2AMLogic/gf180-pll/sim/README.md

# sim/ — evidence record format

**Looking for a headline number rather than the format spec?** See
[`CHARACTERIZATION.md`](CHARACTERIZATION.md) — one aggregated table pulling
each campaign's current result, record citation, and pass/fail-vs-spec
status into a single document (#147).

This directory holds simulation testbenches and their results. Results are
**append-only evidence**: once a record is written, it is never edited or
deleted. A re-run — even one that corrects a mistake — mints a new record
with a new ID; a correction references the record it supersedes rather than
overwriting it in place.

This convention exists because CLAUDE.md commits this repo to two rules that
need a concrete schema to be enforceable:

- **Verification is the product.** No claim without a testbench. Every
  recorded result carries the full PVT corner matrix (−40/27/125 °C, 3.3 V
  ±10 %, process corners) unless the record explicitly states why a subset
  was used.
- **`sim/` is append-only evidence.** Re-runs get new records; records are
  never edited or deleted.

## Provenance of this convention

This format is **copied and adapted** from the sister repo
`2AMLogic/gf180-bandgap`, per CLAUDE.md's harness-bootstrap rule (copy the
sister-repo pattern rather than reinventing). Source:

- **Source file**: `sim/README.md` on `2AMLogic/gf180-bandgap` `main`
- **Source commit**: `67525f67d8152fff7575c7d13ea185db869e2870`
  ("docs: define sim/ evidence record format and append-only convention",
  bandgap #22) — the last commit to touch that file, and the convention
  ratified on bandgap `main` as of 2026-07-30 (bandgap `main` at
  `8fb0ea627569079147c91bff8e3aee658c976e54`).

**Reconciliation note.** Bandgap's harness PR (bandgap #23, branch
`feature/issue-2`) proposes a *machine-readable* evidence scheme —
`sim/results/<tb>/<UTC>-<sha>[-dirty].{json,csv}` — which does not match the
Markdown-record convention ratified in bandgap #22. That PR was **still open
and unmerged** when this file was written, so the ratified Markdown
convention above is what is copied here. If bandgap later supersedes its
convention, this repo follows **via its own `spec/` decision record** — #6 has
since landed `spec/decision-records/TEMPLATE.md`, so the mechanism now exists:
copy it to `spec/decision-records/DR-NNN-<slug>.md`. Never a silent fork. The
two schemes are not actually in conflict for us: a harness (issue #2) may emit
machine-readable `corners/<record-id>/` artifacts *in addition to* the Markdown
summary record, but the Markdown record under `records/` is the citable
evidence object and is mandatory.

Deltas from the bandgap convention are marked **[PLL delta]** below, each
with its justification. Everything unmarked is bandgap's convention verbatim
in substance.

## Directory / naming convention

Each testbench topic gets its own experiment directory:

```
sim/
  <experiment-slug>/                 # e.g. lock-time, devchar-delay
    testbench/                       # testbench netlist(s) / xschem export used
    netlist-snapshots/
      <record-id>.spice              # frozen DUT netlist used for this record
    corners/
      <record-id>/
        <corner-id>.log              # raw ngspice output per PVT point
                                      # e.g. ss_-40c_2.97v.log
        raw_measures.csv             # always written: one row per corner point,
                                      # every tb.measure_names value + verdict
    records/
      <record-id>.md                 # append-only summary record
```

- **`<experiment-slug>`** — short, descriptive, kebab-case name for what is
  being verified. One directory per distinct claim being tested, **not** per
  run. The campaigns already scoped for this block:

  | Slug | Claim under test | Issue |
  |---|---|---|
  | `devchar-delay` | delay-cell drive/delay vs. PVT | #4 → #8 |
  | `devchar-cp` | mirror output resistance / compliance | #4 → #9 |
  | `devchar-passives` | MIM vs. MOS cap, poly-resistor options | #4 → #10 |
  | `divider-ratio` *(pre-`sim/harness`, superseded — see below)* | ÷2/3 cell moduli and speed margin, chain ratio over the whole N = 4–64 range, retiming setup closure | #11 |
  | `divider-ratio-dff` | `dff_tg_3v3` setup/hold/clk→Q — the retiming flop's timing budget input | #11 |
  | `divider-ratio-cell` | ÷2/3 single-cell moduli, both output edges, both input duty cycles, speed margin, 10 MHz band floor | #11 |
  | `divider-ratio-chain` | full-chain ratio over N = 4–64, retiming setup closure (joins `divider-ratio-dff`) | #11 |
  | `lock-detector` | phase-error window comparator: assert/deassert and window edges | #11 |
  | `lock-window-sizing` | `delaywin_3v3` window-sizing ladder — where the comparator window `t_win` lands over the full 13-bundle PVT grid as the four MOS-cap loads are scaled, and which sizing (if any) holds it inside a two-sided band at every corner at once | #387 → DR-010 |
  | `lock-window-proxy` | whether anything the pads expose can execute the [Lock-detector window trim-code rule](../spec/pll.md#lock-detector-window-trim-code-rule) — the free-running ring period at two held (band, Vctrl) points and the `CLK`→`FB` / `CLK`→`DIVOUT` skews, each paired at every grid point with the cell's own sixteen-code window map and scored on whether the code it selects still holds the ratified band | #501 → DR-022 |
  | `vco-tuning-range` | open-loop ring VCO range, Kvco | #8 |
  | `pfd-deadzone` | PFD + charge-pump phase-to-charge transfer through zero phase error (dead-zone freedom), and the residual charge offset at zero | #9 |
  | `cp-compliance` | charge-pump output compliance range, UP/DN current and switching-time mismatch, 2-bit Icp trim range | #9 |
  | `loop-dynamics` | loop bandwidth / phase margin vs. R–C and Kvco spread | #10 |
  | `pll-top-smoke` | does the assembled `design/pll_top.sch` acquire and hold lock at all — the acceptance gate for the top-level wiring, **one nominal corner by design** (see below) | #52 |
  | `lock-time` | closed-loop lock acquisition | #12 |
  | `output-range` | closed-loop output-band coverage | #12 |
  | `period-jitter` | period jitter (deterministic + random), at 150 MHz / band 6 / N = 6 | #13 minted the six committed records (deterministic half, 45/45); the random half is **bounded, not estimated**, at all 45 points and full scope — ≤ 0.338 % RMS (DR-032, the VCO's own generators and the loop-filter resistor) plus ≤ 0.0249 % RMS (DR-033, the charge pump, PFD, divider and lock detector DR-032 does not inject), ≤ 0.3388 % RMS combined against the 0.50 % allocation; the disposition that no analysis here *estimates* it is DR-020's, narrowed by DR-023, and the ISF route's three ingredients are built and validated by DR-030 and DR-031 but not assembled. Five sub-directories here are **method directories, not campaigns**, and none has a `records/`: `noise-toolchain-probe/` (what ngspice can and cannot do, DR-023), `isf-bringup/` (the impulse-sensitivity-function extraction, DR-030), `sid-trajectory/` (the generator PSDs and the trajectory, DR-031), `random-bound/` (the 45-point VCO-side upper bound, DR-032 — committed results, several decks per point with a reduction between them, so it runs outside `sim/harness`) and `in-band-bound/` (the 45-point in-band upper bound, DR-033, the same shape) |
  | `period-jitter-band-top` | the same deterministic period jitter at the **200 MHz top of the ratified band** — N = 8, and the VCO band code per corner because `spec/pll.md`'s band-selection rule splits this grid across bands 6 and 7 | **#503** (the campaign run); declared by #13, which is closed |
  | `reference-input-contract` | the `REF` electrical contract itself — levels, 10–90 % edge rate and duty cycle driven to each boundary `spec/pll.md` states, graded as the per-corner shift of the PFD's reference-path set delay. **Declared, not measured**: manifest, deck and reduction are committed and self-checking, zero of 288 declared points have run | #499 → DR-019 |
  | `reference-phase-transfer` | the closed-loop REF-to-output **phase transfer** — a single known reference phase step, read out through the loop's own REF-vs-FB static phase error **differentially against a paired control run**, compared against `spec/pll.md`'s `20·log₁₀(N)` reference-source-quality exclusion. A different question from `reference-input-contract` above (waveform *shape* at a fixed phase, not phase *in time*), and the first deck in this tree to displace the reference edge in time at all. **Measured at N = 6**, 5/5 corners PASS: 15.529 … 16.366 dB against the stated 15.563 dB, plus the roll-off above the loop bandwidth at one frequency. The campaign holds three records and its supersession chain is the method's own history — see "Two decks per point, one record" below | #509 → DR-027 |
  | `supply-sensitivity` | supply pushing, quiescent/dynamic power | #14 |
  | `mc-cp-mismatch` | charge-pump mismatch distribution, Monte Carlo combined with a **21-point corner axis** — nominal plus all 20 vertices of the process × temperature × supply box, so every MOS bundle appears at both temperature and both supply extremes (#597 widened this from a 3-point diagonal subset; `fs`/`sf` are visited from that record on) | #15, #146, #482, #597 |
  | `reference-spur` | closed-loop reference spur measured directly, as the ±f_ref sidebands of the locked output spectrum, at 150 MHz / band 6 / N = 6 | #145 minted the one committed record (5 of the 45 PVT points); the binding-frequency grid is the row below |
  | `reference-spur-band-top` | the same sidebands at the **200 MHz binding top of the ratified band**, where `spec/pll.md`'s −55 dBc line is stated — N = 8, and the VCO band code per corner because the band-selection rule splits this grid across bands 6 and 7. **Declared, not measured**: manifest, deck, per-corner operating-point derivation and reduction are committed and self-checking, zero of 45 declared points have run | **#533** (the campaign run) → DR-024 |
  | `output-driver` | loaded buffered-output duty cycle, levels and drive-strength (edge rate) at the two extremes of the ratified band/Vctrl window | #144 |

  **`supply-sensitivity`'s HIGH-plateau `not-locked` verdict, disambiguated
  (#384).** The criterion-3 high-plateau escalation (#253) classified all 3
  sampled step/ramp corners `not-locked` at the escalated 40.08 us hold in
  `20260901-155456-46b92f8` -- `ferr_hi` (a frequency-drift proxy) converges
  but `lock_hi` does not, at every corner. `20260915-105055-2d6ab99` rules out
  a measurement-window artefact (the retained full-hold LOCK trace stays near
  zero for the entire plateau, not only the averaging window `lock_hi` uses)
  and finds the remaining mechanism differs BY CORNER: `ff`/125 C/3.63 V does
  not assert `lock` even in its own undisturbed steady state at the same
  rail (static phase 1.796 ns, already past `sim/lock-detector`'s measured
  window and `spec/pll.md`'s ratified 1 ns Lock criterion) -- a structural
  mismatch, and new evidence for `spec/pll.md`'s already-documented Lock
  detector T1/T2 gap (row 16, unratified per DR-007 Amendment A1), not a new
  question. `ss`/-40 C and `typical`/27 C DO assert `lock` fine at the same
  undisturbed rail, so their post-step failure is a phase-settling tail
  slower than `ferr_hi`'s drift-rate proxy shows -- new evidence for
  `sim/loop-dynamics` (#10), generalizing the same record's section 3c
  `under-damped` END-plateau finding (previously `ss`/-40 C only) to the HIGH
  plateau and to `typical`/27 C. Both findings are carried forward as design
  issue #387; #384 itself is disambiguation-only.

  **`vco-tuning-range`'s band-select mirror mismatch finding at band 0,
  closed (#482).** The band-select mirror Monte Carlo campaign's first
  record, `sim/vco-tuning-range/records/20260817-143524-0e9cfc9.md`, gave
  band 0 a mid-window (`typical`/27 °C/3.30 V, Vctrl = 1.8 V) dispersion of
  38.8 % of mean against band 7's 26.8 % worst-adjacent-overlap headroom — a
  different corner and a different band pair, so that comparison was an
  order-of-magnitude proxy only, not a matching-corner combined verdict, and
  the record said so itself. `sim/vco-tuning-range/records/20260923-084925-1655e11.md`
  (`cc6531ef6b75`) closes that gap: at band 0's own worst corner and Vctrl —
  `ss`/125 °C/3.63 V, Vctrl = 2.7 V, the exact point the B0→B1 overlap ratio
  (1.319, 31.88 % headroom) is taken at — band 0's random mismatch dispersion
  is 24.79 % of mean, **under** that headroom at N = 100. The earlier record
  and its 38.8 % figure are unmodified, append-only evidence at their own
  (different) point; they are not superseded, and the new record does not
  re-measure band 7.

  **…and the proxy that check rested on is now retired, by a JOINT two-band
  draw (#597).** Both records above measure ONE band per ngspice invocation,
  so both had to compare a band's `|mean|+3σ` *as a percentage of its mean*
  against a fractional overlap margin — which each record flagged in its own
  text as "an order-of-magnitude sanity flag, not a rigorous directional
  bound", because with one band drawn the inequality the coverage-hole check
  actually asks about (`f_max(band 0) ≥ f_min(band 1)` **on one die**) cannot
  be written down under mismatch at all.
  `sim/vco-tuning-range/records/20260927-081930-d004d5b.md` writes it down.
  Its new deck `testbench/tb_vco_band_pair.sp` runs both band codes as two
  `tran` analyses inside ONE `.control` block, which means one netlist parse
  and therefore — since the gf180mcu `agauss()` draws are evaluated at parse
  time — **one mismatch draw shared by both bands**. The overlap ratio is then
  a per-draw sample, and the criterion is its own one-sided 3σ tail:
  **1.28193 against the 1.0 floor at N = 200, PASS**, keeping 88.4 % of the
  1.31882 systematic margin. The same samples under the old independent-draw
  treatment (each band pushed to its own opposite tail) would read 0.79910, a
  FAIL — and the reason is measured, not argued: the two bands' frequencies
  are correlated at **ρ = 0.9958** across draws, because bands 0 and 1 differ
  by one switched leg of `design/vco_bias.sch`'s cascade and share every
  always-on leg, the V→I converter and all five ring stages. Nearly all of
  each band's 24–26 % dispersion is common mode and cancels in the ratio.
  Neither earlier record is superseded; this one is additive, and it is the
  first in this repo to draw two band codes from one draw. Still owed: the
  other six adjacent pairs (the worst-of-all-pairs ratio, 1.268, is B3→B4 and
  is unmeasured under mismatch), and this campaign's Monte Carlo corner axis
  is still one point wide by design — the binding corner is already known from
  the systematic sweep.

  New campaigns add rows here as they are created; the list is descriptive,
  not a closed set.

  **A one-directory experiment can outgrow one `sim/harness` manifest.**
  `divider-ratio` originally held three sub-testbenches (`dff_tg_3v3`
  setup/hold, the single `div23_cell`, and the assembled `divider_chain`)
  sharing one `sim/lib/simenv.sh`-based `run.sh` and one experiment directory
  — but `sim/harness` ties one `tb.json` manifest to exactly one
  `testbench/`-plus-`records/`/`corners/`/`netlist-snapshots/` experiment
  directory (`sim/harness/testbench.py`'s `experiment_dir` is
  `directory.parent`), because each sub-testbench is a genuinely different
  DUT with its own sweep needs (the chain alone sweeps N = 4–64 non
  -rectangularly; the cell sweeps only an input rate; the flop sweeps
  neither). #41 migrated the campaign onto the harness by splitting it into
  three sibling slugs — `divider-ratio-dff`, `divider-ratio-cell`,
  `divider-ratio-chain` — one per DUT, following the same one-directory-per
  -distinct-DUT precedent `devchar-delay`/`devchar-cp`/`devchar-passives`
  already set for this repo. The original `divider-ratio` directory's
  `records/`/`corners/`/`netlist-snapshots/` are untouched (append-only); its
  `testbench/` (mutable) keeps the pre-harness `run.sh` and fragments as-is,
  for provenance. `divider-ratio-chain`'s retiming-margin table is a
  `sim/harness` **derived** cross-record join (`derived.joins`) against
  `divider-ratio-dff`'s own derived `dff_setup_hold` table — the harness
  -native replacement for the two directories' shared `${EXP}/corners/` the
  pre-harness `run.sh` relied on.

  **Two manifests, one experiment directory — the other resolution.**
  Splitting into sibling slugs is right when the sub-testbenches are different
  *DUTs*. When they are the same DUT measured two ways, the campaign stays one
  directory and grows a second manifest directory beside `testbench/`:
  `sim/run_corners.py` accepts a manifest **directory path** as well as a slug,
  and `experiment_dir` is still `directory.parent`, so both write their
  records/corners/snapshots into the same experiment directory and supersede
  that campaign's chain in place. `vco-tuning-range` set the precedent with
  `testbench-stages/` (#88); `cp-compliance` follows it with
  `testbench-switching/` (#42) — one `cp`, measured once as a DC output
  characteristic over the trim codes and once as a transient over the control
  voltages. The split is forced by the harness's shape, not chosen: one
  `tb.json` names one netlist fragment and one `analyses` list, and folding
  both benches into one deck would drag the DC bench's instances through every
  transient. Each such manifest mints its own record, so a campaign split this
  way has more than one current record — each stating in its **Claim** which
  half of the claim it answers and naming its companion.

  **The same shape, forced by an OPERATING POINT rather than an analysis type
  (#394).** `pfd-deadzone` grows `testbench-operating-point/` for a third
  variant of the same reason. The DUT, the stimulus and the reduction are the
  parent manifest's exactly; what differs is where on the operating surface the
  measurement is taken — `period` = 80 ns instead of 40 ns, and `vctrl` swept
  across DR-001 Decision 2's ratified window instead of pinned at its middle.
  A `tb.json` fixes `analyses` and `params` for the whole run, so "the same
  measurement at a second operating point" is a second manifest for the same
  structural reason "the same DUT under a second analysis" is. It is worth
  naming as its own case because the *motivation* differs and generalizes: a
  number this repo's spec cites as a worst-case term is only a worst case at
  the operating point it was measured at, and when another campaign runs the
  same block somewhere else on that surface, the two numbers are not
  comparable until one of them is re-measured where the other lives. Reaching
  for a sibling slug there would split one claim across two directories; the
  second manifest keeps the comparison inside one.

- **`<record-id>`** — unique and traceable:
  `<YYYYMMDD>-<HHMMSS>-<short-git-sha>` (e.g. `20260730-142500-3f1c9ab`),
  date and time in **UTC**, sha being this repo's `HEAD` when the run
  started. Re-runs simply mint a new `<record-id>`; nothing under `records/`
  is ever edited in place. The same `<record-id>` ties together the netlist
  snapshot, the raw per-corner logs, and the summary record for one run. If
  the tree was dirty at run time, the ID is unchanged but the record's
  **Environment provenance** field must say so (see below) — a dirty-tree
  record is not reproducible from the sha alone.

- **`<corner-id>`** — `<corner-bundle>_<temp>c_<supply>v.log`, e.g.
  `ss_-40c_2.97v.log`, `tt_27c_3.30v.log`, `ff_125c_3.63v.log`. Supply is
  always written to two decimals — **[PLL delta]**, a small tightening rather
  than bandgap verbatim: bandgap's naming line shows a one-decimal
  `tt_27c_3.3v.log` while its own worked example writes `3.30v`. Fixing the
  width at two decimals removes that inconsistency and keeps corner filenames
  sorting lexically in supply order.

  **[PLL delta]** — the corner field itself: bandgap's is a bare
  MOS process corner; here it is a *bundle name*, because gf180mcu has no
  single global corner switch — each device family carries its own `.lib`
  section in `sm141064.ngspice` (MOS `tt/ff/ss/fs/sf`, plus the independent
  `res_*`, `mimcap_*`, `moscap_*`, `bjt_*`, `diode_*` axes). A bundle name
  is lowercase alphanumeric with `-` only (**never `_`**, which stays the
  unambiguous field separator): `tt`, `ss`, `ff`, `fs`, `sf`,
  `ss-resss-mimss`, `all-slow`. Every bundle name used in a run **must** be
  expanded into its exact `.lib` section list in the record's corner-matrix
  field — the filename is a handle, the record is the definition.

  **Campaigns that sweep beyond the PVT grid.** Some campaigns sweep an
  independent variable *in addition to* process/temperature/supply — a phase
  offset, a trim code, a control voltage — so one PVT point produces several
  logs and `<corner-bundle>_<temp>c_<supply>v` is no longer unique. Such a
  campaign appends the extra variable as a further `_`-separated field, and may
  prepend a measurement-kind field when it runs more than one analysis over the
  same grid:

  ```
  [<kind>_]<corner-bundle>_<temp>c_<supply>v[_<extra>][_<extra>…].log

  ss_125c_3.30v_dphi200p.log      pfd-deadzone: phase offset (dphi) swept
  dc_ff_-40c_2.97v_code00.log     cp-compliance: DC analysis, Icp trim code
  sw_tt_27c_3.30v_vctrl1.65.log   cp-compliance: switching analysis, Vctrl
  ```

  An extra field is `<name><value>` with no separator between them, so the `_`
  boundary stays unambiguous; the value is written exactly as the deck spells
  it (SPICE suffixes included, `-` for negative). Every swept variable **must**
  be named, with its points, in the record's corner-matrix field, on the same
  terms as the PVT axes — the filename is still only a handle. The three fixed
  fields keep their meaning and position, so a campaign that sweeps nothing
  extra is unaffected: this documents a convention already in use, it does not
  change the schema.

  **Campaigns minted from more than one deck.** The `[<kind>_]` prefix above is
  also what a record built from several *stimulus decks* uses. Some claims are
  a **pair**: `vco-tuning-range`'s supply campaign runs a static
  supply-pushing deck and a transient supply-jitter deck and reduces them
  together, because the jitter numbers are not interpretable without the
  pushing numbers. That is one record, not two — splitting it would land
  evidence weaker than the record it supersedes, which the append-only rule
  does not permit. Each deck's logs take its name as the prefix field:

  ```
  push_ss_125c_3.63v.log          vco-tuning-range: static supply pushing
  jit_ss_125c_3.63v.log           vco-tuning-range: supply step + ripple
  ```

  A deck name obeys the same spelling rule as a corner bundle — lowercase
  alphanumeric with `-`, **never `_`**. The record must name **every** deck it
  was minted from, with that deck's own SHA-256, in its Netlist-provenance
  field, and its netlist snapshot holds all of them composed; a reader must
  never have to guess which stimulus produced which half of a result. The
  harness expresses this as `tb.json`'s `phases` key (see
  `sim/harness/README.md`).

  **Two decks per point, one record — the CONTROL-RUN case (#509).**
  `reference-phase-transfer` uses the same key for a differently-shaped reason,
  worth naming because it generalizes to any campaign measuring a *perturbation*
  rather than a level. Its two phases are **the same netlist file** at two
  values of one parameter: `ctl` applies no reference phase step, `stp` applies
  the known one. They are paired so the quantity reported is the *difference* of
  their readings at the same instant, which cancels whatever the two share.
  Here that matters because the loop's own static phase error is still winding
  slowly at the release point, by up to 1.4 ns across the measurement window
  against a 1 ns injected step — so differencing the stepped run against *its
  own past* (which is what this campaign's first record,
  `20260925-073001-ed38ff1`, did) measures the step and the drift added
  together, with nothing to separate them. Differencing it against a control
  run that drifts identically removes the drift instead of bounding it.

  Two conventions follow for a campaign built this way, and both are in
  `reference-phase-transfer`'s manifest:

  - **Publish what the pairing cancelled.** The control run's own drift is a
    reported measurement (`drift_ctl`), not a discarded intermediate, so a
    reader can see that it was up to 15× the residual being reported.
  - **Check that the pair is a pair, at a tolerance that is not physical.**
    Read the differenced quantity at an instant *before* the perturbation,
    where the two decks are the same run, and check it against zero
    (`pair_resid`). That check is the validity of the whole measurement, and it
    doubles as the measurement's own noise floor — which is the honest thing to
    quote a residual against. It will not be exactly zero: ngspice takes a
    breakpoint at every source discontinuity, so two decks whose stimulus
    sources transition at different times do not take bit-identical internal
    timesteps even where their node voltages agree.

- **`testbench/`** is not versioned per record — it holds the current
  testbench netlist(s)/xschem export(s) used to generate records. If the
  testbench itself changes in a way that could affect comparability across
  records, note that in the new record's summary (e.g. under Claim,
  Methodology, or a free-text note).

## Default corner matrix

Unless a record states otherwise, every result is swept over the full grid:

| Axis | Points |
|---|---|
| Temperature | −40 °C, 27 °C, 125 °C |
| Supply | 2.97 V, 3.30 V, 3.63 V (3.3 V ±10 %) |
| Process | MOS bundles `tt`, `ff`, `ss`, `fs`, `sf` |

That is 45 points for a MOS-only sweep. **Passive corner axes are
independent of the MOS process corners** (`res_typical/res_ff/res_ss`,
`mimcap_typical/mimcap_ff/mimcap_ss`,
`moscap_typical/moscap_ff/moscap_ss`): a sweep over MOS corners alone
silently leaves every passive at typical. That is a legitimate choice for
some claims and a fatal omission for others — the loop filter's bandwidth
and phase margin ride on the R and C skews, not the MOS skew — so **a record
that sweeps only MOS corners must say so explicitly** in its corner-matrix
field, and a loop-dynamics or loop-filter claim that does so must justify it
in its Methodology field. **[PLL delta]** bandgap notes the same hazard for
its resistor/BJT axes; this repo names the specific passive sections the loop
filter depends on.

Any subset of the default grid — fewer temperatures, one supply, MOS-only
process, a single nominal point for a Monte Carlo distribution claim — is
allowed **only** with an in-record justification. "The sim was slow" is not a
justification; "mismatch distribution is evaluated at nominal PVT, corner
sensitivity covered separately by record X" is.

**A *superset* of the default grid must be declared just as loudly as a
subset.** `all-slow` and `all-fast` — the combined bundles that skew every
device family together, passives included — are not among the five MOS
bundles above, so a campaign that sweeps all seven runs a **63-point** grid,
not a 45-point one. Its worst case is then a worst case over a wider corner
universe, and it routinely *binds at a corner the default grid does not
contain*: `vco-tuning-range`'s output-band floor, ceiling, worst Kvco and
worst ripple-induced jitter all land on `all-fast` or `all-slow`. Reporting
such a number beside a 45-point one without saying which grid it came from
makes two different claims look like one, which is what happened in section 5
of `docs/chipalooza/challenge-5-proposal.md` until 2026-09-25.
**`sim/lib/check-pvt-coverage-claims.sh` fails CI** if a reader-facing
document quotes a corner outside the default grid without naming the grid it
was measured on, quotes a bundle `sim/harness/corners.py` does not define, or
states a PVT corner count that neither matches the default grid size nor any
count the cited record's committed per-corner evidence produces. The default
grid's size is computed from the harness, never written into the check.

**The obligation is on the row's *evidence*, not on the corner it happens to
quote.** A row that rests on an off-grid campaign has to name that campaign's
grid even when every corner it chose to quote is on the default one — which
is the ordinary case, because a campaign's worst case does not have to land
on the bundles the campaign added. `sim/lock-detector` runs 13 bundles
(117 PVT points) and both of its window edges bind at `fs` and `ss`; the
proposal's Lock detector row therefore quoted nothing off-grid and disclosed
nothing, for five days. `sim/CHARACTERIZATION.md`'s `harness-selftest` row
went further and called its record's grid "45-point" when that record's own
corner field reads "63 point full-factorial grid". Naming the grid is cheap
and it is also where the useful sentence lives: for `vco-tuning-range` the
superset changes the answer (four worst cases move off the default grid),
while for `sim/lock-detector` it demonstrably does not (the eight added
bundles re-skew only the passive sections, and every one of their points
reproduces its MOS twin to the digit). Both facts are worth a reader's time;
neither is visible from a number alone.

**A worked example of an acceptable one-point justification** — `pll-top-smoke`
(#52), the only single-corner campaign in the table above. The question it
answers is a *connectivity and closed-loop-existence* question about a newly
assembled top level ("is the loop wired such that it acquires and holds
lock?"), not a performance question. A performance number needs the grid;
"does the assembly close the loop" is answered, or not answered, at any single
corner, and answering it at 45 costs 45× the wall clock for no additional
information about the wiring. Every *performance* claim over the same DUT is
explicitly deferred to `lock-time` / `output-range` (#12), `period-jitter`
(#13) and `supply-sensitivity` (#14), each of which carries the full grid.
The record says all of that in its own Corner-matrix field, and says in as many
words that it must not be cited for a PVT claim — which is what makes it a
justification rather than an excuse.

## Closed-loop campaigns: one assembly path

A campaign that simulates the whole PLL does **not** hand-transcribe a loop
into its testbench: it calls a shared helper in `sim/lib/`. There is now
**exactly one such helper**, used by every closed-loop campaign:

| Helper | What it builds | Used by |
|---|---|---|
| `sim/lib/pll_top_dut.sh` (#52) | prepends `design/netlist/pll_top.spice` — the committed export of `design/pll_top.sch` — to the campaign's stimulus fragment, and owns the encoding of the block's static configuration inputs, so a campaign asks for `N = 8` rather than setting twelve bits by hand (a mis-encoded one-hot `SEL` code still locks, just at the wrong N). | `pll-top-smoke` (#52), `supply-sensitivity` (#14), `lock-time`, `output-range` (#12, since #159) |

Because the loop is wired exactly once, in `design/pll_top.sch`, every
campaign simulates the same connectivity and a change to the loop shows up as
a schematic diff — every campaign has to reckon with it, none can silently
diverge from the others.

**There used to be a second helper**, `sim/lib/assemble_closed_loop.sh` (#12):
it concatenated the committed block exports (`vco`, `divider_chain`,
`lock_detector`, `loop_filter`) with a fresh `pfd_cp` export, de-duplicating
the leaf cells two of them inline, rather than reading
`design/netlist/pll_top.spice` — each testbench on that path wired the loop's
top-level connectivity itself, so two campaigns could disagree about the loop
without anything reporting the divergence. `lock-time` and `output-range`
built their DUT this way until #159, which re-took both campaigns' full PVT
grids against `pll_top_dut.sh`'s DUT
(`sim/lock-time/records/20260831-052456-effc505.md`,
`sim/output-range/records/20260819-160843-4e32f91.md`) and then deleted
`assemble_closed_loop.sh` — it produced no evidence any current record needs
in order to be read.

**`sim/` records are append-only**, so every `lock-time` / `output-range`
record committed before #159's migration still names
`assemble_closed_loop.sh` in its own **Netlist provenance** field as what
produced its frozen snapshot, and those records are neither edited nor
reinterpreted by the helper's removal — they simply describe a DUT assembly
that is no longer live. Read a record's own **Netlist provenance** field to
know which DUT its numbers came from; do not assume the tree's current helper
produced an older record.

*Naming note.* #52 originally called its helper `assemble_closed_loop.sh` as
well; it was renamed to `pll_top_dut.sh` when both landed in the same tree, to
avoid colliding with the differently-shaped #12 helper described above. Frozen
netlist snapshots and testbench comments minted before that rename still name
the pre-rename path; the records that carry them disclose it.

## Closed-loop internal-timestep bound

**Every campaign whose DUT contains the PFD inherits a ceiling of 100 ps on the
ngspice *internal* transient timestep.** This is a property of the PFD, not of
any one testbench, and it is not a convergence-tuning preference — violating it
produces a *false negative* (a confident, plausible-looking "the loop does not
lock") rather than visible noise.

`design/edgedet.sch` fires each of the PFD's two SR latches from
`AND(X, NOT(X delayed by 5 inverters))`. That set pulse measures **0.33-0.39 ns**.
The UP/DN pulse it eventually produces is 1.1-1.9 ns wide (the 24-inverter reset
chain), and sizing the ceiling from *that* number — the obvious reading, since
UP/DN carry the loop gain — is the trap. When the integrator's mean internal
step approaches the set-pulse width, ngspice steps clean over the set pulse on a
large fraction of feedback edges; each miss is a feedback edge the PFD never
sees, so the loop reads as **jammed with UP asserted, ramping Vctrl to the rail
while the feedback is ALREADY faster than the reference**. 100 ps puts 3-4
internal steps inside the set pulse.

First measured and documented by `sim/pll-top-smoke` (#52) — see
`sim/pll-top-smoke/records/20260801-085349-0e5c22d.md`, which also shows a
500 ps ceiling missing 9 of 16 feedback edges.

### How to comply

Pass the ceiling as **`.tran`'s 4th argument**, from the single shared constant:

```
.tran {tstep} {tstop} 0 {tmax}      # tmax <- SIMENV_CLOSED_LOOP_TMAX
```

`sim/lib/simenv.sh`'s own bash regression tests (`sim/lib/test_simenv_*.sh`) are run by the CI `checks` job.

`sim/lib/simenv.sh` defines `SIMENV_CLOSED_LOOP_TMAX`; campaign runners pass it
through as a `.param`. **Omitting the 4th argument is the violation.** A deck
with no `Tmax` does not run unbounded — it runs at a ceiling ngspice picks for
it, `min(Tstep, (Tstop − Tstart)/50)`, which in practice is the *print* step,
and campaigns routinely size the print step from an output-waveform quantity
such as `1/(50*f_out)`. That ties integration accuracy to a number with nothing
to do with the PFD.

Verified against ngspice-46 on this host: an RC deck with `.tran 1n 1u`
integrates in ~1 ns steps (`Tstep` binds), while the same deck with
`.tran 100n 1u` integrates in ~14.5 ns steps — `(Tstop − Tstart)/50 = 20 ns`
binds, not the 100 ns `Tstep`. So **check the derived ceiling, not the presence
of a `Tmax` keyword**: "there is no `Tmax` in this deck" is not the same
statement as "there is no bound to check", and the second is what matters.

Because the ceiling changes the answer and not merely its precision, it is part
of a run's identity: `lock-time` and `output-range` both carry it in their work
directory tag so a pre-bound log is never silently reused for a post-bound
record.

### The standing guard: does the DN branch assert at all?

The bound is a rule, and a rule that is only written down gets violated again.
What makes a violation *self-detecting* is that the closed-loop campaigns
measure `dn_lvl` — the mean PFD DN level over the late window — and score it
against a floor of `3e-4` of the rail. In a loop that is tracking, both PFD
branches pulse once per reference cycle for the reset-delay overlap, so a DN
branch that never asserts **at all** is proof the integration failed, not the
design. It is deliberately far below the overlap's own expected duty: it is not
a measurement of the overlap, it is a liveness check on the detector.

`sim/pll-top-smoke` (#52) carries it as its check 7, scored PASS/FAIL, which is
sufficient there because that campaign expects lock on every row. `lock-time`
and `output-range` (#12) have rows that can legitimately end the window still
converging, so they score the same quantity **three-valued**:

| `dn_lvl` vs floor | Row's own lock status | Verdict | Reading |
|---|---|---|---|
| above | any | `PASS` | detector resolved — the row's status means what it says |
| below | PASS | `FAIL` | an apparent lock with an unresolved detector |
| below | not PASS | `SUSPECT` | the FAIL cannot be attributed to the design *or* the window, because the detector was not resolved either — the attribution is **withheld** |
| did not measure | any | `ERROR` | no verdict; never coerced to zero |

`SUSPECT` is the load-bearing value. Suppressing the guard on non-PASS rows
(reporting `N/A`) is the obvious-looking alternative and it is wrong: it
discards the discriminating measurement on exactly the rows where "is this FAIL
real?" is the open question.

Measured against a real violation, before #75 brought `output-range` onto the
bound: at that campaign's `lo` edge — 10 MHz output, so a `1/(50*f_out)` =
2.0 ns implicit ceiling, ~6x the set pulse — `dn_lvl` read **6.6e-7 V against a
9.9e-4 V floor** at typical/27 C/3.30 V. Three orders of magnitude under: the
DN branch was not asserting at all, while nothing in that campaign's verdict
table looked unusual. For contrast, `pll-top-smoke`'s committed locked run
reads 5.25e-2 V on the same measurement. Now that both campaigns take the
ceiling from `SIMENV_CLOSED_LOOP_TMAX`, every row is expected to read `PASS`
and any other verdict means the bound has been violated again.

### Records taken before this bound was applied

`sim/lock-time` and `sim/output-range` (#12) both omitted the 4th argument until
#65. Their pre-#65 records remain committed and unedited, per the append-only
rule, but their lock/no-lock verdicts and any `vctrl_final` rail excursion
should be read as **not yet reconciled against this bound** — see
`sim/lock-time/records/20260801-101734-5eb00db.md` for the measured internal-step
distributions and which specific claims are affected. A record that predates the
bound is not retracted by this section; it is qualified by it.

`sim/supply-sensitivity`'s 9-corner record `20260801-024935-c4fe724` (#62) was
taken at `KTMAX=400p` — above the bound — until #69. Unlike the pair above,
that record's re-examination (`20260801-114140-f87afc5`, #69) reached a
per-row verdict rather than a blanket "not yet reconciled": 5 of its 9 rows
carry the artefact's signature and must not be cited as design results, and 4
do not and stand. See that record for which rows are which and why the
asymmetry (false negatives only, never false positives) lets four rows survive
without a re-run.

## Summary record format

Each run produces one `records/<record-id>.md` file with the following
fields. Fields are mandatory unless marked optional; a field that does not
apply is written as `N/A` **with a reason**, not omitted.

- **Record ID** — the `<record-id>` for this run (matches the filename and
  the corresponding `netlist-snapshots/` / `corners/` subdirectory).

- **Claim** — what this record substantiates. Two accepted forms
  (**[PLL delta]** — bandgap admits only the first):
  1. a **spec claim** — the ratified spec parameter/line, referenced as
     `spec/<file>.md#<anchor>` (placeholder anchors until #1 ratifies a
     spec, as bandgap prescribes); or
  2. a **design-input claim** — a design question this record answers rather
     than a spec line it passes/fails, referenced by issue number and stated
     as a question (e.g. "#4 → #10: which loop-filter cap type meets the
     area budget with acceptable C–V linearity?"). Device-characterization
     records (#4) substantiate *sizing decisions* for #8/#9/#10; forcing
     them to name a spec line would either misattribute them or block them
     on #1.

  A claim of either form is still a claim: it needs the testbench, the
  corners, and the provenance.

- **Netlist provenance** — `schematic` (`design/...`) or `extracted`
  (post-layout, `layout/...`), with the path, plus the SHA-256 of the frozen
  `netlist-snapshots/<record-id>.spice`. Required so post-layout re-runs are
  distinguishable from the original schematic-level record (#18). A record
  minted from **more than one stimulus deck** (see "Campaigns minted from more
  than one deck" above) names every deck, each with its own SHA-256, plus the
  composed SHA-256 the snapshot holds.

- **Environment provenance** — **[PLL delta]**, absorbed from #4: the
  environment must be reconstructable from the record alone.
  - PDK variant + pinned hash (e.g. `gf180mcuD`, open_pdks
    `f6eeac7dad085ffcc829ccfd721f7b4ce39edcf7`). The pin lives once, in `sim/pdk.json`;
    the harness and `sim/lib/simenv.sh` refuse a PDK tree whose `SOURCES`
    revision differs from it, so a record's hash is the pin, not whatever
    happened to be installed.
  - model library file used (e.g. `sm141064.ngspice`)
  - simulator version (e.g. `ngspice 46`), and schematic-capture version if
    the netlist came from a schematic export (e.g. `xschem 3.4.7`)
  - this repo's git commit, **and whether the tree was dirty**
  - host OS/arch, if the result is at all sensitive to it (long transients
    and RNG-seeded analyses are — see "Statistical convention" above for the
    host-scoped seed-reproducibility claim this field documents)
  - **where the points actually ran**, when that is not the host that minted
    the record. The `host:` line (klt's env-provenance block) names the *recording* host, which is the
    executing host only while every point runs locally. A campaign dispatched
    off-host (`sim/run_corners.py --backend batch`, see
    `sim/harness/README.md`) must additionally name the execution backend and
    the set of hosts that ran the points, with the per-host point counts —
    and must disclose any point the backend could not attribute rather than
    crediting it to the recording host. A record that claims one host for a
    run that used forty-five is not reconstructable, which is the whole
    purpose of this field. It must also name the **executing simulator
    version** whenever that differs from the `Simulator:` bullet's, which
    under an off-host backend reports the version resolved on the
    *submitting* host — a host that ran no deck at all. The batch job image's
    version is **not** this repository's pin; see "ngspice binary pin (#259)"
    below and DR-028.

  A record naming corner sections without naming the model library and PDK
  hash that define them is not traceable — model sections are only
  meaningful against a pinned PDK.

  Provenance is **not** a place for operator infrastructure identifiers. An
  object-store bucket, an account id, a credential profile, or an absolute
  path on the submitting host are all configuration on the operator's side,
  not facts about the measurement, and `sim/` records are committed in a
  repository prepared to be public. Name the region and the executing hosts;
  withhold the rest.

- **Corner matrix run** — explicit list of (corner bundle, temperature,
  supply) points actually executed, **with each bundle name expanded into
  its exact `.lib` sections**, and an explicit statement of which axes were
  *not* swept (see "Default corner matrix"). Must be the full default grid
  unless the record states why a subset was used.

  **Non-MOS corner axis and non-rectangular sample.** Two shapes of this
  field are common enough, and load-bearing enough for a reader-facing
  document quoting one, that `sim/lib/check-pvt-coverage-claims.sh` grades a
  document's restatement of them against the record itself (issue #516)
  rather than trusting the document's own arithmetic:

  - **A record whose corner axis is not the MOS grid at all** — its DUT has
    no MOS device (`sim/loop-dynamics`' passive loop filter is the case on
    this tree today). Pair the `**Axes not swept**: MOS ... N/A` statement
    this field already requires with a leading declaration sentence in the
    same shape the mandated grid uses: `` `<N>` `<label>` points (`<M>`
    `<label>` bundles x `<T>` temperatures) ``, e.g. "81 filter-impedance
    points (27 passive-corner bundles x 3 temperatures)". A document citing
    this record may restate that sentence in full, or echo a bare
    `` `<N>`-point `` / `` `<M>` bundle `` token from it — both are checked
    against these numbers, not asserted independently.
  - **A deliberately non-rectangular sample of a larger cross-product** —
    the record runs some points of a full-factorial product of its own axes
    and not others, on purpose (`sim/divider-ratio-chain` runs 235 of a
    61-N x 45-corner-equivalent 2835-cell product; `sim/harness/README.md`'s
    "Sweeping beyond the PVT grid" `grid` key is what produces this shape).
    State it as `` **Deliberately non-rectangular**: `<N>` points run of the
    `<M>` `` a full cross-product of the axes above would be, followed by the
    slices actually covered and why. A document citing this record may
    restate `` `<N>` of `<M>` cells `` or `` `<N>` of its `<M>` `` — checked
    against this sentence's own numbers — and any `` `<K>` distinct `<axis>`
    `` claim about the sampled axis is checked against the distinct values
    the record's own committed `corners/<record-id>/` file names carry for
    it (e.g. the divide ratio N encoded in each file's
    `..._f<rate>n<N>.log` suffix), not against the record's prose.

  Neither shape is a new record field: both are the "Corner matrix run" field
  this bullet already requires, stated in a form specific enough for a check
  to read back. A record that predates this note and lacks the leading
  declaration sentence is not retroactively wrong — `sim/` is append-only —
  but a document that then cites it for one of these two claims has nothing
  to be checked against and should say so rather than assert a number the
  record's own text does not carry.

- **Methodology / criteria / limitations** — **[PLL delta]**, absorbed from
  #12 and #13. The measurement criterion stated alongside the number, and
  the honest limits of the method:
  - the **measurement criterion** that turns a waveform into the reported
    scalar — e.g. the lock criterion for #12 (frequency and phase settling
    bands, the window they must hold for, cold-start vs. re-lock, the
    frequency step applied), or the measurement topology for #4 (N-stage
    test ring vs. single-stage step response)
  - simulator settings that materially affect the number (timestep/`reltol`,
    transient length, seeds, `.measure` expressions)
  - **known methodology gaps, recorded instead of papered over.** If the
    flow cannot credibly produce a number, the record says so and reports no
    number — e.g. ngspice transient-noise limits for closed-loop random
    jitter (#13). An honest gap here is a valid record; an unsupported
    number is not, and "no claim without a testbench" includes "no number
    without a method that supports it."

- **Statistical convention** (when applicable, e.g. Monte Carlo mismatch
  analysis) — N samples and sigma level reported, plus which mismatch/
  process variation model was enabled. Used for distribution claims that are
  not a per-corner pass/fail (#15).

  **The recorded-seed reproducibility claim is host-scoped (issue #611).**
  Every Monte Carlo record in this repository sets `.option rndseed=N` (never
  `set rndseed=N` inside `.control` — the per-instance `agauss()` mismatch
  draws inside `nfet_03v3_dss`/`pfet_03v3_dss` are evaluated once at netlist
  *parse* time, before any `.control` block runs) and states that this makes
  the draws reproducible. That is true, but narrower than it reads: the same
  seed reproduces the same draw only **within one build on one host** — a
  different host with the same seed, deck, and pinned `ngspice` version draws
  a **different sample** from the same distribution, not a different
  numerical answer to the same one. This was found comparing two committed
  `sim/mc-cp-mismatch` records covering the same corner and seed on different
  hosts, whose per-seed values differed by ~2.7 percentage points against a
  ~4 % per-corner σ (`sim/mc-cp-mismatch/testbench/run.sh`'s record template
  carries the full worked comparison). Read the reproducibility claim as:
  same host + same build + same seed → same draw; a different host is an
  **independent replicate** of the same campaign, not a reproduction of the
  same sample. Consequently, a **per-seed** comparison across hosts is
  meaningless — only a **distribution-level** comparison (N, mean, σ) is. This
  does not affect `--restat`-style reduction: that re-reduces already-committed
  samples from their CSVs and is exactly reproducible on any host, because
  nothing re-draws.

  This is a different case from **[DR-028](../spec/decision-records/DR-028-batch-executed-records-run-a-second-ngspice-version.md)**'s
  cross-host finding, not a restatement of it: DR-028 measured this repo's
  same-version cross-host floor on a **deterministic** quantity
  (`sim/period-jitter`), where a cross-host re-run is a reproducibility
  **check** read against that floor. Here the quantity being re-run is itself
  a Monte Carlo sample, so a cross-host re-run has no floor to check against —
  it is a replicate, not a check. The two findings are both about cross-host
  behaviour but do not generalize to each other.

  **Documentation of the comparison host is the Environment provenance
  field's job, not a separate mandatory field.** A reader comparing two
  records' seeds already has to read each record's Environment provenance
  "where the points actually ran" host disclosure before assuming they share
  one; no campaign runner is required to additionally assert *which* host a
  new record should be compared against.

  **A Monte Carlo campaign's negative control is an artifact, not a sentence
  (#602).** A campaign whose samples are drawn from a seeded RNG must commit
  the evidence that the draws are what it says they are, in the same run that
  produces the samples — not describe a manual check in this field. The
  distinction is not stylistic: it is the difference between a claim that can
  be re-checked and regressed and one that can only be re-read, and it is
  `CLAUDE.md`'s "no claim without a testbench" applied to the campaign's own
  validity leg. `sim/period-jitter/random-bound` set the shape first (a
  committed noiseless `floor` leg in every one of its per-point results);
  `sim/mc-cp-mismatch` and `sim/vco-tuning-range` follow it.

  The committed form is `corners/<record-id>/negative_control.csv`, schema and
  helpers in `sim/lib/simenv.sh` (`simenv_control_verdicts` /
  `simenv_control_report` / `simenv_control_md_rows`), with the raw log of
  every control run archived beside it. Three legs per sampled point, five
  runs:

  | Leg | Runs compared | Must be |
  |---|---|---|
  | `repeat` | mismatch ON, same seed, twice | identical |
  | `vary` | mismatch ON, two different seeds | **different** |
  | `gate` | mismatch OFF, two different seeds | identical |

  `vary` is not optional padding. Without it, `repeat` and `gate` are both
  equally satisfied by a measurement that is insensitive to everything —
  including to the mismatch the campaign exists to sample — so the pair alone
  cannot distinguish "the seed is honoured" from "nothing here moves". Values
  are compared as **text**, not within a tolerance: a tolerance lets a draw
  that has begun to drift keep passing, which is the failure the leg exists to
  catch.

  The **verdict is derived from the committed CSV**, by the record generator
  and by `run.sh --recheck-control <record-id>` alike, so a record's control
  table cannot drift from its own bytes and a reader can re-check it with no
  simulator and no PDK. `sim/tests/test_negative_control.py` re-derives both
  campaigns' artifacts independently, cross-checks the shell helper against
  that second implementation, and asserts the checker still reports a failure
  when each leg is broken in turn.

- **Result** — per-corner pass/fail or measured value, plus an overall
  pass/fail against the ratified spec value (for a spec claim) or the
  conclusion drawn (for a design-input claim). Free-form tables are fine and
  expected here — e.g. a per-block power breakdown (#14) or a cap-type
  comparison table (#4) lives in this field.

- **Links** — paths to the testbench file(s), the frozen netlist snapshot,
  and the raw per-corner logs used to produce this record.

- **Timestamp / author** — when the record was created (UTC) and who (human
  or agent) created it.

- **Supersedes** (optional) — the prior `<record-id>` this record supersedes,
  for corrections or for a post-layout extracted re-run that reports a
  schematic-vs-extracted delta against the schematic-level record. May carry
  an optional free-text qualifier after the record-id, separated by ` -- `,
  stating which part of the predecessor is superseded (e.g. `<record-id> --
  switching-timing half only`) — see "Status / supersession language" below
  for when this is needed, and
  `sim/cp-compliance/records/20260731-122451-63e4b47.md`'s **Supersedes**
  line for precedent.

### Status / supersession language

Records use the same status *vocabulary* as `spec/` decision records
(`spec/decision-records/TEMPLATE.md`, landed in this repo via #6; that template
is in turn adapted from bandgap's), so the two conventions read as one:

- A record's standing is one of **`current`** or **`superseded by
  <record-id>`**. There is no `draft` or `retracted` state: a record is
  evidence of what a run produced, and a run that happened cannot become
  un-happened. Decision records add a third, **`proposed`**, which has no
  analogue here: a record is minted by a run that already completed, so it is
  never "not yet binding".
- **`Status` is not a record field — do not emit one.** The schema above is the
  complete field set, and it has no `Status`. Standing is *derived*, not
  stored: a record is `current` until some later record names it in a
  **Supersedes** field, at which point it is `superseded by` that record. The
  vocabulary exists so humans and tools can *talk* about standing
  consistently; nothing writes it into a file.
- The superseding record carries **Supersedes: `<record-id>`**; the superseded
  record is **not edited** to add a back-reference — that would be a rewrite.
  Standing is therefore found by reading *forward* from the superseded record:
  scan for the record that names it. **`sim/lib/check-record-supersession.sh`
  runs that scan in CI** for the three reader-facing status documents
  (`README.md`, `sim/CHARACTERIZATION.md`,
  `docs/chipalooza/challenge-5-proposal.md`): none of them may cite a record
  that has been superseded without naming a successor, and none may cite a
  record id that is not on the tree. It grades the citation graph, not the
  prose around a citation — see that script's header for what it deliberately
  does not do, and for why `spec/pll.md` is not in the list.
- **[PLL delta] — one deliberate divergence from the decision-record
  convention.** `spec/decision-records/TEMPLATE.md` supersedes a decision
  record by editing the **old** record's `Status` to `superseded by DR-NNN`, a
  forward pointer written in place. Evidence records do **not** do this: the
  pointer lives only in the *new* record's **Supersedes** field, and the
  superseded record's bytes never change after creation. The reason is that the
  two artifacts have different jobs — a decision record is a governance
  document whose current standing must be legible at a glance to anyone who
  opens it, so a controlled in-place status edit earns its keep; an evidence
  record is a frozen observation of what a simulator actually emitted, and
  editing it at all (even to add a true, helpful pointer) forfeits the
  guarantee that makes `sim/` citable. When the two rules seem to conflict,
  immutability wins here and legibility wins in `spec/`.
- Same rule as `spec/`, and the one both conventions share without
  qualification: *do not delete or rewrite a record — supersede it.*
- **Supersession is scoped per-bench, not per-experiment-directory.** An
  experiment directory (e.g. `sim/cp-compliance/`) may host more than one
  bench (e.g. a DC bench and a switching-timing bench) — that is explicitly
  allowed. A record supersedes the *latest prior record that carries the
  same bench's measurements*, not necessarily the latest record in the
  directory by timestamp, and one predecessor record may legitimately have
  **more than one** successor if it held evidence for more than one bench
  and later runs replace those halves separately. When that happens, each
  successor's **Supersedes** field should carry the free-text qualifier
  described above naming which part of the predecessor it replaces, so a
  reader landing on the superseded record can tell which successor to read
  for which measurement without having to fall back on comparing `Claim`
  fields. Worked example: `sim/cp-compliance/records/20260731-194124-afa338c.md`
  held both the DC and switching-timing halves of the `cp-compliance` bench;
  `sim/cp-compliance/records/20260801-190821-734f483.md` (DC half) and
  `sim/cp-compliance/records/20260802-061841-c24ee3a.md` (switching-timing
  half) both supersede it, each replacing a disjoint half.

## Append-only rule

`records/*.md` files are never edited or deleted after creation. A re-run or
a correction always creates a new record with a new `<record-id>`. If it
corrects or replaces a prior result, it references that prior record via
**Supersedes** rather than overwriting it. This applies even to typo fixes —
the append-only guarantee is what makes `sim/` usable as an evidence trail;
"fixing" an existing record in place would defeat that.

The same rule binds the raw artifacts: `corners/<record-id>/` logs and
`netlist-snapshots/<record-id>.spice` are written once and never touched
again. A tool that would rewrite them is wrong, not convenient.

Only `testbench/` and this README are mutable — and a testbench change that
affects comparability must be called out in the next record.

**So a text defect already committed into evidence is corrected _forward_, in
the live `testbench/` artifact — never by editing the bytes that carry it.**
The correction names the exact files it applies to, says which artifact is
authoritative for them, and exists so no later run repeats the defect; the
committed record, log or CSV keeps its bytes and its standing. Two worked
examples on this tree, both marked "Erratum" so the family is greppable:
`sim/lock-window-trim/testbench/tb.json` corrects a stale device width that
one record's prose states, and the header comments of
`sim/mc-cp-mismatch/testbench/run.sh`,
`sim/vco-tuning-range/testbench/run_mismatch.sh` and
`.../run_band0_worst_corner.sh` correct the `# switches:` line of fourteen
CSVs minted before `simenv_provenance` could be told that the run had Monte
Carlo mismatch turned on (#601). Note what the disposition does *not* buy:
nothing a reader holding only the defective file can see. That is the price of
immutability, and it is why the correction belongs in the artifact that mints
the next one.

## Retention policy — what is kept

| Artifact | Retained? | Why |
|---|---|---|
| Summary record (`records/<id>.md`) | **Always, committed** | the citable evidence object |
| Frozen netlist snapshot (`netlist-snapshots/<id>.spice`) | **Always, committed** | the record's claim is meaningless without the exact DUT |
| Raw per-corner ngspice logs (`corners/<id>/*.log`) | **Always, committed** | the primary evidence the extracted metrics were read from; includes the warnings a summary hides |
| Per-point raw measurements (`corners/<id>/raw_measures.csv`) | **Always, committed** | `sim/harness` writes this unconditionally on every run, independent of whether the manifest declares any `derived.tables` — it is the machine-readable form of the record's own Markdown corner table (same per-point rows, same measurement values, verdicts from the record's own check pipeline), so a per-point comparison across records never requires parsing Markdown. Its single `verdict` cell covers **every** check in the manifest; a multi-topology record scopes each sub-table's pass/fail column to that topology's own checks, so the two can differ for a grouped bench — see `sim/harness/README.md` |
| Extracted metrics / derived measurement tables | **Always** — inside the record, or as a small CSV beside the logs | machine-readable comparison across records for a campaign's own reduction over the raw table above |
| Full waveform rawfiles (`.raw`) | **No, not committed** | hundreds of MB per transient; regenerable from the frozen netlist + logged environment |
| Plots | Only when the plot *is* the argument | a plot is a rendering, not evidence; commit it with the script that generated it |

**How the tooling enforces this.** Root `.gitignore` ignores `*.raw` and `*.log`
tree-wide, which would otherwise silently swallow the corner logs this table
mandates committing — `git add sim/<slug>/corners/<id>/` would add nothing for
them and the record's **Links → Raw logs** path would point at untracked files.
A scoped negation un-ignores exactly the evidence path and nothing else:

```gitignore
*.raw
*.log
!sim/*/corners/**/*.log
```

So per-corner logs under `corners/<record-id>/` are trackable, while `.raw`
files there and stray `.log` files anywhere else (e.g. `testbench/scratch.log`)
stay ignored. Anyone adding a new committed-evidence artifact type that collides
with an ignore rule must extend that negation in the same narrow way — never by
`git add -f`, which leaves the next run's logs silently untracked again.

**Waveform rule.** When a waveform is itself the evidence — a lock
transient, a control-line ripple trace, a startup sequence — do **not**
commit the rawfile. Commit a **downsampled CSV of the specific signal(s)**
under `corners/<record-id>/` (e.g. `lock_transient_ss_-40c_2.97v.csv`),
state the decimation in the Methodology field, and keep the deck able to
regenerate the full rawfile. Anything above a few MB per record wants
justification in the record.

**Manifest-forward rule for new runs (issue #830).** New campaigns do not
commit raw run output (per-corner logs, `raw_measures.csv`, rawfiles). They
stage it in the git-ignored `sim/.artifact-stage/`, store it with
`sim/lib/artifact-put.sh <bench> <run-id> <file>...`, and commit only the
resulting `manifests/artifacts/<bench>-<run-id>.manifest.json` (every object
named by size and sha256, every `uri` an `artifact:` key) alongside the usual
summary record. The writer fails closed: with no broker, no `klt artifact put`
or an unreachable broker it exits nonzero, writes no manifest, and there is no
fallback to committing bytes. `sim/lib/check-artifact-manifests.sh` (CI)
rejects malformed manifests, non-`artifact:` URIs, and committed bytes that
equal a stored object. The "Always, committed" rows above describe evidence
that already exists and still apply to it; this rule only changes where *new*
raw bytes go. **No existing file is removed or rewritten.** See
`manifests/artifacts/README.md`.

**Nothing is pruned.** Old records stay after they are superseded; that is
the point. If `sim/` ever becomes genuinely too large, the answer is a
decision record under `spec/` proposing an archival scheme, not a `git rm`.

## No fabricated evidence

Files under `sim/<experiment-slug>/` may only be created by an actual run of
an actual testbench. Do not commit an example, a template, or a
plausible-looking record into evidence position — a made-up record in
`records/` would violate "no claim without a testbench" more severely than
having no record at all, and the append-only rule means it could never be
cleanly removed. The worked example below lives **in this README on
purpose**, and must stay here.

The first real testbenches landed via #4 (`devchar-delay`, `devchar-cp`,
`devchar-passives` — see each experiment's `records/` for the current
evidence). Every campaign added after them follows this same convention;
`sim/` never gains a fabricated or example record outside this file.

## Worked example (ILLUSTRATIVE — not evidence)

> **Every value below is invented for illustration.** No such record, log,
> or netlist exists in this repo; the numbers are placeholders and the spec
> anchor is a placeholder pending ratification (#1). Do **not** copy this
> block into `sim/lock-time/records/` — see "No fabricated evidence" above.

Directory layout for a closed-loop lock-time campaign (#12), showing a first
record and a later correcting re-run:

```
sim/
  lock-time/
    testbench/
      tb_lock_time.spice
      tb_lock_time.sch            # xschem source, if schematic-captured
    netlist-snapshots/
      20260730-142500-3f1c9ab.spice
      20260812-090330-b47e021.spice
    corners/
      20260730-142500-3f1c9ab/
        tt_27c_3.30v.log
        ss_-40c_2.97v.log
        ss_125c_2.97v.log
        ff_-40c_3.63v.log
        ...
        lock_transient_ss_-40c_2.97v.csv
      20260812-090330-b47e021/
        tt_27c_3.30v.log
        ss_-40c_2.97v.log
        ...
    records/
      20260730-142500-3f1c9ab.md
      20260812-090330-b47e021.md
```

`records/20260730-142500-3f1c9ab.md`:

```markdown
# Record 20260730-142500-3f1c9ab

- **Record ID**: 20260730-142500-3f1c9ab
- **Claim**: `spec/pll.md#lock-time` — worst-case cold-start lock time,
  draft target < 100 µs (placeholder value; ratified spec pending #1)
- **Netlist provenance**: schematic (`design/pll_top.sch` →
  `sim/lock-time/netlist-snapshots/20260730-142500-3f1c9ab.spice`),
  netlist SHA-256 `9f1c…a20e`
- **Environment provenance**:
  - PDK: `gf180mcuD`, open_pdks
    `f6eeac7dad085ffcc829ccfd721f7b4ce39edcf7`
  - Models: `sm141064.ngspice`
  - Simulator: ngspice 46; schematic capture: xschem 3.4.7
  - Repo commit: `3f1c9ab` (clean tree)
  - Host: macOS 15 / arm64
- **Corner matrix run**: 45 PVT points (5 MOS bundles × 3 temperatures × 3
  supplies), each run at 3 divider settings → 135 runs
  - Bundles (→ `.lib` sections): `tt` → typical; `ff` → ff; `ss` → ss;
    `fs` → fs; `sf` → sf
  - Temperature: −40 °C, 27 °C, 125 °C
  - Supply: 2.97 V, 3.30 V, 3.63 V (3.3 V ±10 %)
  - **Axes not swept**: passive sections held at `res_typical`,
    `mimcap_typical`, `moscap_typical` — MOS-only sweep. Justified in
    Methodology.
  - Divider settings: N = ×4, ×16, ×64, each exercised at every one of the 45
    PVT points (worst-case step per setting)
- **Methodology / criteria / limitations**:
  - Lock criterion: cold start from `vctrl = 0`; locked when |Δf/f_target|
    ≤ 0.1 % **and** static phase error ≤ 2 % of a reference period,
    continuously for ≥ 20 reference cycles. Lock time = time from
    enable-release to the start of that window.
  - Frequency step: worst case per N — full-scale step to the band edge.
  - Transient: 400 µs, `reltol 1e-4`, max timestep 20 ps.
  - **Limitation**: passives at typical, so this record bounds lock time
    against MOS skew only; R/C skew moves loop bandwidth directly and is
    covered by the loop-dynamics campaign (#10) rather than re-swept here.
    A ratified lock-time claim must cite both.
  - Waveform retained: `lock_transient_ss_-40c_2.97v.csv`, decimated to
    2 ns/sample (worst corner only).
- **Statistical convention**: N/A — corner-matrix claim, not a distribution
  claim. Mismatch contribution to static phase error is #15
  (`mc-cp-mismatch`).
- **Result** (placeholder values):

  | Bundle | Temp | Supply | N=4 | N=16 | N=64 |
  |---|---|---|---|---|---|
  | tt | 27 °C | 3.30 V | 41 µs | 48 µs | 62 µs |
  | ss | −40 °C | 2.97 V | 63 µs | 74 µs | 91 µs |
  | ss | 125 °C | 2.97 V | 58 µs | 69 µs | 88 µs |
  | ff | −40 °C | 3.63 V | 29 µs | 34 µs | 44 µs |
  | … | … | … | … | … | … |

  - Worst point: `ss/−40c/2.97v`, N=64 → 91 µs
  - **Overall: PASS** against the draft < 100 µs target (placeholder —
    pending ratified spec, #1; margin is thin, see Methodology limitation)
- **Links**:
  - Testbench: `sim/lock-time/testbench/tb_lock_time.spice`
  - Netlist snapshot:
    `sim/lock-time/netlist-snapshots/20260730-142500-3f1c9ab.spice`
  - Raw logs: `sim/lock-time/corners/20260730-142500-3f1c9ab/`
- **Timestamp / author**: 2026-07-30T14:25:00Z, agent-builder
- **Supersedes**: (none — first record for this claim)
```

The later record `20260812-090330-b47e021.md` would be a correcting re-run —
same structure, with **Supersedes: 20260730-142500-3f1c9ab** and the reason
for the correction stated in its Methodology field (e.g. the lock criterion's
hold window was too short to exclude a late re-acquisition). The original
record stays exactly as written.

### Field variants (also illustrative)

The same schema covers the other campaign shapes. Excerpts only:

A **design-input claim** with no spec line (#4 → #10):

```markdown
- **Claim**: #4 → #10 (design input, not a spec line) — which loop-filter
  capacitor type meets the area budget with acceptable C–V linearity:
  `cap_mim_2f0fF` vs. `cap_nmos_03v3`?
- **Corner matrix run**: passive axes swept explicitly —
  `mimcap_typical/ff/ss` and `moscap_typical/ff/ss` × −40/27/125 °C;
  supply axis N/A (two-terminal C–V sweep over 0…3.63 V control range);
  MOS process bundles N/A (no active devices in the DUT).
- **Result**: comparison table (density fF/µm², ΔC/C over control range,
  leakage @ 125 °C) → conclusion: MIM at 2.0 fF/µm² fits the area budget
  with < 1 % ΔC/C; MOS cap is denser but non-linear over the control range.
```

A **recorded methodology gap** instead of a number (#13):

```markdown
- **Claim**: `spec/pll.md#period-jitter` — random (noise-driven) period
  jitter, draft target < 1 % RMS (placeholder; pending #1)
- **Methodology / criteria / limitations**: ngspice transient-noise analysis
  on a full closed-loop PLL at these transient lengths does **not** produce
  a convergent RMS estimate on this flow — [specific evidence and settings
  tried]. **No random-jitter number is reported by this record.**
  Deterministic jitter (control ripple, divider pattern) is reported below
  and is credible. Feeding back to #1/#7: the ratified jitter claim must be
  stated as deterministic-only in simulation, with random jitter deferred to
  silicon measurement (`measurements/`).
- **Result**: deterministic period jitter per corner (table); random jitter:
  **not substantiated — see Methodology**. Overall: **spec claim not
  verifiable by this method**, not "PASS".
```

> This example stopped being hypothetical. The six committed `period-jitter`
> records each carry exactly this shape, and **DR-020** adopts the last
> sentence of its Methodology field — the jitter claim *is* stated as
> deterministic-only in simulation, with the ≤ 1.0 % RMS target unchanged.
> DR-023 re-pointed the gap to #520; DR-020 had named #505, which closed
> the day DR-020 landed. The finding is stronger than the wording above: it is
> not that the transient-noise estimate fails to converge, it is that
> `.option TRANNOISE=1` injects no device noise into a transient on this
> build at all. **DR-023** then narrowed DR-020's reason, on committed,
> re-runnable probes (`sim/period-jitter/noise-toolchain-probe/`): `.noise`
> *does* report per-device thermal and flicker PSDs at a bias point, and what
> is missing is a periodic-steady-state / `pnoise` path to weight them over
> the oscillation cycle — so the routes #520 lists are a noise-referral
> pipeline, a toolchain that has that analysis, or a recorded negative
> result, rather than silicon.
>
> **DR-030** is what that worked example looks like one increment in, and it is
> worth reading as the other half of the pattern: `sim/period-jitter/isf-bringup/`
> builds the first of the noise-referral pipeline's three ingredients, shows it
> **converged** against the one risk #520 named as load-bearing, and still
> reports **no number** — so it mints no record, appears in no coverage table,
> and moves nothing in `spec/pll.md` except the description of what is left. The
> convention that makes that possible is the same one above: a directory under
> `sim/<slug>/` with no `records/` is a method directory, and the append-only
> evidence rule binds records, not methods.
>
> **DR-031** is the increment after that, and it is worth reading for the shape of
> the refusal rather than for the result. `sim/period-jitter/sid-trajectory/`
> builds the pipeline's remaining two ingredients, which leaves the jitter sum
> arithmetically *evaluable* for two of the four ring device classes — so the
> record has to say, explicitly, why it does not evaluate it: two of four classes,
> none of the bias generator's, an ISF weight that rests on an effective 2.4 of 12
> sampled phases, a pilot injection charge its own linearity sweep places 10 % from
> the limit, and one corner of 45. Four unquantified deficits do not become a
> result by being labelled a lower bound. What it reports instead is a **ratio** —
> what a single-bias noise density costs against the correctly-weighted one —
> because the deficits common to numerator and denominator divide out of a ratio
> and do not divide out of an absolute.
>
> **DR-032** is where the example ends, and the ending is not the one the
> pipeline was building towards: the row gets a pass/fail from an **upper bound**
> rather than from an estimate. `sim/period-jitter/random-bound/` sizes each
> injected noise source at the maximum of that device's own density over its
> trajectory, so the stationary approximation can only over-state the jitter —
> an error whose sign is known needs no ISF to bound it. Its README's "What this
> does NOT establish" section is the same discipline as the refusals above,
> pointed the other way: it says what the number is *not* (an estimate; a bound
> on the in-band generators, which `sim/period-jitter/in-band-bound/` and
> DR-033 add separately) as carefully as what it is.

A **distribution claim** with the statistical convention (#15):

```markdown
- **Corner matrix run**: nominal corner (`tt/27c/3.30v`) only — mismatch
  distribution evaluated at nominal PVT; corner sensitivity of the mean is
  covered by the corner-matrix record for the same block.
- **Statistical convention**: N = 500 Monte Carlo samples, mismatch-only
  (device mismatch model enabled, process variation disabled), distribution
  reported at ±3σ; seed recorded in the log header.
- **Result**: ±3σ static phase error and worst-case reference spur level
  (placeholder values) — **Overall: PASS** (placeholder, pending #1)
```

## For the harness (#2)

The harness bootstrapped in #2 is the intended producer of these records: it
owns the environment (`.lib` sections, `.temp`, supply) and must emit, per
run, the frozen netlist snapshot, the per-corner logs, and the Markdown
summary record with every mandatory field populated. Machine-readable
side-artifacts (JSON/CSV) are welcome **in addition**; they do not replace
the Markdown record. Conformance is verified when #2 lands, not here.

**#2 has landed** as `sim/harness/` (`pdk.py` / `corners.py` / `testbench.py`
/ `runner.py` / `report.py` / `cli.py`), `sim/run_corners.py`, `sim/env.sh`
and `sim/selftest.sh` — see `sim/harness/README.md` for how to run it and how
to write a testbench manifest. `sim/harness-selftest/` is the harness's own
acceptance testbench (real devices, real corners, no design claim); it is not
one of the block campaigns in the table above.

### ngspice binary pin (#259)

Every `sim/lib/simenv.sh`-based campaign's `simenv_require_tools` now insists
on a **pinned** `ngspice` binary — `$HOME/.local/bin/ngspice` by default,
overridable with `SIM_NGSPICE_BIN` — rather than silently accepting whatever
`ngspice` resolves to on `PATH`. This is not merely version pedantry: issue
#259 found a host where that pinned `ngspice-46` was absent, PATH fell
through to Homebrew's `ngspice-47`, and that build then hit a reproducible
parse failure on this PDK's nested nonlinear loop-filter/VCO moscaps
(`sm141064.ngspice`'s `cap_*mos_03v3`/`06v0` family — see
`sim/harness/README.md`'s "ngspice-46 required for nested nonlinear moscap
decks", #153) — and, worse, **hung instead of exiting** on that error,
stalling an `xargs`-driven `run.sh` job pool indefinitely since the affected
corner's slot never freed. A host missing the pin now gets a loud, actionable
error up front (naming the fix, the `SIM_NGSPICE_BIN` relocation override,
and the `SIM_ALLOW_UNPINNED_NGSPICE=1` opt-out) instead of quietly burning
hours against a defective, uncited simulator build. `sim/harness`'s own
`run_corners.py --check-env` / `runner.py` codepath is unaffected — it
already carries its own PATH-resolved-version warning
(`nonlinear_moscap_ngspice47_warning`) for the same underlying #153 defect,
scoped to the DUTs that actually nest the moscap family.

**The batch backend's job image now signs off the pin's version, and the
remaining divergence is bounded rather than aligned
([DR-039](../spec/decision-records/DR-039-batch-job-image-signs-off-ngspice-46-and-the-wedge-probe-converges-on-it.md),
#680; it partly supersedes
[DR-028](../spec/decision-records/DR-028-batch-executed-records-run-a-second-ngspice-version.md)).**
The pin above binds what runs *here*; a campaign dispatched off-host
(`sim/run_corners.py --backend batch`) runs on an image built by operator-owned
provisioning outside this repository. That image ran **ngspice-42** when DR-028
and DR-035 were written; as re-verified on 2026-10-08 its corner logs sign off
`ngspice-46 done` (image manifest `tools.ngspice` `ngspice-46`, PDK stamp
`open_pdks c6d73a35…`, the revision pinned at that date), and the six `wedge` −40 °C points of
`sim/reference-input-contract` that the ngspice-42 image failed 0 of 6
converge 6 of 6 with `d_ref` equal to the pin's to seven digits. A matching
version string is **not** a blanket equivalence: the 2026-10-08 diagnostic
(`BATCH-IMAGE-DIAGNOSIS-2026-10-08.md`, #533/#503) found other decks reaching a
different DC state on the image than on the pinned local binary, cause
unresolved. What DR-039 leaves in force for a reader of a batch-executed record:

- **It is a comparability limit, not an impeachment.** Those grids converge and
  pass their own guards, and the pin's known defect (#153) is an ngspice-**47**
  parse failure that ngspice-42 did not show. A batch-executed record is
  evidence on its own terms and may be cited as such.
- **It may not be merged into pinned-local evidence, except as DR-039 allows.**
  Until a campaign has its own overlap points against the pin, a batch-executed number may not supersede an ngspice-46 record, be
  composed point-for-point with ngspice-46 numbers into one corner-consistent
  total, or be quoted as completing a grid whose other points were taken on the
  pin. A mixed-origin grid must state the split. The one relaxation (DR-039):
  `sim/reference-input-contract`'s `d_ref`, whose six overlap points above agree
  with the pin; its charge quantities are not covered.
- **The size of the ngspice-42-era divergence was measured at one point, and it
  is not one number** ([DR-035](../spec/decision-records/DR-035-reference-input-contract-blocked-by-the-job-image-not-by-compute.md),
  #499). DR-028 left this unquoted with the bound owed at **#549**, in the
  shape of `sim/period-jitter`'s cross-*host* overlap (records
  `20260906-015602-f9bef9d` / `20260906-063728-f3c9c23`, which re-run two
  27 °C/3.30 V points on a second host at the *same* version and differ by
  3.7 % and 9.3 % — the floor any cross-version result has to be read against).
  `sim/reference-input-contract`'s anchor point
  `typical_-40c_3.30v_wideal_p0` has since been run on both, same deck: the
  **delay** quantities agree to better than 0.1 % (`d_ref` −0.044 %, `d_fb`
  −0.061 %, `width_up`/`width_dn` +0.03 %), i.e. well *inside* that cross-host
  floor, while the **charge** integral `qnet`/`qnet2` differs by **17 %**, well
  *outside* it. So the quarantine above is not relaxed by this: it is one point
  on one deck, it bounds that campaign's quantities and nothing else, and it
  shows the divergence is quantity-dependent — small on timing, large on
  integrated current — which is why a per-quantity relaxation needs overlap
  points on the decks that need it rather than a single global factor.
- **On one deck the old image did not run; the current one does.** The
  `wedge` variant of `sim/reference-input-contract` — the full-rail 6.25 ns
  ramp placing the 10–90 % edge rate at the spec's binding 5 ns — aborted on
  ngspice-42 with `Timestep too small … trouble with node "vctrl#branch"` at 12
  of the 20 corners reached, every −40 °C point among them (DR-035). On the
  ngspice-46 image all six −40 °C points converge (DR-039, #680). The full
  288-point grid is #499's, not yet run.

**`sim/harness` is the convention for every new campaign — `sim/lib/simenv.sh`
is legacy.** The interim shim and the campaigns still built on it remain the
real, already-recorded evidence for their claims, but no new campaign should
be written against it. Migrating existing shim campaigns onto `sim/harness`
was tracked by #36 (decomposed into #40–#44): #40–#43 each migrated a named
set of campaigns and are closed. #44 — the issue that would delete
`sim/lib/simenv.sh`/`sim/run-all.sh` once nothing depended on them — closed
by *documenting* the remaining dependents as a formal exception list (below)
rather than by migrating them, because several were never in #40–#43's scope
and one is a deliberate, harness-capability-limited design choice. The shim
files stay in the tree until every row in the table below reads
`sim/harness`.

**Migration state** — which campaigns run on which runner today:

| Campaign | Runner | Migration |
|---|---|---|
| `devchar-delay`, `devchar-cp`, `devchar-passives` | `sim/harness` | migrated (#40); each new record **Supersedes** the pre-migration one |
| `divider-ratio` → `divider-ratio-dff` / `-cell` / `-chain` | `sim/harness` | migrated (#41), by splitting the campaign into three sibling slugs — see "A one-directory experiment can outgrow one `sim/harness` manifest" above. The original `divider-ratio/` records stay untouched as append-only evidence |
| `lock-detector` | `sim/harness` | migrated (#41); its new record **Supersedes** the pre-migration one |
| `cp-compliance`, `pfd-deadzone` | `sim/harness` | migrated (#42, landed by #99); each new record **Supersedes** the pre-migration one |
| `vco-tuning-range` (stage-count comparison) | `sim/harness` | migrated (#43); its new record **Supersedes** the pre-migration one |
| `vco-tuning-range` (tuning sweep) | `sim/harness` | manifest migrated (#43); the 504-point evidence re-run landed under #84, so the citable record is a migrated one |
| `vco-tuning-range` (supply pushing / jitter) | `sim/harness` | migrated (#43, landed by #124); its new record **Supersedes** the pre-migration one — see below |
| `vco-tuning-range` (band-select mirror Monte Carlo mismatch, #146) | `sim/lib/simenv.sh` | **deliberate exception, not scheduled to migrate** — see below |
| `lock-time`, `output-range` | `sim/lib/simenv.sh` | **#44 exception** — the manifest gap that blocked them is closed (`sweeps`/`grid`); migrating the campaigns themselves is not yet scoped by any issue — see below |
| `loop-dynamics`, `pll-top-smoke`, `supply-sensitivity` | `sim/lib/simenv.sh` | **#44 exception** — not yet scoped; these campaigns landed after #36 was written, so they were never in #40–#43's scope and #44 does not migrate them either |
| `mc-cp-mismatch` | `sim/lib/simenv.sh` | **#44 exception** — not yet scoped, and additionally the campaign that established the raw-`simenv.sh`-deck Monte Carlo pattern the mismatch exception above reuses (no per-run seed axis in `sim/harness`; see `sim/vco-tuning-range/testbench/run_mismatch.sh`'s header) |
| `harness-selftest` | `sim/harness` | n/a — it *is* the harness's acceptance testbench |

A migrated campaign keeps its pre-migration `run.sh` in place, marked
superseded for new runs: the records that runner already minted are
append-only evidence, and it is the only thing that can regenerate the extra
CSV artifacts those records cite.

### `sim/lib/simenv.sh` / `sim/run-all.sh` retention — the #44 exception list

`sim/lib/simenv.sh` and `sim/run-all.sh` are **not deleted**. #44 audited
every `sim/**/*.sh` that still sources the shim
(`grep -rl 'simenv\.sh\|run-all\.sh' sim/ --include='*.sh'`, excluding the
shim files themselves and comment-only references) and sorted the result into
three categories, none of which #44 migrates itself:

1. **Pre-migration `run.sh` retained for provenance only** — every campaign
   the "Migration state" table above marks `sim/harness`: `devchar-delay`,
   `devchar-cp`, `devchar-passives`, `divider-ratio`, `lock-detector`,
   `cp-compliance`, `pfd-deadzone`, and all three `vco-tuning-range` decks
   (main tuning sweep, stage-count comparison, supply pushing/jitter). Each
   file carries a `SUPERSEDED FOR NEW RUNS` banner pointing at its
   replacement manifest; none is a live consumer of the shim going forward,
   they only regenerate the CSV artifacts their own already-committed
   records cite.
2. **Live campaigns with no `sim/harness` manifest and no migration issue
   filed** — `lock-time`, `output-range`, `loop-dynamics`, `pll-top-smoke`,
   `supply-sensitivity`, `mc-cp-mismatch`. These are the shim's real,
   ongoing consumers. `lock-time`/`output-range` cleared their manifest gap
   (`sweeps`/`grid`, see below) but nobody has scoped migrating the
   campaigns themselves; `loop-dynamics`/`pll-top-smoke`/`supply-sensitivity`/
   `mc-cp-mismatch` landed after #36 was written and were never in #40–#43's
   scope either. Each ancillary script under these same campaign directories
   that also sources the shim — `output-range/testbench/stall_trace.sh`
   (a diagnostic helper) and `supply-sensitivity/testbench/reexamine.sh` /
   `report.sh` (re-examination and reporting helpers) — is covered by its
   parent campaign's exception, not a separate one. Migrating any of these
   campaigns is legitimate future work — each should get its own issue, sized
   the way #40–#43 were — but it is not this issue: #44's Acceptance Criteria
   are explicit that "no `sim/` evidence record is re-run or re-recorded by
   this issue," and running six already-substantial closed-loop/Monte-Carlo
   campaigns through a harness migration is well beyond "routine."
3. **One deliberate, harness-capability-limited exception** —
   `sim/vco-tuning-range/testbench/run_mismatch.sh` (the band-select mirror
   Monte Carlo campaign, #146) reuses `mc-cp-mismatch`'s raw-`simenv.sh`-deck
   pattern on purpose, not provisionally. Its own header documents two
   `sim/harness` gaps that block a manifest-based version today: a
   `tb.json` `params` override of a `design.ngspice`-defaulted global is
   silently nullified by deck ordering (`compose_deck()` emits `.include` for
   the design *after* the manifest's own `.param` lines), and the harness's
   PVT-grid runner has no per-run Monte Carlo seed axis (`.option
   rndseed=N` must be read at netlist parse time). `mc-cp-mismatch` — item 2
   above — carries the same seed-axis gap; `run_mismatch.sh` names it as the
   established precedent it is following. Fixing either gap generally is
   its own harness change, not a side effect of documenting an exception
   list.

So `sim/lib/simenv.sh` stays until every row in the "Migration state" table
reads `sim/harness`, which requires new, separately-scoped migration work for
category 2 and a `sim/harness` capability change for category 3 — neither of
which #44 does. This satisfies #44's Acceptance Criteria via the "keep the
shim, document the exception" branch rather than the "delete it" branch.

`sim/vco-tuning-range`'s supply pushing/jitter campaign (#43) **has migrated**
(PR #124): it minted **one** record from **two** decks (`tb_vco_pushing.sp`
and `tb_vco_supply_jitter.sp`) once `tb.json`'s `phases` key (#92) let one
manifest declare more than one `netlist`/`params`/`measure` block sharing one
PVT grid, one DUT, one `checks` list, one `derived` reduction and one record
— see `sim/harness/README.md` for `phases`. The migrated manifest lives at
`sim/vco-tuning-range/testbench-supply/tb.json`; its record
(`20260804-211600-f599a65`) **Supersedes** the pre-migration
`run_supply.sh` record and includes a `migration_delta` table joining the two
runs' shared measurements to show the migration reproduced the same
experiment (frequency-domain quantities to 0.04% median / 0.76% worst; two
explained deviations documented in the record itself). `run_supply.sh` now
carries the `SUPERSEDED FOR NEW RUNS` banner alongside its migrated siblings.
Splitting that record in two to fit a one-deck manifest would have landed a
migrated record *weaker* than the one it supersedes (a DC pushing number with
the transient jitter dropped), which the append-only rule does not permit —
which is why `phases` was the right shape for the fix and a split was not.

`sim/lock-time` and `sim/output-range` (#12) still build on
`sim/lib/simenv.sh` rather than `sim/harness`, even though both landed after
#2. The reason was a real capability gap, not a preference: `tb.json`
(`sim/harness/testbench.py`) carried exactly one fixed `.param` set per
experiment, with no per-run override, so a manifest could not express the N x
cold-start/re-lock axis these two closed-loop campaigns sweep *in addition
to* the PVT grid within one evidence record — see either campaign's
`testbench/run.sh` header for the citation.

**That gap is now closed.** `tb.json`'s `sweeps` key declares extra
independent axes beyond the PVT grid, each point carrying its own derived
deck parameters, and `grid` states the union of blocks a run covers when the
cross-product is deliberately not run in full (`sim/harness/testbench.py`;
see `sim/harness/README.md` → "Sweeping beyond the PVT grid"). Manifests
across the tree already use it, and more will as campaigns migrate —
`grep -rl '"sweeps"' sim/*/testbench*/tb.json` lists the current set at any
commit, rather than a count here that goes stale. The proof case is
`sim/divider-ratio-chain/testbench/tb.json`: 63 points sweeping N = 4-64 as an
axis carried *alongside* the PVT grid within one evidence record, declared
non-rectangularly as a `grid` of seven blocks (61/61/2/1/1/2/2 points). That is
exactly the shape described above as inexpressible. What remains is migrating
`lock-time`/`output-range` themselves, which — per the exception list above —
is separate work and not yet scoped by any issue; until it lands, their
`run.sh` records remain that claim's evidence.

`sim/vco-tuning-range` carries **more than one** `sim/harness` manifest,
because it is one experiment directory answering one claim (#8) through three
separate decks. The main tuning sweep keeps the conventional
`testbench/tb.json`, so `python3 sim/run_corners.py vco-tuning-range` runs
it; the stage-count comparison lives beside it in `testbench-stages/tb.json`
(`python3 sim/run_corners.py sim/vco-tuning-range/testbench-stages`), and the
supply pushing/jitter campaign lives in `testbench-supply/tb.json` (`python3
sim/run_corners.py sim/vco-tuning-range/testbench-supply`). All three resolve
to the same `sim/vco-tuning-range/` experiment directory, so their records,
snapshots and corner logs land in the same append-only tree and can supersede
each other's predecessors — which is the point: splitting them into sibling
experiment slugs would have broken the supersession chains of the records
they replace. The fourth deck under the same directory,
`testbench/run_mismatch.sh` (the Monte Carlo mismatch campaign, category 3
above), has no manifest and is not expected to gain one until the two harness
gaps it documents are fixed.
