2AMLogic/gf180-pll/layout/README.md

# layout/ — DRC/LVS flow (gf180mcu)

This directory brings up a repeatable, `klt`-aware DRC/LVS flow against the
gf180mcu open-PDK decks (issue #16) — the entry gate to the layout phase on
this project's maturity ladder (simulation-complete -> layout DRC/LVS-clean
-> shuttle seat). It is **tool/flow bring-up**, proven on a trivial cell (a
tapped standard-cell inverter), not any PLL-block layout — see
`layout/evidence/inv-tb-proof/` for the recorded proof and "Scope" below.
`layout/floorplan/` (issue #17) is the first consumer of that flow beyond the
bring-up proof: a block-placement floorplan record and GDS skeleton, not yet
any block's real transistor-level layout — see
`layout/floorplan/PLL-FLOORPLAN.md`. `layout/pll_top/` (issue #292/#293) is
the first block with **real** transistor-level layout, and the VCO is now
assembled end to end: `layout/pll_top/vco/block.py` wires all five VCO
sub-blocks — the 5-stage ring (`ring.py`), the common-centroid 3-cascade
band-select mirror (`mirror.py`), the 3-stage tapered output buffer
(`buffer.py`), the `RCG`/`ROFF`/`RDEG` poly resistors (`bias_resistors.py`)
and the 13-transistor V-to-I core (`vtoi_core.py`) — into one DRC-clean
layout under a two-sided block-level guard ring (`GND_VCO` substrate ring,
`VDD_VCO` n-well tap ring concentric outside it), with the routed nets
proved electrically connected as well as rule-clean (see
`layout/evidence/vco-layout/PROOF-block.md` for the assembly and
`PROOF-fold.md` for the band mirror's two-bank row fold and that second ring
band); the 22 pF supply decap is two real `cap_nmos_03v3` devices, drawn at
issue #759 — see `layout/evidence/vco-layout/decap-20261009/PROOF.md`.
`layout/pll_top/pfd_cp/` (issue #294/#299/#300) is
a second, independent full-custom leaf-cell family: a reusable
device-list-driven generator (`devgen.py`) proved out on one representative
PFD/CP leaf cell (`pfdcp_inv_3v3`) — see `layout/evidence/pfdcp-inv-proof/PROOF.md`
for the DRC/LVS-clean proof and why it draws geometry directly against
`klayout.db` rather than through `klt gen`/`klt gen-compose` (a genuine,
filed capability gap, not a preference). Built on that methodology,
`rowgen.py`/`pfd_cells.py`/`pfd.py` (issue #300) assemble the full
tri-state PFD block — 47 leaf instances, 108 transistors, its two UP/DN
chains laid out as literal mirror images about a shared axis per
`PLL-FLOORPLAN.md` section 4 — see `layout/evidence/pfd-layout/PROOF.md`.
`layout/pll_top/divider_chain/` (issue #295/#306) is a third, independent
full-custom leaf-cell family: a sibling `devgen.py`, reused/generalized from
`pfd_cp/devgen.py`, proved out on two representative leaf cells —
`inv_3v3` (a static CMOS inverter) and `tgate_3v3` (a complementary
transmission gate, the pass-device topology neither sibling family covers)
— see `layout/evidence/divider-inv-proof/PROOF.md` and
`layout/evidence/divider-tgate-proof/PROOF.md`. The transmission gate
needed two real generalizations beyond `pfd_cp/devgen.py`'s original API
(`Device.body_net`, `build_stack_cell()`'s `bypass_nets`) — both docstrings
document the concrete DRC/LVS failures that motivated each one. Issue #307
adds that family's four remaining combinational leaf cells —
`nand2_3v3`, `nand3_3v3`, `nor2_3v3`, `inv2x_3v3` — via a second leaf-cell
generator in the same module, `build_row_cell()`: a column/row placement
model plus Metal1-strap/Metal2-track routing, because a static gate with
real fan-in puts 3+ terminals on one net, which `build_stack_cell()` refuses
by design. All four share one fixed row-cell frame (identical height and
rail y-bands, so they abut) — see
`layout/evidence/divider-rowcells-proof/PROOF.md`, including why
single-layer routing provably cannot draw a NAND2 here. Built on the same
methodology, `dff_tg_3v3.py` (issue #308) assembles the first
`divider_chain` **composite**: a 20-transistor transmission-gate
master-slave flop, 6x `inv_3v3` + 4x `tgate_3v3` placed side by side in one
flat macro (not GDS-level `CellInstArray`, the same style
`layout/pll_top/lock_detector/build.py` established) and wired with a new
Metal2/3 composite-routing fabric (`devgen.py`'s `route_net()`/`NetTracks`,
generalized from `lock_detector/primitives.py`'s own) — see
`layout/evidence/divider-dff-proof/PROOF.md` for the DRC/LVS-clean proof and
two concrete same-x riser-collision bugs its own bring-up found and fixed
(`devgen.py`'s `offset_pad_x()`).

```
layout/
  README.md                 this file
  run_pv.py                 CLI entry point: check-env / build / drc / lvs / bare-cell / prove
  harness/                  the harness itself
    env.py                    tool discovery: PDK, KLayout binary, PV-capable python
    cell.py                   the trivial cell (inv_tb) + its reference netlist
    drc.py                    drives the foundry DRC deck, normalises the verdict
    lvs.py                    drives the foundry LVS deck, normalises the verdict
    faults.py                 negative-control fault injection (DRC + LVS)
    reproduce.py              does each committed block GDS still come out of its generator?
  tools/
    pmap                      macOS pmap(1) shim the foundry decks' logger needs (see below)
  floorplan/                 PLL block-placement floorplan (issue #17)
    PLL-FLOORPLAN.md           isolation, supply routing, cap placement, matching, area budget
    skeleton.py                assembles the GDS block-placement skeleton the record describes
  pll_top/                  real per-block transistor-level layout (issue #292)
    vco/                      the VCO block (issue #293)
      devices.py                schematic-sourced device table (W/L/nodes), no KLayout needed
      primitives.py              full-custom nfet_03v3/pfet_03v3, poly-resistor and cap_nmos_03v3 geometry generators
      stage.py                   one vco_stage.sch instance (MPH-MP-MN-MNT)
      ring.py                    assembles the 5-stage ring + guard ring (+ standalone decap markers); CLI entry point
      buffer.py                  the 3-stage tapered output buffer; CLI entry point
      mirror.py                  the common-centroid 3-cascade band-select mirror; CLI entry point
      bias_resistors.py          the bias generator's RCG/ROFF/RDEG ppolyf_u_3k poly resistors
      vtoi_core.py               the bias generator's 13-transistor V-to-I core; CLI entry point
      block.py                   assembles all five sub-blocks into one wired, guard-ringed,
                                 DRC-clean VCO block; CLI entry point (--check-connectivity)
    lock_detector/            real transistor-level lock_detector block layout (issue #296)
      devices.py                 Fet parameter tables, transcribed from design/netlist/lock_detector.spice
      primitives.py               hand-drawn nfet_03v3/pfet_03v3 geometry primitives + net routing
      cells.py                    gate-level macros (inv/nand2/schmitt/xor2/delaywin) built from primitives.py
      build.py                    assembles the full block (or any leaf macro standalone) into a GDS
    pfd_cp/                   the PFD/CP block family (issue #294/#299/#300)
      devgen.py                  reusable device-list -> DRC-clean leaf-cell generator
      pfdcp_inv.py                pfdcp_inv_3v3.sch's device table + CLI entry point
      rowgen.py                   row-style geometry/routing primitives for multi-gate blocks (issue #300)
      pfd_cells.py                 pfdcp_inv_3v3/pfdcp_nand2_3v3 as row-style cells (issue #300)
      pfd.py                       assembles the full mirror-symmetric PFD block; CLI entry point (issue #300)
    divider_chain/            the divider_chain block family (issue #295/#306/#307/#308)
      devgen.py                  reusable device-list -> DRC-clean leaf-cell generator +
                                  composite Metal2/3 routing fabric (issue #308's
                                  draw_column()/route_net()/NetTracks/offset_pad_x())
                                  (reused/generalized from pfd_cp/devgen.py);
                                  build_stack_cell() = single column (#306),
                                  build_row_cell() = fixed-frame row cell with fan-in (#307)
      inv_3v3.py                  inv_3v3.sch's device table + CLI entry point
      tgate_3v3.py                tgate_3v3.sch's device table + CLI entry point
      nand2_3v3.py                nand2_3v3.sch's device table + CLI entry point (issue #307)
      nand3_3v3.py                nand3_3v3.sch's device table + CLI entry point (issue #307)
      nor2_3v3.py                 nor2_3v3.sch's device table + CLI entry point (issue #307)
      inv2x_3v3.py                inv2x_3v3.sch's device table + CLI entry point (issue #307)
      dff_tg_3v3.py                dff_tg_3v3.sch's composite (6x inv_3v3 + 4x tgate_3v3,
                                    20 transistors) + CLI entry point (issue #308)
    loop_filter/              the passive loop filter, standalone (issue #748)
      devices.py                 device table, pinned by the tests to design/netlist/loop_filter.spice
      primitives.py              cap_nmos_03v3_b / MIM-A cap_mim_2f0_m2m3_noshield / plain ppolyf_u generators
      block.py                   2x2 C1 array + R chain + C2, wired; CLI entry point (--check-connectivity)
      netcheck.py                device census + plate-aware connectivity read back from the exported GDS
  evidence/
    inv-tb-proof/            committed proof artifacts (gds, netlist, logs, reports)
    floorplan-skeleton/      block-placement skeleton GDS + DRC report (issue #17)
    vco-layout/              VCO real GDS + DRC reports (issue #293)
                             PROOF.md = ring; PROOF-mirror-buffer.md = mirror + buffer;
                             PROOF-bias-resistors.md = RCG/ROFF/RDEG; PROOF-vtoi-core.md = V-to-I core;
                             PROOF-block.md = the assembled block (all five, wired, one guard ring);
                             PROOF-fold.md = band-mirror row fold + block-level n-well guard ring (issue #324);
                             PROOF-lvs.md = first block-level LVS attempt: reference netlist +
                             net-labelling fix landed, a real pre-existing connectivity defect found
                             and not yet fixed (issue #367);
                             PROOF-368-rootcause.md = that defect root-caused to two per-generator
                             Metal1 design gaps (issue #368);
                             PROOF-372-buffer-fix.md = buffer.py's half of that fix, with the
                             block's first LVS-matching sub-block (lvs-buffer/, issue #372);
                             PROOF-371-ring-fix.md = ring.py's own half (lvs-ring/, issue #371) --
                             both sub-blocks now match their own standalone LVS; the assembled
                             vco_block still mismatches on a separate, pre-existing short
                             (VBP0/VDD_VCO) this record found and scoped out to issue #376
    lock-detector-layout/    lock_detector block GDS + DRC-clean report (issue #296)
    pfdcp-inv-proof/         PFD/CP devgen methodology proof: GDS + DRC/LVS reports (issue #299)
    pfd-layout/              PFD block GDS + DRC-clean report, mirror-symmetric UP/DN chains (issue #300)
    divider-inv-proof/       divider_chain inv_3v3 devgen proof: GDS + DRC/LVS reports (issue #306)
    divider-tgate-proof/     divider_chain tgate_3v3 devgen proof: GDS + DRC/LVS reports (issue #306)
    divider-rowcells-proof/  divider_chain nand2/nand3/nor2/inv2x row cells: per-cell GDS +
                             DRC/LVS reports, one shared PROOF.md (issue #307)
    divider-dff-proof/       divider_chain dff_tg_3v3 composite proof: GDS + DRC/LVS reports (issue #308)
    loop-filter-layout/      loop_filter GDS, DRC (variants D and A) + LVS attempts, connectivity (issue #748);
                             NOT DRC-clean on variant D (1 x MIMTM.3) and not LVS-matched -- see PROOF.md
    work/                    scratch re-run tree (git-ignored)
```

## Why this isn't `klt drc` / a `klt lvs`

CLAUDE.md's PDK line names `klt` (2AMLogic/klayout-tools) as this project's
layout tool. This flow *does* use `klt` — `klt pdk find --pdk gf180mcuD` is
the quickest way to confirm which gf180mcu install and asset paths a
machine will resolve, and it is exactly what `layout/harness/env.py`
delegates to (via `sim/harness/pdk.py`'s single-sourced resolver, so the sim
and layout harnesses can never disagree about which PDK install is in use).

It does **not** use `klt drc` (and there is no `klt lvs`) for the actual
sign-off-grade checks in this flow, for two documented reasons, not an
oversight:

1. **No LVS verb exists in `klt` yet.** Filed and tracked publicly at
   [2AMLogic/klayout-tools#54](https://github.com/2AMLogic/klayout-tools/issues/54)
   ("no netlist/parasitic extraction or LVS capability yet"), which this
   bring-up independently reconfirms (see "Friction log" below).
2. **`klt drc`'s gf180mcu deck is a curated ~10-rule subset** (poly2/comp/
   contact/metal1 width-space-enclosure checks), by design documented in
   `klayout_tools/decks/gf180mcu.py`'s own module docstring as "not a full
   transcription of the official rule manual". `klayout-tools`' own
   ROADMAP.md states competing with signoff tools is a non-goal ("the point
   is the agent-native surface, not competing with signoff tools") — so this
   is not a gap to file, just a scope this flow cannot rely on for a
   DRC/LVS-clean gate.

So the checks that gate this project's layout phase run the PDK's own
official decks (`libs.tech/klayout/{drc,lvs}/run_{drc,lvs}.py`) through the
standalone KLayout application binary — the foundry-authored, full-coverage
DRC/LVS-DSL scripts, not a re-implementation. `klt drc --deck gf180mcu`
remains useful as a fast, dependency-light **pre-check** during layout
iteration (seconds, not minutes) before a full deck run; it is not the gate.

## Prerequisites

| Tool | Why | Notes |
|---|---|---|
| gf180mcu PDK | DRC/LVS decks + standard-cell GDS/CDL | `pip install volare && volare enable --pdk gf180mcu <hash>` — same install `sim/` uses |
| KLayout **application** binary | runs the foundry Ruby DRC/LVS-DSL decks (`klayout -b -r deck.drc`) | **not** the `klayout` pip wheel, which has no DSL runner — see "The two KLayouts" below |
| A Python environment with `klayout` (pip) + `docopt` importable | the PDK's own `run_drc.py`/`run_lvs.py` need them | `python3 -m venv ~/opt/gf180pv-venv && ~/opt/gf180pv-venv/bin/pip install klayout docopt` |
| `klt` (optional but recommended) | fast PDK/asset discovery, and a quick pre-check DRC pass | `pip install klayout-tools` |

The harness never hardcodes any of these three paths. `layout/harness/env.py`
resolves them, in order, with an environment-variable override for each so a
CI runner or a differently-provisioned box never needs a code change:

- **PDK** — delegates entirely to `sim/harness/pdk.py` (`GF180_PDK_PATH` /
  `PDK_ROOT`+`PDK` / `sim/pdk.local.json` / `sim/pdk.json` / built-in search
  roots), so the sim and layout harnesses always agree on which gf180mcu
  install is in use.
- **KLayout binary** — `$KLAYOUT_BIN`, then `PATH`, then common per-platform
  install locations (`~/opt/klayout/...`, `/Applications/KLayout/...`, ...).
- **PV python** — `$LAYOUT_PV_PYTHON`, then the running interpreter, then
  `python3`/`python` on `PATH`, then `~/opt/gf180pv-venv/bin/python` --
  whichever first imports both `klayout` and `docopt` successfully.

```bash
python3 layout/run_pv.py check-env
```

reports all three, or an actionable install hint for whichever is missing.

### macOS: quarantine

A Homebrew-cask KLayout install (`/Applications/KLayout/klayout.app`) carries
a `com.apple.quarantine` extended attribute and is ad-hoc signed. Gatekeeper
does not just refuse it — it makes a headless `klayout -b ...` invocation
**hang** with no error, which looks like a stuck DRC run rather than a
permission problem (observed directly during bring-up: `klayout -v` under
`timeout 30` returned exit 137, i.e. killed by the timeout, only from the
quarantined app; a non-quarantined build of the same binary returns
immediately). Fix: use a KLayout build with no quarantine attribute (built
from source, or `xattr -dr com.apple.quarantine /Applications/KLayout/klayout.app`
once, interactively, after verifying the download), and point
`$KLAYOUT_BIN` at it if it isn't already the first candidate `env.py` tries.

### The two KLayouts

This flow genuinely needs **both** KLayout distributions, for different
jobs, and conflating them is the single easiest way to get stuck:

- The **pip wheel** (`pip install klayout`, imported as `klayout.db`) is a
  headless Python API with no DSL runner. `layout/harness/cell.py` uses it
  to assemble `inv_tb.gds`; `layout/harness/faults.py` uses it to inject
  faults; the PDK's own `run_drc.py`/`run_lvs.py` (the "PV python" above)
  import it too.
- The **standalone application binary** (`klayout -b -r <deck>`) is the only
  thing that can execute the foundry's Ruby DRC/LVS-DSL rule decks. There is
  no way to run a `.drc`/`.lvs` script through the pip wheel.

### KLayout version pin — a newer install can produce a false LVS mismatch

This repository pins `KLayout 0.28.16` — recorded as
`KNOWN_GOOD_KLAYOUT_VERSION` in `layout/harness/env.py`. A **newer** KLayout
application binary resolved off
`PATH` (0.30.9 has been reproduced directly) has been observed to report a
false `LVS mismatch` on a `divider_chain` layout that is otherwise LVS-clean
and unchanged from a previously LVS-clean, evidenced state — while running
DRC on the *same* binary against the *same* GDS came back clean, 0
violations. Whatever changed between these point releases appears specific
to the LVS deck's net extraction/comparison, not general geometry handling
(unverified hypothesis — bisecting the exact point release is out of scope
of this note; see issue #360).

`env.py`'s `find_klayout()` resolves the application binary with no version
pin or check, so this drift is silent by default. `check-env`, `drc`, and
`lvs` all call `PvTools.klayout_version_warning()` and print a `WARNING`
line when the resolved KLayout differs from the pin — non-fatal, and only
printed inline by `drc`/`lvs` when the result itself came back
violations/mismatch (a clean/matching run stays silent). **If you see an
unexpected `LVS mismatch` locally**, run `python3 layout/run_pv.py
check-env` first and check whether the reported KLayout version matches the
pin before concluding the layout itself regressed.

**That warning grades the binary you are about to use — it says nothing
about the logs already committed**, and until 2026-09-28 nothing did. An
earlier revision of this section asserted that *"the committed DRC/LVS
evidence under `layout/evidence/*/` was captured against KLayout 0.28.16"*;
a census run for issue `#127` found **16 of the 51** committed deck logs
were captured on 0.30.9 or 0.30.10, including `vco_block`'s own block-level
DRC-clean and LVS-match logs — the two artifacts T1 items 3 and 4 score the
VCO on. All four blocks' verdicts have since been re-derived on the pin from
the committed GDS and the committed reference netlists, and the surviving
off-pin logs are now enumerated by `layout/lib/check-layout-status-claims.sh`
on every run rather than described in prose. See
[`layout/evidence/vco-layout/PROOF-klayout-pin.md`](evidence/vco-layout/PROOF-klayout-pin.md).

That first pass graded the **four block top cells** and left the VCO's own
sub-cell logs (`vco_ring`, `vco_vtoi_core`, `vco_out_buffer`) off the pin as
a disclosed residual — a disclosure says a gap exists and then grades nothing
about whether it closes. Those five runs were re-derived on the pin (and, for
the two LVS runs, at the ratified `POLY_RES 3k` rather than the PDK runner's
own `1k`) on 2026-09-30, and the check is now **per top cell**: any cell whose
verdicts exist only on some other engine fails the build unless it is named,
with a reason, in the script's `OFF_PIN_TOPCELL_DISCLOSED`. Three cells are
(`cp_leg_n`, `cp_leg_p`, `inv_tb`), none of them a PLL block or the warrant
under one. See that same `PROOF-klayout-pin.md`, Addendum 1.

The same check also grades the sentence above. Every version this file, the
repository README, or `docs/chipalooza/challenge-5-proposal.md` states **as
the pin** must equal `KNOWN_GOOD_KLAYOUT_VERSION`, so bumping the constant in
`env.py` fails the build until the prose follows it — the drift that produced
the retired claim in the first place. Quoting a superseded pin claim, as the
paragraph above does, is deliberately left ungraded: a check cannot tell
asserting a claim from narrating one that was wrong.

### The `pmap` shim (macOS/BSD)

The foundry DRC/LVS decks configure a Ruby logger whose message formatter
unconditionally shells out to `` `pmap #{Process.pid} | tail -1`[10, 40] ``
to prefix every log line with memory usage. macOS/BSD have no `pmap(1)`; the
backtick expansion returns an empty string, `""[10, 40]` is `nil`, and the
deck dies on its very first log line with
`undefined method 'strip' for nil:NilClass` — before evaluating a single
rule, for a reason that has nothing to do with the layout under test. This
was hit verbatim during bring-up. `layout/tools/pmap` is a ~20-line shim
that prints a `ps`-derived RSS in the one format `| tail -1` looks at;
`layout/harness/env.py` puts `layout/tools/` at the front of `PATH` for the
duration of a deck subprocess only. **It must keep its executable bit** —
`git update-index --chmod=+x` if a checkout ever loses it (observed once
during bring-up: an untracked copy landed `-rw-r--r--` and every deck run
failed with `Permission denied` until `chmod +x` was applied).

## The flow

```bash
python3 layout/run_pv.py check-env                     # PDK / KLayout / PV-python present?
python3 layout/run_pv.py build --outdir /tmp/pv         # assemble inv_tb.gds + inv_tb.spice
python3 layout/run_pv.py drc /tmp/pv/inv_tb.gds --top inv_tb --run-dir /tmp/pv/drc
python3 layout/run_pv.py lvs /tmp/pv/inv_tb.gds /tmp/pv/inv_tb.spice --top inv_tb --run-dir /tmp/pv/lvs
python3 layout/run_pv.py prove                          # the full proof, see below
python3 layout/run_pv.py area                           # area audit, see below (no PDK needed)
```

Each of `drc` / `lvs` runs the foundry deck exactly once and prints a
one-line verdict plus an exit code:

| Command | Exit 0 | Exit 1 | Exit 2 |
|---|---|---|---|
| `drc` | clean, 0 violations | violations found | PDK/KLayout/PV-python not found, or the deck itself failed to run |
| `lvs` | netlists match | netlists mismatch | environment problem, or neither verdict marker appeared |

**Reading a result**: `drc` reports a `status` (`clean`/`violations`/`error`),
a `violation_count`, and per-rule counts pulled out of the KLayout report
database (`*.lyrdb`) — not grepped from prose. `lvs` reports `match` /
`mismatch` / `error`. **Neither runner's own exit code is meaningful** — see
"Two exit-code traps" below; the harness always decides the verdict from the
deck's own log marker (`"Klayout DRC run is clean"` / `"...is not clean"`;
`"Congratulations! Netlists match"` / `"Netlists don't match"`).

### Two exit-code traps

Both foundry runners' process exit status is unreliable as a pass/fail
signal, for different (and non-obvious) reasons — discovered directly during
bring-up, which is why `layout/harness/drc.py` and `layout/harness/lvs.py`
never trust it:

- **`run_drc.py`** exits non-zero both when the deck fails to run *and* (in
  this PDK snapshot) on a dirty result — so its exit code alone cannot
  distinguish "ran, found violations" from "crashed before running". The
  harness decides from the log's clean/dirty marker first, falling back to
  the exit code only to catch a run that produced neither marker.
- **`run_lvs.py`** exits **0 on a mismatch**. A naive
  `run_lvs.py ... && echo ok` reports success on a failing LVS. This is the
  more dangerous of the two, because it fails silently in the direction that
  looks like success.

### The substrate-net gotcha (LVS)

Run LVS with `--lvs_sub=VSS` (the harness's default). Without it, the
extractor names the global p-substrate net `gf180mcu_gnd` and exposes it as
an extra top-level pin — so a schematic that (correctly) ties the n-channel
bulk to `VSS` will not match, for a substrate-naming reason that has nothing
to do with whether the circuit is actually correct. `layout/harness/lvs.py`
bakes this default in; override with `--lvs-sub` if a different reference
netlist's convention needs it.

**And the merge is by *exact* name (issue #440).** Passing `--lvs_sub=VSS`
does not wire the substrate to anything; it names the deck's synthesized
global net. That global net then merges into the drawn net whose name
matches it — **exactly**. A drawn ground rail that has somehow collected a
*second* label extracts under the merged name `ENB,VSS`, which is not
`VSS`, so the merge silently does not happen: every n-channel bulk terminal
lands on a net of its own and the block mismatches wholesale, with no error
message anywhere that says "you have a stray label." `pfd_cp`'s first
block-level LVS run failed exactly this way and no other — 84 of 93 nets,
69 of 168 devices, all from eight inherited `ENB` texts sitting on the
ground rail (`layout/evidence/pfd-cp-layout/PROOF.md`, "Addendum 2").

Two rules follow, and both are cheap to hold:

- **The level doing the assembling owns the net names.** A sub-block
  written for its own standalone LVS claim labels its own boundary nets
  with its own *local* port names; `read()` + `top.flatten(-1, True)`
  carries those label shapes into the parent, where the parent may well
  have re-tied that net to something else. Call
  `_canvas.Canvas.clear_inherited_labels()` immediately after the composing
  `flatten()`, before promoting the parent's own pins.
- **Label on the purpose layer that matches the geometry.** 34/10 for a
  Metal1 pad, 36/10 for a Metal2 bus (`connect(metal1_con, metal1_label)` /
  `connect(metal2_con, metal2_label)`). A 34/10 text dropped over Metal2
  attaches to whatever unrelated Metal1 lies under it and names *that* net
  instead — and a text on the drawing datatype (34/0, 36/0) is read by
  nothing at all, so every net so "labelled" extracts anonymous.

## `prove`: the full proof

```bash
python3 layout/run_pv.py prove
```

Builds `inv_tb` fresh, then runs four checks, each against an *expected*
verdict — the last two are the negative controls the issue's test plan
calls for (intentionally introduce one DRC violation and one LVS mismatch,
confirm the flow reports them):

1. `inv_tb` DRC — expected **clean**
2. `inv_tb` LVS (vs. its hand-written reference netlist) — expected **match**
3. `inv_tb` + one undersized Metal1 shape, DRC — expected **violations**
   (`Mn.1`-class width rule)
4. `inv_tb` + its output-net Metal1 island deleted, LVS — expected
   **mismatch** (open output node)

Exit codes: `0` every expectation held; `1` at least one did not (but no
negative control came back clean); `3` a negative control came back
**clean** — treated as a harness fault, not a pass, because a flow that has
only ever been shown reporting *clean* results is not evidence it can catch
a dirty one (see `layout/harness/faults.py`'s module docstring). Unless
`--evidence-dir ''` is passed, `prove` copies the GDS/netlist/report/log
artifacts from all four checks into `layout/evidence/inv-tb-proof/` (see
below); pass a `--work-dir` to control where the scratch run trees
(`main.drc` templates, per-run logs) land — default `layout/evidence/work/`,
git-ignored.

Wall time: dominated by the two full-deck DRC runs, each several minutes
against the ~50-table `main` rule deck (`--no_offgrid` by default — the
off-grid check class is skipped as a separate, slower class of rule this
flow-bring-up proof does not need; pass `--offgrid` to `drc`/`prove` for a
signoff-grade run). LVS is fast (a few seconds) by comparison.

## `area`: where a drawn block's bounding box actually goes

```bash
python3 layout/run_pv.py area                            # print the audit
python3 layout/run_pv.py area --out layout/evidence/area-audit/area-audit.md
```

`layout/harness/area.py` measures every committed block GDS directly: merged
per-layer area, the fill fraction (and therefore the whitespace), which
y-bands contain diffusion and which contain none, the Metal2 horizontal-track
census with the height those tracks would occupy packed solid, and how much
Metal2 is already in use *over* the device rows. It also counts
shared-diffusion candidates in a block's own reference netlist. It needs
**no PDK, no KLayout application binary and no deck** — only the `klayout`
pip wheel — so it runs in CI's headless `checks` job alongside
`layout/tests/`.

Why it exists (issue #442): `layout/floorplan/PLL-FLOORPLAN.md` §5 tracks a
real area overrun, and through §5.4 each revision named the next lever from a
derived ratio (µm²/transistor) rather than a measurement. That ratio cannot
tell "the diffusion islands are too big" from "the diffusion islands are 1 %
of the block and the rest is empty" — and the measurement says the latter.
See `layout/evidence/area-audit/PROOF.md` for every lever's arithmetic and
§5.5 of the floorplan for the re-derived budget. This command measures drawn
geometry; it makes no claim that a transformation it sizes is DRC-legal, which
is what `drc`/`lvs` above are for.

## Does the committed GDS still come out of the generator?

```bash
python3 -m harness.reproduce          # from layout/ -- prints one line per block
python3 -m unittest discover -s layout/tests -t layout/tests -k Reproduc
```

Every DRC/LVS claim in `layout/evidence/` is a claim about a **committed
file**, and nothing in this flow re-derives that file: `run_pv.py` runs a deck
against whatever GDS it is handed, and `layout/lib/check-layout-status-claims.sh`
grades README/proposal prose against the *recorded* verdict. So a generator
could drift arbitrarily far from the artifact carrying its evidence with every
check here still green.

That is not hypothetical (issue #451).
`layout/evidence/lock-detector-layout/lock_detector.gds` was committed once at
#311 and its generator changed seven times over the next fortnight; when it
was finally re-derived, the committed file and the generator's output differed
on **9 of 11 drawing layers**, and the generator's own output failed the
foundry DRC deck with **141 violations** where the committed file was clean.
The block's "DRC-clean" claim was true of the committed file and of nothing
else that existed.

`layout/harness/reproduce.py` closes that: it rebuilds every registered block
by running its own documented regeneration command
(`python3 -m <generator> --outdir <tmp>`) and compares the result against the
committed artifact **layer by layer as merged geometry** (`klayout.db.Region`
XOR, drawing datatypes only). Not byte by byte — a GDS carries a write
timestamp in its own header, so two runs of one unchanged generator are never
byte-identical and a checksum would be a permanently red light.

`layout/tests/test_gds_reproducibility.py` runs it on every test run, and
asserts two things beyond the comparison itself:

- a **negative control** — a deliberately stale artifact (one real GDS plus a
  single 0.1 µm box) must be reported as drift, because a check only ever
  shown reporting clean is not evidence it can report dirty (the same
  discipline `harness/faults.py` applies to the DRC/LVS decks);
- **registry coverage** — every `*.gds` under `layout/evidence/` is either
  registered with a generator or listed in `EXCLUDED` with a stated reason, so
  an unchecked artifact cannot appear by omission.

No PDK, no KLayout application binary, no deck — only the `klayout` pip wheel,
so it runs in CI's headless `checks` job. It says nothing about whether a
block is DRC-clean; it says the file you ran the deck against is the file the
generator produces today.

## The trivial cell (`inv_tb`)

`layout/harness/cell.py` assembles one gf180mcu 9-track standard-cell
inverter (`gf180mcu_fd_sc_mcu9t5v0__clkinv_1`) abutted with the well/tap
cells it needs to stand alone (`endcap | filltie | clkinv_1 | filltie |
endcap`, 5.04 um row), built directly from the installed PDK's own
`libs.ref` GDS (no foundry geometry vendored into this repo). The taps are
not optional set-dressing: `layout/run_pv.py bare-cell` streams the bare
`clkinv_1` cell out on its own and DRCs it, reproducibly reproducing
`DF.13_MV` / `DF.14_MV` violations (NCOMP-in-nwell / PCOMP-outside-nwell too
far from a well/substrate tap) — a bare standard cell is not, and is not
expected to be, DRC clean by itself. The matching LVS reference netlist
(`inv_tb.spice`) is hand-written, deliberately, rather than lifted from the
PDK's CDL: the point of an LVS proof is that an *independently stated*
schematic matches the layout, using the device sizes the cell's own `.cdl`
documents (`nfet_05v0` W=0.73/L=0.6, `pfet_05v0` W=1.83/L=0.5).

## `layout/evidence/inv-tb-proof/`

Committed proof artifacts from the most recent `prove` run — the "flow
proven clean on a trivial cell" acceptance criterion, with a citable trail
rather than only a comment thread:

```
evidence/inv-tb-proof/
  PROOF.md            what was run, tool/PDK provenance, the four checks + verdicts
  inv_tb.gds / .spice           the trivial cell + its reference netlist
  drc-clean/                    clean-run DRC report db + captured deck log
  lvs-clean/                    match-run extracted netlist + LVS db + captured deck log
  drc_fault.gds  drc-fault/     the DRC negative control + its report db + log
  lvs_fault.gds  lvs-fault/     the LVS negative control + its extracted netlist/db + log
```

Re-running `prove` overwrites this directory (it is a proof-of-flow
snapshot, not per-run append-only evidence like `sim/`'s records — there is
one flow to prove, not a family of PVT campaigns) — but do not hand-edit any
file under it; regenerate via `run_pv.py prove` instead so the artifacts and
`PROOF.md` never drift apart.

## Friction log (CLAUDE.md's friction protocol)

Per CLAUDE.md, every `klayout-tools` awkwardness/gap/wrong-behavior
encountered during this bring-up gets filed generically on the public
`2AMLogic/klayout-tools` tracker — tool-gap description only, never design
details, spec values, or this repo's content.

- **No `klt lvs`.** Already tracked publicly:
  [2AMLogic/klayout-tools#54](https://github.com/2AMLogic/klayout-tools/issues/54).
  This bring-up independently reconfirms the gap (an LVS-gating flow has
  nothing to reach for in `klt` today); a confirming comment was added to
  that issue rather than filing a duplicate.
- **`klt drc`'s gf180mcu deck is a curated subset, not a signoff deck.**
  Self-documented already in that deck's own module docstring, and matches
  `klayout-tools`' stated non-goal of competing with signoff tools — not
  filed as a gap, since the project has already scoped this deliberately.
- Everything else chafed against during bring-up (the quarantine hang, the
  `pmap` crash, the two exit-code traps, the substrate-net LVS gotcha) is
  **PDK-native tooling friction** (the gf180mcu open-PDK's own
  `run_drc.py`/`run_lvs.py` and the standalone KLayout application), not a
  `klayout-tools` capability gap — out of scope for that tracker, documented
  here instead.
- **`mos_array`/`diff_pair` have no dog-bone-terminal option for a unit
  device narrower than `UNIT_MIN_W_UM`'s contact-fit floor.** Hit while
  drawing `lock_detector`'s real transistor-level layout (issue #296): one
  schematic device is narrower than that floor by design (a high-resistance
  bias element, not a matched-array unit). `klayout-tools`#322 already
  documented the floor's rationale but scoped a fix to the error message
  only, explicitly deferring "a real use case for narrower-than-contact-fit
  unit devices" as a follow-up trigger — this is that follow-up. Filed as
  [2AMLogic/klayout-tools#1574](https://github.com/2AMLogic/klayout-tools/issues/1574).
  Worked around with a hand-drawn dog-bone S/D terminal (widened contact
  pad, unwidened shoulder against the gate edge, true schematic width under
  the gate) in `layout/pll_top/lock_detector/primitives.py`'s `mosfet()`.
