2AMLogic/gf180-pll/docs/chipalooza/challenge-5-proposal.md

# Chipalooza Challenge #5 (GF180MCU / Wafer.Space) — integer-N PLL proposal

Submission target: Open Circuit Design's Chipalooza Challenge #5 (GF180MCU
test chip fabricated through Wafer.Space), 3.3 V digital / 5.0 V analog rail
structure, same as Challenge #3 unless that challenge's own rules page states
otherwise. This repository has not observed a published, dated submission
deadline for Challenge #5 as of this document's writing — none is asserted
here; the operator submitting this proposal should confirm the current
deadline directly against the challenge's own rules page before emailing it.

**Source repository**: `2AMLogic/gf180-pll` (public, Apache-2.0 — see §8).
Every number in §5 is transcribed from this repository's own append-only
`sim/` evidence, with a dated citation to the record it came from — nothing
here is asserted without a re-runnable testbench, per `CLAUDE.md`'s "no claim
without a testbench."

This document is written to be emailed verbatim as the block's public
proposal. It contains no personal or institutional identifiers; a designer
CV and a test-equipment list, if needed, are separate attachments the
submitting operator supplies outside this repository.

**Maturity note, stated up front rather than left for a reader to discover.**
This repository is, at the time of writing, **schematic-complete and at a
first assembled top level**: each PLL sub-block's drawn, DRC-clean and
LVS-matched state is the generated table in `layout/STATUS.md`,
and the assembled `pll_top` GDS is committed but is not signoff — one
inherited DRC violation, top-level LVS still to run, area over the ratified
row (§6). Every §5 number is therefore a *schematic-level* simulation result:
extracted-netlist re-verification of that top level is still to be run.
This proposal documents the block honestly at that maturity: §5's
target-specification table reports what the schematic-level `sim/` evidence
shows, marks every row met or unmet against `spec/pll.md` (**ratified with
amendments** on 2026-09-08 via #1, with two rows explicitly carved out and
still unratified — see §5.0), and does not assume or forward-cite work that
has not happened. Top-level DRC/LVS closure and post-layout
re-verification are open items (§7), each tracked by its own
issue in this repository, not silently implied by this document's existence.

---

## 1. Type of IP block

An integer-N, ring-oscillator, Type-II charge-pump phase-locked loop:
current-starved 5-stage ring VCO (8 overlapping geometric bands), a
phase-frequency detector and charge pump, a fixed passive R–C loop filter
with a 2-bit charge-pump current trim, a cascaded ÷2/3 feedback divider
(integer N = 4–64), and a digital phase-window lock detector. Architecture is
captured in
[`spec/decision-records/DR-001-pll-architecture.md`](../../spec/decision-records/DR-001-pll-architecture.md).
That record is **ratified** (2026-09-08, #1), as are DR-002, DR-003, DR-005,
DR-006 and DR-007. The other records stay `proposed` until they pass their
own ratification: DR-004/008/009/012 because they are not on
`spec/pll.md`'s `Consumes:` line (DR-004 and DR-008 predate the
ratification; DR-009 and DR-012 were created after it), and DR-010 onward
because they were created after that date — see
[`spec/README.md`](../../spec/README.md) for the convention. The target
specification those records feed, [`spec/pll.md`](../../spec/pll.md), is
itself **ratified, with amendments** (#1, closed 2026-09-08), and §5's
verdicts are stated against that ratified table. See §5.0 for the two rows the
ratification explicitly carved out.

---

## 2. I/O list, including test ports

### 2.1 Rails: this design is 3.3 V-only and does not yet exercise the Challenge's 5.0 V rail

Per [`spec/pll.md`](../../spec/pll.md)'s "Supply range" row (target #18), this
block is built **exclusively** on gf180mcu's 3.3 V thick-oxide devices
(`nfet_03v3`/`pfet_03v3`) — DR-002 Decision 3 explicitly rejects a dual-flavor
design, and the 1.8 V core variant is deferred past v1. **No 5.0 V-class
device (`nfet_06v0`/`pfet_06v0`) appears anywhere in `design/`.** This is the
single most load-bearing disclosure in this proposal: the Challenge #5 brief
asks that "analog blocks should operate across 3.3–5.0 V," and this design,
as it exists today, does not — it would need a design extension (most
plausibly, an on-die 5.0 V→3.3 V regulation stage, or simply leaving the
analog 5.0 V rail unconnected and drawing every domain from the digital
3.3 V rail with the harness's approval) before it exercises that rail at all.
Nothing in §5 reports a measurement above 3.63 V, and no row in §5 is stated
as "met" against a 5.0 V condition it was never run at.

### 2.2 Pad table, mapped to the Challenge #5 slot budget

`design/pll_top.sch`'s exported port list
(`design/netlist/pll_top.spice`, `.subckt pll_top REF B0 B1 B2 CPB0 CPB1 LDT0
LDT1 LDT2 LDT3 P0 P1 P2 P3 P4 P5 SEL0 SEL1 SEL2 SEL3 SEL4 SEL5 IBN ICN IBP
ICP CLK DIVOUT FB LOCK VCTRL + VDD VDD_VCO GND_VCO VDD_DIV VSS`) is the port
list this table maps, unedited, onto the Challenge #5 budget as this
repository understands it: one bandgap-referenced bias voltage, up to 2
bandgap-referenced current sources, up to 24 digital control inputs, up to 12
digital test outputs, up to 4 shared analog lines, up to 4 dedicated pads, SPI
control documented in the harness, and no transcribed line at all for
supply/ground pads. **That budget is transcribed here, not authored here** —
the challenge's own rules page is the authority, and the submitting operator
should confirm these slot counts against it in the same pass that confirms the
deadline (see this document's opening note). The rail line is written as an
*absence* rather than left out, because it is load-bearing: this block asks for
**five** supply/ground pads, and the table's own rail rows are what forbid
sharing them down — `VDD_VCO`/`GND_VCO` "must not be tied to the same physical
rail node as `VDD`", and `VDD_DIV` is "kept separate from the other two for the
same reason". A harness that budgets rails per block therefore has to be told
that number, and until this revision the totals paragraph below did not state
it at all.

| Signal(s) | Dir | Challenge slot | Count used | Notes |
|---|---|---|---|---|
| `VDD`, `VSS` | supply | supply/ground pad — 3.3 V digital rail | — (rail) | PFD, charge pump, `cp_dumpbuf`, lock detector domain (`vdd_ref` in `spec/pll.md`'s naming) |
| `VDD_VCO`, `GND_VCO` | supply | supply/ground pad — 3.3 V digital rail (proposed, see §2.1) | — (rail) | VCO bias/ring/output-buffer domain, kept electrically separate from `VDD`/`VSS` by design (DR-001 Decisions 2–3) specifically so ring switching noise does not couple into the reference domain; **must not be tied to the same physical rail node as `VDD` on the harness board**, even though both are proposed at 3.3 V |
| `VDD_DIV` | supply | supply/ground pad — 3.3 V digital rail (proposed, see §2.1) | — (rail) | ÷2/3 chain, output mux, retiming flop domain — kept separate from the other two for the same reason |
| `REF` | in | digital control input (budget ≤ 24) | 1 of 24 | Reference clock, CMOS square wave, rising-edge triggered, 1–25 MHz (`spec/pll.md#reference-input`); duty cycle 30–70 % (only pulse-width margin, not sampled phase, is duty-sensitive — the PFD's edge detectors fire on the rising edge only) |
| `B0`, `B1`, `B2` | in | digital control input | 3 of 24 | VCO band select (3-bit, 8 bands). **Static configuration only** — no on-chip auto-calibration FSM exists (DR-001 Decision 2); a system must apply the [band-selection rule](../../spec/pll.md#band-selection-rule) itself |
| `CPB0`, `CPB1` | in | digital control input | 2 of 24 | Charge-pump current trim (2-bit, 4 codes). **Not discretionary** — required to be set from `f_ref` per the [Icp trim-code rule](../../spec/pll.md#icp-trim-code-rule) |
| `LDT0`…`LDT3` | in | digital control input | 4 of 24 | Lock-detector window trim (4-bit, 16 codes). **Not discretionary** — required to be set once per part at test, from that part's own measured comparator-window delay, per the normative [Lock-detector window trim-code rule](../../spec/pll.md#lock-detector-window-trim-code-rule) (DR-014, DR-015). Same static-configuration idiom as `CPB0`/`CPB1`; nominal/unprogrammed code is 1000 (8) |
| `P0`…`P5`, `SEL0`…`SEL5` | in | digital control input | 12 of 24 | Feedback-divider configuration: `P5..P0` is each ÷2/3 cell's per-cycle mode; `SEL5..SEL0` is a one-hot chain-length code. Together they set `N = 2^k + Σ P_j·2^j (j<k)` for one-hot `SEL_(k-1)=1`, covering the ratified N = 4–64 range. Static configuration; the loop re-locks after any change (no glitch-free on-the-fly modulus switching, DR-001 Decision 3) |
| `IBN`, `ICN`, `IBP`, `ICP` | in | **does not fit the ≤ 2 bandgap-referenced current-source budget — open item, see §7** | 4 requested vs. 2 offered | Charge-pump / bias-mirror reference currents. **Every closed-loop `sim/` record in this repository drives these from ideal current sources at 4× the unit-leg current** — the bias generator that would derive them from a single bandgap-referenced current is "a separate, unbuilt block" (quoted verbatim from the Limitations field of `sim/pll-top-smoke/records/20260802-160926-8456ff3.md` and of `sim/supply-sensitivity/records/20260901-155456-46b92f8.md`; the lock-time, output-range, period-jitter and reference-spur records drive the same ideal sources without restating why — an earlier revision attributed the phrase to all of them, which `sim/lib/check-bias-drive-claims.sh` now fails). This is not a Challenge-specific gap invented for this proposal; it is a standing, disclosed limitation of the design today |
| `VCTRL` | analog, iopin | shared analog line (budget ≤ 4) | 1 of 4 | Loop-filter control voltage — a slow-moving DC/low-frequency analog test point, well suited to a multiplexed line. Usable window 0.9–2.7 V (DR-003 Decision 5) |
| `CLK` | out, dedicated | dedicated pad (budget ≤ 4) | 1 of 4 | PLL output clock, 10–200 MHz across the 8 bands (per-operating-point band selection; DR-038). **Needs a low-resistance, dedicated path** — a shared-mux line's added series resistance and capacitance would degrade the measured edge rates and duty cycle (`spec/pll.md#output-duty-cycle`, `#output-levels-and-drive`) directly |
| `LOCK` | out | digital test output (budget ≤ 12) | 1 of 12 | Digital lock-status flag from the phase-window comparator (DR-002 Decision 4). See §5's Lock detector row for the two disclosed gaps in this signal's own assert/deassert behavior — it is a real, measured signal, not an idealized one |
| `DIVOUT`, `FB` | out | digital test output (budget ≤ 12) | 2 of 12 (proposed) | Divider-chain diagnostic taps: `DIVOUT` is the one-hot-muxed chain output before retiming, `FB` is the retimed signal actually fed back to the PFD. Exposing both as test outputs (rather than only `FB`) lets a bench test independently check the divider's raw ratio against the retiming flop's contribution — proposed, not load-bearing; a minimal test plan could omit `DIVOUT` |

**Totals against the Challenge #5 budget**: 0 of 1 bandgap-referenced bias
voltage (this block draws no bandgap reference of its own — see the `IBN`/
`ICN`/`IBP`/`ICP` row), **4 requested vs. 2 offered** bandgap-referenced
current sources (open item, §7), 22 of ≤ 24 digital control inputs (18 without
the lock-detector trim; `LDT0`–`LDT3` add 4, leaving 2 slots of headroom — see
DR-015), 1–3 of ≤ 12 digital test outputs (`LOCK` alone, or `LOCK`+`DIVOUT`+`FB`),
1 of ≤ 4 dedicated pads, 1 of ≤ 4 shared analog lines, 5 supply/ground pads
(`VDD`, `VDD_VCO`, `VDD_DIV`, `VSS`, `GND_VCO` — three supplies the rail rows
above require be *distinct nodes* rather than one rail fanned out on the board,
plus two grounds, which §4's step 1 ties at a single low-impedance reference
off-die). Every *budgeted* category **except the
current-source count** fits inside budget with real headroom; the
current-source mismatch is the one place this design does not fit the
harness as specified, and it is stated as such rather than glossed over.

**The rails are the one line with no budget to fit inside**: the transcribed
budget above has no slot count for them, so five is a *request* — and until
this revision it was not even that, because the totals paragraph claimed to
cover every category while silently omitting the five pads without which
nothing on this die powers up. The submitting operator should confirm what the
harness offers for rails in the same pass that confirms the slot counts and the
deadline.

**Every number in that paragraph is the sum of the rows above it**,
machine-checked rather than maintained by hand:
`design/lib/check-io-list-coverage.sh` fails this repository's CI if a
category's total stops matching the pad rows carrying that slot, if a pad row's
slot is one the transcribed budget does not name, if a category the budget
names has no total, or if a "K of M" count quotes a budget M the transcription
does not have. That last class of drift is not hypothetical — this paragraph
read 18 of 24 digital control inputs against a real 22 for three days (issue
#441, DR-015), because a total is the cheapest thing in a document to leave
behind when the rows above it change.

### 2.3 What's dropped, multiplexed, substituted, or new relative to this repo's own port list

- **Nothing in `design/pll_top.sch`'s port list is dropped.** Every pin the
  schematic exposes is mapped to a slot above.
- **No pin is proposed as new** relative to the schematic — `DIVOUT` and `FB`
  are both already top-level pins of the committed design, simply optional
  as *test* outputs versus load-bearing feedback. **`LDT0`–`LDT3` are the
  same case, not a third one**: they are neither dropped nor newly added
  relative to this repo's own port list — they already exist as top-level
  `pll_top` ports (PR #418, commit `bfde9893`), mapped above in the exact
  same static-configuration-input idiom `CPB0`/`CPB1` already use (see
  DR-015).
- **`SPI control` does not apply.** This block has no addressable
  configuration register — its 21 configuration bits (`B0..B2`, `CPB0..1`,
  `LDT0..3`, `P0..5`, `SEL0..5`) are static levels, not an SPI-programmed
  state, and nothing in `design/` implies an SPI interface. A harness wrapper
  that drives these 21 lines from its own SPI-to-parallel shift register
  (rather than 21 dedicated harness pins) is a harness-side integration
  detail, not a change to this proposal's I/O list. (`REF`, the reference
  clock, is deliberately excluded from this count — it is a continuously
  toggling signal, not a static configuration level — which is why this
  count is one less than §2.2's "22 of ≤ 24 digital control inputs" total.
  The prior revision of this sentence read "18 configuration bits" for the
  17-bit set that existed before `LDT0`–`LDT3` were pins at all — an
  off-by-one that predates this change and is corrected here alongside the
  `LDT0`–`LDT3` addition.) That arithmetic is now machine-checked too:
  `design/lib/check-io-list-coverage.sh` expands the bus list in this
  sentence and fails if the stated count disagrees with what it expands to, if
  a bit named here has no pad row in §2.2, if those rows span more than one
  Challenge slot, or if a pin sharing their slot is dropped from this count
  without being named in this bullet as excluded — which is the only reason
  `REF` may be missing from it.
- **The 4-vs-2 current-source shortfall (§2.2) is the one real gap.** Closing
  it needs a bias-generator sub-block this repository has never designed —
  either a real bandgap-referenced current mirror producing all four
  polarities/magnitudes on-die from the harness's ≤ 2 supplied currents, or
  a negotiated harness accommodation. Neither exists today; see §7.

---

## 3. Functional description

`REF` (1–25 MHz CMOS) and the divider's feedback edge (`FB`) drive a
phase-frequency detector (`design/pfd.sch`) whose UP/DN outputs steer a
charge pump (`design/cp.sch`) into a fixed passive R–C loop filter
(`design/loop_filter.sch`, R ≈ 77 kΩ / C1 ≈ 121 pF / C2 ≈ 2.0 pF at typical
27 °C), producing the control voltage `VCTRL` that sets the frequency of a
5-stage current-starved ring VCO (`design/vco.sch`) across 8 overlapping
geometric bands (`B0`–`B2`) spanning 10–200 MHz at v1. The VCO's output
(`CLK`, buffered through a tapered three-stage inverter chain) also drives a
cascaded ÷2/3 feedback-divider chain (`design/divider_chain.sch`, six
identical ÷2/3 cells plus a one-hot output mux and a VCO-clocked retiming
flop) that divides the output down to `FB`, closing the loop at the
configured integer ratio N = 4–64. A digital lock detector
(`design/lock_detector.sch`) monitors the PFD's UP/DN outputs through a
phase-error window comparator and asserts `LOCK` once the error has stayed
inside a fixed window continuously long enough to charge a Schmitt-triggered
integrating node — a passive monitor, not a self-calibration mechanism. The
charge-pump current trim (`CPB0`/`CPB1`) is a required, not discretionary,
configuration input: because the loop filter is a single fixed passive
network, the trim is what lets one filter cover the full 25:1 reference-
frequency range while holding ≥ 45° phase margin (the [Icp trim-code
rule](../../spec/pll.md#icp-trim-code-rule)).

The complete top-level assembly (`design/pll_top.sch`) is verified, at one
nominal corner, to acquire and hold lock from a real frequency error
(`sim/pll-top-smoke/records/20260802-160926-8456ff3.md`, all 7 checks PASS).
Most of the circuitry described above also exists as drawn geometry: **the four
PLL sub-blocks** the layout effort partitions this design into — VCO,
PFD + charge pump, divider chain, lock detector — each have a block GDS whose
drawn, DRC-clean and LVS-matched state is the generated table in `layout/STATUS.md`. The passive loop filter is drawn as well (issue #748), and
all five are assembled into one `pll_top` GDS (issue #297) that is not yet
signoff-clean; §5's area row still quotes the loop filter as computed from
its sized devices. §6 gives the per-block table, the evidence paths, and
what is still open.

---

## 4. Bench test plan

All measurements below use only the pads in §2.2 — `REF`, `B0..B2`,
`CPB0..1`, `LDT0..3`, `P0..5`/`SEL0..5`, the four bias-reference currents
`IBN`/`ICN`/`IBP`/`ICP`, `CLK`, `LOCK`, and (optionally) `DIVOUT`/`FB`; none
require the Challenge's shared analog mux beyond `VCTRL`. **Every pin §2.2
maps is named by some step below**, which is a CI-enforced property of this
document rather than a claim (`design/lib/check-io-list-coverage.sh`) — an
earlier revision of this plan silently omitted both the bias references and
the lock-detector trim, and neither omission is one a bench operator could
work around from the rest of the text.

1. **Bring-up / DC sanity.** Power `VDD`, `VDD_VCO`, `VDD_DIV` (all proposed
   at the Challenge's 3.3 V digital rail, §2.1) with `VSS`/`GND_VCO` tied at
   a single low-impedance ground reference. **Supply the four charge-pump /
   bias-mirror reference currents from external sources before anything else
   is expected to work**: `IBN` and `ICN` are sourced *into* the die from the
   supply side, `IBP` and `ICP` are sunk *out of* the die to `VSS`, each at
   the 8 µA every closed-loop record in this repository drives them with
   (`.param iunit=8u` in the decks of `sim/period-jitter`,
   `sim/reference-spur`, `sim/supply-sensitivity`, `sim/pll-top-smoke` and
   `sim/output-range`; `IUNIT=8u` in `sim/lock-time/testbench/run.sh`, which
   passes it to a deck that sets no value of its own; the polarity is those
   decks' own `iibn vdd ibn` / `iibp ibp 0`). Current, setting sites and polarity are all
   machine-checked against the committed decks
   (`sim/lib/check-bias-drive-claims.sh`) — an earlier revision of this step
   sent the reader to a `.param` line `tb_lock_time.sp` does not contain.
   There is no bias generator on
   this die — §2.2's 4-requested-vs-2-offered row and §7 item 6 are that
   same fact stated against the Challenge's budget — so with these four pins
   unconnected the charge pump passes no current and **no step below
   functions at all**. Confirm `VCTRL` sits inside its 0.9–2.7 V usable
   window at a chosen static `B0..B2` code with no `REF` applied.
2. **Open-loop VCO characterization.** With the loop broken (or `REF` held
   static so the PFD does not drive the charge pump), sweep `VCTRL` from an
   external source across each of the 8 band codes and measure `CLK`'s
   frequency, confirming each band's range and Kvco against
   `spec/pll.md#kvco`'s per-band table.
3. **Divider ratio check.** Drive `FB`/`DIVOUT` from a known `CLK`-rate input
   (or observe them directly with the loop closed) and confirm the measured
   ratio matches the programmed `P0..5`/`SEL0..5` code, across the N = 4–64
   range.
4. **Program the lock-detector window trim — before any step that reads
   `LOCK`.** `LDT3:LDT0` is not a margin knob: `spec/pll.md`'s normative
   [Lock-detector window trim-code rule](../../spec/pll.md#lock-detector-window-trim-code-rule)
   (DR-014, sized by #411) requires the 4-bit code to be set **once per part
   at test** from that part's own measured comparator-window delay, and
   states in terms that **a part left untrimmed is outside this
   specification** — measured over all sixteen codes, the window's PVT spread
   at any one fixed code is 1.977…1.988× against a band only 2× wide, and
   neither of the two codes that come closest holds it (code 6 falls to
   0.9746 ns, code 7 reaches 2.0029 ns). A part powered up at the
   unprogrammed nominal code 1000 (8) and measured against §5's Lock detector
   row would therefore read as a failure it is not.

   The rule's own measurand is `t_win`, the `ERR → ERRD` propagation delay of
   the `delaywin_3v3` cell at 27 °C and 3.30 V, programmed to the code whose
   `t_win` is nearest 1.343 ns in the logarithmic sense. **`ERR` and `ERRD`
   are internal nodes with no pad in §2.2's list, and this proposal states no
   pad-referred procedure for selecting the code because there is not one** —
   which is now a measured finding rather than an unexamined gap. **DR-022**
   (#501) derives how accurate a substitute would have to be and then measures
   every candidate the pad list offers against the cell's own sixteen-code
   window map over the full 13-bundle, 117-point PVT grid
   (`sim/lock-window-proxy/records/20260925-050022-6d57802.md`):

   - **Reading `CLK`'s free-running frequency is worse than not trimming at
     all** — 2.434× window spread against 1.984× for an untrimmed part, out of
     the ratified band at both edges. The starved ring is biased through poly
     resistors, so a resistor-only process skew moves its period ∓27 % while
     the all-MOS delay chain does not move at all; and across the MOS axis the
     ring's sign is inverted, running *faster* at the corner where the window
     is *slower*.
   - **The best candidate is the `CLK`→`DIVOUT` pad-to-pad skew**, and it is
     still not sufficient: it holds the ratified [1, 2] ns band at all 117
     points, but at a 1.697× spread against DR-013 Decision 4's ≤ 1.65 ×, with
     a worst code error of +4 — so its band-holding is a property of which
     thirteen bundles the grid contains, not a bound. It is recorded as a
     **characterization aid, not a trim procedure**.

   **What a bench operator should therefore do**, stated as the posture rather
   than as a procedure this proposal cannot substantiate: set `LDT3:LDT0` to a
   deliberate, recorded value; treat that code as a property of every `LOCK`
   measurement taken from the part and report it alongside the result; and do
   not read §5's Lock detector row as met by a part whose code was chosen by
   any means other than the ratified rule. **Two things a reader must not
   miss.** The code space is complete but the *selection* is not: `pll_top`
   used to leave `LDT3` unconnected (**#515**), so only 8 of the 16 codes
   were reachable on the assembled part and the rule's own code 11 was not
   among them — **DR-026** has since connected it, and all 16 codes are
   reachable. And the one route that could have closed the selection gap
   without a design change — a symmetric `REF` phase-step bisection read at
   `LOCK` — has now been measured and **does not work**: **DR-029** (#527,
   closed) finds that the threshold in Δ is not the flag window but the
   window plus an additive time set by the detector's integrator and the
   loop's own bandwidth, **+55.5 %** at the rule's own reference condition,
   worth **−12.6 codes** of selection error on a 16-code trim. **Steps 5 and
   8 below are not valid on an untrimmed part, and no step below discharges
   the trim rule.**
5. **Closed-loop lock acquisition and lock time.** Apply `REF` at a chosen
   frequency with the matching `B0..B2` (band-selection rule) and `CPB0..1`
   (Icp trim-code rule) codes, release the loop from a cold start, and
   measure the time to `LOCK` assertion and to the output frequency settling
   to within the target tolerance. Compare against
   `spec/pll.md#lock-time`'s small-signal 71 µs / 43 µs-floor figures and
   against this proposal's own §5 disclosure that the closed-loop cold-start
   PVT grid has not yet demonstrated a sustained in-window PASS at most
   simulated corners.
6. **Output band, duty cycle, and levels.** Sweep every band code across the
   available supply/temperature range on the daughterboard (environmental
   chamber or temperature-controlled socket) and compare `CLK`'s frequency
   range, duty cycle, and levels against `spec/pll.md`'s Output band,
   Output duty cycle, and Output levels and drive rows.
7. **Reference spur and jitter.** With the loop locked, capture `CLK`'s
   spectrum and measure the ±`f_ref` sideband level against the −55 dBc
   target (`spec/pll.md#reference-spur`); measure period jitter directly on
   a scope/TIA against the 1.0 % RMS draft target
   (`spec/pll.md#period-jitter`) — this bench measurement would be the first
   *closed-loop, full-PVT* period-jitter data point this design has, since
   `sim/period-jitter`'s own evidence today covers the full mandated 45-point
   PVT matrix but its deterministic component only, all at band 6 / 150 MHz
   (§5, §7). Measuring at the 200 MHz top of the band is therefore of
   particular interest on silicon: no simulation in this repository bounds
   closed-loop jitter there.
8. **Lock detector window and chatter — at a recorded trim code, which is not
   the same as a trimmed part.** With `LDT3:LDT0` set to the deliberate value
   step 4 requires, perturb the loop (a small `REF` frequency step) and
   observe `LOCK`'s deassert/reassert behavior against
   `spec/pll.md#lock-detector`'s targets, particularly near the bottom of
   the 1–25 MHz reference range where the design's own evidence flags T4/T5
   as unverified. Record the part's trim code with the result: §5's T1′/T2′
   verdict is conditional on the trim rule, so a window measured at some
   other code is not a measurement against that row — and per DR-022 no
   procedure available at these pads selects the rule's code, so **this step
   produces a characterization of the part at a known code, not a T1′/T2′
   verdict.** A related observation is worth taking while the board is set
   up, provided it is read for what it is: step `REF`'s phase by a known ±Δ
   and bisect the Δ at which `LOCK` drops, in both directions. **That
   bisection does not measure the window.** DR-029 (#527, closed)
   characterized exactly this procedure in simulation and returned a negative
   result: the threshold in Δ is the window plus an additive time set by the
   detector's integrator, its trigger threshold, the discharge device and the
   loop's bandwidth — none of them the delay chain the trim moves — so no
   fixed factor removes it. What the bench can usefully confirm is the half
   that came back clean: the deassert is observable at the `LOCK` pad
   promptly and unambiguously, one to two reference periods after the step
   rather than at the nanosecond scale `spec/pll.md`'s large-signal 5.63 ns
   figure would suggest.
9. **Repeat across the daughterboard's available supply/temperature range**
   and record any deviation from §5's simulated PVT grid as a genuine
   silicon finding requiring a new, dated `sim/` record — not folded
   silently into this document, per this repository's evidence-trail
   convention.

---

## 5. Target specification at the Challenge #5 rails (3.3 V; the 5.0 V rail is unexplored)

### 5.0 Citation convention and ratification status

Every row below cites a specific, dated `sim/` record from this repository.
**`spec/pll.md` is status "ratified, with amendments" (issue #1, closed
2026-09-08)** — ratified through this repository's ratification-via-PR
policy, with **two rows explicitly carved out and still unratified** per
DR-007 Amendment A1: [Lock time](../../spec/pll.md#lock-time) (row 9) and
[Lock detector](../../spec/pll.md#lock-detector) (row 16). Row 16's original
T1′/T2′ contradiction has since been resolved (#411 trims the comparator
window; see that row below), but the carve-out stands because T4/T5 remain
uncharacterized below 25 MHz and the row now also rests on a normative trim
rule. Rows marked MET/UNMET below are stated against the ratified targets
except those two, which are stated against the draft and say so. This table
re-derives
min/typ/max directly from the underlying `sim/` evidence rather than treating
`spec/pll.md`'s own summary table as settled, and flags, row by row, where
newer full-PVT-grid closed-loop evidence postdates and updates what
`spec/pll.md`'s own table cites. All evidence is **schematic-level**:
extraction of the assembled top level's parasitics is still ahead (§6, §7);
everything is at the 3.3 V digital rail only,
since no 5.0 V device exists in this design (§2.1).

**This table is complete against `spec/pll.md`, and that completeness is
machine-checked rather than asserted.** Every row of that specification's
summary table appears below with an explicit verdict —
`spec/lib/check-spec-row-coverage.sh` fails this repository's CI if one does
not, and if a row is reported here under a parameter name the specification
does not have. The check was written because one row was missing: **Reference
input** had no row here at all until 2026-09-24, so its unmeasured `budget`
limits and the ideal-reference exclusion every jitter and spur number below
rests on reached no reader of this document. A row this table cannot
substantiate is reported UNMET; it is not left out.

The same check also requires that **every decision record a specification row
rests on is named by the row reporting it here**, because a row can be
present and still report a reading the specification has moved past. Three
were: until 2026-09-25 the Lock time row read a bare MET without DR-012 (the
Lock criterion it is timed to is not reached at 1 of the 45 mandated corners
at a rule-compliant configuration, with a second owed — DR-012 as since
narrowed by DR-025), the Area
row still described the re-amendment trigger DR-017 replaced, and the
Reference spur row carried neither DR-018's re-priced margin nor any owner
for its unmeasured points.

**Which PVT grid a row was measured on is stated, not assumed.** Most rows
below are stated against this repository's **45-point mandated grid** — the
five MOS bundles (`typical`/`ff`/`ss`/`fs`/`sf`) × three temperatures
(−40/27/125 °C) × three supplies (2.97/3.30/3.63 V), as
`sim/harness/corners.py` defines it. **Eleven rows are not**, and each of them
now says so in its own cell. Nine are measured on a different corner universe:

- **Output band**, **Period jitter (open-loop sensitivity)**, **Power**,
  **Kvco**, and the **Supply sensitivity — AC (ripple) budget** row derived
  from the second of those, all come from the `vco-tuning-range` campaign,
  which runs a **63-point PVT grid** — seven bundles, adding `all-slow` and
  `all-fast`, the two combined bundles that skew every device family together
  (passives included) rather than MOS alone. That is a *superset* of the
  mandated grid, so those worst cases are taken over a wider corner universe,
  and the first four each bind at an `all-slow`/`all-fast` corner the mandated
  grid does not contain.
- **Lock detector** rests on a **13-bundle, 117-point** grid — those seven
  bundles plus the six passive-only ones (`res_ff`/`res_ss`,
  `moscap_ff`/`moscap_ss`, `mimcap_ff`/`mimcap_ss`) — shared by all three
  campaigns that row cites. Unlike `vco-tuning-range`'s, this superset moves
  no number it reports, and the row states why rather than leaving the reader
  to assume it either way.
- **Loop bandwidth**, **Phase margin** and **Lock time (small-signal
  settling)** are measured on **no MOS grid at all**, because their DUT has no
  MOS device in it. `loop-dynamics` sweeps the passive loop filter over **81
  filter-impedance points** — 27 passive-corner bundles (`res` × `moscap` ×
  `mimcap`, each `typical`/`ff`/`ss`) × three temperatures — and declares the
  MOS and supply axes N/A, folding the active devices' spread in as *measured
  extremes* rather than re-simulating them: Icp from `cp-compliance`'s own 45
  PVT corners, Kvco from `vco-tuning-range`'s 63. That is a wider envelope
  than the mandated grid on the axis that sets loop stability, not a narrower
  one, but it is not the mandated grid and this table should not have implied
  it was.

The other two are sampled rather than gridded: **Multiplication ratio**'s 235
points are a deliberately non-rectangular sample of a 61 × 45 cross-product
(see that row), and **Reference spur**'s 5 points are a declared subset of the
45, which that row already said.

Until 2026-09-25 this table said almost none of that. Four rows quoted a
corner a reader could not place, in a column whose every other row meant "of
45"; that was fixed the same day, and fixing it left behind every case a
quoted corner does not reveal. A row can rest entirely on a 13-bundle
campaign and still look clean by quoting two of that campaign's MOS corners,
which is exactly what the Lock detector row did.
`sim/lib/check-pvt-coverage-claims.sh` now fails this
repository's CI if a row quotes a corner outside the mandated grid **or rests
on a record measured outside it** without naming the grid it came from, if a
row names a process bundle `sim/harness/corners.py` does not define, or if a
PVT corner count in a row is neither the mandated grid size nor a count the
cited record's committed per-corner evidence produces.

Since 2026-09-25 it also grades the **converse** claim — a row asserting it
covers the *whole* mandated grid ("Full 45-point PVT grid", "All 45 of the
mandated PVT points", "45/45") must cite records whose committed per-corner
evidence, taken in **union**, contains every one of those 45 points. That is a
point-by-point test rather than a count: 45 measured points that are not *the*
45 fail it, while a grid completed across several partial records passes — the
closed-loop period-jitter row below reached the mandated 45 across five
records covering 1, 4, 8, 18 and 16 points, none of them the grid on its own.
The rule was needed because "of 45" is a legitimate thing for a partly-measured
row to say (**Reference spur**'s "5 of 45 PVT points measured, not the full
grid" is honest and stays legal), so the count rule has to allow 45
unconditionally — leaving the strongest claim a row can make, *I measured all
of it*, as the one claim nothing verified. Thirteen rows across this document
and `sim/CHARACTERIZATION.md` make a full-coverage claim; twelve were already
backed point for point, and the thirteenth — `sim/CHARACTERIZATION.md`'s
Verification-owed cross-reference for period jitter — cited campaign
directories instead of records and now names the five its 45 points come from.

The mandated grid is
computed from the harness, not written into the check, so widening the
temperature or supply axis moves what CI enforces in the same commit. Two
more bullets above were, until **#516**, stated here on a hand check rather
than a machine one — `loop-dynamics`' non-MOS corner axis and
`divider-ratio-chain`'s non-rectangular sample. Both are now read from the
committed record rather than trusted: `sim/lib/check-pvt-coverage-claims.sh`
fails if a row restating `loop-dynamics`' "81 filter-impedance points (27
passive-corner bundles x 3 temperatures)" declaration — in full or as a bare
"81-point" echo — disagrees with the record's own sentence, and fails if a
row's restatement of `divider-ratio-chain`'s "235 points run of the 2835"
declaration, or its "61 distinct N" claim, disagrees with the record's own
declared total or the distinct divide-ratio values its committed
`corners/<record-id>/` file names actually carry. `sim/README.md`'s Summary
record format section ratifies the two sentence shapes this reads.

| Parameter | v1 draft target | Measured / derived (3.3 V) | Verdict | Source (dated) |
|---|---|---|---|---|
| Output band | static-code ceiling 166 MHz — one static band code held across the PVT box reaches up to 166 MHz, with gaps below it where the code must be re-selected (12.5–14.5, 21.0–24.4, 34.0–43.7, 57.2–75.7, 94.4–133.4 MHz); 10–200 MHz only as a per-operating-point envelope (DR-038, **proposed** — pending two-key ratification; the ratified wording is 10–200 MHz continuous) | Floor 6.449 MHz (`all-fast`/125 °C/2.97 V); ceiling 247.8 MHz (`all-slow`/−40 °C/3.63 V); 0 non-monotonic curves of 504; worst adjacent-band overlap 27 %. **Measured over this campaign's 63-point PVT grid, a superset of the 45-point mandated grid** (§5.0) — both binding corners are `all-fast`/`all-slow` bundles the mandated grid does not contain. **That overlap figure is mismatch-off**, and per-instance mismatch is now measured against the same inequality rather than argued about: `sim/vco-tuning-range`'s joint two-band draw takes both bands of an adjacent pair from **one** mismatch draw, each at its own end of the 0.9–2.7 V control window, so `f_max(band b) ≥ f_min(band b+1)` is answered **on one die** and the overlap ratio is itself a per-sample quantity. Its one-sided 3σ low tail clears the 1.0 coverage-hole floor at every sampled point — 11/11 PASS over 2200 joint draws, 200 per point — and its worst value is 1.13935, at `ss`/125 °C/3.63 V on the B3→B4 pair, which is the very point the systematic 27 % above is the worst of (systematic ratio 1.26784 there). So roughly half the deterministic overlap margin is spent on mismatch, and at the thinnest of the 11 sampled points only 42.8 % of it survives. Two limits travel with that. The sample is a justified subset — **8 of the 45 mandated PVT points** (all five mandated MOS bundles at the deterministically thinnest pair, the remaining three vertices of the temperature × supply box at `ss`, and three further band pairs at one corner) and four of the seven adjacent pairs. And the margin survives because the dispersion is largely **common-mode**: the measured per-draw correlation between a pair's two frequencies runs from 0.8874 to 0.9958, and the independent-draw reading — pushing each band to its own opposite tail, which double-counts that common mode — would have failed 10 of the 11 points | **MET as a per-operating-point envelope** (open-loop characterization); static-code ceiling 166 MHz with gaps below it (DR-038, proposed); **no coverage hole under per-instance mismatch at any sampled point**, but that sample is 8 of the 45 mandated PVT points and four of the seven adjacent pairs, so the statistical half of this row is bounded **where it was sampled, not over the grid** | `sim/vco-tuning-range/records/20260731-175947-0a12e6c.md`; `sim/vco-tuning-range/records/20260927-220631-546a397.md` (the joint two-band mismatch draw, whose per-point reduction is committed at `corners/20260927-220631-546a397/per_point.csv` and whose 2200 per-draw ratios are in `corners/20260927-220631-546a397/mismatch.csv`); `sim/vco-tuning-range/records/20260927-214737-546a397.md` (that campaign's committed negative control — `repeat`/`vary`/`gate` at the same points, re-checkable from its own bytes with no simulator) |
| Output band, **closed-loop** | Same, at any legal (N, band, `f_ref`) | Full 45-point PVT grid at both drawn-band edges (90 runs, `pll_top` DUT): **0 of 45 corners reach a sustained in-window PASS at either edge**. **That baseline was re-run on the batch backend on 2026-11-11 and did not reproduce.** `20261111-184929-73837b9` supersedes it in full — the same deck re-expressed as a `sim/harness` manifest, the same `90 rows`, of which **7 are unmeasured** (transient convergence aborts, per-job budget timeouts and spot reclamations, each recorded as no-measurement and never as a simulator verdict) — and its row-by-row comparison against the August union is a **recorded NO-GO**: **28 of 90 rows** fall outside the per-row tolerances that re-run proposed before it ran, which were not widened afterwards, and the cause of the divergence is not established (the Darwin arm64 → Linux x86_64 and PDK-pin deltas sit in that record's own provenance, read with DR-028 and DR-039). The divergence reaches this row's own headline rather than stopping at its margins: **2 rows** come back PASS where the August grid had none, both at the `hi` edge (`fs`/−40 °C/3.30 V and `ss`/−40 °C/3.63 V). So the zero above is the August baseline's figure and is **not** confirmed by a second run; what both records agree on is the weaker claim the verdict actually rests on — no corner reaches a sustained in-window PASS at **both** edges, and the `lo` edge PASSes nowhere in either | **UNMET / open finding** — closed-loop band-edge settling has not yet been demonstrated within the campaign's own measurement window at any corner, in either record. The re-run **strengthens** this verdict rather than softening it: the campaign's own reproduction gate is NO-GO, so the per-row figures above are the August baseline's and stand unreplicated — which is a weaker evidentiary position than the row held before 2026-11-11, not a stronger one | `sim/output-range/records/20261111-184929-73837b9.md` (the current record — the harness-form re-run of the full grid on the batch backend, superseding the August full-grid baseline outright, reproduction gate NO-GO); `sim/output-range/records/20260819-160843-4e32f91.md` (the August full grid this row's headline figures are taken from); `sim/output-range/records/20260819-190341-70a4128.md` (supersedes that record's single `ff`/27 °C/3.30 V `hi` row only, replacing a hand-killed ERROR with a reproducible CAPPED/stall characterization — still not a PASS) |
| Reference input | 1–25 MHz CMOS square wave into `REF`, rising-edge triggered; duty 30–70 %; V_IL ≤ 0.2·VDD, V_IH ≥ 0.8·VDD; edge rate ≤ 5 ns (10–90 %); **reference-source quality explicitly excluded from the jitter and spur budgets** | **The frequency axis is exercised; the electrical contract is not.** `f_ref` spans the whole ratified range: the small-signal `loop-dynamics` cross-product is evaluated at 1/2/4/8/16/25 MHz (the six reference frequencies the [Icp trim-code rule](../../spec/pll.md#icp-trim-code-rule) is stated at), and closed-loop transients run at 1.25/5/20 MHz (`lock-time`, N = 4/16/64 at f_out = 80 MHz), 6.25/12.5 MHz (`supply-sensitivity`) and 25 MHz (`period-jitter`, `reference-spur`). **No record exercises the input contract itself**: every testbench in this repository that has produced a record reporting a jitter, spur or phase-noise number drives `REF` the same way — an ideal full-rail 0 → VDD pulse, 200 ps edges, nominal 50 % duty. `grep -nE '^[vb][a-z0-9_]*\s+ref\s+0' sim/*/testbench*/*.sp sim/*/testbench*/*.spice` returns **16 decks, 13 of them that one shape** (two of the thirteen trim the width by a single edge time). The three exceptions are named, and two of them have records. `sim/reference-input-contract`'s deck, below, varies the reference *waveform* deliberately and **carries no record at all**. `sim/reference-phase-transfer`'s deck (#509, DR-027) and `sim/lock-window-bisection`'s deck (#527, DR-029) do have records, and both drive `ref` from a behavioural source rather than a `pulse()` — the former to displace the reference edge **in time** so it can move mid-run, the latter to switch between two pre-step/post-step `pulse()` trains for its own phase-step bisection — but neither reports a jitter or spur number: `reference-phase-transfer` reports the 20·log₁₀(N) transfer this row's own exclusion asserts, and `lock-window-bisection` reports the `LOCK`-pad deassert latency and trim-code viability DR-029 characterizes (a negative result for that route), which is why the scoped claim above survives both their existence. (That scoping is not a form of words: `sim/lib/check-ref-drive-claims.sh` refuses to let a deviating deck carry a record at all unless a named decision record re-argues the premise for it, and DR-027/DR-029 are those records.) So the levels, the ≤ 5 ns edge-rate budget and the 30–70 % duty range are conditions no simulation *result* has ever varied. Until 2026-09-25 this row stated that uniformity over *decks* rather than over *records*, and offered a `sim/*/testbench/*.sp` glob as the proof — a glob that could not return the one deck which contradicts it, because that deck is `.spice` and landed in the very change (#518) that wrote the sentence. `sim/lib/check-ref-drive-claims.sh` now fails this repository's CI if a command quoted as evidence has a file glob its own pattern can outreach, if an unscoped uniformity claim is false over the decks that command reaches, or if a deck that varies the reference waveform ever produces a record — the last being the one that matters, since every jitter, spur and phase number in this section is stated against an ideal reference *by construction*. `spec/pll.md` states levels and edge rate as **budget**, and duty as an argument from `design/pfd.sch` rather than a result. **A campaign for it now exists and has measured nothing**: `sim/reference-input-contract` holds the DUT at `sim/pfd-deadzone`'s operating point (`pfd_cp`, 25 MHz, Vctrl = 1.65 V, Icp code b1 b0 = 10) and sweeps the `REF` *waveform* instead — the ideal pulse above, plus 0.2·VDD – 0.8·VDD levels, 5.00 ns 10–90 % edges, 30 % and 70 % duty, and one variant at all three limits at once. Its graded quantity is the per-corner shift of the reference-path set delay `d_ref` (reference mid-rail crossing → the instant the PFD acts on it, i.e. the phase the detector sampled), against the 1 ns static-phase bound of the [Lock criterion](../../spec/pll.md#lock-time); the duty row's rising-edge-only argument is stated falsifiably as ≤ 1 % of `d_ref` between 30/50/70 % duty. Manifest, deck and reduction are committed and self-checking; **zero of the 288 declared points are measured** (45 mandated PVT corners × 6 waveform variants, plus an 18-point detector-gain slice at three corners). A campaign directory is not evidence, and no number from it appears anywhere in this document. **And what it is waiting on is now known, which is worth more than the verdict: an aligned simulator, not a compute budget (DR-035).** The grid was submitted to the batch execution backend this repository's operating rules require for a multi-corner run; 118 of the 288 declared points executed, and **all 12 convergence failures among them were the same waveform variant** — `wedge`, the full-rail 6.25 ns ramp that places the 10–90 % edge rate at exactly the 5 ns budget, i.e. the binding point of the line it exists to test. 8 of 20 `wedge` points converged on the job image's **ngspice-42**, and every one of the −40 °C points failed; the same six −40 °C points converge **6 of 6** on the **ngspice-46** this repository pins (#259, DR-028). So the campaign has no route to a complete grid on the current image at any spend, and the missing points are not a random thinning but precisely the ones that test the edge-rate budget, at precisely the cold corners where a slow edge is hardest. That partial run is not committed — a grid that lost the binding point of its own budget is evidence about the simulator, not about the contract. DR-035 also declines to retune the deck's solver options until ngspice-42 converges, because that would move the numbers and forfeit the stated comparability with `pfd-deadzone`, to suit a simulator this repository does not pin | **Range MET as a swept operating condition; levels, edge rate and duty range UNMET — budget, never measured.** The half of this row a reader must not skip is the exclusion: **every jitter and spur number in this section is the block's own contribution, measured or derived against an ideal reference.** Reference phase noise inside the loop bandwidth reaches the output multiplied by 20·log₁₀(N) — 12 dB at N = 4, 36 dB at N = 64 — so a system integrating this block must budget its own reference against that multiplication; this proposal does not do it for them. **That multiplication is now measured on this design rather than quoted from theory (DR-027, #509)** — `sim/reference-phase-transfer` applies a single known 1 ns reference phase step inside the closed loop and reads the consequence differentially against a paired control run, measuring the in-band transfer at **15.529 … 16.366 dB against the 20·log₁₀(6) = 15.563 dB the formula gives** (error −0.035 … +0.803 dB, 5/5 corners PASS at N = 6), and measuring the roll-off above the loop bandwidth at one frequency as **21.6 … 32.7 dB below** that in-band figure. So an integrator budgeting against the multiplication is budgeting against something this design has been shown to do, to about 1 dB, at one N. **Two distinct benches, and only one of them now exists.** A reference-*perturbation* bench exists and has produced that measurement; the reference-*noise* bench a numeric reference-jitter limit additionally needs — a statistical phase-noise spectrum pushed through that gain against an output jitter allocation — still does not, and is DR-020's recorded methodology gap for a *reference* spectrum — the random-jitter work that #520 (the successor to #505, itself closed) carried ended in DR-032's bound of the block's **own** generators, which pushes no reference spectrum through the loop. Until 2026-09-25 this row said only "converting the exclusion into a numeric reference-jitter limit needs a reference-perturbation bench that does not exist", which conflated the two. `spec/pll.md`'s own Verification-owed line for this row used to name issue #12, which is **closed** and whose subject is closed-loop lock acquisition — so the work was, until recently, unowned. **DR-019** fixes that attribution in the ratified table: the levels/edge-rate/duty sweep is owed from **#499** (the campaign above), and the reference-jitter limit is recorded as **unowned**, sequenced behind a closed-loop reference-noise methodology that still does not exist (DR-032 bounds the block's own generators, not a reference spectrum) — deliberately not re-pointed at #13, which is itself closed, because naming a plausible-looking owner is what hid this obligation in the first place. DR-019 also restates the source-quality exclusion with a boundary — it excludes the *reference source's* phase noise, and does **not** license this block's own reference-input path to contribute; and it names the input-side coefficient an integrator is owed, `dtdv_worst`, the sampling-instant displacement per volt of reference amplitude noise at the worst legal reference slope, which is a deliverable of that campaign and is not covered by the 20·log₁₀(N) line. **None of the electrical-contract lines is a measurement**, and the verdict above is unchanged by any of this: the transfer measurement exercises the *exclusion*, not the levels, the edge rate or the duty range, and **DR-027 Decision 5 says so explicitly rather than letting a measurement in the neighbourhood soften a verdict.** DR-027 also re-argues, rather than re-asserts, the ideal-reference premise this whole section rests on — `sim/reference-phase-transfer` is a deck that varies the reference and *does* have records, so the surviving claim is narrower than it was: **no record that reports a jitter or spur number was measured against a varied reference** (that campaign reports a transfer, in dB, and no jitter or spur number). DR-019 Amendment A2 carries the same narrowing, and `sim/lib/check-ref-drive-claims.sh` enforces it | `spec/pll.md#reference-input` (the contract and the exclusion); DR-019 + its Amendment A2 (the owner, the exclusion's boundary, and the narrowed ideal-reference premise); **DR-027** (the measured transfer, its four named limits, and why it does not move this verdict); `sim/reference-input-contract/testbench/` (manifest, deck and reduction — declared, unmeasured); `sim/reference-phase-transfer/records/20260925-080736-b722f33.md` (the measured 20·log₁₀(N) transfer, 5/5 PASS at N = 6); `sim/loop-dynamics/records/20260731-202550-82af5a9.md` (the 1–25 MHz small-signal axis); `sim/lock-time/records/20260831-052456-effc505.md` (closed-loop `f_ref` = 1.25/5/20 MHz); issue #499 (open) |
| Multiplication ratio | N = 4–64, every integer | 61 distinct N exercised at 200 MHz, 0 ratio errors of 235 chain points; worst retiming setup margin 6.1 % of a VCO period (302.83 ps of a 5 ns period, `ss`/125 °C/2.97 V). **Those 235 points are a deliberately non-rectangular sample of the 61-N × 45-corner cross-product — 235 of its 2835 cells, not a grid** (§5.0): all 61 N run at two stress corners only — `ss`/125 °C/2.97 V and `ff`/−40 °C/3.63 V, 61 points each — while the full 45-point mandated grid runs at N ∈ {4, 33} (86 points) and, at N = 64, thinned to the 2.97 V supply that is the retiming worst case (14 points, plus 1 nominal); a 10 MHz input-rate check at N ∈ {4, 64} adds the last 12. So "every integer" is verified at the two corners where retiming is hardest, and the mandated grid is verified at three values of N — which is what the full cross-product was traded for | **MET** | `sim/divider-ratio-chain/records/20260802-100727-082c879.md` (chain — the `sim/harness`-migrated successor to `sim/divider-ratio/records/20260731-171817-0a12e6c.md`, which is where the chain bench also moved into its own campaign directory; a tooling migration, not a value correction — the superseded record's 235 points, its 61 distinct N and its 3.0283e-10 s worst setup margin at `ss`/125 °C/2.97 V are all reproduced, per that record's own numeric-agreement check), sibling flop/cell records same date |
| Integrated RMS jitter | not spec'd (DR-002 Decision 5) | n/a by design — never presented as a spec'd figure | **N/A, by design** | `spec/pll.md#integrated-rms-jitter` |
| Period jitter (open-loop sensitivity) | ≤ 1.0 % RMS, conditional on ≤ 20 mV pp `vdd_vco` ripple | Worst 2.51 % RMS at 100 mV pp ripple (`all-slow`/−40 °C/2.97 V, band 5); implies 0.50 % RMS at the 20 mV pp budget, leaving headroom for an unmeasured random component. **Measured over this campaign's 63-point PVT grid, a superset of the 45-point mandated grid** (§5.0) — the binding corner is an `all-slow` bundle the mandated grid does not contain. **That grid sweeps one ripple frequency, f_osc/16**; the same record's separate 6-point ripple-frequency sub-sweep, at 27 °C / 3.30 V / band 5 only, reaches 3.24 % RMS at f_osc/4, and the record withholds extrapolation because its quasi-static model under-predicts by 1.2–2.3× — so the binding ripple frequency is unmeasured at the binding PVT corner (§5.1) | **derived, conditional PASS** at the stated ripple budget | `sim/vco-tuning-range/records/20260804-211600-f599a65.md` — the `sim/harness`-migrated successor to `20260731-184845-0a12e6c`, which reports the same 2.51 % RMS worst case at the same corner and carries its own `migration_delta` table over the 1872 measurements the two runs share |
| Period jitter, **closed-loop, deterministic (control-ripple)** | Same 1.0 % RMS line | **All 45 of the mandated PVT points now measured**, at one operating point throughout (f_ref = 25 MHz, N = 6, f_out = 150 MHz, band 6, Icp code 0 — the same as `reference-spur`): the complete temperature × supply plane (−40/27/125 °C × 2.97/3.30/3.63 V) at every one of the five MOS bundles (`typical`, `ff`, `ss`, `fs`, `sf`). Range **0.0508–0.2691 % RMS** across all 45 — worst `typical`/−40 °C/3.63 V, best `ss`/125 °C/3.30 V, a 5.3× span, unchanged by the last 16 points (`fs`/`sf` span 0.0903–0.2472 % RMS, inside those bounds). Temperature is monotone at every bundle (hotter is better) — the finding from `typical`/`ff`/`ss` extends cleanly to `fs`/`sf`. The supply trend does not resolve into a clean two-valued-by-process-sign picture, though: `ff` falls and `ss` rises with supply, `fs` mostly rises (dipping slightly at −40 °C: 0.1903 → 0.1876 → 0.2097 %), and `sf` falls gently at −40 °C like `ff` (0.2472 → 0.2463 → 0.2454 %) but rises at 27 °C and dips at 125 °C — the "sign flips cleanly by process" reading from `ff`/`ss` alone does not fully generalize. One caveat is reported rather than smoothed over, and it has since been **closed**: one of the first five records' **overall status is FAIL**, because 2 of its 18 points fail a lock gate that is not wrap-safe — both loops are demonstrably locked (`fout` within 160 ppm of target, measured N = 6.000, jitter in family with their neighbours) and the gate's phase samples wrapped by exactly one reference period. That was a measurement defect, not a jitter result, and it was filed as issue #273 — **now fixed and closed**. The gate unwraps the phase difference into ±T_ref/2 before differentiating it and gains a wrap-free `ferr_fb` = `ffb`/`f_ref` − 1 corroboration check at ±2e-3 (the `ferr` gate itself is unchanged at ±1e-3), and a sixth record re-measures exactly those two points against it: same simulation, corrected gate — `phi_a`/`phi_b` and `tj_rms` come back identical to the digit and `ferr` reads −1.47e-06 / −1.19e-05 instead of 4.00e-2, both **PASS**. No record of this campaign now carries an unresolved FAIL | **MET at every measured corner (45/45), with a 3.7× margin at the worst of them** — but **no record of this campaign varies the output band**: every point is at band 6 / 150 MHz, so nothing here yet bounds jitter at the 200 MHz top of the ratified band — see the row immediately below | `sim/period-jitter/records/20260905-192724-a2ba48f.md` (first, `typical` only); `sim/period-jitter/records/20260906-015602-f9bef9d.md` (adds `ff`/`ss`/`fs`/`sf`); `sim/period-jitter/records/20260906-024225-12bccda.md` (adds the `typical` temperature × supply plane); `sim/period-jitter/records/20260906-063728-f3c9c23.md` (adds the `ff` and `ss` planes; overall FAIL, see #273); `sim/period-jitter/records/20260906-080511-69b36ef.md` (adds the `fs` and `sf` planes' remaining 16 points, completing the matrix; overall PASS); `sim/period-jitter/records/20260906-095050-3a8a6ef.md` (supersedes `20260906-063728-f3c9c23`'s `ferr` lock-gate verdict at its two failing points **only**, re-measured against the wrap-safe gate of #273 — 2/2 PASS; that predecessor's jitter numbers and its other 16 points stand as recorded) |
| Period jitter, **closed-loop, deterministic, at the 200 MHz band top** | Same 1.0 % RMS line | **No measured record yet — declared, not measured.** `sim/period-jitter-band-top` is the row above's measurement moved to the binding end of the ratified band: same deck structure, same solver tolerances, same reduction module (loaded, not copied), f_ref and the Icp trim code held, N 6 → 8, f_out 150 → 200 MHz. Its full 45-point grid is declared and every point's operating point is derived from the committed VCO record `20260804-162735-72883fb` under [the band-selection rule](../../spec/pll.md#band-selection-rule), re-checkable without a simulator. That VCO record itself runs the **63-point** superset grid, but the derivation reads only its five mandated MOS bundles (`MOS_BUNDLES` in `band_and_vstart_from_vco_record.py`), so what this campaign declares is the mandated grid and not the wider one it is derived from (§5.0). One result did come out of that derivation and needs no simulator: **at 200 MHz the rule does not select a single band code across the PVT grid** — band 6 at 34 of the 45 points, band 7 at the other 11 (the cold and/or high-supply points where band 6's own curve tops out below 200 MHz) — where at 150 MHz one static code covers all 45. Local Kvco at the selected points spans 74.7–117.0 MHz/V, all inside the Kvco row's 150 MHz/V bound, but the loop gain the one fixed filter sees varies 1.6× across this grid against 1.05× across the 150 MHz one | **UNMET — explicitly.** No jitter number at 200 MHz is claimed anywhere in this document. The band split above is a derivation from committed open-loop evidence, reported as such, and is not a substitute for the measurement | `sim/period-jitter-band-top/testbench/` (manifest, deck and derivation; `band_and_vstart_from_vco_record.py --check`); `sim/vco-tuning-range/records/20260804-162735-72883fb` (the f(Vctrl) table it reads); issue #503 (open) — the campaign's unrun measurement, now that #496 (closed 2026-09-25) has landed the batch backend it was waiting on |
| Period jitter, **closed-loop, random/noise-driven** | Same 1.0 % RMS line | **Bounded, not estimated — ≤ 0.338 % RMS at all 45 of the mandated PVT points** (worst `sf`/−40 °C/2.97 V, one-sided 95 % confidence), from `sim/period-jitter/random-bound/` (DR-032). No analysis this toolchain offers *estimates* the random component: ngspice `TRANNOISE` injects nothing on the pinned build, and there is no periodic-steady-state/`pnoise` path to weight the per-device noise PSDs `.noise` does report over the ring's switching trajectory (DR-020, narrowed by DR-023; probes re-runnable at `sim/period-jitter/noise-toolchain-probe/`). DR-032 bounds it instead, in three independent terms. **The ring and output buffer**: a `trnoise()` current source across every channel, each sized at the **maximum** of that device's own `.noise` density over its own trajectory (sampled to the trajectory's 2 ps resolution around each switching device's peaks), so the stationary approximation can only over-state the jitter — with the ring's true impulse sensitivity, which the transient integrates itself; flicker folded into that injection through the closed loop's error transfer over every loop the as-built filter admits at the 45° floor, which is also why the bound needs no observation interval. **The bias generator**, whose noise moves the frequency for many periods and so cannot be held in a one-period window: `.noise` about its DC operating point, referred to the ring's frequency through measured sensitivities to its two outputs, integrated through the same loop envelope, and checked against the transient at the reference point, where the transient's σ̂ is 0.910 of the model's open-loop prediction with a standard error of 0.042 (written as two figures rather than as one `±` string because a `±` is two numbers, and grading only the front of it would state the estimate and never look at the error bar). It is the largest term. **The loop-filter resistor**: equipartition through the control node. Validated at the reference point for timestep, `trnoise` sample interval, 3× linearity and block decomposition. The impulse-sensitivity-function route to an *estimate* has its ingredients built and validated (DR-030: Γ converges at ≤ 0.02 % over the last halving of the timestep ceiling; DR-031: the per-device PSDs along the trajectory) but is not assembled, and the bound does not need it. **Scope**: this term covers every generator in `vco` and the loop-filter resistor. The charge pump, PFD, divider and lock detector are in-band sources DR-032 argued small (through the loop's ≤ 1.4 MHz low-pass, then the period difference's `(2πfT)²`) rather than bounding; **DR-033 (`sim/period-jitter/in-band-bound/`) now bounds them too** — ≤ 0.0249 % RMS at the worst of the same 45 points, a headroom of 15.8× against the margin DR-032's own bound leaves, with the charge pump's own pulsed-duty-cycle output current setting essentially all of it. Combined with DR-032's bound in quadrature (independent sources), the whole random half is **0.2559 … 0.3388 % RMS at all 45 points** | **MET — as an upper bound, at 45/45 corners, with a 1.48× margin** on the 0.50 % RMS `spec/pll.md`'s supply-ripple derivation allocates to this component, which is therefore a verified allocation rather than the unverified budget DR-023 Decision 3 recorded (DR-032 supersedes that status). One limit travels with the combined bound: it is **not an estimate** of the part's random jitter, only its ceiling — but it now **covers every generator this design's schematic level admits**, other than the reference source (excluded by DR-019) and the not-yet-designed current-reference block | `spec/decision-records/DR-032-random-period-jitter-bounded-over-the-grid.md` (the VCO-side bound, its inequalities, its scope); `spec/decision-records/DR-033-in-band-random-period-jitter-bounded-over-the-grid.md` (the in-band bound closing DR-032's scope, its seven inequalities, the charge pump's duty-cycle adaptation); `sim/period-jitter/random-bound/results/transient_*.json` and `sim/period-jitter/in-band-bound/results/bound_*.json` (the 45 per-point bounds, each with its own committed `SUMMARY.md`); `sim/period-jitter/random-bound/results/validate_typical_27c_3.30v.json` (the one-point `validate` stage, whose transient-over-model ratio and standard error are quoted above); `spec/decision-records/DR-023-random-period-jitter-owner-and-cyclostationary-gap.md` (why no estimate exists, and the budget split); `sim/period-jitter/noise-toolchain-probe/`; issue #580 (closed 2026-09-27) — the in-band generators' bound, which DR-033 delivered |
| Phase noise | not spec'd (DR-002 Decision 5) | n/a by design | **N/A, by design** | `spec/pll.md#phase-noise` |
| Reference spur | ≤ −55 dBc | −57.0…−72.7 dBc measured at 150 MHz (5 spanning corners); scaled to the binding 200 MHz, the two coldest corners land at −54.5/−54.9 dBc — **0.5 dB** and **0.1 dB** over the line respectively. **That measurement runs with charge-pump mismatch off.** The derivation it cross-checks has since been re-priced twice: by DR-018 (#483), which counted the UP/DN current mismatch ("term 1") at its statistical 3σ instead of its systematic value and refreshed the statistical residual to the corner-combined Monte Carlo campaign, and by **DR-034 (#610)**, which re-priced that residual again at the campaign's full 21-point corner axis (#597), where its worst corner rose from 4.25 fC to 5.57 fC. The deliberately conservative 200 MHz stack now lands at −56.0 dBc with term 1 at its measured `17.09 %` and **−55.7 dBc** at its ±20 % budget — **0.67 dB inside the line**, where DR-018's own pricing left 1.6 dB and the older −61 dBc derivation, which left term 1 out, implied a ~6 dB reserve. Read corner-consistently instead of stacked — each measured corner with its own five ingredients — the worst of the 21 corners is −56.79 dBc at the same budget, 1.79 dB inside | **PASS at 150 MHz (5/5 corners); UNMET at the scaled 200 MHz binding point for 2/5 corners** — 5 of 45 PVT points measured, not the full grid. The derived stack including mismatch clears the line, but by 0.67 dB rather than ~6 dB (DR-018, re-priced by DR-034), so the reserve this row was once argued on is now almost entirely spoken for — and DR-034 states that the stack's five-fold conservatism is therefore load-bearing rather than decorative, which is why it grades the corner-consistent reading beside it. The owed work was handed by `spec/pll.md` to #145, which is closed. **DR-024 (#510) re-points it and restates it**: what is owed is the mandated 45 points *at the binding 200 MHz* — not 40 more at 150 MHz that would still have to be scaled by +2.50 dB. **#510 is closed** (superseded by #533, per the Curator's 2026-09-25 disposition on the Judge's review of #537 — #510's own remaining acceptance criteria, the 45-point 200 MHz grid, are exactly #533's scope, so the obligation moved rather than closing unmet) — and it is owed at **#533**, against a campaign that now exists and is declared-and-unmeasured (`sim/reference-spur-band-top`, 0 of 45 points). DR-024 also states which derived row a *mismatch-off* measurement may be read against: the systematic-only **−66.6 dBc**, not the −55.7 dBc stack above, which adds two statistical terms at their own worst corners. Read that way, the committed 150 MHz measurement already exceeds the systematic derivation by ~12 dB at the two cold corners while sitting 3.6 dB below it at the derivation's own worst corner — so the derivation does not predict the measurement's corner ordering, and the closed-loop **statistical** spur is unowned | `sim/reference-spur/records/20260816-132150-5f405e7.md`; `spec/pll.md#reference-spur` (the re-priced derivation table); `spec/decision-records/DR-018-cp-term1-mismatch-budget-derived-from-the-spur-line.md`; `sim/mc-cp-mismatch/records/20260923-095854-1655e11.md` (the superseded **3-corner subset** of the mandated 45 — `ff`/−40 °C/3.63 V, `typical`/27 °C/3.30 V and `ss`/125 °C/2.97 V, at n = 100 mismatch samples each — which DR-018's own pricing rests on); `sim/mc-cp-mismatch/records/20260927-102154-d004d5b.md` (#597 — the successor record, which **supersedes** that one for the campaign's own claim by widening the corner axis to every vertex of the process × temperature × supply box, and which adds the `fs` and `sf` bundles the subset never visited. This is the record the `17.09 %` above and the whole re-priced stack now come from, because `spec/pll.md`'s derivation cites it by record id and term 1 and term 3 have to be read off the same run or the column mixes two corner axes. Term 1 *fell* between the two records (17.48 % → 17.09 %), and most of the fall is the execution host rather than the axis: the same seed on a different host is an independent Monte Carlo replicate, not a reproduction — see that record's cross-host bullet and its own host/axis separation table. **What the successor moved, and what was owed elsewhere**: the statistical residual net charge the stack took 4.25 fC for reads 5.57 fC at the widened axis' own worst corner, and re-pricing this derivation belonged in a decision record rather than in a campaign record or in this table — **DR-034** is that record); `spec/decision-records/DR-034-reference-spur-charge-stack-repriced-at-the-widened-corner-axis.md` (the re-pricing at the widened axis, `proposed`); `spec/decision-records/DR-024-reference-spur-binding-point-owner-and-mismatch-relation.md`; `sim/reference-spur-band-top/testbench/tb.json` (declared, no record); issue #510 (closed); issue #533 (open) |
| Loop bandwidth | 26–430 kHz over the ratified space, `f_c < f_ref/10` | 25.96–429.5 kHz measured; worst realized `f_c/f_ref` = `f_ref/13`, inside the ceiling at every point of the cross-product. **Not measured on the MOS grid, because the DUT has no MOS device in it**: `loop-dynamics` sweeps the passive loop filter over 81 filter-impedance points (27 passive-corner bundles × 3 temperatures) and declares the MOS and supply axes N/A, folding the active devices' spread in as measured extremes — Icp from `cp-compliance`'s own 45 PVT corners, Kvco from `vco-tuning-range`'s 63 — rather than re-simulating them. That is a wider envelope than the mandated grid on the axis that sets stability, not a narrower one (§5.0) | **MET** | `sim/loop-dynamics/records/20260731-202550-82af5a9.md` |
| Phase margin | ≥ 45° in the contracted (trim-rule) space | Worst 47.4° at `f_ref` = 1 MHz, 4 legs; 105/140 cells pass unconditionally, all 35 failures are off-rule trim codes. Same 81-point filter-impedance basis as the row above (§5.0) | **MET** (in the contracted space) | Same record |
| Lock time (small-signal settling) | < 100 µs to the ratified Lock criterion (output frequency within ±0.1 % **and** static phase error at the PFD inputs ≤ 1 ns) | Worst 71 µs (`f_ref` = 1 MHz, 4 legs); structural floor ≈ 43 µs (set by `1/(2πRC1)`, a derivation rather than a grid minimum); 120/140 cells meet the line, 0/140 meet the dropped < 20 µs stretch. The settling half of this row shares the Loop bandwidth row's 81-point filter-impedance basis, not the MOS grid (§5.0); the static-phase half below is measured on the mandated 45. **But the criterion this time is measured *to* is not reached at 1 of the 45 mandated corners at the configuration the normative band-selection rule selects, with a second corner owed** (DR-012, narrowed by **DR-025**): closed-loop, the loop settles at 1.049 ns of static phase at `typical`/−40 °C/3.63 V against the ratified ≤ 1 ns — nominal skew, systematic only, before the 0.576 ns statistical mismatch term — so at that corner there is no instant for a lock time to be measured to. The **1.227 ns** at `ff`/27 °C/3.63 V is a correct measurement of **band 6**, which is not the band the rule selects there over DR-003 Decision 5's measured 0.9–2.7 V control window (it selects band 5, `VCTRL` 1.967–2.595 V); that cell has never been run closed-loop, so the corner is neither cleared nor confirmed and the count returns to 2 of 45 if it misses. The axis it is lost on is the control voltage, not the corner: at `VCTRL` = 0.90 V the charge pump's residual charge alone exceeds the whole criterion at 36 of 45 corners, open-loop — and **DR-025 measures that the band-selection rule cannot fix that**: applied across the ratified 10–200 MHz output band it still parks some corner at `VCTRL` ≤ 1.05 V at 23 of 39 output frequencies (floor 0.919 V) and still misses the criterion on DR-012 Decision 4a's summed budget at 1397 of 1628 rule-selected points, so the resolution must reduce the pump's residual charge at low `VCTRL` | **MET as a settling estimate (not cold-start) — and NOT MET at 1 of 45 corners at a rule-compliant configuration, with a 2nd corner's rule-selected configuration owed**, where the Lock criterion itself is never reached, exactly as `spec/pll.md`'s own row states it. DR-012 Decision 1 keeps the criterion unrelaxed and DR-025 Decision 1 restates it unchanged, so this is a design gap, not a spec one — and DR-025 narrows DR-012 Decision 7's four candidate loci to one (the pump's residual charge at low `VCTRL`) by eliminating the band-selection axis on measurement. Its settled value at 15 further over-bound corners is **not currently owned**: #399 (closed as not planned) was the issue for it, and the measurement is to be refiled with batch-adapter scope. **#511 is closed** (COMPLETED) — it is the issue DR-025 was filed against, and DR-025 discharges it by narrowing the four candidate loci to one; it did not run either closed-loop cell it named, and does not claim to. Those two runs (the rule-selected `ff`/27 °C band-5 cell, and the lowest rule-compliant parking anywhere in the output band — f_out = 135 MHz at `ss`/125 °C, `VCTRL` 0.919 V) are **not currently owned**: #540 (closed as not planned) was filed because both are multi-hour ngspice campaigns outside a Builder session's scope, and they are to be refiled with batch-adapter and remote-pilot scope | `sim/loop-dynamics/records/20260731-202550-82af5a9.md` (settling; superseded by the batch-backend re-run `sim/loop-dynamics/records/20261111-092132-343bafa.md`, whose `baseline_comparison` reproduces it, pilot gate GO); `sim/supply-sensitivity/records/20260916-051708-8cedbba.md` (the 1.227 / 1.049 ns settled static phase); `sim/supply-sensitivity/records/20260925-090649-4422f1d.md` (the band-selection re-derivation, arithmetic only, no new simulation); `spec/decision-records/DR-012-static-phase-offset-evidence.md`; `spec/decision-records/DR-025-band-selection-is-not-the-lock-criterion-resolution.md`; issue #399 (closed); issue #511 (closed); issue #540 (closed) |
| Lock time, **closed-loop cold-start / worst-case re-lock** | Same < 100 µs line, cold-start basis | Full 270-run grid (45 corners × N ∈ {4,16,64} × {cold, relock}): sustained in-window `LOCK` PASS on **21/135** cold rows and **1/135** relock rows within the tested window; the remainder read as window-too-short (not necessarily non-convergent) per the record's own DN-branch integration guard (255/270 PASS, confirming the transient itself resolved correctly on those rows) | **UNMET as a closed PASS bound** — real evidence now exists where `spec/pll.md` still lists this as "budget," but it does not establish that most corners lock inside any stated time | `sim/lock-time/records/20260831-052456-effc505.md` |
| Power | < 5 mW at 100 MHz, locked | Derived total ≈ 1.98 mW at the binding corner (`all-fast`/125 °C/3.63 V) from the open-loop/interpolated basis `spec/pll.md#power` uses. Its one measured term (`vdd_vco`, 318 µA) is the worst of the 159 grid points with 90 ≤ f_osc ≤ 110 MHz in that record's `vco_tuning.csv`, taken over the campaign's **63-point PVT grid, a superset of the 45-point mandated grid** (§5.0) — the binding corner is an `all-fast` bundle the mandated grid does not contain. The `vdd_div` term is an interpolation and the `vdd_ref` term is a budget, so this row is not a measurement at any grid | **MET** (derived) | `spec/pll.md#power`, whose `vdd_vco` line reads `vco_tuning.csv` from `sim/vco-tuning-range/records/20260731-175947-0a12e6c.md` |
| Power, **closed-loop measured** | Same line | Full 45-point grid + all 3 step/ramp corners: **0.9863–1.98 mW measured directly** (not derived), all points under the 5 mW target; quiescent/dynamic split reported per corner | **MET, measured** — supersedes the derived figure above with a direct closed-loop measurement | `sim/supply-sensitivity/records/20260901-155456-46b92f8.md` |
| Standby current | waived — no power-down mode in v1 | n/a — no standby state exists | **N/A, by design** | `spec/pll.md#standby-current` |
| Supply sensitivity — AC (ripple) budget | `vdd_vco` ripple ≤ 20 mV pp | Derived from the 2.51 %/100 mV pp measured sensitivity above, so it inherits that row's corner universe: this campaign's **63-point PVT grid**, a superset of the 45-point mandated one (§5.0), whose measured sensitivity binds at an `all-slow` bundle the mandated grid does not contain. The budget is therefore stated against the stricter of the two grids, not the mandated one. It also inherits that row's *ripple-frequency* limit: scaling the f_osc/4 sub-sweep's 3.24 % instead gives 0.65 % RMS at this budget rather than 0.50 %, still inside the 1.0 % line but at 1.5× margin instead of 2× (§5.1) | **derived, conditional** | Same record — `sim/vco-tuning-range/records/20260804-211600-f599a65.md` |
| Supply sensitivity — DC / closed-loop, full grid | ≤ 1.2 V of the `VCTRL` window consumed by a full-range (2.97–3.63 V) rail excursion (`spec/pll.md` Budget 2, re-derived by DR-037 from 0.6 V, which priced half that excursion); stays locked through a supply step + ramp | Full 45-point grid, with each of the record's three FAILs read against the **ratified** line rather than the deck's proxy for it (**DR-021**). **(1) The frequency-vs-supply FAIL has no frequency content**: 0 of 45 corners missed either frequency check — worst deviation −294 ppm against a 1000 ppm criterion (3.4× headroom), worst residual frequency error 2.255e-4 against 1e-3 (4.4×). Its 10 failing corners are the composite lock criterion's *other* checks, 2 static-phase and 8 lock-flag, and DR-012 measured both classes against the ratified ≤ 1 ns static-phase bound: the 2 were sampled while still decaying (0.60–0.72 ns of movement across the run's own window), and the 2 settled violations — the corners that **are** over the bound once settled — are inside the 8. It is the same static-phase finding as the Lock time row above. **(2) Budget 2 is measured for the first time**: the closed loop consumes 0.385 … 0.846 V of the `VCTRL` window over the ratified 2.97–3.63 V rail, worst `ss`/−40 °C at **0.846 V** (47 % of the 1.8 V window). That met the re-derived 1.2 V budget at **15 of 15 (bundle, temperature) cells** (0.71× at the worst) and exceeded the superseded 0.6 V figure at **9 of 15** (1.41 times; over the ±0.33 V half-excursion that figure priced, **0 of 15 cells exceed it**); the miss against the old figure stays recorded, and the **53 mV** window margin below is what must not erode. It is not an anomaly: it matches what each cell's selected band requires, from the open-loop `f(VCTRL, vdd)` table, to within 5.7 mV at every cell. The record's own "4 of 45 outside the window" FAIL is graded against DR-001's *predicted* 0.9–2.4 V window, which DR-003 Decision 5 superseded with a measured 0.9–2.7 V; against that window **0 of 45 points leave it**, by 53 mV at the tightest. **(3) The step+ramp FAIL is a hold ≈8 µs short of a slew-limited recovery, not an under-damped loop**: the retained waveform shows the control node slewing at a near-constant −20.3 mV/µs for 18.75 µs after the ramp at `ss`/−40 °C (a straight line fits it with 33 % less residual than a single exponential — **20.54 mV** rms against **30.75 mV**, in volts, on the same samples), and the model-free damping test — overshoot past the final value — does not separate that corner from the two the record calls `settles` (17.2 mV on 20.0 mV of its own ripple, against 19.5 and 22.5 mV). What separates it is that it is criterion 2's worst cell: the corner that consumes the most `VCTRL` window for a rail excursion takes longest to recover from one | **Budget 2 MET at 15 of 15 cells at the re-derived 1.2 V** (it was unmet at 9 of 15 against the superseded 0.6 V, which priced a ±0.33 V excursion while the row specifies the 0.66 V full range). The operator ruled that the full range governs; DR-037 re-derives the figure by arithmetic and is `proposed` pending two-key ratification, so this verdict is conditional on it. The consequence the budget guards against — re-cutting the band plan — is **not** observed, and is 53 mV away: that margin is the quantity that must not erode. **Not every finding has a named open owner** (what #506 was filed for): three are currently unowned, as listed below: the excursion question is decided by DR-037 (#525), whose revised criterion 1b has not yet been exercised by a run; the static-phase finding is DR-012's, narrowed by DR-025 — **#511 is closed** (DR-025 discharged it without running either cell it named), and the two runs that would settle it were filed as **#540 (closed as not planned)** — plus **#399 (closed)** (the 15 corners sampled on a tail) and **#437 (closed)** (the full-grid re-take at the trimmed detector window); none of the three has an open owner now, and each measurement is to be refiled with batch-adapter and remote-pilot scope; the post-ramp settling measurement is **#405 (open)**. No recorded verdict or value changes — `sim/` is append-only | `sim/supply-sensitivity/records/20260925-044237-4ff4f65.md` (the re-reading, arithmetic only, no new simulation) over `sim/supply-sensitivity/records/20260901-155456-46b92f8.md` (the grid); `spec/decision-records/DR-021-supply-sensitivity-fail-criteria-ownership.md`; `spec/decision-records/DR-003-vco-band-map-and-kvco-contract.md` Decision 5 (the measured control window); issue #525 (closed; DR-037 proposed, pending two-key ratification); issue #511 (closed); issue #540 (closed); issue #399 (closed); issue #437 (closed); issue #405 (open) |
| Output duty cycle | 45–55 % at `CLK`, full band, all corners | 44.375–50.696 % measured (90 points, loaded); 7/90 points below the 45 % floor, all at the low-frequency band edge, concentrated in the `fs` process bundle | **UNMET at 7/90 points** (small excursion, 0.625 pp worst-case) | `sim/output-driver/records/20260817-100354-0e9cfc9.md` |
| Output levels and drive | V_OH ≥ 0.9·VDD_VCO, V_OL ≤ 0.1·VDD_VCO into ≤ 50 fF | V_OH 1.006–1.044·VDD_VCO, V_OL −0.040…−0.006·VDD_VCO, 90/90 points | **MET**, full 90-point grid | Same record |
| Area | ≤ **0.30 mm²** total — **amended by DR-016** (issue #456) from the draft ≤ 0.15 mm², on the measurement in the next column, and **held** there by **DR-017** (issue #476) on a floor re-measured 17.5 % lower | **Measured at the block level, and the spec row is now amended to it.** Every sub-block's as-drawn footprint, taken from the committed GDS bounding box rather than a hand-recorded figure: loop filter 0.0369 mm² (DR-006's device sum ×1.15, the figure this row was amended on; the loop filter has since been drawn, issue #748, and measures 40,593.5 µm² as drawn), VCO 0.0418 mm² (226.69 × 184.48 µm; it was 0.0318 mm² before issue #759 drew the decap pair as real devices), PFD + charge pump 0.0256 mm² (344.98 × 74.30 µm — it was 0.0353 mm² before the #455 fold, 0.0267 mm² before the #469 glue-bus packing and 0.0264 mm² before the #473 glue-inverter interleave), divider chain 0.0553 mm² (1317.66 × 41.99 µm — it was 0.2471 mm² as first drawn and came down 78 % through the #341 routing-track-packing, #344 row-fold, #454 macro-track-packing and #458 route-over-the-device-rows passes), lock detector 0.0306 mm² (294.80 × 103.75 µm — grown ~4.1× from 0.0075 mm² by issue #449, which drew DR-014's 4-bit trim network into `delaywin_3v3` and, with it, the block's first LVS match against its own ratified schematic). Sum **0.1803 mm²**, or **0.2254 mm²** after the floorplan's own ×1.25 top-level-overhead factor (it was 0.2186 / 0.2733 mm² when DR-016 was written; #469's glue-bus packing, #458's route-over-the-device-rows pass and #473's glue-inverter interleave have taken 38,324 µm² off since, without moving the row) | **UNMET as assembled: the first `pll_top` GDS (issue #297) measures 0.4078 mm², 135.9 % of ≤ 0.30 mm², a measured top-level overhead of ×2.217 against the ×1.664 the row holds to** — **DR-041 (issue #758) holds the row at ≤ 0.30 mm², records this miss as unmet, and authorizes a bounded compaction feasibility study (#792); an upward amendment needs a separate decision record** (`layout/evidence/pll-top-layout/PROOF.md`; `PLL-FLOORPLAN.md` §5.16). On the block sum alone the row was **MET — 0.2254 mm², 75.1 % of ≤ 0.30 mm² — and 1.50× over the draft 0.15 mm² target, which is now *measured* to be unreachable rather than merely unmet.** DR-016 is the amendment and the honest reading of it is this: the draft number was never derived from anything (DR-007 Amendment A3 called it "the one `budget` row in the table with no rationale behind the number at all"), and the 78.6 % of it that had no estimate of any kind is now four committed, DRC/LVS-clean block layouts. Three measured bounds, each tighter than the last, and none reaching 0.15 mm²: as drawn **1.50×** (1.82× when DR-016 was written; #469, #458 and #473 have since landed, below); every remaining named layout lever at its geometric ceiling **1.20×**; and — the one that settles it — **every Metal2 track routed at zero area cost, 1.13×**, a bound that survives any row fold and covers every lever this design has. 57.2 % of what a 0.15 mm² row allowed is consumed by two terms that every post-layout lever leaves untouched: the loop filter (set by DR-006's C1/C2 *capacitance*, so reducing it is a loop-dynamics change) and `vco_block`, whose height *is* its device band and whose 60.8 % whitespace is the guard-ring and 15 µm tap-pitch spacing the foundry deck requires. The amended row is the measured total plus margin sized to the single unmeasured factor in it (it holds for a top-level overhead up to ×1.664 on the sum as drawn today), **not** an allowance for block growth. Three levers have landed since DR-016 and none has moved the row — **by decision, not by lag**: DR-017 re-measured the floor after all three and **held** the row, because a margin sized to an uncertainty does not shrink when the measurement beneath it does, and the ×1.25 top-level overhead it covers has not moved. DR-017 Decision 3 also **replaced** DR-016's original trigger (any material lever landing is grounds for a downward successor record), which fired three times in two days: the row is now re-amended *down* when the uncertainty itself shrinks — an assembled `pll_top` GDS measures the top-level overhead, or the loop filter is drawn — and a further block-level lever (an unnamed `lock_detector` one remains open) earns a measured-table refresh, not a new row. Of the three: #469's glue-bus packing, at 259 µm², and #473's glue-inverter interleave, at 776 µm², are small; **#458** is not — it routed the divider chain's Metal2 tracks into the plane over its own device rows, 0.0926 → 0.0553 mm² (74.4 % of its sized ceiling), DRC-clean on both decks and still LVS-matched, moving the total 1.82× → 1.51× under an unchanged row. The divider-chain packing lever (#454) is already spent: packing the `div23_cell` macro's own Metal2 track band (31 nets onto 11 tracks, the provable minimum) took that block from 0.1321 to 0.0926 mm², moving the total from 2.03× to 1.70× on its own. Shared-diffusion device stacking — which this proposal previously named as *the* cause — remains worth only **0.10 %** of the (now larger) gap, falsified rather than deferred, because the divider chain's drawn diffusion is ~1 % of its own bounding box. The `pfd_cp` fold (#455) is spent as well, taking that block 0.0353 → 0.0265 mm² and the total from 1.89× to 1.82× (and #469's glue-bus packing plus #473's glue-inverter interleave have since taken it to 0.0256 mm², a further 0.5 % of the total — "Known gaps" item 8) — but it landed at **42 % of its sized ceiling**, and the shortfall was measured to be in the ceiling (a flat 57-track census over five levels of composition, of which `pfd_cp` owns 4) rather than in the execution. `lock_detector`'s own new footprint is not yet levered against at all. Earlier revisions of this row projected a post-lever floor of 1.64×, then 1.54×; both carried `divider_chain`'s pre-#454 ceiling, and re-derived from the current audit the figure is the 1.20× above — *better* than the record had been carrying, and still over (PLL-FLOORPLAN.md §5.11). §5.13 adds one caveat to that ceiling: `max(packed-track floor, device band) × width` assumes a block's tracks occupy an exclusive band, which is exactly what #458 stopped being true for `divider_chain`, so that block's term in any future ceiling sum has to come from its device band (0.0347 mm²) instead. A fourth lever, sized against `lock_detector`'s own newly-measured 65.5 % whitespace, is still not named. Note the 0.2254 mm² is a **sum of block extents**, which leaves out top-level routing and inter-block spacing — exactly the uncertainty the amended row's margin was sized to. The assembled top level has now measured it, and the margin does not cover it: the 1317.66 µm divider chain over the 184.6 µm block row alone bounds any rectangular top level at 0.2986 mm² before spacing or routing, so the row needs a decision record, not a further lever (`PLL-FLOORPLAN.md` §5.16) | `spec/decision-records/DR-016-area-budget-amended-on-measured-floor.md` (the amendment); `layout/evidence/area-audit/PROOF.md` (every lever's arithmetic; reproduce with `python3 layout/run_pv.py area`); `spec/decision-records/DR-017-area-row-held-at-0.30-on-the-refreshed-measured-floor.md` (the hold, and the replaced trigger); `layout/floorplan/PLL-FLOORPLAN.md` §5.1–§5.15 (the re-derived budget; §5.15 is DR-017's); `layout/evidence/vco-layout/PROOF-381-high-rs-resistor.md`; `layout/evidence/pfd-cp-layout/PROOF.md` + `PROOF-455-fold.md` + `PROOF-469-glue-bus-packing.md` + `PROOF-473-glue-inverter-interleave.md`; `layout/evidence/divider-chain-layout/PROOF-macro-track-packing.md` + `PROOF-over-device-rows.md`; `layout/evidence/lock-detector-layout/PROOF.md` "Addendum 4"; `spec/pll.md#area`; `spec/decision-records/DR-041-area-row-held-at-0.30-assembled-pll-top-recorded-unmet.md` (the hold and the unmet record) |
| Lock detector | assert window within **1 … 2 ns** of phase error at every PVT point (T1′/T2′, DR-010/DR-013), measured at the `lock` flag rather than at the bare delay chain; hysteresis ≥ 25 % of window (T3); deassert ≤ 1 `f_ref` period (T4); no chatter 1–25 MHz (T5). **Conditioned on the [lock-detector window trim-code rule](../../spec/pll.md#lock-detector-window-trim-code-rule)** | Re-characterized in situ on the trimmed `delaywin_3v3` cell (DR-014, #411): window edge **[1.14, 1.16) ns** at `fs`/−40 °C/3.63 V and **[1.78, 1.80) ns** at `ss`/125 °C/2.97 V, each at the code the trim rule selects, PVT spread **1.53–1.58×** against DR-013 Decision 4's ≤ 1.65×. 0 of 205 points fail the four-check acceptance; worst deassert latency 5.63 ns. The **untrimmed** cell sat at [2.02, 2.04) ns with a 1.91–1.96× spread — outside the band at every fixed code. **Measured over a 13-bundle, 117-point PVT grid** — the mandated five MOS bundles plus `all-slow`/`all-fast` and the six passive-only ones — which all three cited campaigns share, including the 1872-point trim code map (§5.0). **Unlike `vco-tuning-range`'s superset, this one moves nothing**, and that is checkable rather than asserted: the eight added bundles re-skew only the passive `.lib` sections, this DUT is an inverter-chain delay with no passive device in the measured path, and all 72 of their points reproduce their MOS twin's `twin_r`, `twin_f` and verdict to the digit in the record's own `raw_measures.csv`. Every quantity quoted here binds at a mandated-grid bundle: both window edges; the 1.1084 ns minimum bare-chain `t_win` over all 205 points, at `fs`/−40 °C/3.63 V, which the ≤ 1.62× resolution-independent bound rests on; and the 5.63 ns worst deassert at `sf`/125 °C/2.97 V | **T1′/T2′ MET, conditional on the trim rule** — this row supersedes this proposal's earlier "T1/T2 UNMET" reading, which predated #411. **T4/T5 still UNMET/uncharacterized below 25 MHz.** Three things a reader must not miss: an **untrimmed part is outside this specification**; the trim code table is schematic-level and mismatch-free, so the rule is not yet proven against a real trimmed part; and **the rule has no executable route on silicon — now measured, not merely unexamined**: its measurand is `t_win`, the `ERR → ERRD` delay of an internal cell, and neither node is a pad; **DR-022** (#501) measured all four candidates §2.2's pad list offers against the cell's own sixteen-code map over the full 13-bundle grid, and none selects the code to the accuracy this row's 1.53–1.58 × spread figure assumes — reading `CLK`'s frequency is *worse than not trimming* (2.434 × against 1.984 × untrimmed), and the best candidate, the `CLK`→`DIVOUT` skew, holds the band but lands at 1.697 × with a worst code error of +4 (§4 step 4, §7 item 11). `spec/pll.md` keeps this row inside DR-007 Amendment A1's ratification carve-out for exactly those reasons | `sim/lock-detector/records/20260919-002812-1b12179.md` (the 205-point in-situ verdict); `sim/lock-window-trim/records/20260917-185928-8adff3d.md` (the 1872-point code map the trim rule's table comes from); `sim/lock-window-proxy/records/20260925-050022-6d57802.md` (DR-022's 117-point pad-referred-candidate verdict); `sim/lock-window-sizing/records/20260915-202802-79c0cee.md`; superseded predecessors `sim/lock-detector/records/20260731-162119-0a12e6c.md` and its immediate `sim/harness`-migrated successor `sim/lock-detector/records/20260802-050119-c24ee3a.md` (a tooling migration over the same 95-point matrix, not a value correction), which the DR-010 re-characterization `sim/lock-detector/records/20260916-052313-b1633b5.md` (#393) supersedes in turn — the untrimmed `20260916-122705-98c935b` and then the DR-014-trimmed re-run cited first above carry the claim from there |
| Kvco | ≤ 150 MHz/V under the band-selection rule | Worst 115.8 MHz/V (`all-fast`/27 °C/2.97 V, B6); an adversarial band choice reaches 154.3 MHz/V, over the line, which is why the rule is normative. **Measured over this campaign's 63-point PVT grid, a superset of the 45-point mandated grid** (§5.0) — the binding corner is an `all-fast` bundle the mandated grid does not contain | **MET**, conditional on the band-selection rule being followed | `sim/vco-tuning-range/records/20260731-175947-0a12e6c.md` |
| Supply range | 3.3 V ± 10 %, 3.3 V devices exclusively | Every campaign above sweeps 2.97/3.30/3.63 V | **MET, as the swept independent axis of every other row** | `spec/pll.md#supply-range` |
| Supply range, **5.0 V analog rail** | Challenge #5 asks analog blocks to operate across 3.3–5.0 V | **No 5.0 V-class device exists in this design; never simulated above 3.63 V** | **UNMET / not attempted** — the single most load-bearing gap in this proposal, stated plainly per §2.1 | This proposal, §2.1 |

No row above is relaxed, narrowed, or omitted to make it pass. Every row the
table reports as wholly or partly not met is listed here, by its own parameter
name, with the part that is not met — exactly as the underlying evidence
states, per `CLAUDE.md`'s "agents do not relax the ratified spec to make
results pass":

- **Output band, closed-loop** — no sustained in-window PASS at either
  drawn-band edge at any of the 45 mandated corners.
- **Reference input** — the levels, edge-rate and duty-range lines are budget,
  never measured; every jitter and spur number here assumes an ideal reference.
  The campaign that would measure them is declared and blocked on an aligned
  simulator rather than on compute: the batch job image's ngspice-42 does not
  converge on the variant carrying the binding 5.00 ns edge, where the pinned
  ngspice-46 does (DR-035). The image has since been realigned to ngspice-46 and the probe converges 6 of 6 (DR-039, #680); the grid itself is still unrun.
- **Period jitter, closed-loop, deterministic, at the 200 MHz band top** —
  declared, not measured; no jitter number at 200 MHz exists.
- **Reference spur** — over the line at the scaled 200 MHz binding point at 2
  of the 5 measured corners; the other 40 mandated points are unmeasured.
- **Lock time (small-signal settling)** — the Lock criterion it is timed to is
  not reached at 1 of the 45 mandated corners at a rule-compliant
  configuration, with a second corner's rule-selected run owed (DR-012,
  narrowed by DR-025).
- **Lock time, closed-loop cold-start / worst-case re-lock** — no closed PASS
  bound; most rows do not reach a sustained `LOCK` within the tested window.
- **Output duty cycle** — below the 45 % floor at the low-frequency band edge.
- **Lock detector** — T4/T5 uncharacterized below 25 MHz. T1′/T2′ are met only
  on a part trimmed to the rule, which no procedure available at this die's
  pads can perform (DR-022, DR-029).
- **Supply range, 5.0 V analog rail** — no 5.0 V-class device; never simulated
  above 3.63 V.
- **Area** — the first assembled `pll_top` measures 0.4078 mm², over the
  ≤ 0.30 mm² row (×2.217 top-level overhead against the ×1.664 the row holds
  to); the block sum alone still meets it. DR-041 holds the row and records
  it unmet; it is not re-derived to fit.

This list is machine-checked against the table rather than kept by hand:
`spec/lib/check-spec-row-coverage.sh` fails if a row whose Verdict says UNMET
or NOT MET has no bullet here, or if a bullet names a row that no longer says
so. Until 2026-09-26 it was a single hand-kept sentence, and it had drifted
three ways: it omitted four of the rows above outright (the 200 MHz band-top
jitter, the reference spur, the closed-loop cold-start lock time and the output
duty cycle), it still listed the lock detector's T1/T2 window as unmet after
#411's trim met it on a trimmed part, and it counted the Lock-criterion miss at
2 of 45 corners after DR-025 narrowed it to 1.
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
