2AMLogic/gf180-pll/spec/decision-records/DR-001-pll-architecture.md

# DR-001: PLL architecture selection — loop type, VCO delay cell, feedback divider

- **Status**: ratified (2026-09-08, #1; survey + recommendation, ratified with the
  target spec it feeds). Grandfathered by the operator ruling of 2026-10-02
  on #446 — see `spec/README.md`
- **Date**: 2026-07-30
- **Decided by**: Builder agent, issue #3
- **Related**: #1 (spec ratification — consumes this record), #6
  (decision-record template — had not merged when this record was written;
  format follows the convention that template states, see *Format note*
  below), #7 (open draft-spec ambiguities — sensitivities flagged in
  §"Sensitivity to the open spec questions in #7"), #8 (ring VCO / Kvco
  extraction — consumes Decision 2), #9 (PFD + charge pump + loop filter —
  consumes Decision 1), #11 (feedback divider — consumes Decision 3)

**Format note.** #6 will land a decision-record template adapted from the
sister repo `2AMLogic/gf180-bandgap`, whose `spec/decision-records/TEMPLATE.md`
prescribes `spec/decision-records/DR-NNN-<slug>.md` with sections Status /
Date / Decided by / Context / Decision / Alternatives considered /
Consequences. This record follows that convention ahead of #6 rather than
inventing a second one; if #6 ratifies a different shape, reformat in place
(this record is *proposed*, not ratified, so reformatting is not a rewrite of
ratified history). That template also says "one decision per record" — this
record deliberately carries three, because the three choices are mutually
constraining (§"Why these three are one decision"). If #6's one-per-record
rule is enforced strictly, split this into DR-001/002/003 preserving the text.

---

## Decision summary

| # | Question | Decision | Consumed by |
|---|---|---|---|
| 1 | Loop type | Type-II charge-pump PLL: tri-state PFD + charge pump + **passive** 2nd-order (R + C1, C2) filter. Fixed R/C, coarse (2-bit) Icp trim only. | #9 |
| 2 | VCO delay cell | **Single-ended CMOS inverter ring, current-starved** (matched PMOS head + NMOS tail devices), odd stage count (5 nominal), 3-bit **coarse band select** + fine analog Vctrl through a source-degenerated V→I converter. Dedicated `vdd_vco` domain. | #8 |
| 3 | Feedback divider | **Cascaded ÷2/3 (Vaucher) cells**, 6 cells with programmable chain length for continuous N = 4–64, static CMOS logic throughout, **final retiming DFF clocked by the VCO** before the PFD. | #11 |

Everything below is the rationale. Numbers marked *sanity check* are
first-order hand calculations used to disposition options, not design values —
#8/#9/#11 own the real sizing, and every number here must be re-derived from
extracted devices before it enters the spec.

---

## Context

The README target table is DRAFT (ratification is #1) and already fixes the
outer architecture: integer-N, ring-oscillator VCO. What it does not fix is
the loop type, the delay-cell style, or the divider architecture — and #8, #9
and #11 each declare themselves blocked on exactly one of those. This record
surveys the options and picks, so schematic work starts from a fixed
architecture instead of re-litigating it per block.

The draft targets that actually do work in this record:

- **Output 10–200 MHz** (stretch 10–400 MHz) — a **20:1** continuous tuning
  range (40:1 with the stretch). This is the single most architecture-defining
  line in the table.
- **N = ×4–×64 integer** — a 16:1 span that must be *continuous* over the
  integers, including small N.
- **Ref 1–25 MHz** (stretch 32 kHz) — a 25:1 span in the sampling rate of the
  discrete-time part of the loop.
- **Lock < 100 µs** (stretch < 20 µs).
- **Period jitter < 1% RMS** (stretch < 0.5%) — 10 ps RMS at 100 MHz.
- **Power < 5 mW @ 100 MHz** (stretch < 2 mW).
- **Area < 0.15 mm²** — the binding constraint on the loop filter.
- **Supply 3.3 V ±10%** (2.97–3.63 V), stretch 1.8 V core variant.

Two node facts shape the survey as much as the targets do:

- gf180mcu's open primitive set (`gf180mcu_fd_pr`) gives us `nfet_03v3` /
  `pfet_03v3`, MOS caps (`cap_nmos_03v3`, `cap_pmos_03v3`), MIM caps
  (`cap_mim_1f0fF` / `1f5fF` / `2f0fF`) and poly resistors (`ppolyf_u_1k` /
  `2k` / `3k`). Loop-filter capacitance is therefore cheap in *density* terms
  (MOS cap ≈ 4–5 fF/µm², to be confirmed against the PDK) but still the
  largest single area item in the block.
- The two open standard-cell libraries for this node (`gf180mcu_fd_sc_mcu7t5v0`,
  `gf180mcu_fd_sc_mcu9t5v0`) are **5 V-flavor** libraries. A 3.3 V-domain
  divider cannot simply instantiate them, so every divider flop is a
  custom-drawn 3.3 V CMOS cell in xschem. **Architectures are therefore scored
  partly on how few *distinct* custom cells they need** — this is a real cost
  here in a way it would not be in a node with a matching digital library.

Finally, the evidence rule from CLAUDE.md ("no claim without a testbench")
makes *verifiability in ngspice* a first-class selection criterion, not an
afterthought. An architecture whose headline advantage cannot be demonstrated
in this flow buys us nothing on the canary.

## Why these three are one decision

The three questions are not independent, and the coupling is the reason for
the specific combination chosen:

1. A **current-starved** ring has `f_osc ∝ I_ctrl`, so `Kvco = ∂f/∂V ∝ f_osc`.
2. The loop's unity-gain frequency for a type-II CP-PLL is
   `ω_c ≈ Icp·Kvco·R / (2π·N)`. With `N = f_out/f_ref` and `Kvco ∝ f_out`, the
   `f_out` terms cancel: **`ω_c ∝ Icp·R·f_ref`**.
3. So `ω_c/ω_ref` — the ratio that sets stability margin in a sampled loop —
   is approximately **invariant across the entire 10–200 MHz output band and
   the entire N = 4–64 range**, with a *fixed* passive filter.

That is what makes a fixed passive filter viable here (Decision 1) and it is
a property of the current-starved cell specifically (Decision 2); a
supply-regulated ring does not deliver it as cleanly. And the divider choice
(Decision 3) is constrained by the same 20:1 band: the divider must work at
10 MHz *and* 200 MHz, which rules out dynamic logic families. Recording the
three separately would hide the coupling.

---

# Decision 1 — Loop type

## Decision

**Classic type-II charge-pump PLL**: tri-state phase-frequency detector →
charge pump → **passive** second-order loop filter (series R + C1, shunt C2)
→ ring VCO → feedback divider. No active filter, no opamp in the loop path.
Filter R and C are **fixed**; the only programmability is a coarse (2-bit)
charge-pump current trim as a margin knob.
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
