2AMLogic/gf180-pll/sim/pfd-deadzone/corners/20260916-051356-8cedbba/pfd_operating_point.csv

# net charge per reference cycle and UP/DN pulse width at every (PVT corner | control voltage | phase offset) point -- the raw evidence the static-offset table reduces
# ref period 80 ns (12.5 MHz) -- sim/supply-sensitivity's own reference (100 MHz / N=8) | NOT the parent manifest's 25 MHz
# Icp trim code b1b0=10 (3 unit legs) | the nominal setting and the one sim/supply-sensitivity runs its closed loop at
# vctrl_v: control-node voltage | held by an ideal source (open loop)
# dphi_s: FB-relative-to-REF phase offset (s)
# qnet_c: net charge delivered to the control node per reference cycle (C) | positive = pump sourcing
# width_up_s/width_dn_s: UP/DN pulse width (s) at the per-corner mid-supply crossing | third reference cycle. An empty cell is an `optional` measurement that did not fire -- that polarity never crossed mid-supply.
process | temp_c | vdd_v | vctrl_v | dphi_s | qnet_c | width_up_s | width_dn_s
ff | -40 | 2.97 | 0.90 | -1n | -1.02617e-14 | 1.26315e-09 | 2.28389e-09
ff | -40 | 2.97 | 0.90 | 0 | -4.50028e-15 | 1.27894e-09 | 1.29919e-09
ff | -40 | 2.97 | 0.90 | 1n | -1.38667e-15 | 2.25507e-09 | 1.27391e-09
ff | -40 | 2.97 | 1.65 | -1n | -5.57285e-15 | 1.26356e-09 | 2.28797e-09
ff | -40 | 2.97 | 1.65 | 0 | -6.45508e-16 | 1.27256e-09 | 1.29623e-09
ff | -40 | 2.97 | 1.65 | 1n | 4.21574e-15 | 2.23432e-09 | 1.25678e-09
ff | -40 | 2.97 | 2.40 | -1n | -6.41289e-15 | 1.27174e-09 | 2.29863e-09
ff | -40 | 2.97 | 2.40 | 0 | -2.4669e-15 | 1.27756e-09 | 1.30434e-09
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
typical | 27 | 3.63 | 0.90 | 1n | -5.20634e-15 | 2.49261e-09 | 1.51285e-09
typical | 27 | 3.63 | 1.65 | -1n | -9.11174e-15 | 1.49643e-09 | 2.52338e-09
typical | 27 | 3.63 | 1.65 | 0 | -2.94092e-15 | 1.51158e-09 | 1.53809e-09
typical | 27 | 3.63 | 1.65 | 1n | 1.3039e-15 | 2.47443e-09 | 1.49905e-09
typical | 27 | 3.63 | 2.40 | -1n | -6.69233e-15 | 1.49718e-09 | 2.52965e-09
typical | 27 | 3.63 | 2.40 | 0 | -1.08781e-15 | 1.50672e-09 | 1.53877e-09
typical | 27 | 3.63 | 2.40 | 1n | 3.68227e-15 | 2.45399e-09 | 1.48401e-09
