2AMLogic/gf180-pll/sim/divider-ratio-dff/corners/20260801-125114-3f883e3/dff_setup_hold.csv

# tsetup_s/thold_s per PVT point | from the setup/hold ladder scan above -- the join input sim/divider-ratio-chain's retiming_margin.csv needs to close the retiming flop's setup budget
process | temp_c | vdd_v | tsetup_s | thold_s | tcq_r_s | tcq_f_s
typical | -40 | 2.97 | 5e-11 | 1e-10 | 2.26286e-10 | 1.95658e-10
typical | -40 | 3.30 | 2e-11 | 1e-10 | 2.07622e-10 | 1.80471e-10
typical | -40 | 3.63 | 2e-11 | 1e-10 | 1.93993e-10 | 1.69345e-10
typical | 27 | 2.97 | 5e-11 | 1e-10 | 2.57569e-10 | 2.21871e-10
typical | 27 | 3.30 | 5e-11 | 1e-10 | 2.36142e-10 | 2.04563e-10
typical | 27 | 3.63 | 2e-11 | 1e-10 | 2.20049e-10 | 1.91778e-10
typical | 125 | 2.97 | 5e-11 | 1e-10 | 3.012e-10 | 2.5954e-10
typical | 125 | 3.30 | 5e-11 | 1e-10 | 2.76065e-10 | 2.39474e-10
typical | 125 | 3.63 | 5e-11 | 1e-10 | 2.56789e-10 | 2.24213e-10
ff | -40 | 2.97 | 2e-11 | 1e-10 | 1.88351e-10 | 1.62779e-10
ff | -40 | 3.30 | 2e-11 | 1e-10 | 1.7512e-10 | 1.52276e-10
ff | -40 | 3.63 | 2e-11 | 1e-10 | 1.65172e-10 | 1.44468e-10
ff | 27 | 2.97 | 5e-11 | 1e-10 | 2.13445e-10 | 1.84241e-10
ff | 27 | 3.30 | 2e-11 | 1e-10 | 1.98236e-10 | 1.71953e-10
ff | 27 | 3.63 | 2e-11 | 1e-10 | 1.86672e-10 | 1.62765e-10
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
