2AMLogic/gf180-pll/sim/divider-ratio/corners/20260731-171815-0a12e6c/dff_setup_hold.csv

# campaign: divider-ratio/dff
# record_id: 20260731-171815-0a12e6c
# generated_utc: 2026-07-31T17:19:03Z
# pdk_variant: gf180mcuD
# pdk_open_pdks_hash: c6d73a35f524070e85faff4a6a9eef49553ebc2b
# pdk_root: /Users/rwalters/.volare/gf180mcuD
# model_file: libs.tech/ngspice/sm141064.ngspice (+ sm141064_mim.ngspice via mimcap_* sections)
# switches: design.ngspice defaults (sw_stat_global=0 | sw_stat_mismatch=0 -> nominal skew | no Monte Carlo)
# simulator: ngspice-46
# netlist: design/dff_tg_3v3.sch -> design/netlist/dff_tg_3v3.spice + sim/divider-ratio/testbench/tb_dff_setup.sp
# corners: process{typical | ff | ss | fs | sf} x temp{-40 | 27 | 125}C x vdd{2.97 | 3.30 | 3.63}V = 45 points
# tsetup_s: worst of the 0->1 and 1->0 banks | 10%-clk->Q-degradation criterion
# over the ladder ti = 1.00/0.20/0.10/0.05/0.02/0.00/-0.02/-0.05/-0.10/-0.15 ns.
# A value equal to the last ladder step means setup was never violated down
# to that step | i.e. the true setup time is at or below it.
# thold_s: most negative ladder step of th = 0.50/0.20/0.10/0.00/-0.10/-0.20/
# -0.30/-0.40/-0.50/-0.70 ns at which data arriving AFTER the clock edge was
# still not captured. Negative = data may move before the edge and still be
# safely excluded.
# tcq_r_s / tcq_f_s: relaxed-input clk->Q for the rising and falling output.
process | temp_c | vdd_v | tsetup_s | thold_s | tcq_r_s | tcq_f_s
ff | -40 | 2.97 | 2e-11 | 1e-10 | 1.88351e-10 | 1.62779e-10
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
typical | 27 | 3.63 | 2e-11 | 1e-10 | 2.20049e-10 | 1.91778e-10
typical | 125 | 2.97 | 5e-11 | 1e-10 | 3.012e-10 | 2.5954e-10
typical | 125 | 3.30 | 5e-11 | 1e-10 | 2.76065e-10 | 2.39474e-10
typical | 125 | 3.63 | 5e-11 | 1e-10 | 2.56789e-10 | 2.24213e-10
