2AMLogic/gf180-pll/sim/CHARACTERIZATION.md

# sim/ — aggregated characterization report

**Purpose.** `sim/README.md` documents each campaign's *methodology* and
migration status; `spec/pll.md`'s summary table states each parameter's
*target* and its overall status (measured / derived / budget / waived). Until
now, nothing pulled every campaign's *headline result* into one place with a
citation a reader can check without opening every campaign directory in turn.
This report is that aggregation: one row per `sim/*/records/` campaign
directory, each citing its own current evidence record(s) by path and content
hash.

This report does not create new evidence, re-derive any number, or relax
`spec/pll.md`. It transcribes what is already committed under `sim/` and
cross-references it against `spec/pll.md`'s own "Summary table" (line 66) and
"Verification owed" table (line 879) so the two documents cannot silently
disagree about what is and is not substantiated. Where they might read as
disagreeing, that is called out explicitly below rather than resolved in
either direction.

Filed against #147 (part of #127, the T1/bronze gap tracker), per #142/#143's
finding that no such aggregated artifact existed as of this repository's
2026-08-16 T1 re-read.

## How to read this report

- **Coverage.** One entry below for every directory under `sim/` that
  contains a `records/` subdirectory. At this report's original writing that
  was **20 campaign directories, 61 evidence records**; the tree has grown
  since, and the current count is **27 campaign directories, 112 evidence
  records**. Both figures are derived, not remembered: the records are
  `find sim -path '*/records/*.md' -type f | wc -l`, and the campaigns are the
  distinct `sim/<name>/` prefixes of those same paths — the enumeration
  `sim/lib/record-campaigns.sh` exports and both sim-side CI checks share.
  (An earlier revision of this bullet offered `find sim -maxdepth 1 -type d`
  for the campaign count; that counts every directory under `sim/`, including
  `harness/`, `lib/`, `tests/` and any campaign whose `records/` is still
  empty, so it never produced the number stated next to it.) `README.md`'s
  status section states the same pair as **112 evidence records across 27
  verification campaigns**; `sim/lib/check-readme-status.sh` grades that line
  against the tree on every CI run, and since #237's aggregate-count rule
  `sim/lib/check-characterization-coverage.sh` grades *this* bullet the same
  way. It needed to: for six weeks this bullet carried the counts of a much
  smaller tree — 19 records and 3 campaigns behind — *and* asserted that the
  graded README line agreed with those figures, which it had not for as long.
  Quoting a checked document is not the same as being checked, so a count
  stated here is now a build failure when it drifts rather than a sentence
  someone is expected to re-read.
- **"Latest record."** Record IDs are `<YYYYMMDD>-<HHMMSS>-<sha>`
  (`sim/README.md`'s naming convention), so a lexicographic sort of
  `records/*.md` gives chronological order for free. Unless noted otherwise
  under a campaign's own entry, "latest" below means the chronologically
  last record in that directory. **This is not always the same as "the
  current, citable record for a given claim"** — several campaigns mint more
  than one live record per directory (a DC bench and a switching bench, a
  raw measurement and a later re-classification, a full-grid record and a
  narrow single-corner diagnostic). Where that applies, the entry cites
  every record actually needed to state the headline result honestly and
  says so.
- **Content hash.** `sha256sum` of the record file itself (first 12 hex
  characters shown; recompute the full digest with
  `shasum -a 256 <path>` or `sha256sum <path>`). This is **not** the
  record's own `<record-id>` git-sha suffix (that names the repo commit the
  run was taken against) — it is a hash of the Markdown file's bytes,
  included so drift or tampering in a nominally append-only file is
  mechanically detectable. Records under `sim/` are never edited after
  creation (`sim/README.md`'s append-only rule), so a hash mismatch against
  this report at any later date means either this report has gone stale
  (the likely case — see "Maintenance" below) or the record's append-only
  guarantee was violated (worth investigating).
- **Status column.** Uses `spec/pll.md`'s own vocabulary where a campaign
  substantiates a numbered spec row (**measured** / **derived** / **budget**
  / **waived**), and a plain description for campaigns whose claim is a
  design-input decision rather than a spec line (`spec/pll.md`'s own
  "design-input claim" form — no ratified spec anchor, referenced by issue
  number instead).
- **What this report is not.** It does not restate every measured number —
  each campaign's record holds the full per-corner tables, raw logs, and
  methodology; this report exists to point at them, not duplicate them. Read
  the cited record for anything beyond the headline.

## Summary table

| Campaign | Latest record (path, sha256 prefix) | Headline result | Spec / issue reference | Status |
|---|---|---|---|---|
| `devchar-delay` | `sim/devchar-delay/records/20260801-084448-01b0db8.md` (`987bc2e2a231`) | Per-PVT-corner current-starved delay-cell drive/delay and ring frequency vs. starving current, 45-point grid. Overall PASS. **Re-qualified under open_pdks `f6eeac7` (#825, child of #790).** `sim/devchar-delay/records/20261114-010350-72be45d.md` (`a5697845ee8e`) re-runs the same 45-point grid through the same manifest on the batch fleet and supersedes the record cited above; all 315 graded per-corner verdicts are unchanged, stated limits are identical, and the worst relative movement anywhere in the grid is 0.030 % (`ch_tr` at `sf`/−40 °C/3.63 V). Deltas, and the single-corner ngspice-42 control run that attributes them to the simulator rather than to the PDK, are in `sim/REPIN-DELTAS-f6eeac7-devchar.md`. | #4 → #8 (design-input; feeds VCO stage sizing, no spec anchor of its own) | design-input, measured |
| `devchar-cp` | `sim/devchar-cp/records/20260801-102353-79f398e.md` (`ab2c61a7368c`) | Output resistance and compliance-knee ladder for 6 candidate charge-pump mirror stacks, 45-point grid. Overall PASS. Superseded predecessor `20260731-041340-833292f` still carries one column family (`vcomp_ro50`) and a decimated-curve artifact this migrated record does not reproduce — and, being superseded by a cited successor, it is deliberately **not** re-qualified by #825; those two columns still rest on `c6d73a3`, because the legacy `xargs -P` runner that minted them has no batch backend and a harness manifest cannot express a threshold crossing of a derived quantity. **Re-qualified under open_pdks `f6eeac7` (#825, child of #790).** `sim/devchar-cp/records/20261114-012159-cd5e8ce.md` (`4f7bb99bc33d`) re-runs the same 45-point grid through the same manifest on the batch fleet and supersedes the record cited above; all 315 graded per-corner verdicts are unchanged, stated limits are identical, the worst relative movement anywhere in the 45-corner × 6-stack grid is 3.3 ppm, and every `ro30`/`ro50`/`ro70` column — the family the superseded record warned was numerically delicate — is identical to the last printed digit at every corner. Deltas, and the single-corner ngspice-42 control run that attributes them to the simulator rather than to the PDK, are in `sim/REPIN-DELTAS-f6eeac7-devchar.md`. | #4 → #9 (design-input; feeds CP mirror-stack choice, no spec anchor of its own) | design-input, measured |
| `devchar-passives` | `sim/devchar-passives/records/20260801-102454-79f398e.md` (`a3334ef1c371`) | MIM-vs-MOS-cap C–V linearity, density, and leakage comparison, full passive-corner grid. Overall PASS — feeds the loop-filter cap-type decision (`spec/pll.md#area`). **Off the mandated grid in both directions at once**, as the record's own corner field declares: 9 points across 3 bundles (`typical`/`all-fast`/`all-slow` × 3 temperatures) at 3.30 V only — the passive axes are swept to their `ff`/`ss` extremes, which the mandated grid never reaches, while the five MOS bundles and the ±10 % supply axis are not swept at all, because the DUT is ten capacitors with no active device and its own 0 → 3.63 V C–V ramp already spans the supply range. **Re-qualified under open_pdks `f6eeac7` (#825, child of #790).** `sim/devchar-passives/records/20261114-005851-658a7fd.md` (`416692e6e73c`) re-runs the same 9-point grid through the same manifest on the batch fleet and supersedes the record cited above; all 99 graded per-corner verdicts are unchanged and stated limits are identical, but this is the one bench in the group whose numbers moved: the four **MOS**-cap topologies' `leak_*` goes from identically zero to about −0.9 nA at every corner, which propagates arithmetically into `imin_*`, `dmin_*` and `cvr_*` (worst 0.35 %). The ngspice-42 control run returns zero leakage under `f6eeac7`, so this is ngspice-47 and not the models, and every **MIM** row — the family this campaign's conclusion rests on — is unchanged to within attoamp solver noise. Deltas, and the single-corner ngspice-42 control run that attributes them to the simulator rather than to the PDK, are in `sim/REPIN-DELTAS-f6eeac7-devchar.md`. | #4 → #10 (design-input; feeds loop-filter cap choice) | design-input, measured |
| `divider-ratio` *(pre-harness, superseded runner — see caveat below)* | `sim/divider-ratio/records/20260731-171817-0a12e6c.md` (`1de4c63bc587`) | 235-point chain-ratio sweep: 0 of 235 points measured a ratio other than N; 61 distinct N values exercised at 200 MHz. Retiming setup closure at N=64/200 MHz: worst margin **3.03e-10 s (6.1 % of a VCO period)** at `ss`/125 °C/2.97 V — **this is the number `spec/pll.md`'s summary table row 3 cites.** | `spec/pll.md#multiplication-ratio` (row 3); #11 → DR-001 Decision 3 | **measured** |
| `divider-ratio-dff` | `sim/divider-ratio-dff/records/20260801-125114-3f883e3.md` (`135fe22b5a86`) | `dff_tg_3v3` setup/hold/clk→Q across the full PVT grid — the retiming flop's timing-budget input joined into `divider-ratio-chain`'s margin table. Overall PASS. | #11 (design-input; migrated sibling of `divider-ratio`) | design-input, measured |
| `divider-ratio-cell` | `sim/divider-ratio-cell/records/20260801-140529-3f883e3.md` (`0e821b673dc6`) | Single `div23_cell` moduli (÷2/÷3) on both output edges and both input duty cycles, top/bottom of the band, full PVT grid. Overall PASS at every point. | #11 (design-input; migrated sibling of `divider-ratio`) | design-input, measured |
| `divider-ratio-chain` | `sim/divider-ratio-chain/records/20260802-100727-082c879.md` (`2c7911871d5f`) | Full 6-cell chain ratio + retiming setup closure, migrated onto `sim/harness`. Worst setup margin **3.0283e-10 s (6.1 %)** at `ss`/125 °C/2.97 V — reproduces the pre-migration `divider-ratio` number above; worst hold margin 2.00e-09 s. 0 of 17 evaluated points closed with negative margin. | `spec/pll.md#multiplication-ratio` (row 3, reproduces it); #11 → DR-001 Decision 3 | **measured** (migrated) |
| `lock-detector` | `sim/lock-detector/records/20260919-002812-1b12179.md` (`247ecf875bc8`) | Window-comparator assert/deassert behavior at every PVT corner, **205 points, clean tree** — the **trimmed** `delaywin_3v3` (DR-014, #411) with each corner bundle at the code the [Lock-detector window trim-code rule](../spec/pll.md#lock-detector-window-trim-code-rule) selects for it (c3 `ss`/`all-slow`, c6 `fs`, c7 `typical`/`sf` + the six passive-only bundles, c11 `ff`/`all-fast`). Those thirteen bundles are a **13-bundle, 117-point PVT grid**, a superset of the mandated 45 — and one that moves nothing here: the eight added bundles re-skew only the passive `.lib` sections, and all 72 of their points reproduce their MOS twin's `twin_r`, `twin_f` and verdict to the digit in `raw_measures.csv`, so every number below binds at a mandated-grid bundle. Supersedes `20260916-122705-98c935b.md`, which measured the untrimmed W = 9.5 µm cell over the same claim. **T1′ and T2′ are both met, the first time T2′ has been**: window edges **1.14 / 1.16 ns** at `fs`/−40 °C/3.63 V (T1′, **+14 … +16 %** above the 1 ns lower edge) and **1.78 / 1.80 ns** at `ss`/125 °C/2.97 V (T2′, **10.0 … 11.0 % below** the 2 ns upper edge), each resolved to 0.02 ns at the corner it binds at — against the untrimmed cell's [2.02, 2.04) ns, 1.0–2.0 % past budget. **Observable PVT spread 1.53 … 1.58×** against DR-013 Decision 4's ≤ 1.65× and 1.91–1.96× untrimmed; ≤ **1.62×** as a bound that does not depend on the ladder's resolution anywhere but those two corners (`WIDE = ERR · ERRD` is empty below `t_win`, so the observable is never smaller than `t_win`, whose minimum over all 205 points is 1.1084 ns). **This is the number `spec/pll.md`'s summary table row 16 cites.** Behaviour is unchanged by the trim: 0 of 205 points fail the four-check acceptance, 0 false asserts on a large static phase error or a frequency error, worst deassert latency 5.63 ns (`sf`/125 °C/2.97 V), assert-from-cold 0.680 … 1.913 µs, `t_win` 1.108 … 1.740 ns. **T1′ binds at a different bundle than it did untrimmed** — `fs`, not `ff` — because the rule pulls every bundle toward the same reference-condition target, so which one is narrowest at its own PVT extreme becomes a measured question. **Still owed**: a 0.02 ns refinement at `ff`/−40 °C/3.63 V and `ss`/−40 °C/3.63 V (coarse ladder only there, edges bounded to [1.0, 1.2) ns), T4/T5 below 25 MHz, and extraction + mismatch (#18). **`sim/supply-sensitivity` at the new window is now partly discharged** (#417, `20260920-180604-0f91a9b`): DR-013's window-vs-offset crossing is measured in one closed loop and **confirmed** at both cells DR-013 names — `typical`/−40 °C/3.63 V asserts against a settled 0.8135 ns offset, `ff`/27 °C/3.63 V does not against 1.233 ns — but that is a declared 2-cell subset, so a trimmed-window **full-grid** run of that campaign is **#437**. | `spec/pll.md#lock-detector` (row 16), `spec/pll.md#lock-detector-window-trim-code-rule`; #11 → DR-002 Decision 4; #393 → #401 → DR-013 → #407 → DR-014 → **#411** | **measured** (205 points); targets **met** (T1′/T2′), conditional on the trim rule; T4/T5 still uncharacterized |
| `lock-window-sizing` | `sim/lock-window-sizing/records/20260915-202802-79c0cee.md` (`c0e40498bac3`) | 10 `delaywin_3v3` MOS-cap sizings × the full 13-bundle, 117-point PVT grid — 1170 points, all measured. The campaign's control (the committed cell as drawn) reproduces `lock-detector`'s own window at both binding corners to within 0.3 % / 0.9 %, tying the ladder's baseline to committed evidence. **W = 9.5 µm is the only sizing holding the window inside DR-010's `1 … 2 ns` band at every corner simultaneously** (1.017 … 1.956 ns, +1.7 % / +2.2 % of margin), bracketed on both sides by W = 9 µm (below) and W = 10 µm (above) — but see `lock-detector`'s row above: this idealized-stimulus margin did not survive the full-loop, realistic-edge-rate re-characterization at the same T2′-binding corner (#401). **DR-013 Decision 1 makes that structural**: this campaign measures `t_win`, T1′/T2′ bound the flag's observable, and the two differ by δ — so the ladder remains the sizing coordinate but is no longer sufficient evidence for a T1′/T2′ verdict on its own. The retired T1 (≥ 2.5 ns everywhere) is first met at **W = 26 µm**, where the window reaches **4.924 ns** — the flag would assert on a part 4.9× outside the 1 ns criterion it observes. The window's PVT spread falls only 1.928× → 1.906× across that 3.25× sizing range, and does not move at all when the eight passive bundles are added: geometry re-centres the window, it does not narrow it. Its own 0.5 µm ladder step (4.6–4.8 % of window) is the trim-step granularity DR-014 sized its quantization margin against — and the trimmed cell #411 built lands a **2.7–4.7 %** step instead, so this ladder is the coordinate the trim's own step was chosen relative to rather than the trim's own evidence (that is `lock-window-trim`). **This campaign is now historical for the T1′/T2′ verdict**: the DUT it characterises — a single fixed MOS-cap sizing — no longer exists in the design, which carries the trimmed cell. It is kept as the measurement that established the spread-is-a-property-of-the-topology finding DR-013 Decision 4 rests on. **Schematic-level, no mismatch** — see the record's own limitations. | `spec/pll.md#lock-detector` (row 16); #387 → DR-010; implemented by #393, T2′ margin question decided by DR-013 (#401), sized by #407, mechanism picked by DR-014, implemented and re-characterized by #411 | **measured** (1170 points); **superseded as the design's sizing basis** by the trim (#411), and retained as the evidence that no sizing of that topology could meet DR-013 Decision 4 |
| `lock-window-trim` | `sim/lock-window-trim/records/20260917-185928-8adff3d.md` (`5284862db783`) | The **trimmed** `delaywin_3v3`'s code-to-window map and the code table the [Lock-detector window trim-code rule](../spec/pll.md#lock-detector-window-trim-code-rule) is built from — 16 trim codes × the full 13-bundle, 117-point PVT grid, **1872 points, all measured, clean tree**. The successor axis to `lock-window-sizing`'s geometry ladder, and deliberately a separate campaign rather than a second axis on it: the DUT is a different circuit (DR-014's trimmed cell, #411), and the swept quantity is a **real pin on the committed cell** rather than a parameterised replica's parameter — so there is no replica-vs-control agreement column to prove, and what is swept here is exactly what `lock-detector` instantiates. **The code-to-window map is monotonic at every corner** (0 of 195 adjacent steps non-monotonic) — the property the cell's weight-scaled pass gates buy and an unweighted switch would break, checked per corner rather than asserted. Step **2.7–4.7 %** of window, full range **1.69×** against a **1.30×** fastest-to-slowest reference-condition spread, so the range is centred with headroom at both ends (3/12 codes spare at `ss`, 11/4 at `ff`). **With the rule applied every bundle is in band at every one of its own PVT points**: **1.106 … 1.726 ns** against the ratified [1, 2] ns band (+10.6 % / +13.7 % at the binding edges), grid spread **1.561×**, and **1.610×** for a continuous process population — the pessimistic reading that adds one whole trim step of un-applied correction on top of the worst within-bundle spread, and the number to compare against DR-013 Decision 4's **≤ 1.65×**. **No single fixed code substitutes for the rule**: the one-code spread is 1.977–1.988× at *every* one of the 16 codes, and the two closest both miss the band (code 6 falls to 0.9746 ns at `all-fast`/−40 °C/3.63 V, code 7 reaches 2.0029 ns at `ss`/125 °C/2.97 V). This measures the **bare chain** — the quantity the code moves and a tester can measure; the **observable** window DR-013 Decision 4's target is stated against is measured through the assembled loop in the `lock-detector` row above, at the codes this record selects. **Schematic-level, no mismatch** — a segment-to-segment mismatch inside one stage's binary array would appear as trim DNL and is not characterised here; #18 must re-take this before the code table is final. | `spec/pll.md#lock-detector-window-trim-code-rule`; `spec/pll.md#lock-detector` (row 16); DR-013 Decision 4/6 → DR-014 → **#411** | **measured** (1872 points); spread target **met** (1.610× continuous against ≤ 1.65×) |
| `lock-window-proxy` | `sim/lock-window-proxy/records/20260925-050022-6d57802.md` (`bdb84dc32ec8`) | **Can a tester execute the trim rule from the pads? No — measured, not assumed.** The four candidates `pll_top`'s pad list offers, each paired at every one of the full 13-bundle, 117-point PVT grid's points with the committed `delaywin_3v3`'s own **sixteen-code** window map measured in the same run, each calibrated at **one** bundle (`typical`) and scored at the other twelve, against a **no-measurement control** (every part left at the power-up code 8). The window half of the pairing is validated rather than assumed: 1872 shared points against `lock-window-trim`'s single-copy campaign agree to **0.999988 … 1.00001**, geometric mean 0.999999. **The free-running ring period read at `CLK` is worse than not trimming at all** — 2.434× window spread against the untrimmed control's 1.984×, out of the ratified band at both edges, worst code error 8 of 16 — and the campaign measures *why*, in two independent mechanisms a MOS-only sweep could not have shown: `t_win` is invariant to all six passive-only bundles to four significant figures (every device in `delaywin_3v3` is an `nfet_03v3`/`pfet_03v3`) while the ring is starved through three `ppolyf_u_3k` bias resistors (DR-009), so `res_ff`/`res_ss` move its period **∓27 %** against a window that does not move at all; and across the MOS axis its sign is **inverted**, the ring running 6 % faster at `ss` where the window is 16 % slower. Both ring operating points (band 4 / 1.80 V and band 7 / 2.70 V) behave identically, so this is the topology, not the read point. **The two pad-to-pad digital skews are far better and still insufficient**: `CLK`→`DIVOUT` leaves a **1.132×** residual on the window's 1.316× process spread and holds the ratified [1, 2] ns band at all 117 points, but lands at **1.697×** grid spread (1.74–1.78× once one trim step of rounding is added for a continuous population) against DR-013 Decision 4's **≤ 1.65×**, and its worst code error of **+4** is one code outside the +3 bound DR-022 Tier A derives — every error it makes is positive and the +3/+4 bundles are the fast ones with the most upward headroom, so the band survives on where this grid's thirteen bundles sit rather than on a property of the selector. `CLK`→`FB` is worse (1.735×), sunk by a single outlier: the transmission-gate flop's clock-to-Q at `ff` is 0.557× typical against a window at 0.882×. **Limitations** — schematic-level on both sides of every mapping, no mismatch, thirteen bundles are not a process distribution, and the skews are measured between **on-die** nodes while a tester measures pad to pad (`design/` carries no output pad driver for `FB`, `DIVOUT` or `LOCK` at all). Unaffected by **#515**: the window phase instantiates `delaywin_3v3` directly and drives all four trim pins itself. | `spec/pll.md#lock-detector-window-trim-code-rule` (the Executing-the-rule-at-test subsection); `spec/pll.md#lock-detector` (row 16); **DR-022** ← **#501** | **measured** (117 points, 234 decks, clean tree); the question is **answered in the negative** — no present pad-referred quantity may be written into `spec/` as the rule's execution route |
| `lock-window-bisection` | `sim/lock-window-bisection/records/20260925-162032-e341b58.md` (`80b9071f4477`) | **Can a `REF` phase step read at `LOCK` execute the trim rule? No — and not for want of resolution.** DR-022 Decision 5 named two routes to executing the normative [trim-code rule](../spec/pll.md#lock-detector-window-trim-code-rule) on silicon and authorized neither; this campaign measures the first, the one needing no design change and no new pad. Closed-loop `pll_top` phase-step ladder at the rule's own reference condition — **13 points, a declared 3-bundle subset at 27 °C / 3.30 V**, each bundle at the code the rule selects (typical 7, `ff` 11, `ss` 3), both step directions, f_out = 100 MHz / f_ref = 12.5 MHz / N = 8 / band 5 (`sim/supply-sensitivity`'s operating point, chosen because it is the only committed closed-loop cell where the flag is known to assert). **Checkbox 1 — the deassert IS observable at the pad**: `VWIN` at 3.2865 V of a 3.30 V rail before the step, `LOCK` to ground **80.3–163.1 ns** after it (one to two reference periods, *not* the 5.63 ns `spec/pll.md` records for a large perturbation) and low for **1.04–1.37 µs**; no chatter, no intermediate state. **Checkbox 2 — the threshold is not `t_flag`**: at `typical`/code 7 both directions bracket at **2.200 ± 0.200 ns** against the **1.3769–1.4529 ns** the committed 16-code map and the measured flag-to-chain excess support — **+55.5 %**, i.e. **−12.6 codes** at the measured 50.4 ps per code. **DR-022 Decision 2 Tier A FAIL and Tier B FAIL**, by 3.7× the measurement's own bracket and 19× the reference interval's width, so no finer ladder reaches it. Cause, measured not inferred: `t_flag` is a per-cycle *charge balance* in the `VWIN` integrator while a step threshold is a *stored-charge* question — the excess is an additive time set by `C_VWIN`, the Schmitt's falling threshold, the discharge device and the loop bandwidth, four quantities that are not the delay chain and move independently of it. **Checkbox 3 — untestable here and moot**: the symmetric pair returns φ_ss = 0.000 ± 0.200 ns against a directly-measured 0.1327 ns (UP/DN pulse-width cross-check 0.110 ns), consistent but unresolved — and a perfect cancellation still returns the wrong quantity. **`ff` and `ss` returned no threshold**: their flag was never asserted (static offset −1.760 / +1.604 ns at the step instant against 1.363 / 1.356 ns windows), so all six points carry `FAIL — lock_pre`; the pre-step window reaches the integrator's rail but not the loop's slowest pole, so that is a property of this run, not of those bundles. **Still owed**: nothing on this route — DR-029 closes it and names DR-022's output-side `ERR`/`ERRD` observation tap as the successor, which needs its own decision record. Two reduction defects the run exposed are fixed in `derive.py` *after* it (wrapped edge-pair phase — the #273 hazard — and a bundle with no asserted baseline labelled `upper_bound` instead of `no_baseline_assert`); the record is append-only and carries the pre-fix labels, and its own per-point `FAIL — lock_pre` verdicts are what make them readable. The 45-rung ladder was shaped for and submitted to the off-host batch backend first; the execution layer refused every job (`only 0 subnet/AZ(s) resolved, floor is 3`), which is why 13 rungs ran locally at `-j 2`. | `spec/pll.md#executing-the-rule-at-test--the-rule-is-normative-and-on-this-die-it-is-executable-only-in-simulation`; #527 → **DR-029**; DR-022 Decision 5 route 1 (closed), route 2 (successor); DR-026 (#515, the `LDT3` precondition, met) | **measured** (13 points, declared 3-bundle reference-condition subset); route **not viable** — Tier A and Tier B both **FAIL** at the one bundle whose flag was asserted |
| `loop-dynamics` | `sim/loop-dynamics/records/20260731-202550-82af5a9.md` (`004d3ad7c9ad`); superseded by `sim/loop-dynamics/records/20261111-092132-343bafa.md`, the full batch-backend re-run (an 81-point, 27-bundle passive-box grid, not the mandated 45-point one) whose `baseline_comparison` reproduces this baseline (pilot gate GO) | Loop-filter component extraction, area (C1 = 0.0303 mm², 20.2 % of the 0.15 mm² budget), the Icp trim-code rule (`spec/pll.md`'s normative "Icp trim-code rule"), and small-signal lock-time estimates (71 µs at f_ref = 1 MHz, structural floor 43 µs — **the number `spec/pll.md`'s summary table row 9 cites**). **Overall: PASS on the contracted operating space, FAIL off it** (i.e. only when the Icp trim-code rule is followed). | `spec/pll.md#loop-bandwidth`, `#phase-margin`, `#lock-time` (rows 8/8a/9), `#area`; #4/#8/#9 → #10 | **measured**, conditional PASS |
| `mc-cp-mismatch` | `sim/mc-cp-mismatch/records/20260927-102154-d004d5b.md` (`816adc05c656`, #597) — **supersedes** `20260923-095854-1655e11.md` (`bcb946f651e9`) for this claim at a widened corner axis (3 → 21 points), which itself **supersedes** `20260817-135712-0e9cfc9.md` (`873f8454df68`) at raised sample counts; the nominal-only `sim/mc-cp-mismatch/records/20260731-212614-640560e.md` (`b4a7026934b3`) stands as historical evidence, not superseded. **Negative control, committed rather than described (#602)**: this campaign's control used to live only in a record's Methodology field, as a manual re-check at one corner and one sub-campaign that produced no artifact. `sim/mc-cp-mismatch/records/20260927-093235-b994116.md` replaces it with a committed one covering all 4 sub-campaigns at all 3 sampled corners: same seed reproduces, a different seed moves the result, and `sw_stat_mismatch = 0` is seed-independent -- 36 of 36 legs PASS, re-derivable from committed bytes with `run.sh --recheck-control 20260927-093235-b994116` and with no simulator. It re-measures no mismatch statistic and supersedes nothing above. | **The corner axis is now 21 of the 45 mandated points, and that closes T1/bronze item 6's corner-combination sub-criterion (#127, #597).** The grid is `typical/27C/3.30V` plus **all 20 vertices** of the process × temperature × supply box — every one of the five MOS bundles crossed with both temperature extremes and both supply extremes — so the 24 unvisited points are exactly those interior on temperature and/or supply at a bundle whose ends are both measured. `fs` and `sf` are measured here for the first time in this campaign. **Three of the four terms' binding corner moved to a point the old 3-point diagonal subset did not contain, two of them to a newly added mixed bundle**: term 1 binds at `sf/−40 °C/3.63 V` at **17.0863 %** (85.4 % of the ±20 % budget, 7.6 standard errors inside it), terms 3 and 4 at `sf/125 °C/3.63 V` (**5.56626 fC** and **1.02467 ns**), term 2/2a at `ss/125 °C/3.63 V` (**552.6 ps**, roughly double the superseded record's 275.4 ps). **All four terms still PASS.** The record separates the two things that changed — the axis, and the execution host — by re-reading the shared corner `ff/−40 °C/3.63 V` that both grids contain, and finds the host effect on term 1 is −0.55 pt while the axis effect is +0.16 pt. **It also documents, for the first time here, that `.option rndseed=N` reproduces a Monte Carlo draw only within one build on one machine**: the same corner and the same seed 1 read +6.4859 % on the superseded record's Linux/x86-64 host and +3.7754 % here, a different sample rather than solver noise, so a cross-host Monte Carlo re-run is an independent replicate and not a reproduction (contrast DR-028, which measured this repo's cross-host floor on a *deterministic* quantity). **One figure this moves was owed elsewhere, and is now priced**: term 3's statistical residual is an input to `spec/pll.md`'s reference-spur derivation, which DR-018 priced at 4.25246 fC, and the widened grid's worst corner reads 5.56626 fC. The record flags that and deliberately does not re-derive the ratified stack — per CLAUDE.md that is a decision record's job, not a campaign runner's, and **DR-034** (#610) is that record: the charge stack's three derived rows move to 9.24 / 12.43 / 12.97 fC (−58.6 / −56.0 / −55.7 dBc), term 1 keeps its ±20 % budget, and the ratified ≤ −55 dBc line is still cleared — by 0.67 dB stacked, 1.79 dB read corner-consistently. History of the same claim at the older 3-point axis follows. Monte Carlo mismatch-only dispersion COMBINED with a 3-point PVT corner subset (`typical/27C/3.30V`, `ss/125C/2.97V`, `ff/-40C/3.63V` — see that record's Corner-matrix field for the reduced-grid justification), closing the T1/bronze checklist gap (#127 item 6) the nominal-only record left open. At n = 100/corner (`N_DC`, raised by #482) **term 1 measures 13.2172 % at `ff/-40C/3.63V`** — 4.4 standard errors past the ±12 % budget in force when the record was minted, where the superseded n = 20/corner record read 11.72 % and passed on a margin smaller than its own sampling noise. **That exceedance is resolved by DR-018 (#483), not by the measurement**: the budget was re-derived from the ratified ≤ −55 dBc reference-spur line and widened to **±20 %**, which the same 13.2172 % fits at 66 % utilisation. The record keeps its FAIL verdict and its bytes (append-only); the campaign runner now checks against ±20 %. **#487 then corrected the statistic that 13.2172 % is**: it is `mean(\|x\|) + 3·sd(\|x\|)` on samples folded to their absolute value, which the record and the budget table both labelled `\|mean\| + 3σ` / "3σ". On the same committed 300 samples the signed `\|mean\| + 3σ` — the statistic the budget column actually describes, and the one the runner now reports and takes the verdict on — is **17.4798 %** (87.4 % of ±20 %, still a PASS; DR-018 priced both readings). Re-derive either from the committed CSVs with `sim/mc-cp-mismatch/testbench/run.sh --restat 20260923-095854-1655e11`. Terms 2/2a, 3 and 4 were re-checked for the same folding defect, never had it, and pass as measured: 275.4 ps against ±3 ns, 4.25 fC against ±20 fC, 864.4 ps against ±3 ns (0.871 ns including the divider-retiming flop's clk→Q mismatch 3σ). Feeds the reference-spur derivation (`spec/pll.md#reference-spur`, "Statistical residual net charge" step — DR-018 refreshed that derivation to −56.6 dBc with the 3-point axis' corner-combined terms folded in, and **DR-034** re-prices it to **−55.7 dBc** with this record's 21-point ones). | #15, #146, #482, **#597** → **#483 → DR-018**, **#610 → DR-034**; feeds `spec/pll.md#reference-spur` (row 7, derived) | design-input / distribution claim, **measured at 21 of the 45 mandated PVT points — every vertex of the process × temperature × supply box, plus nominal (#597)**, which is what makes T1/bronze item 6's corner-combination sub-criterion scoreable rather than recurring; all four terms PASS, with three of the four binding at corners the prior 3-point axis did not contain. Term 1's budget was **amended** by DR-018 rather than met as originally stated. **Owed when this record landed, closed by DR-034 (#610)**: term 3's worst-corner statistical residual is 5.56626 fC where DR-018's reference-spur stack priced 4.25246 fC, and that re-pricing belonged in a decision record rather than in this campaign — DR-034 re-derives the stack from this record's own committed CSVs, leaving the ratified spur line cleared by 0.67 dB stacked (1.79 dB corner-consistent) and every budget in `design/README.md`'s mismatch table unchanged |
| `reference-spur` | `sim/reference-spur/records/20260816-132150-5f405e7.md` (`f99061a2855f`) | First **direct** closed-loop spur measurement in this repository: the ±f_ref sidebands read out of the locked `pll_top` output spectrum at 5 spanning PVT corners (all five MOS bundles, all three temperatures, all three supplies), f_ref = 25 MHz / N = 6 / f_out = 150 MHz / band 6 / Icp code 0. Measured **−57.0 dBc worst** (`sf`/−40 °C/2.97 V) to −72.7 dBc best (`fs`/125 °C/3.63 V) — **PASS against the −55 dBc target at the measured 150 MHz at every corner**; scaled by +2.50 dB to the ratified band's binding 200 MHz the two cold corners read −54.5 and −54.9 dBc and **do not clear the target**, so the overall record verdict is FAIL on that scaled check. Residual settling drift (`drift_q_fc`, −1.60…+2.78 fC against the 2.16–3.68 fC charge-pump asymmetry) is of either sign and is the dominant per-corner uncertainty; the first-to-last-window spread reaches 11 dB. **Taken against a dirty working tree** — see its Netlist provenance field. The direct measurement at the binding 200 MHz is a separate, declared-and-unmeasured campaign, `sim/reference-spur-band-top` (**#533**, DR-024); this record is not superseded by it and remains the evidence for its own 150 MHz operating point. Device mismatch is **off** here, so this number is comparable with the derivation's systematic-only −66.6 dBc row rather than with DR-018's −56.6 dBc systematic + statistical stack (DR-024 Decision 4). | `spec/pll.md#reference-spur` (row 7); #145 (part of #127), closed — re-pointed to **#533** by DR-024 | **measured** (5 of 45 corners, at 150 MHz); target **not met** once scaled to the 200 MHz binding point |
| `reference-phase-transfer` | `sim/reference-phase-transfer/records/20260925-080736-b722f33.md` (`69d7780069b2`) — **supersedes** `20260925-074549-1f4b734.md` (`cb2a3b717935`, same method and grid, 2 of its 5 points lost to the batch-backend output collision described below), which supersedes `20260925-073001-ed38ff1.md` (`deb998a68c36`, the single-run differencing this campaign started with and its own guards rejected). All three stay committed; the chain IS the method's history. | **The first measurement in this repository of the `20·log₁₀(N)` reference-to-output phase transfer `spec/pll.md`'s reference-source-quality exclusion states**, and the first testbench here to displace the `REF` edge **in time** at all (every other REF-driving deck varies its waveform shape, or nothing). A single known 1 ns reference phase step is applied inside the closed loop and read out through the loop's own REF-vs-FB static phase error — **differentially against a paired control run**, the same deck with the step switched off (`tb.json`'s `phases`), because the loop's static phase error is still winding by up to 1.4 ns across the measurement window at this release point and a single-run difference measures the step and that drift added together. Operating point and PVT subset are `reference-spur`'s exactly (N = 6, band 6, Icp code 0, f_ref = 25 MHz, f_out = 150 MHz; 5 spanning corners — all five MOS bundles, all three temperatures, all three supplies), reusing that campaign's own `vco-tuning-range`-derived `vstart` table verbatim. **Measured in-band transfer 15.529 … 16.366 dB against the `20·log₁₀(6)` = 15.563 dB the spec states — error −0.035 … +0.803 dB, 5/5 PASS.** The loop tracks 903 … 1004 ps of the 1 ns step; the untracked residual is −4 … +97 ps, against a differencing noise floor the record measures rather than assumes (`pair_resid`, the paired decks' disagreement *before* the step where they are still the same run: −10 … +26 ps, an ngspice source-breakpoint effect, not a divergence). So the multiplication holds to about **1 dB**, not to three digits, and the record says which. `drift_ctl` — the baseline the pairing removed — is −1.410 … +0.085 ns, up to **15×** the residual reported. **The roll-off comes out of the same pair**: read 120 ns after the step (0.3–1.2 of the 100–400 ns loop time constant `loop-dynamics` measured here) the transfer is −16.77 … −5.99 dB, i.e. **21.6 … 32.7 dB below** the in-band figure — a reference perturbation faster than the loop can follow does not reach the output multiplied by N. That is one frequency point, not a swept curve. Guards: `nmeas` 5.99984–6.00012, `fout` 150.007–150.032 MHz, `dn_lvl` 0.109–0.209 against the 8.9e-4 integration floor, `settle_resid` −52 … +73 ps inside its ±100 ps band at every corner. **Still owed** (DR-027 Decision 4): other N (this is N = 6 only), a swept transfer function rather than two frequency points, the remaining 40 PVT points, the passive process axes, and extraction (#18). **Not evidence about lock** — the design's own detector does not assert at four of these five corners at this release point, which the differential does not depend on; that is row 16's and #437's question. **And that non-assert is at the window trim's effective code 0, not the programmed code 8**: all three records were taken on the pre-DR-026 `pll_top` export that leaves `LDT3` unconnected (#515), so the detector saw `code & 0b0111` = 0 — the narrowest window the trim offers, and not a code the trim-code rule selects for any bundle. The measured transfer above is unaffected (the trim pins reach only `delaywin_3v3`, and the detector's outputs drive nothing inside `pll_top`); DR-027 Amendment A1 records it, and `sim/lib/check-record-trim-connectivity.sh` now grades this class in CI. **Taken against a dirty working tree, and on the execution layer's pinned ngspice-42 rather than the ngspice-46 the rest of `sim/` was measured on** — both on the record's own face. | `spec/pll.md#reference-input` (row 2's source-quality exclusion); #509 → **DR-027**; DR-019 Amendment A3 (the ideal-reference premise, re-argued rather than re-asserted) | **measured** (5 of 45 corners, at N = 6); the stated `20·log₁₀(N)` figure **confirmed to about 1 dB**, and the exclusion it supports is now backed by a measurement rather than by theory |
| `pfd-deadzone` | `sim/pfd-deadzone/records/20260801-234626-5b333d0.md` (`b5372a13006f`) | Dead-zone-freedom criterion (ratio > 0.5 AND both UP/DN pulse at Δφ=0) — PASS at every evaluated corner. Residual net charge at zero phase error reported per corner (feeds reference-spur derivation). | #9; feeds `spec/pll.md#reference-spur` (row 7, derived) | design-input, measured |
| `pfd-deadzone` (operating-point manifest) | `sim/pfd-deadzone/records/20260916-051356-8cedbba.md` — a **second manifest in the same experiment directory** (`testbench-operating-point/`), not a supersession: same DUT, same `t_offset` reduction, second operating point, and it deliberately does **not** sweep the near ±200 ps pair the parent's dead-zone verdict rests on, so it computes and claims no dead-zone verdict. | 405 points (45 PVT corners × 3 control voltages × 3 phase offsets), all measured, at the closed loop's own f_ref = 12.5 MHz instead of the parent's 25 MHz. **The systematic static phase offset is a strong function of control voltage, an axis `spec/pll.md`'s budget never named**: across DR-001 Decision 2's ratified 0.9–2.4 V window `t_offset` spans 0.0089 … **1.873 ns**, varying by at least 4× at every corner and up to 87× at one (`ff`/27 °C/3.63 V, 10.4×: 0.175 ns at 2.40 V, 0.657 at 1.65, 1.823 at 0.90; `ss`/−40 °C/2.97 V, 87×). At **Vctrl = 0.90 V it exceeds the ratified 1 ns Lock criterion by itself at 36 of 45 corners** (worst 1.873 ns, `ff`/125 °C/3.63 V); at 1.65 V and 2.40 V, at **none**. The reference frequency is nearly irrelevant by comparison — at the cited corner and 1.65 V, halving f_ref moves the term only 0.671 → 0.628 ns (−6.4 %). Cross-validates `supply-sensitivity`: at the two corners where the closed loop settles near 0.98 V, open-loop-at-0.90 V and closed-loop settled phase agree to within 0.09 ns. | #394; DR-012 Decisions 4/4a/4b; corrects the operating-point-free citation of 0.671 ns in `spec/pll.md`'s static-phase-offset budget | **measured** (full 45-corner grid × the whole ratified control window); no verdict claimed (reports a budget term) |
| `output-driver` | `sim/output-driver/records/20260817-100354-0e9cfc9.md` (`5c0a60662ab2`) | First loaded (50 fF `CLK` load) duty-cycle and output-levels/edge-rate measurement in this repository, 90 points (all five MOS bundles × 3 temperatures × 3 supplies × the two band/Vctrl edge extremes). Duty cycle **44.375–50.696 %**, target not met at 7/90 points (6 `fs`-bundle, 1 `ff`-bundle, all at the `lo` edge / nominal-or-above supply) — worst 44.375 % at `fs`/27 °C/3.63 V, 0.625 pp below the 45 % floor. V_OH/V_OL **1.006–1.044·VDD_VCO / −0.040…−0.006·VDD_VCO**, PASS at all 90 points. Overall record verdict FAIL (on the duty-cycle checks only). | `spec/pll.md#output-duty-cycle`, `#output-levels-and-drive` (rows 13/14); #144 (part of #127) | **measured** (90 points); duty-cycle target **not met** at 7/90 points, levels/drive target **met** at every point |
| `pll-top-smoke` | `sim/pll-top-smoke/records/20260802-160926-8456ff3.md` (`7dec4f0210c1`) | Assembled-top-level acceptance gate: **7 of 7 checks PASS** (residual frequency error, static phase error, divide ratio, output frequency vs. N·f_ref, LOCK level, Vctrl window, PFD DN-branch integration guard) at a **single nominal corner** (`typical`/27 °C/3.30 V) by design — this is a connectivity/closed-loop-existence check, not a PVT performance claim; see the record's own justification and `sim/README.md`'s "worked example of an acceptable one-point justification." | #52 (design-input; assembly acceptance gate, not a spec row) | design-input, measured (single corner, by design) |
| `output-range` | `sim/output-range/records/20261111-184929-73837b9.md` (`d297a14370b4`) — the latest record: the harness-form re-run of the full 90-row grid on the batch backend, compared row-by-row against the two baselines below (**83 of 90 rows measured, 28 rows outside the proposed per-row tolerances, recorded gate for the dependent mc-cp-mismatch work NO-GO**; the 7 unmeasured rows are 3 transient "timestep too small" aborts, 2 per-job-budget timeouts and 2 spot reclaims; tolerances were not widened and the cause of the measured divergence is not established — the Darwin arm64 vs Linux x86_64 and PDK-pin deltas are in the record's provenance); the earlier baseline `sim/output-range/records/20260819-160843-4e32f91.md` (`9beb97b3cc01`) — the full-grid record, **superseding** the single-corner pilot `20260731-223426-640560e`, and itself superseded **in one row only** by `sim/output-range/records/20260819-190341-70a4128.md` (the `ff`/27 °C/3.30 V `hi` row, where a hand-killed ERROR is replaced by a reproducible CAPPED/stall characterization — still not a PASS; the other 89 rows are untouched and stand as recorded); the `lo`-edge waveform diagnostic `sim/output-range/records/20260801-061907-67d7127.md` (`380369d949c9`) is cited, not superseded (its claim is the waveform diagnosis, not a corner measurement). | Full 45-point PVT grid at both draft band edges, 90 runs, against the `pll_top` DUT (**DUT changed at #159** — not netlist-for-netlist comparable with the two predecessors): **0 of 45 corners reached a sustained in-window PASS at either edge** (83 FAIL, 4 `OUT-OF-WINDOW` where band 7/N=32 cannot reach 200 MHz anywhere inside 0.9–2.7 V Vctrl at 125 °C/2.97 V, 3 ERROR). The 2 µs window is only ~2.5 reference cycles at the `lo` edge, so a `lo` FAIL bounds nothing about eventual lock; PFD DN-branch guard 49 PASS / 0 FAIL / 38 SUSPECT / 3 ERROR. Two ERROR rows are simulator convergence aborts (`sf`/27 °C, `lo`); the third (`ff`/27 °C/3.30 V, `hi`) did not complete in 151 CPU-minutes — #168. | #12; feeds closed-loop output-band coverage (design input, no independent spec row — `spec/pll.md`'s [Output band](#output-band) row 1 is substantiated by `vco-tuning-range`'s open-loop measurement, not by this campaign) | design-input, **measured** (full grid); no lock PASS at either band edge |
| `period-jitter` | `sim/period-jitter/records/20260905-192724-a2ba48f.md` (`c51227a4fd78`) — first record, `typical`/27 °C/3.30 V only; `sim/period-jitter/records/20260906-015602-f9bef9d.md` (`184d49af1f7d`) — adds the four process-corner extremes at the same temperature/supply; `sim/period-jitter/records/20260906-024225-12bccda.md` (`0a177fb30317`) — adds the remaining eight `typical` points, completing the full 3 × 3 temperature × supply plane at nominal process (the first data this campaign has on either of those two axes); `sim/period-jitter/records/20260906-063728-f3c9c23.md` (`ea55286e1112`) — adds the `ff` and `ss` bundles' complete temperature × supply planes (18 points), the first record of this campaign taken against a **clean tree**, and the first with an overall status of **FAIL**; `sim/period-jitter/records/20260906-080511-69b36ef.md` (`6fa41e96fc59`) — closes the `fs` and `sf` bundles' remaining 16 points (every temperature/supply combination not already covered by the process-corner-extremes record), completing the full mandated 45-point matrix; overall **PASS**; `sim/period-jitter/records/20260906-095050-3a8a6ef.md` — supersedes the `ferr` lock-gate verdict of `20260906-063728-f3c9c23` at its two failing points only, re-measured against the wrap-safe gate of #273; 2/2 **PASS** | Deterministic (control-ripple-driven) period/TIE jitter of the locked output, now measured at **all 45 of the mandated PVT corners** — the complete temperature × supply plane (−40/27/125 °C × 2.97/3.30/3.63 V) at every one of the five MOS bundles (`typical`, `ff`, `ss`, `fs`, `sf`). Same operating point throughout as `reference-spur` (f_ref = 25 MHz, N = 6, f_out = 150 MHz, band 6, Icp code 0). **tj_rms 0.0508–0.2691 % of period across all 45** — worst `typical`/−40 °C/3.63 V, best `ss`/125 °C/3.30 V, unchanged by the last 16 points (their own range, 0.0903–0.2472 % RMS at `fs`/`sf`, sits inside those bounds): every one of the 45 is **inside the 1.0 % RMS draft target — PASS against the draft, unratified threshold, at all 45**, worst-case margin 3.7×. The two new bundles also correct a trend the nominal-process plane suggested: **"colder and higher-supply is worse" is not process-independent.** Temperature is monotone at every bundle (hotter is better), but the supply trend's *sign* flips with process — at `ff` jitter falls as supply rises (−40 °C: 0.2484 → 0.2477 → 0.2173 %; 27 °C: 0.2351 → 0.2149 → 0.1994 %), while at `ss` it rises (−40 °C: 0.1420 → 0.1703 → 0.2240 %; 27 °C: 0.0537 → 0.1457 → 0.1732 %). **The FAIL is a guard defect, not a design finding, and was filed as #273**: 2 of the 18 new points (`ff`/27 °C/2.97 V and `ff`/27 °C/3.63 V) fail the manifest's own `ferr` lock gate at 4.00e-2 against a ±1e-3 ceiling, but both loops are locked — `fout` 150.006/149.976 MHz (40/160 ppm of target), `ffb` within 110 ppm of 25 MHz, measured N = 6.000, and jitter inside the range their seven `ff` neighbours produce. The gate's `phi_a`/`phi_b` samples are `trig`/`targ` edge-pair delays, so each is wrapped into one reference period; at those two points `phi_a` ≈ 39.81/39.86 ns (one 25 MHz period minus a sub-200 ps phase error) against `phi_b` ≈ −0.19/−0.13 ns, making the apparent drift exactly one reference period per microsecond — i.e. 0.04. The value reproduced to seven digits in a separately-launched run of the same grid, so it is deterministic, not noise. The record is **not** edited to say otherwise. **#273 is now closed and that FAIL verdict is superseded**: `sim/period-jitter/records/20260906-095050-3a8a6ef.md` re-measures exactly those two points against a wrap-safe gate (the phase difference unwrapped into ±T_ref/2 before it is differentiated, plus a new wrap-free `ferr_fb` = `ffb`/`f_ref` − 1 corroboration check at ±2e-3; the `ferr` gate itself is unchanged at ±1e-3) and both **PASS** — `phi_a`/`phi_b` come back identical to the digit (39.8121/−0.186479 ns and 39.8571/−0.131045 ns), `tj_rms` identical at 0.2351 %/0.1994 %, and `ferr` reads −1.47e-06/−1.19e-05 instead of 4.00e-2. Same simulation, corrected gate: the FAIL was the guard, exactly as diagnosed. Read that record for those two points' lock verdict and this one for everything else it holds. Cross-host reproducibility, which this record was deliberately overlapped to test: `ff` and `ss` at 27 °C/3.30 V were previously measured with ngspice-46 on Linux/x86-64 and re-measured here with ngspice-46 on macOS/arm64 — 0.2072 → 0.2149 % (+3.7 % relative) and 0.1333 → 0.1457 % (+9.3 %), same order and same verdict, not bit-identical. Other guards PASS at every one of the 18 (worst passing |`ferr`| 30.8 ppm, `dn_lvl` ≥ 0.124 against a 0.00089 floor, `dt_int_mean` ≤ 85.3 ps under the 100 ps ceiling). Random/noise-driven jitter is explicitly **not measured** by any of the five records (methodology gap stated per DR-002 Decision 5 — TRANNOISE unsupported on this ngspice build for a free-running oscillator). **DR-020 dispositions that gap** and sharpens it: no ngspice build has a transient device-noise analysis at all, the `.noise` analysis that *does* evaluate the gf180mcu noise PSDs correctly needs a DC operating point an oscillator does not have, and `trnoise()` injects an amplitude the deck author chooses — so the owed item is a validated noise-referral methodology, a simulator that has the analysis natively, or a silicon measurement. **DR-023** locates the missing piece on committed probes (`sim/period-jitter/noise-toolchain-probe/`): the per-device PSDs are available, and what this build lacks is a periodic-steady-state / `pnoise` path to weight them over the oscillation cycle. The item was owed at **#520**, which closed on DR-032's bound (stated in the Verification-owed cross-check section's "Period jitter — closed-loop / random (noise-driven) jitter" row, not this one) rather than on this route; DR-020 had named #505, which closed the day DR-020 landed. No *estimate* of the random half is owed now — DR-032's bound answers this row's pass/fail without one — so the `pnoise`-path route is unowned rather than re-pointed. **DR-030 adds the first ingredient of the pipeline that would replace the missing `pnoise` path, and it converges** — `sim/period-jitter/isf-bringup/` measures the ring's impulse sensitivity function `h(x) = Γ(x)/q_max` from charge-injection transients and retires the risk #520 named as load-bearing (halving the internal-timestep ceiling from 2 ps to 1 ps — the last step of the sweep and the setting the bring-up runs at — moves `h` by ≤ 0.02 % at every sampled phase, switching edges included; *not* every halving, since 8 ps → 4 ps still moves it by up to 2.32 %). It produces **no jitter number at any corner** and mints no record. **DR-031 adds the other two ingredients, and the bound #520's option (B) was refused for want of** — `sim/period-jitter/sid-trajectory/` tabulates each ring device's channel-thermal and flicker generator at the bias it actually occupies at 24 phases of the oscillation, plus the trajectory it is evaluated along, at three PVT points, sampled out of the ISF bring-up's *own* reference deck so the two ingredients share one phase axis (periods agree to −3.7 × 10⁻⁶). The bound is measured in the form the integral needs rather than the form that is easy to quote: against the `h²`-weighted average `S_eff = Σh²S/Σh²`, biasing each device at its own peak-\|I_d\| phase reproduces the channel-thermal generator to **−1.15 … +1.06 dB** (0.88–1.13× in jitter RMS) for all four device classes, while the raw cyclostationary span is 67–115 dB and bounds nothing. **Still no jitter number**: the assembly is not built, the bound exists at 1 of 45 corners while the unweighted spans move 40 dB across three, the weighted average rests on an effective 2.4 of 12 sampled phases for the two device classes whose ISF weight is exact, and the flicker half needs an observation interval `spec/pll.md`'s Period jitter row does not state (now listed in its Verification-owed table, DR-031 Decision 5). Like `noise-toolchain-probe/` and `isf-bringup/`, `sid-trajectory/` is a method directory, not a campaign: no record, no coverage row, no design number. The fifth record (`20260906-080511-69b36ef`) closes the remaining 16 points — the `fs` and `sf` bundles' off-nominal temperature/supply combinations — 16/16, overall **PASS** (no repeat of the #273 lock-gate defect here: worst |`ferr`| 3.65e-05 against the ±1e-3 gate). Temperature stays monotone (hotter is better) at both new bundles too, extending that reading to all five; the supply trend does not resolve into the clean two-valued-by-process-sign picture `ff`/`ss` alone suggested, though — `fs` rises with supply at 27 °C and 125 °C but dips slightly at −40 °C (0.1903 → 0.1876 → 0.2097 %), and `sf` falls gently with supply at −40 °C like `ff` did (0.2472 → 0.2463 → 0.2454 %) but rises at 27 °C and dips at 125 °C. The mandated 45-point PVT matrix for this claim's deterministic half is therefore complete. Compute-cost note, corrected: the earlier records' "a `-j8` full-grid attempt timed out all 45 points" finding was **self-oversubscription, not an inherent per-point cost** — `sim/run_corners.py`'s `-j` is process-level fan-out while this host's ngspice spawns 8 OpenMP threads per process, so `-j8` demanded 64 threads of 8 cores. `sim/harness/omp.py` now budgets those threads; this record's own eight points completed 8/8 in 4015 s wall (`-j4`, 2 threads per worker) against ~200 competing ngspice threads from unrelated concurrent tenants on the same host. | `spec/pll.md#period-jitter` (row 5, deterministic closed-loop half); #13 (part of #127); #273 (the `ferr` gate defect, fixed — the two affected points re-measured and superseded) | **measured** (45 of 45 corners — the full mandated PVT matrix, deterministic component only), PASS against the draft target at all 45; the one record whose overall status is **FAIL** failed on a non-wrap-safe lock gate at 2 locked corners, never on the jitter claim — that gate is now wrap-safe and those two points re-measured **PASS** in the superseding record `20260906-095050-3a8a6ef` (#273); random component **not measured** — methodology gap disclosed |
| `lock-time` | `sim/lock-time/records/20260831-052456-effc505.md` (`bdc1fb3a37d1`) — the full 270-run PVT × N grid, **superseding** the incomplete 7/90-row subset `20260821-081735-96fa64a.md` (per that record's own Supersedes field); `sim/lock-time/records/20260801-162534-2a81927.md` (`334ebbb27d75`) is cited, not superseded (a process/root-cause diagnostic that fixed a timestep-ceiling bug, not a corner measurement); `sim/lock-time/records/20260908-222537-9b7ca4e.md` (`18e05b6f612e`) — #284's single-corner extended-window/waveform investigation of the 131 non-rail-excursion `relock` FAILs, cited not superseded (a waveform diagnostic at one corner, not a corner-count measurement). | Full 45-point PVT grid at N ∈ {4, 16, 64}, both cold-start (0.9 V clamp) and worst-case re-lock (2.7 V clamp) — 270 runs total, against the `pll_top` DUT, using the design's own real `lock_detector` criterion (not an externally-imposed threshold). **22 PASS / 233 FAIL / 15 ERROR of 270** — `cold` reached a sustained in-window PASS on 21/135 rows (15 ERROR); `relock` reached PASS on 1/135 rows (0 ERROR). 135 is rows, not corners: it is the 45-point mandated PVT grid × N ∈ {4,16,64}, the same way the proposal's section-5 row states it. PFD DN-branch integration guard **255 PASS / 0 FAIL / 0 SUSPECT / 15 ERROR** across all rows — wherever the guard resolved, it read PASS, so the FAIL rows are not simulator-timestep artifacts. **Root-cause reading of the 233 FAILs (this report's own breakdown, not restated from the record's own text):** all 21 `cold` PASSes are at N = 64 (0 at N = 4, 0 at N = 16) — `cold`'s PASS rate is 0 % at the two shorter windows and 47 % (21/45) at N = 64's proportionally longest window, consistent with the record's own reading that a `cold` FAIL usually means the transient window ended before `lock_detector` could assert, not a broken loop. `relock` does not show the same recovery: even at N = 64 (the same proportional window length relative to its own condition as `cold` gets relative to its), only 1/45 corners PASS versus `cold`'s 21/45 — a far larger gap than the 2× absolute window-length difference between the two conditions would predict by itself. Of `relock`'s 134 FAILs, 3 (all at the `ff`/−40 °C/3.63 V corner, N = 4/16/64) show `vctrl_final` > 2.7 V, the rail-excursion signature `sim/lock-time/records/20260801-073931-eec269e.md` root-caused as a large-frequency-error PFD/CP acquisition-dynamics anomaly, not a per-corner bug. **The remaining 131 non-rail-excursion `relock` FAILs**: #284's follow-up record (`20260908-222537-9b7ca4e.md`) examined one representative corner (`typical`/−40 °C/2.97 V, N=4) in depth — extending its window the full 2× the harness's own `SIM_WINCAP` mechanism can deliver (40→80 reference periods; `SIM_WINCAP` cannot lengthen a `relock` row past the same 80-reference-period ceiling `cold` already uses, a real constraint that record documents) and reading the waveform: `vctrl` falls fast for ~20–30 reference periods then **plateaus** (a 7 mV band held for 44 reference periods, slope ~170× smaller than the initial acquisition slope and reversed in sign), well short of this same corner's own measured lock point (`cold`/N=64 PASS at `vctrl_final` = 1.561 V in the source record above). An uncommitted supplementary probe found `fb` running ~1.49–1.50× `ref`'s rate, flat to within 0.3 % from partway through the window to its end — the frequency error is not shrinking either. **Reads as option (b): a genuine loop-convergence stall at this corner, not a window-too-short artifact** — flagged to `loop-dynamics` (#10), consistent with (though a corner-dependent, dn-dominant rather than up-dominant, variant of) the mechanism `20260801-073931-eec269e.md` root-caused at its own pilot corner. **This is one corner of the 131, examined deeply and explicitly not generalized to the other 130** (see that record's own Limitations) — the aggregate 131-row question is therefore **still open**, now with one representative, evidenced answer rather than none. **The re-take of this grid is no longer held.** DR-013 Decision 7 held it behind #411's window change, since every verdict here is taken against the design's own `lock_detector`; #411 has landed that window, so the hold is released. A re-take must configure the detector per `spec/pll.md`'s [Lock-detector window trim-code rule](../spec/pll.md#lock-detector-window-trim-code-rule) — the 233 FAILs above were taken against the untrimmed cell and are not comparable point-for-point to a re-take at the rule's codes. | #163; #284; #411 (hold released); `spec/pll.md#lock-time` (row 9) — cold-start acquisition, now measured (not to a clean PASS); `spec/pll.md#lock-detector` — the T1/T2 gap is a *candidate*, not confirmed, explanation for some `cold` FAILs | **measured** (full 270-run grid); 22/270 PASS, 233/270 FAIL (`cold` FAILs read as window-limited, not loop-broken, on DN-guard-PASS rows; of the 131 non-rail-excursion `relock` FAILs, 1 corner is now evidenced as a genuine convergence stall — flagged to #10 — the other 130 remain unattributed by extension, not by re-measurement, see #284), 15/270 ERROR |
| `supply-sensitivity` | `sim/supply-sensitivity/records/20260901-155456-46b92f8.md` (`024486df28d6`) — supersedes `sim/supply-sensitivity/records/20260831-220545-c19e066.md` (`473dcb373ea0`, PR #256/PR #258's 3-corner step/ramp-only check), which itself superseded the full-grid baseline `20260831-133708-35c5a33.md` (`92c02f50a4a2`, #58) and, further back, the original 9-corner `20260801-024935-c4fe724.md` (`f72872845501`, #62) and its re-classification `20260801-114140-f87afc5.md` (`f257dbf0bddc`, #69). **Plus, alongside it and superseding nothing, `sim/supply-sensitivity/records/20260920-180604-0f91a9b.md` (#417)** — a deliberate 2-cell / 6-point subset at the **trimmed** `delaywin_3v3` (DR-014, #411), run to answer DR-013's window-vs-offset crossing question and nothing else. It is **not** this campaign's PVT statement and must not be read as one; `20260901-155456-46b92f8` still is. **Plus, alongside it and superseding nothing, `sim/supply-sensitivity/records/20260925-044237-4ff4f65.md` (#506, behind DR-021)** — a re-examination record in the same form as `20260801-114140-f87afc5` (#69), `20260915-105055-2d6ab99`/`20260915-124108-49f539f` (#384/#389), `20260915-202323-62391c6` (#387, behind DR-011) and `20260916-051708-8cedbba` (#394, behind DR-012): **0 new simulations**, every number arithmetic on `20260901-155456-46b92f8`'s own committed artefacts, reproducible from `sim/supply-sensitivity/testbench/fail_criteria_reexamination.py` and unit-tested in `sim/tests/test_supply_sensitivity_fail_reexamination.py`. It re-reads the three FAILing criteria against the **ratified** spec lines and supersedes nothing. **Plus, alongside it and superseding nothing, `sim/supply-sensitivity/records/20260925-090649-4422f1d.md` (#511, behind DR-025)** — the same re-examination form, **0 new simulations**, reproducible from `sim/supply-sensitivity/testbench/band_rule_audit.py` and unit-tested in `sim/tests/test_supply_sensitivity_band_rule_audit.py`. It re-derives `spec/pll.md`'s normative band-selection rule against #8's band map — the arithmetic DR-012 Decision 4b named and deliberately did not do — and finds that this campaign's own `derive_op_points` used a mid-window heuristic rather than the rule, disagreeing at exactly one of the 15 cells: `ff`/27 °C, the cell carrying the grid's largest settled Lock-criterion violation. `run.sh` now applies the rule, which changes **future** runs at that one cell and re-judges nothing here. | Full 45-point grid (5 MOS bundles × 3 temperatures × 3 supplies) plus all 3 step/ramp corners, run at the PFD's 100 ps closed-loop timestep bound throughout — this issue's own real, unshortened live run (#257), superseding the mechanism-verification-only #256/#258 record above. **Criterion 1 (frequency vs. supply) FAIL**: 35/45 corners meet the full lock criterion; worst frequency deviation −294 ppm (`typical`/27 °C/3.63 V). 0 corners needed the automatic 36.8 µs settling escalation. The 10 failures split as 2 static-phase-error (routes to the post-#24 charge pump, #9) and 8 `lock_detector` window misses (routes to #11, not a loop failure) — nothing routes to `loop-dynamics` (#10) or `vco-tuning-range` (#8) on criterion 1's account. **Criterion 1b (Vctrl inside DR-001's 0.9–2.4 V window) FAIL**: 4 of 45 corners' ripple peak leaves the window (worst 2.642 V at `ss`/−40 °C/3.63 V). **Criterion 2 (static phase offset, post-#24 CP)**: reported; worst 2.136 ns at `sf`/−40 °C/3.63 V, **2** of 45 corners over the deck's 0.02-of-a-period (1.6 ns) threshold. (This cell previously read "10 of 45 corners over it"; the record's own breakdown attributes 2 to the phase check and the other 8 to the `lock_detector` flag — 10 is the total failure count across all five checks, not the phase count.) **Re-read against the ratified ≤1 ns criterion by `records/20260916-051708-8cedbba.md` (#394, DR-012)**, which supplies the ratified spec line this cell says is missing and changes what the numbers mean: **17** of 45 rows exceed the ratified bound, but 15 of those were sampled with the phase still decaying (the grid's late window sits at 0.69–1.03 τ), so only **2** are settled violations — 1.227 ns at `ff`/27 °C/3.63 V and 1.049 ns at `typical`/−40 °C/3.63 V. Seven rows carry an overall `PASS` while over the ratified bound, because the deck's threshold was 1.6× looser than the spec's; that is fixed for future runs (`ACC_PHI_S`) and the committed verdicts are **not** re-judged. **Criterion 3 (stays locked through a supply step + ramp) FAIL, now with both settling escalations backed by real, full-length transients** (the prior record above verified only the escalation *mechanism* on a truncated deck): the **HIGH-plateau escalation (#253, PR #256)** re-runs all 3 sampled corners (`ff`/125 °C, `ss`/−40 °C, `typical`/27 °C) — every one missed `ferr_hi` at the default 14.4 µs hold (worst 0.04514 at `ss`/−40 °C) and **all 3 resolve to inside the 1e-3 criterion at the escalated 40.1 µs hold** (worst 0.0002851) — **0 of 3 genuine design-margin corners**; all 3 classify `not-locked` (the digital `lock_detector` flag itself does not assert at the escalated hold even though frequency has converged — a lock-range/`#11` finding, not a damping one, the same class as criterion 1's own 8 `lock_detector` misses above). The **END-plateau escalation (#255, PR #258)** then re-runs the same 3 corners' post-ramp hold from `t_rend` + 31.2/34.4/36.8 µs on the HIGH-plateau-escalated profile: `ff`/125 °C and `typical`/27 °C settle inside 1e-3 (settling-budget artifacts), but `ss`/−40 °C does **not** (`ferr_end` 0.001705 at the extended hold, decay ratio 0.809 vs. a 0.0493 single-pole expectation) — **1 genuine design-margin corner, flagged to `loop-dynamics` (#10)** rather than absorbed as a settling artifact. **Criterion 4 (power vs. the draft <5 mW target) PASS**: 0.9863–1.98 mW across the grid (worst `ff`/125 °C/3.63 V); quiescent/dynamic power split (3 corners), e.g. nominal corner 0.4244 mW quiescent / 1.045 mW dynamic. Open-loop VCO supply pushing (cited from `vco-tuning-range`) is *not* re-derived here — this campaign measures the *closed-loop* consequence, a different quantity. **At the trimmed window (#417, `20260920-180604-0f91a9b`, `SIM_PICKS='typical -40 ff 27'` at `KWINTRIM=rule`)**: DR-013 §Consequences' window-vs-offset crossing is now read out of **one** closed-loop transient per cell rather than across two campaigns at two reference frequencies — at `typical`/−40 °C/3.63 V (code 7) the loop settles at **0.8135 ns** and `lock` asserts (window **above** the offset); at `ff`/27 °C/3.63 V (code 11) it settles at **1.233 ns** and `lock` stays at 6.9 nV (window **at-or-below**). Both match what DR-013 inferred, so its Decision 4 verdict is **confirmed**, now on an in-loop measurement. Note the offset at `typical`/−40 °C/3.63 V reads 0.8135 ns here against the 1.049 ns `20260916-051708-8cedbba` settled at — a different DUT (trimmed detector) and this run's own escalated 36.8 µs transient, so the two are not the same measurement and this record does not re-judge that one. The other four of these six points are reported for context only: criterion 3 is **NOT MEASURED** in that run (its `typical`/27 °C corner is outside the picks, so it never got a calibrated warm start) and the quiescent/dynamic power split is empty. **Re-read against the ratified lines by `records/20260925-044237-4ff4f65.md` (#506, DR-021), which changes what two of the three FAILs are evidence of without changing a verdict.** (1) **Criterion 1 has no frequency content**: 0 of 45 corners missed either frequency check — worst |fdev| 294 ppm of 1000 (3.4× headroom), worst |ferr| 2.255e-4 of 1e-3 (4.4×). Joining DR-012's committed `settled` grading to the verdict column shows its two classes sit on the wrong corners: neither `FAIL:phi` corner was settled when sampled (`ff`/125 °C/3.63 V moved 0.722 ns and `sf`/−40 °C/3.63 V 0.605 ns across the run's own 3.2 µs window), while both **settled** violations of the ratified ≤ 1 ns bound — 1.227 ns at `ff`/27 °C/3.63 V and 1.049 ns at `typical`/−40 °C/3.63 V — carry `FAIL:lock`, i.e. sit inside the 8 the record routed to #11 (closed). So this cell's "routes to #9 … routes to #11" split above is the right *mechanism* attached to the wrong *rows*, and the whole class is DR-012's finding read at two nodes. (2) **Criterion 1b's window check grades a superseded figure, and the ratified budget was never graded at all**: the 4 failing points leave DR-001 Decision 2's *predicted* 0.9–2.4 V window, which **DR-003 Decision 5** superseded with a measured 0.9–2.7 V on 504 curves — against that window **0 of 45 points leave it**, tightest margin **+53 mV** at `ss`/−40 °C/3.63 V. `spec/pll.md` row 12's normative **Budget 2** (≤ 0.6 V of the window consumed by a 2.97–3.63 V excursion) is a different check and is **missed at 9 of the 15 (bundle, temperature) cells**, worst **0.846 V** at `ss`/−40 °C (1.41×, 47 % of the 1.8 V window); read over the ±0.33 V excursion the budget's own derivation prices, 0 of 15 exceed it. **Decided by DR-037 (#525; operator ruling 2026-10-02; the record is `proposed`, ratification via the two-key route): the full 2.97–3.63 V range governs, and the 0.6 V figure — which priced half that excursion — is re-derived as 1.2 V (2 × 17 % = 34 % shift; 0.34 / 0.84 = 0.40 V … 0.34 / 0.31 = 1.10 V; × the old budget's 1.095 allowance = 1.2 V).** The same measurement then meets Budget 2 at **15 of 15** cells (worst 0.846 V = 0.71× of 1.2 V); the 9-of-15 miss against 0.6 V stays recorded, and the **53 mV** ripple-peak margin at `ss`/−40 °C/3.63 V is the quantity that must not erode. `run.sh`/`report.sh` criterion 1b now grades Budget 2 at 1.2 V over the full excursion plus the measured 0.9–2.7 V window, and reports the legacy 0.6 V count ungraded; **no run has exercised the revised criterion yet** (the first is #437's re-take), and the committed 1b FAIL above is not re-judged. The consumption is not anomalous — it matches what each cell's selected band requires, from #8's committed open-loop f(Vctrl, vdd) table, to within **5.7 mV at every cell** (1.9 mV at the worst). (3) **Criterion 3's one `under-damped` corner recovers as a straight line, not an exponential**: the retained END-plateau waveform has the control node slewing at a near-constant −20.3 mV/µs for 18.75 µs after the ramp at `ss`/−40 °C, a line fitting those samples with 33 % less residual in volts than a single exponential (20.54 vs 30.75 mV rms; 21 % less at `typical`/27 °C; at `ff`/125 °C the 4-bin segment discriminates nothing). Section 3c's `decay_ratio` vs `exp(−Δt/τ)` discriminant assumes the model the waveform contradicts, and the model-free damping test does not separate that corner from the two called `settles` (17.2 mV of overshoot on its own 20.0 mV of ripple, against 19.5 and 22.5 mV). What separates it is recovery *length*, which ranks exactly as the cells' Budget-2 consumption (18.75/9.75/2.25 µs against 0.846/0.698/0.558 V); at the extended hold's end it still had 13.11 ns of phase closing at 1.705e-3, i.e. **≈7.7 µs more** — a hold ~8 µs short, the same shape and size as DR-011's independent 2.8–8.2 µs high-plateau bracket. | `spec/pll.md#supply-sensitivity` (row 12, pushing figure cited from `vco-tuning-range`, not from this campaign); `spec/pll.md#power` (`vdd_ref` domain current — this record's "core" column); `spec/pll.md#lock-detector` (row 16 item (b), via #417); DR-013 §Consequences follow-up; #58; #253; #255; #257; #417; **DR-021** (what each FAIL is evidence of, and its owner); `spec/pll.md#supply-sensitivity` Budget 2 (now measured and missed, per DR-021); DR-003 Decision 5 (the measured 0.9–2.7 V control window); #506; **DR-037**/#525 (Budget 2's excursion and re-derived 1.2 V, and the deck's criterion 1b, now corrected for future runs); **#511**/**#399** (the static-phase finding); **#405** (the post-ramp settling measurement) | **measured** (full 45-point grid + all 3 step/ramp corners, both settling escalations run to completion); criteria 1/1b/2/3 **FAIL** (the committed verdicts stand; `sim/` is append-only), criterion 4 **PASS**. **Re-classified, not re-judged, by DR-021/#506**: criterion 1 is DR-012's static-phase finding with 0 frequency content (owners **#511**, **#399**, **#437**); criterion 1b's window FAIL is against a window DR-003 superseded, while Budget 2 — re-derived at 1.2 V for the full-range excursion by DR-037 (#525) — is met at 15/15 cells and was missed at 9/15 against its superseded 0.6 V figure; criterion 3's END-plateau miss is a slew-limited recovery ~8 µs short of settled rather than the under-damped loop routed to the now-closed #10 (owner **#405**, scope item 3). Separately, **measured at the trimmed window over a declared 2-cell subset** (#417) — DR-013's crossing **confirmed** at both cells it names; a trimmed-window **full-grid** re-run is **#437** |
| `vco-bias-current` | `sim/vco-bias-current/records/20260911-172350-da0bb1e.md` (`84800baac0da`) | Constant-gm reference current of the VCO bias generator with the bias resistors as **specified** (`ppolyf_u_3k`, 3000 Ω/sq) against the same generator with them as the pre-#381 **layout drew** them (unmarked `ppolyf_u`, 350 Ω/sq), 234 points (13 corner bundles × 3 temperatures × 3 supplies × 2 band codes). Measured class ratio at the drawn RCG geometry **6.78–9.72×** (8.30× typical/27 °C — the "8.6×" figure #381 states, measured). At `spec/pll.md`'s own 100 MHz reference point (band 5, Vctrl 1.8 V) the as-specified bias generator draws **68.7–195.6 µA**; the as-drawn-350 arm draws **970–2163 µA**, i.e. **7.4–20.4×** more and above the ratified **318 µA** `vdd_vco` domain current at *every* point of the grid on its own, before the ring. Per-stage ring starving current (replica `MNT`) 19.1–48.4 µA as specified vs. 199.5–397.6 µA as drawn. Overall PASS. **The counterfactual arm is a diagnostic, never a design alternative.** | `spec/pll.md#power` (row 10, the 318 µA `vdd_vco` figure, cross-checked not re-derived); DR-009; #381 | **measured** (full 13-bundle grid); confirms the layout fix and quantifies the defect it removed |
| `vco-tuning-range` | `sim/vco-tuning-range/records/20260804-211600-f599a65.md` (`9b2ab6ddf83e`) — the **supply-pushing/jitter** sub-claim (see caveat: this directory now carries 4 live sub-claims from 4 manifests/decks). The **output-band/Kvco** sub-claim's current record is `sim/vco-tuning-range/records/20260731-175947-0a12e6c.md` (`6a0c337af4e1`). The **band-select mirror mismatch** sub-claim (new, #146) is `sim/vco-tuning-range/records/20260817-143524-0e9cfc9.md`, a raw `sim/lib/simenv.sh` deck (not a `tb.json` manifest — see that record for the harness-ordering finding making a `params` override of `sw_stat_mismatch` silently ineffective), **plus**, alongside it and superseding nothing, `sim/vco-tuning-range/records/20260923-084925-1655e11.md` (`cc6531ef6b75`, #482) — band 0's own same-corner, same-Vctrl closure of that sub-claim's band-0 leg (see the Result cell for the verdict) — **plus, alongside both and superseding neither, `sim/vco-tuning-range/records/20260927-081930-d004d5b.md` (`d823703e067a`, #597)**, the first record in this repo to draw TWO band codes from ONE mismatch draw, which retires the relative-dispersion proxy all three of the earlier mismatch figures rest on (see the Result cell). **Plus, alongside all three and superseding none of them, `sim/vco-tuning-range/records/20260927-220631-546a397.md` (`a1a11a6b561e`, #622)**, which widens that joint draw from one point to an **11-point grid** (N = 200/point, 2200 draws) spanning all five MOS bundles, all four vertices of the temperature × supply box at the thinnest bundle, and four of the seven adjacent pairs — the T1 item 6(d) residual #597 left on this campaign. All 11 points PASS; the binding point moves to **B3→B4** (see the Result cell). **Negative control, no longer delegated (#602), and widened with the grid (#622)**: all four Monte Carlo records above discharge item 6's control sub-criterion by citing `sim/mc-cp-mismatch` ("Not re-derived here"). `sim/vco-tuning-range/records/20260927-214737-546a397.md` (`337f4eecb658`) establishes one on this campaign's own DUT, deck and readout, at all 25 (corner, temperature, supply, Vctrl, band) points the four sample records draw at -- 75 of 75 legs PASS, re-derivable with `run_mismatch.sh --recheck-control 20260927-214737-546a397`. Its pre-widening predecessor `sim/vco-tuning-range/records/20260927-094524-b994116.md` covered the 3 points the two pre-#597 records sample, 9 of 9 legs PASS. Neither re-measures a dispersion figure and neither supersedes anything above. | **This campaign runs a 63-point PVT grid** — 7 bundles × 3 temperatures × 3 supplies — which is a *superset* of the 45-point mandated grid: it adds `all-slow` and `all-fast`, the two combined bundles that skew every device family together (passives included) rather than MOS alone. Every worst case below is therefore a worst case over a wider corner universe than a mandated-grid campaign's, and is binding at a corner the mandated grid does not contain. Output band: floor 6.449 MHz (`all-fast`/125 °C/2.97 V, 36 % below the 10 MHz line), ceiling 247.8 MHz (`all-slow`/−40 °C/3.63 V, 24 % above the 200 MHz line), 0 non-monotonic curves of 504, worst adjacent-band overlap 27 %. Kvco worst 115.8 MHz/V (`all-fast`/27 °C/2.97 V, band 6) under the band-selection rule. Supply pushing: worst −54.5 %/V (`ss`/−40 °C, band 5) static; ripple sensitivity worst **2.51 % RMS period jitter** at 100 mV pp `vdd_vco` ripple (`all-slow`/−40 °C/2.97 V, band 5) — **the number `spec/pll.md`'s summary table row 5 cites**, and the basis for row 5's conditional-on-ripple-budget framing. Overall PASS on all three sub-decks. **Band-select mirror mismatch** (device-level Monte Carlo, nominal PVT, N=25/band at the two cascade extremes): band 7 (full cascade, highest bias current) disperses 15.4 % of mean (\|mean\|+3σ), comfortably under the 26.8 % worst-adjacent-overlap headroom the systematic sweep measured; band 0 (always-on legs only, lowest bias current) disperses **38.8 %** of mean at its own mid-window point (`typical`/27 °C/3.30 V, Vctrl = 1.8 V) — a mid-window nominal characterization, **not itself a headroom verdict** (it borrows band 7's 26.8 % worst-adjacent-overlap headroom, measured at a different corner and a different pair, purely as an order-of-magnitude proxy). That figure stands unmodified as historical evidence; it is **not** superseded. **Band 0's own coverage-hole question is now closed** by `sim/vco-tuning-range/records/20260923-084925-1655e11.md` (`cc6531ef6b75`, #482), which combines band 0's random mismatch dispersion with band 0's **own** worst-corner headroom, at the exact (corner, Vctrl) point the B0→B1 overlap ratio was taken at: at `ss`/125 °C/3.63 V, Vctrl = 2.7 V — band 0's own f_max/overlap point — `|mean|+3σ` is **24.79 %** of mean against that pair's own **31.88 %** headroom (the B0→B1 overlap ratio 1.319): **under**, at N = 100. No numeric budget exists for this term in `design/README.md`. **All three of those percentage figures are a PROXY, and `sim/vco-tuning-range/records/20260927-081930-d004d5b.md` (`d823703e067a`, #597) replaces it with the inequality itself.** Every record above measures one band per ngspice invocation, so each had to read a band's `|mean|+3σ` *as a percentage of its own mean* against a fractional overlap margin — which each record flagged itself as "an order-of-magnitude sanity flag, not a rigorous directional bound", because with one band drawn the question the coverage-hole check asks (`f_max(band 0) ≥ f_min(band 1)` **on one die**) cannot be written down under mismatch at all. The new record's deck (`testbench/tb_vco_band_pair.sp`, new) runs both band codes as two `tran` analyses inside one `.control` block — one netlist parse, and therefore, since the gf180mcu `agauss()` draws are evaluated at parse time, **one mismatch draw shared by both bands**. The overlap ratio is then a per-draw sample and the criterion is its own one-sided 3σ tail: **1.28193 against the 1.0 floor at N = 200 — PASS**, keeping 88.4 % of the 1.31882 systematic margin and sitting 314.9 standard errors of the ratio's mean above the floor. The same 200 samples under the old independent-draw treatment (each band pushed to its own opposite tail) read **0.79910, a FAIL** — and which of the two is right is settled by a measurement, not an argument: the pair's two frequencies are correlated at **ρ = 0.9958** across draws, because bands 0 and 1 differ by one switched leg of `design/vco_bias.sch`'s cascade and share every always-on leg, the V→I converter and all five ring stages, so nearly all of each band's 24–26 % dispersion is common mode and cancels in a ratio. Still owed: the other six adjacent pairs (the worst-of-all-pairs ratio, 1.268, is B3→B4, unmeasured under mismatch), and this campaign's Monte Carlo corner axis stays one point wide by design — the binding corner is already known from the systematic sweep. | `spec/pll.md#output-band`, `#kvco` (rows 1/17); `#period-jitter` (row 5, sensitivity half); `#supply-sensitivity` (row 12, pushing figure); #8, #146, #482, **#597** | **measured**; band-select mismatch sub-claim: **measured — the B0→B1 coverage-hole question closed on a JOINT two-band draw (#597), 1.28193 against the 1.0 floor**, which also retires the relative-dispersion proxy #146/#482 had to use; band 7 comfortably under at its own point |
| `cp-compliance` | Two current sub-claims: **DC bench** — `sim/cp-compliance/records/20260801-190821-734f483.md` (`c60f07e9b9e7`); **switching-timing bench** — `sim/cp-compliance/records/20260802-061841-c24ee3a.md` (`2e973c1f6c50`). See caveat below on a third, near-duplicate switching record. | DC bench: both current sources stay in saturation across the ~0.9–2.4 V Vctrl window at every corner; UP/DN mismatch and the 2-bit Icp trim range measured (unit-leg currents 1.68–7.21 µA across codes/corners, nominal ≈5.2 µA). Switching bench: effective UP/DN pulse-width skew (`wskew`) measured per (corner, Vctrl); worst-corner asymmetry 3.68 fC (`fs`/125 °C/3.63 V, Vctrl 0.9 V) — **feeds `spec/pll.md#reference-spur`'s derivation directly.** Overall PASS on both benches. | #9; feeds `spec/pll.md#reference-spur` (row 7, derived), the Icp trim-code rule, and `mc-cp-mismatch`'s systematic baseline | design-input, measured |
| `harness-selftest` | `sim/harness-selftest/records/20260731-151931-58c52d9.md` (`b054e15b269c`) | `sim/harness`'s own acceptance testbench (real devices, no design claim) — proves the harness resolves the PDK, sweeps corners, and writes a `sim/README.md`-conformant record end to end. Overall PASS. **This row said "45-point PVT grid" until 2026-09-25; the record's own corner field reads "63 point full-factorial grid"** across 7 bundles — the five MOS ones plus `res_ff` and `res_ss`, deliberately, since exercising a passive axis is part of what the harness is being proved to do. A stated grid that the cited record contradicts is exactly the failure this table's coverage check now looks for, and it was hiding behind the check's own allowance of the mandated size. **Re-qualified under open_pdks `f6eeac7` (#825, child of #790).** `sim/harness-selftest/records/20261114-014020-a21aa0c.md` (`ae2c1422d4ca`) re-runs the same 63-point grid through the same manifest on the batch fleet and supersedes the record cited above; every value is identical to the last printed digit at all 63 corners, across a change of PDK revision, simulator (ngspice-46 → ngspice-47), host OS and execution backend at once — which is the strongest reproducibility statement this bench can make, and the claim it exists to carry. Deltas, and the single-corner ngspice-42 control run that attributes them to the simulator rather than to the PDK, are in `sim/REPIN-DELTAS-f6eeac7-devchar.md`. | n/a — harness self-verification, not a design or spec claim | n/a (tooling) |

## Verification-owed cross-check

`spec/pll.md`'s own "Verification owed" table (line 879) lists what the
specification asserts that `sim/` does not yet substantiate. Every row of
that table is disclosed above; this section restates the correspondence so a
reader auditing gap-coverage does not have to cross-reference by hand:

| `spec/pll.md`'s owed item | Disclosed above under | Still open as of this report |
|---|---|---|
| Period jitter — closed-loop / random (noise-driven) jitter | `period-jitter` (deterministic component, 45 corners — full mandated matrix); `period-jitter/random-bound` (random component, VCO-side upper bound, 45 corners — a method directory with committed per-point results, `sim/period-jitter/random-bound/results/transient_*.json`, and no `records/`); `period-jitter/in-band-bound` (random component, in-band upper bound, 45 corners — the charge pump, PFD, divider and lock detector `random-bound` does not inject, `sim/period-jitter/in-band-bound/results/bound_*.json`, also no `records/`); `vco-tuning-range` (open-loop sensitivity substitute) | **yes for the deterministic half (measured); yes, as an upper bound, for the random half, full scope** — `sim/period-jitter/` now has **six** records and the deterministic component is measured at all 45 of the mandated PVT corners (0.0508–0.2691 % RMS, PASS against the draft target at every point). Those 45 are a **union of five records, no one of which covers the grid**, which is why this row now names them instead of pointing at the directory: `sim/period-jitter/records/20260905-192724-a2ba48f.md` (1 run, `typical`/27 °C/3.30 V), `sim/period-jitter/records/20260906-015602-f9bef9d.md` (4, the other MOS bundles at that same temperature and supply), `sim/period-jitter/records/20260906-024225-12bccda.md` (8, completing the `typical` temperature × supply plane), `sim/period-jitter/records/20260906-063728-f3c9c23.md` (18, the `ff` and `ss` planes) and `sim/period-jitter/records/20260906-080511-69b36ef.md` (16, the `fs` and `sf` planes, closing the matrix) — 47 runs at 45 distinct points, the two repeats being `ff`/27 °C/3.30 V and `ss`/27 °C/3.30 V, measured once in the second record and again inside the fourth's planes. The sixth record, `sim/period-jitter/records/20260906-095050-3a8a6ef.md`, re-measures 2 points of the fourth (`ff`/27 °C at 2.97 V and at 3.63 V) against #273's wrap-safe lock gate and adds no new corner — so the record count moved and the coverage did not. Random/noise-driven jitter is explicitly **not measured** by any of them (disclosed methodology gap, DR-002 Decision 5) and remains wholly owed. **DR-020 records its disposition**: no analysis this flow offers produces it (ngspice has no transient device-noise model; `.noise` needs a DC operating point a free-running oscillator does not have; `trnoise()` injects a chosen amplitude), so what is owed is a methodology before a number. **DR-023** narrows that reason — the device noise PSDs are available; the missing piece is a periodic-steady-state / `pnoise` path to carry them over the oscillation cycle — and re-pointed the owner to #520, neither the closed #13 nor #505, which DR-020 named and which closed the day DR-020 landed. **DR-030 then builds and validates the first of the three ingredients of the hand-rolled substitute for that missing path**: `sim/period-jitter/isf-bringup/` extracts the ring's impulse sensitivity function and shows it converged against the internal-timestep ceiling (≤ 0.02 % over the last halving of the ceiling, 2 ps → 1 ps, at the switching edges as well as the flats — not per halving in general, since the 8 ps → 4 ps step still moves `h` by up to 2.32 %), which retires the risk #520 named as the route's load-bearing one — and, separately, finds that the ISF weighting a device's channel noise is a small residue of two nearly-equal single-node ISFs, so it must be injected two-terminal rather than subtracted. **DR-031 then builds the other two** — `sim/period-jitter/sid-trajectory/` measures each ring device's channel-thermal and flicker generator at the bias it occupies at 24 phases of the cycle, and the trajectory it is evaluated along, at three PVT points, on the ISF bring-up's own reference deck so both ingredients share one phase axis. It also measures the stationary-approximation bound in the weighted form the integral needs: against `S_eff = Σh²S/Σh²`, the peak-\|I_d\| bias convention reproduces the thermal generator to −1.15 … +1.06 dB for all four device classes. That route still gives no *estimate* — its assembly does not exist. **DR-032 answers the row without it, with an upper bound over the full mandated grid**: `sim/period-jitter/random-bound/` injects a `trnoise()` source across every ring and output-buffer channel, each at the maximum of that device's own `.noise` density over its own trajectory (sampled to the trajectory's 2 ps resolution around each switching device's peaks), so the stationary approximation's error is one-signed by construction, and folds flicker into that injection through the closed loop's error transfer over every admissible loop, which also makes the bound independent of the observation interval DR-031 Decision 5 asked about; it bounds the bias generator — the largest term, whose noise has a memory of many periods — by a small-signal `.noise` about its DC point, checked against the transient, and the loop-filter resistor through the control node. Result: **≤ 0.338 % RMS at all 45 points** (worst `sf_-40c_2.97v`, one-sided 95 %), a 1.48× margin on the 0.50 % allocation, which is therefore verified as a bound rather than an unverified budget. **DR-033 then bounds the charge pump, PFD, divider and lock detector** — the in-band sources DR-032 argued small through the loop's low-pass and the period difference rather than bounding: `sim/period-jitter/in-band-bound/`, ≤ 0.0249 % RMS at all 45 points (worst `sf_125c_2.97v`), a headroom of 15.8× against the margin DR-032's own bound leaves. Combined in quadrature the whole random half is **≤ 0.3388 % RMS at all 45 points** — DR-032's own figure to three decimal places. The ≤ 1.0 % RMS target is unchanged |
| Period jitter — band sweep at non-nominal temp/supply | `period-jitter`, `period-jitter-band-top`, `vco-tuning-range` | **partially** — no longer wholly owed: `sim/period-jitter/records/20260906-024225-12bccda.md` closes the complete temperature × supply plane (−40/27/125 °C × 2.97/3.30/3.63 V) at nominal process, so both axes now have real closed-loop data (0.1111–0.2691 % RMS, worst cold-and-high-supply). The **output-band** axis, which no record of `period-jitter` varies — every point of it is at band 6 / 150 MHz — is now a declared campaign of its own, `sim/period-jitter-band-top`: the same measurement, the same reduction code, at the 200 MHz top of `spec/pll.md#output-band`, with its full 45-point grid declared and every point's operating point derived from the committed VCO record `20260804-162735-72883fb` under `spec/pll.md`'s normative band-selection rule (`band_and_vstart_from_vco_record.py --check`). That VCO record runs the **63-point** superset grid (7 bundles), but the derivation reads only its five mandated MOS bundles, so what is declared here is the mandated grid, not the wider one it is derived from. Deriving it surfaced a finding the 150 MHz campaign could not have: **at 200 MHz the rule does not select one band code for the grid** — band 6 at 34 of the 45 points, band 7 at the other 11 (the cold and/or high-supply points where band 6's own curve tops out below 200 MHz) — where at 150 MHz one static code covers all 45, which is why `reference-spur` and `period-jitter` could hold theirs fixed. Local Kvco at the selected points spans 74.7–117.0 MHz/V, all inside `spec/pll.md` row 17's 150 MHz/V bound, but the loop gain the one fixed filter sees therefore varies 1.6× across that grid against 1.05× across `period-jitter`'s. **Still owed**: every measured point of `period-jitter-band-top` — the 150 MHz temperature/supply-plane grid this row used to track is now complete (`sim/period-jitter/records/20260906-080511-69b36ef.md` closes the `fs` and `sf` bundles' remaining 16 points, so all 45 of the mandated PVT corners are measured at 150 MHz); `period-jitter-band-top`'s manifest, deck and derivation are committed and self-checking, so what remains there is compute, not design — and since #496 that compute has a route: `sim/run_corners.py period-jitter-band-top --backend batch` shapes the 45 points as one off-host job each, preserving per-point isolation, timeouts and provenance (see `sim/harness/README.md` §`--backend`). What is owed is now an authorized run of that path, not a missing mechanism; zero of the 45 points are measured either way. The cited open-loop ripple-jitter number is likewise one operating point, not a full grid |
| Reference spur — the mandated 45 PVT points at the binding 200 MHz | `reference-spur` (the measurement, at 150 MHz), `reference-spur-band-top` (the binding-point campaign, declared and unmeasured); `cp-compliance`, `mc-cp-mismatch`, `pfd-deadzone` (the derivation's inputs) | **partially** — the closed-loop measurement exists at 5 spanning corners at 150 MHz (#145, closed), and its two cold corners do not clear −55 dBc once scaled to 200 MHz (−54.5 and −54.9 dBc). What is owed is **restated by DR-024 Decision 3**: the mandated 45 points at the binding 200 MHz, not 40 more points at 150 MHz that would still have to be scaled by +2.50 dB before they could be read against the line. That sweep is now a declared campaign of its own, `sim/reference-spur-band-top` — the same deck, spectral reduction, solver settings and spectral windows as `reference-spur`, at N = 8 / f_out = 200 MHz, with every point's band code and release voltage derived from the committed VCO record `20260804-162735-72883fb` under the normative band-selection rule (`band_and_vstart_from_vco_record.py --check`, the same generator `period-jitter-band-top` uses, so the two 200 MHz campaigns are configured identically point for point). That VCO record runs the **63-point** superset grid (7 bundles), but the derivation reads only its five mandated MOS bundles, so what is declared here is the mandated 45, not the wider grid it is derived from. The same 34/11 band split applies here and is why this could not be five more corners of `reference-spur`, whose band bits are static in `params`. **Still owed**: every one of the 45 points — manifest, deck and derivation are committed and self-checking, so what remains is compute, not design, and the route is `sim/run_corners.py reference-spur-band-top --backend batch`; an authorized run of it is **#533**, blocked on the same fleet-credential fault as #499/#503. **Not owed here**: the statistical half of the spur — both closed-loop campaigns run with device mismatch off, so a measurement is comparable with the derivation's systematic-only **−66.6 dBc** row, not with DR-018's −56.6 dBc stack (DR-024 Decision 4); a closed-loop Monte-Carlo spur campaign is unowned |
| Lock time — cold-start acquisition incl. cycle slipping | `lock-time` | **partially** — see the `lock-time` row above: the full 270-run closed-loop grid now exists (#163) and measures cold-start directly (22 PASS / 233 FAIL / 15 ERROR of 270), so this is no longer "only small-signal settling"; most `cold` FAILs read as window-limited rather than a broken loop. Of the 131 non-rail-excursion `relock` FAILs (excluding the 3 known rail-excursion rows), #284's follow-up investigation (`20260908-222537-9b7ca4e.md`) found one representative corner genuinely stalled — not window-limited — and flagged it to `loop-dynamics` (#10); the other 130 remain unattributed by extension of that one corner's evidence, not by independent re-measurement — still open |
| Reference input — thresholds/edge-rate sweep, numeric reference-jitter limit | `reference-input-contract` (declared, no record) | **yes — wholly owed, but no longer unowned.** A campaign directory now covers the first half: `sim/reference-input-contract` holds the DUT at `sim/pfd-deadzone`'s operating point (`pfd_cp`, 25 MHz, Vctrl = 1.65 V, Icp code b1 b0 = 10) and sweeps the `REF` **waveform** to each boundary `spec/pll.md#reference-input` states — 0.2·VDD – 0.8·VDD levels, 5.00 ns 10–90 % edges, 30 % and 70 % duty, and one variant at all three at once — against the ideal full-rail 200 ps/50 % pulse every other testbench here drives. Its graded quantity is the per-corner shift of the reference-path set delay `d_ref` (reference mid-rail crossing → the instant the PFD acts on it), held to the 1 ns static-phase bound of `spec/pll.md`'s Lock criterion, with the duty row's rising-edge-only argument stated falsifiably at ≤ 1 % of `d_ref`. The deck measures its own applied edge rate and duty and gates them, so a run proves it drove what it claims. **Every one of the 288 declared points is owed** (45 mandated PVT corners × 6 waveform variants, plus an 18-point detector-gain slice at `ss`/125 °C/2.97 V, `ff`/−40 °C/3.63 V and `typical`/27 °C/3.30 V) — the same declared-and-unmeasured state `period-jitter-band-top` is in, but **no longer for the same reason: what remains is an aligned simulator, not compute (DR-035)**. The grid was submitted to the batch backend and 118 of the 288 declared points ran; **all 12 convergence failures among them were the same variant**, `wedge` — the full-rail 6.25 ns ramp that places the 10–90 % edge rate at exactly the 5 ns budget, i.e. the binding point of the line it exists to test. 8 of 20 `wedge` points converged on the job image's **ngspice-42**, and every −40 °C point failed (`doAnalyses: TRAN: Timestep too small … trouble with node "vctrl#branch"`, at a breakpoint of the slow ramp); the same six −40 °C points converge **6 of 6** on the **ngspice-46** the repository pins (#259). So the grid is not obtainable on the current image at any budget, the prerequisite is the image realigned to the pin (**#680**; raised as option 1 on now-closed #536, required rather than preferred since DR-035), and the deck is deliberately *not* retuned to accommodate ngspice-42 — that would move the numbers and forfeit the stated comparability with `pfd-deadzone`. That partial run is not committed: a grid that lost the binding point of the budget it exists to measure is evidence about the simulator, not about the contract, and DR-035 §Context is where it is used as such. **Update (DR-039, #680, 2026-10-08):** the job image now signs off ngspice-46 and the six −40 °C `wedge` points converge 6 of 6 on the fleet; the ngspice-42 blocker described here is cleared for the probe, the full grid (#499) is still unrun, and nothing on this row is measured. The second half, a numeric reference-jitter limit, needs the closed-loop noise bench and is **unowned** — sequenced behind the noise methodology at #505, and deliberately not re-pointed at #13, which is itself closed; DR-019 re-points both halves off closed issue #12 and restates the source-quality exclusion with its boundary and its owner |
| Reference input — the `20·log₁₀(N)` in-band transfer figure itself | `reference-phase-transfer` | **no longer owed as a figure — measured at N = 6 (#509, DR-027), with four named residuals.** `sim/reference-phase-transfer/records/20260925-080736-b722f33.md` applies a single known 1 ns reference phase step inside the closed loop and reads the REF-vs-FB static phase error **differentially against a paired control run** — a different question from the row above (that campaign varies `REF`'s waveform *shape* at a fixed phase; this one perturbs its *phase in time*, which no testbench in this repository had ever done before #509). **In-band transfer 15.529 … 16.366 dB against the stated 15.563 dB (error −0.035 … +0.803 dB), 5/5 corners PASS**, plus the roll-off above the loop bandwidth at one frequency (21.6 … 32.7 dB below the in-band figure). The residual is quoted against the differential's own measured noise floor (`pair_resid` −10 … +26 ps) rather than presented as exact, so the claim is "to about 1 dB". **What remains owed is not the figure**: other N (this is N = 6 only), a swept magnitude-vs-frequency curve rather than two points, the remaining 40 PVT points, and the passive process axes — DR-027 Decision 4 states each. The separately-unowned *numeric reference-jitter limit* in the row above is unchanged: it needs a statistical noise spectrum pushed through this gain, which is #520's missing methodology, and a measured gain does not sequence it |
| Power — measured `vdd_ref` domain current, closed-loop total | `supply-sensitivity` (`vdd_ref` == its "core (PFD+CP+LD)" column, and the closed-loop total) | **no longer** — `supply-sensitivity`'s full-grid record (#58) measures both: total power 0.9865–1.98 mW (PASS against the draft <5 mW target) and the `vdd_ref`/core-domain current at every corner, plus the quiescent/dynamic split. `spec/pll.md#power` still states `vdd_ref` as budget-only and has not been updated to cite this measurement (`spec/` changes are out of scope for this report) |
| Output duty cycle — no measurement exists | `output-driver` | **partially** — the measurement now exists at 90 points (#144); the design does not meet its own 45 % floor at 7/90 points (`fs` bundle, `lo` edge, nominal-or-above supply), and post-extraction re-run / the on-die divider load are not yet added |
| Output levels and drive — loaded-output swing/edge-rate | `output-driver` | **partially** — the measurement now exists at 90 points and PASSES at every point (#144); post-extraction re-run / the on-die divider load are not yet added |
| Lock detector — T1′/T2′ window band, T4/T5 below 25 MHz | `lock-detector`, `lock-window-trim`, `lock-window-sizing` | **partially — T1′ and T2′ are now met; T4/T5 are not characterized.** The route there took three steps, each on evidence the previous one could not produce: DR-010's geometric re-size (W = 9.5 µm, #393) met T1′ but the in-situ re-characterization found **T2′ exceeded by 1.0–2.0 %** at `ss`/125 °C/2.97 V, a finding `lock-window-sizing`'s idealized delay-chain-only stimulus could not show; DR-013 (#401) established that **no** sizing of that topology could meet the band (spread 1.928× at W = 8 µm, 1.906× at W = 26 µm) and set a ≤ 1.65× spread target; DR-014 (#407) picked a fixed test-set trim code over a bias-referenced delay; and **#411** built it and re-characterized under it — `lock-window-trim` (1872 points) for the code map and code table, `lock-detector` (205 points) for the in-situ verdict: edges [1.14, 1.16) ns and [1.78, 1.80) ns, spread **1.53–1.58×**, both targets met with 10–16 % of margin. **What is not covered**: T4 (deassert latency ≤ 1 reference period) and T5 (no chatter) below 25 MHz — the detector has only ever been run at f_ref = 25 MHz and its assert hold-off is an absolute time, so at 1 MHz it is of order one reference period; a 0.02 ns edge refinement at `ff`/−40 °C/3.63 V and `ss`/−40 °C/3.63 V, where only the coarse ladder ran; `supply-sensitivity` at the new window across the **full** grid (#417 measured it at the two cells DR-013 names — crossing **confirmed** in one loop — and left the other 43 points at the untrimmed cell); and extraction plus mismatch, including trim-array DNL (#18) |
| Lock criterion — the loop's settled static phase vs. the ratified ≤1 ns | `supply-sensitivity`; `pfd-deadzone` (operating-point manifest) | **partially, and the finding moved** (#394, DR-012). `sim/supply-sensitivity/records/20260916-051708-8cedbba.md` re-reads all 45 rows of the committed steady grid: the loop misses the ratified bound in undisturbed steady state at **2** corners on settled evidence — **1.227 ns** at `ff`/27 °C/3.63 V and 1.049 ns at `typical`/−40 °C/3.63 V, each stationary to ≈11 ps across the late window and cross-checked from the PFD's UP/DN pulse-width difference to <2.3 %. All **8** corners whose own `lock_detector` refused to assert are over the bound (8 of 8), so those `FAIL:lock` rows are not purely a #11 window question. The **1.796 ns** previously entered here for `ff`/125 °C/3.63 V is withdrawn: that run stopped at ≈1.3 τ with the phase still falling (2.518 ns one window earlier), so it is an upper bound on a tail and that corner's settled value is **unmeasured**. The `pfd-deadzone` half of the reconciliation is now measured (operating-point manifest row above) and answers "is ≤1 ns reachable, and where": **not at the bottom of the ratified control window** — the systematic term alone exceeds the whole criterion at 36 of 45 corners at Vctrl = 0.90 V — **and yes over the rest of it**, none at 1.65 V or 2.40 V. The axis is the control voltage, not the PVT corner. **Narrowed by `records/20260925-090649-4422f1d.md` (#511, DR-025)**, which re-derives the normative band-selection rule against #8's band map for the first time: the **1.227 ns** at `ff`/27 °C/3.63 V was measured at **band 6**, which is not the band the rule selects there over DR-003 Decision 5's measured 0.9–2.7 V window (band 5, Vctrl 1.967–2.595 V) — that cell has never been run closed-loop, so the corner is neither cleared nor confirmed and the settled-violation count is **1 at a rule-compliant configuration (`typical`/−40 °C/3.63 V) plus 1 owed**. The same record eliminates band selection as the *resolution*: applied across the ratified 10–200 MHz output band the rule still parks some corner at Vctrl ≤ 1.05 V at 23 of 39 output frequencies (floor **0.919 V**, `ss`/125 °C/2.97 V at f_out = 135 MHz) and still misses the criterion on DR-012 Decision 4a's summed budget at 1397 of 1628 rule-selected points. Still owed: the settled phase at the **15** unsettled over-bound corners (needs the 36.8 µs escalation, ≈10 h of ngspice per corner); the rule-selected `ff`/27 °C band-5 run; and a closed-loop measurement at an (f_ref, N, trim-code) cell other than 12.5 MHz / N=8 / b1b0=10 — **now named**: f_out = 135 MHz at `ss`/125 °C, band 6, N = 8 ⇒ f_ref = 16.875 MHz ⇒ one Icp unit leg (b1b0 = 00) |
| Lock time — re-lock after a mid-operation supply excursion | `supply-sensitivity` | **no** — only a lower bound is measured: `lock` had not re-asserted 34.4 µs (3.70 τ) after a +10 % step at 2 of 3 sampled corners. `sim/supply-sensitivity/records/20260915-202323-62391c6.md` (`b2a13f8a4245`) brackets the recovery at 37.2…42.6 µs from committed data, but that is a two-sample extrapolation contradicted in sense by `46b92f8` §3c's `under-damped` result at one of the same corners. DR-011 records it as a stated limitation; #395 is the campaign that would measure it |
| Area — everything except the loop filter | `loop-dynamics` (loop filter only) | **yes** — no floorplan exists (#17), so no other block's drawn area is measured |
| Kvco / Output band — Monte Carlo band-select mismatch, post-extraction re-run | `vco-tuning-range` (schematic-level only) | **yes** — every VCO number cited above is schematic-level (`sim/README.md`'s "Netlist provenance" convention); no post-extraction re-run exists (#18) |
| Multiplication ratio — post-extraction retiming margin at N=64/200 MHz | `divider-ratio`, `divider-ratio-chain` | **yes** — the cited 6.1 % margin is schematic-level; #18 owes the post-layout re-take |

No item from `spec/pll.md`'s Verification-owed table is silently omitted
here; every row above traces to an explicit "still open" note in this
report, in the campaign table, or both.

## Caveats and notes

- **`divider-ratio`'s spec citation is stale relative to the migration, but
  the numbers agree.** `spec/pll.md#multiplication-ratio`'s own "Evidence"
  line still cites the pre-harness `sim/divider-ratio/` records (`#41`
  migrated the campaign onto `sim/harness` by splitting it into
  `divider-ratio-dff`/`-cell`/`-chain`, per `sim/README.md`'s "A one-directory
  experiment can outgrow one `sim/harness` manifest"). As of this report,
  the migrated `divider-ratio-chain` record reproduces the pre-migration
  retiming-margin number exactly (3.03e-10 s / 6.1 %, same binding corner),
  so the two do not disagree — but `spec/pll.md` has not been updated to
  cite the migrated sibling directories. Not fixed here (`spec/` changes are
  out of this issue's scope per its own Guardrails); noted so it does not
  read as an oversight of this report.
- **`cp-compliance` carries an apparent unreconciled duplicate.** Two
  records — `20260802-033728-c24ee3a` and `20260802-061841-c24ee3a` — both
  supersede the same predecessor (`20260731-194124-afa338c`) for the
  switching-timing bench, without either superseding the other. Their
  headline numbers agree closely (same measurement, same grid, run ~2.5
  hours apart). This report cites the later of the two
  (`20260802-061841-c24ee3a`) as current, consistent with the "latest by
  timestamp" rule used throughout, but the lack of an explicit
  Supersedes link between the pair is a minor bookkeeping gap in `sim/`
  itself, not something this report can fix without editing an append-only
  record.
- **Multi-record campaigns.** `cp-compliance` (DC + switching benches) and
  `vco-tuning-range` (output-band/Kvco, stage-count comparison, and
  supply-pushing/jitter, three manifests sharing one experiment directory
  per `sim/README.md`) each carry more than one simultaneously-current
  record — this report cites both (or all) in each such case, per
  `sim/README.md`'s own citation convention ("cited, not superseded").
  `output-range`, `supply-sensitivity`, and `lock-time` were once in a
  third category — a latest-by-date record that was a narrow diagnostic or
  re-classification rather than the broad measurement — until their
  full-grid records (`20260819-160843-4e32f91`, #159;
  `20260831-133708-35c5a33`, #58; `20260831-052456-effc505`, #163) landed:
  each campaign's latest record is now the broad measurement, and the
  earlier diagnostic (`output-range`'s waveform diagnostic;
  `supply-sensitivity`'s 400 ps-bound re-classification; `lock-time`'s
  timestep-ceiling-bug diagnostic `20260801-162534-2a81927`) is the one
  cited alongside it.
- **`pll-top-smoke` and `harness-selftest` are single-corner or non-design
  campaigns by design**, not incomplete PVT sweeps — see their own rows
  above and `sim/README.md`'s "worked example of an acceptable one-point
  justification" for why a single corner is a complete answer to the
  question those two campaigns ask.
- **klayout-tools #309** — the general aggregation-tool issue this repo's
  interim report does not block on (per #147's own Scope item 2) — closed
  on 2026-08-09, and the tool it asked for shipped as `klt signoff`, which
  this repository runs as `signoff/run-signoff.sh` against
  `signoff/block-manifest.json`. That grades the T1 checklist and the
  evidence hashes the manifest pins; it does not generate or grade this
  report's summary table, which is still hand-maintained. Earlier revisions
  of this bullet said #309 "remains open", which stopped being true about
  six weeks before anyone re-read it.

## Maintenance

This report is **hand-maintained**, not generated. It reflects the tree as
of the commit that introduced it; every citation above should be re-checked
against the current tree before being relied on for anything beyond a
quick orientation, and definitely before being cited outside this
repository. `sim/lib/check-characterization-coverage.sh` (added alongside
this report) fails CI if a campaign directory under `sim/*/records/` exists
on disk without a corresponding entry in this report's summary table, so
the two cannot silently drift apart in the "a whole new campaign appeared
and nobody added it here" direction. **Since #544**, the same script also
fails CI in the reverse direction inside an already-listed campaign: for
every campaign directory, the chronologically-latest record under its
`records/` must either be cited somewhere in this report or be named in the
script's own `NOT_AGGREGATED` allowlist with a one-line reason — the gap
that let `vco-tuning-range`'s `20260923-084925-1655e11` band-0 closure sit
uncited, and this row's Status column stale, for two days after it merged.
The script also runs a fourth leg, also since #544: it recomputes the
sha256 of every `` `path` (`hash`) `` citation pair this report makes and
fails CI if one no longer matches the file on disk, so the append-only
claim several of those citations state is self-enforcing rather than
self-asserted (baseline: 39/39 match at the commit that added the leg).
Neither of the two new legs detects a stale headline number *inside* a
citation that is already present and still hash-correct — only a whole
new, wholly uncited record, or a record whose committed bytes changed
underneath an existing citation. Catching a stale number under an
unchanged, still-correct citation still needs disciplined
re-review at PR time (this report's own diff should be part of any PR that
adds a `sim/*/records/*.md` file with a materially different headline) or
a generator for this report. The general aggregation tool klayout-tools
#309 asked for has landed as `klt signoff` (see "Caveats and notes" above), but it
grades `signoff/`'s manifest, not this report, so today disciplined
re-review is the only one of the two that exists for that narrower gap.
