2AMLogic/gf180-pll/sim/vco-tuning-range/records/20260927-214737-546a397.md

# Record 20260927-214737-546a397

- **Record ID**: 20260927-214737-546a397
- **Claim**: a design-input claim, and the one this campaign never made for
  itself -- are `sim/vco-tuning-range`'s band-select-mirror Monte Carlo
  draws DETERMINISTIC in `.option rndseed`, and GATED BY
  `sw_stat_mismatch` rather than by the seed, **in this campaign's own deck,
  DUT and measurement**? This is T1/bronze checklist item 6's "deterministic
  negative control" sub-criterion (#127) for this row, established here
  rather than delegated (#602). Both existing Monte Carlo records in this
  directory -- `records/20260817-143524-0e9cfc9.md` and
  `records/20260923-084925-1655e11.md` -- discharge that sub-criterion by
  CITING `sim/mc-cp-mismatch`'s model-capability finding and saying **"Not
  re-derived here"**. That citation was doubly indirect: it pointed at a
  different DUT (charge pump / PFD, not the VCO bias cascade), a different
  deck and a different measurement, and the sibling's own control was itself
  prose at the time. Those records keep their bytes and their numbers, which
  this record does not touch or re-measure; what changes is that the validity
  leg under them is now committed evidence in this directory, re-derivable by
  `./run_mismatch.sh --recheck-control 20260927-214737-546a397` without a simulator.
- **Model-capability gate**: re-derived here, not cited. `nfet_03v3`/
  `pfet_03v3` (via the `nfet_03v3_dss`/`pfet_03v3_dss` subcircuits)
  carry independent per-instance `agauss()` mismatch draws gated by
  `sw_stat_mismatch`, parsed once at netlist PARSE time and reproducible
  via `.option rndseed=N`. Every point in the Result table below
  re-establishes that on this campaign's own DUT.
- **Netlist provenance**: committed export `design/netlist/vco.spice` (the
  same DUT `tb_vco_tuning.spice` composes and both Monte Carlo records
  sample, unmodified), frozen into
  `sim/vco-tuning-range/netlist-snapshots/20260927-214737-546a397-vco-mismatch.spice`,
  SHA-256 `3d8bf1b307d7b230808c86b318262822fdf525c2503724609bdf51d1b1cc2d31`. Testbench deck: this campaign's own
  `tb_vco_mismatch.sp`, with ONE change made for this record (#602) --
  `sw_stat_mismatch` is now `'mc_mismatch'` instead of a pinned literal
  `1`, because a deck that cannot be run with the switch OFF cannot have a
  negative control. `mc_mismatch` has no default in the deck, so an
  invocation that forgets it fails at parse time instead of silently
  producing a mismatch-free "Monte Carlo" sample. Verified by direct
  experiment: `mc_mismatch=1` reproduces the pinned-literal deck's output
  exactly, so the production sample path is unchanged.
- **Environment provenance**:
  - PDK: volare `gf180mcuD`, open_pdks `c6d73a35f524070e85faff4a6a9eef49553ebc2b`
  - Models: `libs.tech/ngspice/sm141064.ngspice` (MIM devices via
    `sm141064_mim.ngspice`, pulled in by the `mimcap_*` sections);
    `design.ngspice` included first via sim/lib/simenv.sh's simenv_run_deck; this record runs each point at BOTH `sw_stat_mismatch = 1` and `sw_stat_mismatch = 0` (via the deck's `mc_mismatch` handle, see Netlist provenance) -- comparing the two IS the measurement. `sw_stat_global` stays 0 throughout, with `.option rndseed` set per run
  - Simulator: ngspice-46. Schematic capture: N/A -- design/netlist/vco.spice is a committed export, this testbench includes it directly (same convention as tb_vco_tuning.sp/.spice's pre-harness sibling)
  - Repo commit: `546a397` (DIRTY tree)
  - Host: Darwin 27.0.0 / arm64
- **Corner matrix run**: **25 (corner, temperature, supply,
  Vctrl, band) points** -- every point the Monte Carlo sample records in this
  experiment directory actually sample, and no others. The exact list, with each
  point's band-select code, nominal-frequency window sizing and transient-window
  bracket, is `CONTROL_POINTS` in `testbench/run_mismatch.sh`; the committed
  `corners/20260927-214737-546a397/negative_control.csv` names each point in its own rows. In
  groups:
  - `typical`/27C/3.30V (-> `.lib` sections `typical`, `res_typical`,
    `moscap_typical`), Vctrl = 1.8 V, bands 0 and 7
    (`records/20260817-143524-0e9cfc9.md`'s points), and `ss`/125C/3.63V
    (-> `ss`, `res_typical`, `moscap_typical`), Vctrl = 2.7 V, band 0
    (`records/20260923-084925-1655e11.md`'s point).
  - **All five MOS bundles** (`typical`, `ff`, `fs`, `sf`, `ss`) at
    125C/3.63V, bands 3 and 4 at Vctrl = 2.7 V and 0.9 V respectively -- the two
    ends of the B3 -> B4 pair, which is the deterministically thinnest adjacent
    pair at every bundle.
  - `ss` at the other three vertices of the temperature x supply box
    (-40C/2.97V, -40C/3.63V, 125C/2.97V), same two bands and Vctrl values.
  - `ss`/125C/3.63V at both ends of the B0 -> B1, B1 -> B2 and B6 -> B7 pairs
    (bands 0,1,2,6,7 across Vctrl = 2.7 V and 0.9 V as each pair requires).

  The last three groups are `run_band_pair_worst_corner.sh`'s 11-point
  joint-draw grid, decomposed into its single-band ends (#622).
  **Axes not swept**: the 27C temperature and 3.30V supply mid-points except
  where the first group already visits them; the composite `all-slow`/
  `all-fast` bundles; band 5; and the five intermediate Vctrl points.
  **Justification** (sim/README.md's "Default corner matrix" rule requires
  one for any subset): a control's grid is the grid of the samples it
  validates -- signoff/README.md's "Item 6(c)" states that reading, and it is
  the whole rule governing this field. Every point above is a point some
  committed sample record in this directory draws at, and every point those
  records draw at is above. The sample grid's own justification for being the
  subset it is belongs to the sample records, not here.
- **Methodology / criteria / limitations**:
  - **Five runs per point**, three legs derived from them -- `repeat`
    (mismatch ON, seed 1, twice) must be identical; `vary`
    (mismatch ON, seed 1 vs 97) must DIFFER;
    `gate` (mismatch OFF, seed 1 vs 97) must
    be identical. Schema and rationale: `sim/lib/simenv.sh`'s "Monte Carlo
    negative control" section.
  - **Same window sizing and same readout as the production samples** --
    `f = 4 / tp` off the buffered `CLK` output after `tsettle`, plus the
    supply current `i1`, with the transient window sized off each point's own
    systematic nominal frequency and its own sample path's bracket: +/-30% for
    the points `run_one`/`run_band0_worst_corner.sh` sample, 45%/45% for the
    points `run_band_pair_worst_corner.sh` samples (that script needs the wider
    window to hold a mismatched frequency past 3 sigma, and a control run through
    a narrower transient than its samples is not a control for them). The bracket
    travels with each `CONTROL_POINTS` row for exactly that reason.
  - **Values compared as TEXT, not within a tolerance** -- a tolerance would
    let a drifting draw keep passing.
  - **ONE DECK, deliberately: the single-band `tb_vco_mismatch.sp`, including
    for the points whose samples come from the two-band
    `tb_vco_band_pair.sp`.** What the three legs establish is a property of the
    MODEL AND THE PARSE at a given corner -- that the `agauss()` draws are
    deterministic in `.option rndseed` and gated by `sw_stat_mismatch` -- and
    that property is per (corner, temperature, supply, band, Vctrl), which is
    what this grid enumerates. It is NOT a check that the two-band deck's two
    `tran` analyses see the same draw; that is a separate claim, and it is
    established where it belongs, in `tb_vco_band_pair.sp`'s own sample
    records, whose committed per-draw logs hold both analyses under one parse for
    a reader to see. Stated here so the deck axis is read as a named residual
    rather than as coverage this record implies and does not have.
  - **What this record does NOT establish**: the adequacy of this campaign's
    sample count (item 6's sub-criterion (b) is a separate reading), the
    justification for the sample grid being the subset it is -- that belongs to
    the sample records' own "Corner matrix run" fields -- and no
    frequency-dispersion figure: it re-measures none of the sample records'
    numbers and supersedes none of them.
  - **Read the CSV's `sw_stat_mismatch` COLUMN, not its `# switches:`
    header line.** This artifact deliberately runs BOTH switch values, so no
    single header sentence can state its switches (#601's fifth
    `simenv_provenance` argument says as much, in prose, for exactly this
    reason); column 4 of each data row is authoritative. A record minted
    before this note was wired (see the erratum in this file's header
    comment) shipped the unconditional design.ngspice-default header instead.
- **Statistical convention**: N/A as a distribution claim -- no mean, sigma
  or `|mean|+3sigma` is reported and no distribution is sampled. The switch
  settings are the measurement: `sw_stat_global = 0` throughout,
  `sw_stat_mismatch` taking both 1 and 0, seeds 1 and
  97 via `.option rndseed`. Every run's raw log is committed
  under `corners/20260927-214737-546a397/`.
- **Result -- PASS**, per (band + Vctrl, corner) point, all
  25 of them:

  | Band @ Vctrl | Corner | `repeat` same seed -> identical | `vary` other seed -> differs | `gate` mismatch=0 -> seed-independent | Metrics that varied |
  |---|---|---|---|---|---|
  | band0_vc1.8 | `typical_27c_3.30v` | **PASS** | **PASS** | **PASS** | 2 of 2 |
  | band0_vc2.7 | `ss_125c_3.63v` | **PASS** | **PASS** | **PASS** | 2 of 2 |
  | band0_vc2.7_bp | `ss_125c_3.63v` | **PASS** | **PASS** | **PASS** | 2 of 2 |
  | band1_vc0.9 | `ss_125c_3.63v` | **PASS** | **PASS** | **PASS** | 2 of 2 |
  | band1_vc2.7 | `ss_125c_3.63v` | **PASS** | **PASS** | **PASS** | 2 of 2 |
  | band2_vc0.9 | `ss_125c_3.63v` | **PASS** | **PASS** | **PASS** | 2 of 2 |
  | band3_vc2.7 | `ff_125c_3.63v` | **PASS** | **PASS** | **PASS** | 2 of 2 |
  | band3_vc2.7 | `fs_125c_3.63v` | **PASS** | **PASS** | **PASS** | 2 of 2 |
  | band3_vc2.7 | `sf_125c_3.63v` | **PASS** | **PASS** | **PASS** | 2 of 2 |
  | band3_vc2.7 | `ss_-40c_2.97v` | **PASS** | **PASS** | **PASS** | 2 of 2 |
  | band3_vc2.7 | `ss_-40c_3.63v` | **PASS** | **PASS** | **PASS** | 2 of 2 |
  | band3_vc2.7 | `ss_125c_2.97v` | **PASS** | **PASS** | **PASS** | 2 of 2 |
  | band3_vc2.7 | `ss_125c_3.63v` | **PASS** | **PASS** | **PASS** | 2 of 2 |
  | band3_vc2.7 | `typical_125c_3.63v` | **PASS** | **PASS** | **PASS** | 2 of 2 |
  | band4_vc0.9 | `ff_125c_3.63v` | **PASS** | **PASS** | **PASS** | 2 of 2 |
  | band4_vc0.9 | `fs_125c_3.63v` | **PASS** | **PASS** | **PASS** | 2 of 2 |
  | band4_vc0.9 | `sf_125c_3.63v` | **PASS** | **PASS** | **PASS** | 2 of 2 |
  | band4_vc0.9 | `ss_-40c_2.97v` | **PASS** | **PASS** | **PASS** | 2 of 2 |
  | band4_vc0.9 | `ss_-40c_3.63v` | **PASS** | **PASS** | **PASS** | 2 of 2 |
  | band4_vc0.9 | `ss_125c_2.97v` | **PASS** | **PASS** | **PASS** | 2 of 2 |
  | band4_vc0.9 | `ss_125c_3.63v` | **PASS** | **PASS** | **PASS** | 2 of 2 |
  | band4_vc0.9 | `typical_125c_3.63v` | **PASS** | **PASS** | **PASS** | 2 of 2 |
  | band6_vc2.7 | `ss_125c_3.63v` | **PASS** | **PASS** | **PASS** | 2 of 2 |
  | band7_vc0.9 | `ss_125c_3.63v` | **PASS** | **PASS** | **PASS** | 2 of 2 |
  | band7_vc1.8 | `typical_27c_3.30v` | **PASS** | **PASS** | **PASS** | 2 of 2 |

  Derived from `corners/20260927-214737-546a397/negative_control.csv`, not written by hand.
  `./run_mismatch.sh --recheck-control 20260927-214737-546a397` reproduces it from the
  committed bytes with no simulator and exits non-zero if any leg fails.
- **Links**:
  - Testbench: `sim/vco-tuning-range/testbench/tb_vco_mismatch.sp`,
    `run_mismatch.sh` (`--control` / `--recheck-control`),
    `run_band0_worst_corner.sh` (the third point's sample script),
    `run_band_pair_worst_corner.sh` (the joint-draw grid whose points groups
    2-4 above cover; `--grid` prints that grid with no simulator)
  - Design: `design/vco.sch`, `design/vco_bias.sch`
  - Netlist snapshot:
    `sim/vco-tuning-range/netlist-snapshots/20260927-214737-546a397-vco-mismatch.spice`
  - Raw logs: `sim/vco-tuning-range/corners/20260927-214737-546a397/`
  - Extracted metrics:
    `sim/vco-tuning-range/corners/20260927-214737-546a397/negative_control.csv`
  - Sample records this control validates (none superseded):
    `sim/vco-tuning-range/records/20260817-143524-0e9cfc9.md`,
    `sim/vco-tuning-range/records/20260923-084925-1655e11.md`,
    `sim/vco-tuning-range/records/20260927-081930-d004d5b.md`,
    and the 25-point grid's own sample record minted by
    `run_band_pair_worst_corner.sh` (#622)
  - Sibling campaign's own control (same three legs, same schema):
    `sim/mc-cp-mismatch/records/`
- **Timestamp / author**: 2026-09-27T21:52:35Z, agent-builder (issues #602, #622)
- **Supersedes**: (none -- first record for this claim)
