2AMLogic/gf180-pll/sim/vco-tuning-range/records/20260927-220631-546a397.md

# Record 20260927-220631-546a397

- **Record ID**: 20260927-220631-546a397
- **Claim**: #8 / design/README.md's "3-bit band-select mirror" -- the
  adjacent-band coverage-hole check
  (`sim/vco-tuning-range/records/20260804-164956-72883fb.md`'s
  `band_overlap` check) with **both bands of a pair drawn from ONE
  per-instance mismatch draw**, each at its own end of the control window, over
  a **11-point PVT and band-pair grid that visits all five MOS
  bundles** -- so the inequality the check actually asks about,
  `f_max(band b) >= f_min(band b+1)` ON ONE DIE, is measured under mismatch
  as a per-draw ratio at every sampled point, with a verdict PER POINT and the
  binding point named.
  **This record's specific contribution over
  `20260927-081930-d004d5b`** (the single-point B0 -> B1 joint draw, #597) is
  the CORNER and PAIR axes, which that record left at 1 and explicitly named as
  residual gaps in its own Methodology field. Those residuals are T1/bronze
  item 6's sub-criterion (d) for this row (#127, issue #622): the campaign's
  Monte Carlo evidence sampled 2 of the 45 mandated PVT points, missing `ff`,
  `fs` and `sf` entirely. What this record settles that no prior record in
  this directory could is whether the DETERMINISTIC ordering the systematic
  sweep establishes -- which corner's overlap margin is thinnest -- is also the
  ordering of the DISPERSION that eats that margin. Those are two different
  questions, and #597's own finding on the sibling `sim/mc-cp-mismatch`
  campaign (three of four terms' binding corner moved once the grid widened) is
  the precedent that they can disagree.
  **No prior record is superseded**: `20260817-143524-0e9cfc9` (bands 0 and 7,
  mid-window, nominal corner), `20260923-084925-1655e11` (band 0 at `ss`/
  125C/3.63V against band 1's systematic floor) and
  `20260927-081930-d004d5b` (the single-point joint draw) all stand
  unmodified as historical evidence, sim/ being append-only. This record is
  additive and supersedes by CITATION only -- and one of its grid points
  (`ss_125c_3.63v_b0b1`) is deliberately the EXACT point
  `20260927-081930-d004d5b` sampled, on independent seeds, so that record's
  verdict is re-derived here rather than merely cited.
- **Model-capability gate**: this record RESTS ON the parse-time-seed finding
  rather than merely reusing it -- see
  `sim/mc-cp-mismatch/records/20260731-212614-640560e.md`'s
  "Model-capability gate" for the original evidence (`agauss()` per-instance
  draws inside `nfet_03v3_dss`/`pfet_03v3_dss`, gated by
  `sw_stat_mismatch`, evaluated ONCE at netlist PARSE time, reproducible via
  `.option rndseed=N`). That reproducibility claim is HOST-SCOPED -- same
  host, same build, same seed -> same draw; a different host is an
  independent replicate, not a reproduction of the same sample -- see
  sim/README.md's "Statistical convention" field. Parse-time evaluation is
  exactly what makes a joint
  two-band draw possible: two `tran` runs inside one `.control` block of
  `testbench/tb_vco_band_pair.sp` see the SAME offsets, because the draws
  happened before either ran. The band code is moved between the two runs with
  `alter` on three DC sources -- no device is added, removed or
  re-parameterised, so nothing the draw depends on changes. The same
  one-parse-many-analyses idiom is already in use in
  `sim/mc-cp-mismatch/testbench/tb_mc_cp_dc.sp` (three Vctrl points per
  draw); `20260927-081930-d004d5b` was the first application of it across the
  BAND axis and this record reuses it unchanged at every grid point.
  **The negative control for this record's sampled points is committed in this
  directory**: `records/20260927-214737-546a397.md`, re-checkable from its own
  committed bytes with no simulator via
  `run_mismatch.sh --recheck-control 20260927-214737-546a397`.
  `records/20260927-094524-b994116.md` established the three legs
  (`repeat`/`vary`/`gate`) on this campaign's own deck and DUT (#602) at
  the three points the campaign sampled then;
  `run_mismatch.sh`'s `CONTROL_POINTS` has since been widened alongside this
  grid -- to every point of it, decomposed into the single-band ends the control
  deck runs -- so the control's point set is the point set of the samples it
  validates, per `signoff/README.md`'s Item 6(c) rule. The control's own record
  names its coverage and its per-point verdicts; this record does not restate
  them.
- **Netlist provenance**: committed export `design/netlist/vco.spice` (the
  same DUT every prior mismatch record and the systematic `testbench/tb.json`
  sweep compose, unmodified by this record), frozen into
  `sim/vco-tuning-range/netlist-snapshots/20260927-220631-546a397-vco-band-pair-worst-corner.spice`,
  SHA-256 `3d8bf1b307d7b230808c86b318262822fdf525c2503724609bdf51d1b1cc2d31`. Testbench deck
  `sim/vco-tuning-range/testbench/tb_vco_band_pair.sp` is UNCHANGED from
  `20260927-081930-d004d5b` -- it already took both band codes, both control
  voltages and both transient windows as parameters, so widening the grid is a
  RUNNER change with no deck change, exactly as that record predicted in its own
  "What is still not measured" field. The single-band `tb_vco_mismatch.sp` the
  two earlier records and the negative control use is likewise unchanged and
  still present.
- **Environment provenance**:
  - PDK: volare `gf180mcuD`, open_pdks `c6d73a35f524070e85faff4a6a9eef49553ebc2b`
  - Models: `libs.tech/ngspice/sm141064.ngspice` (MIM devices via
    `sm141064_mim.ngspice`, pulled in by the `mimcap_*` sections);
    `design.ngspice` included first via sim/lib/simenv.sh's simenv_run_deck; this campaign's own deck (tb_vco_band_pair.sp) then declares sw_stat_global=0 / sw_stat_mismatch=1, positioned after the design.ngspice include so the later declaration wins -- same harness-ordering finding sim/vco-tuning-range/records/20260817-143524-0e9cfc9.md documents in full
  - Simulator: ngspice-46. Schematic capture: N/A -- design/netlist/vco.spice is a committed export, this testbench includes it directly
  - Repo commit: `546a397` (DIRTY tree)
  - Host: Darwin 27.0.0 / arm64
- **Corner matrix run**: **11 points**, each TWO bands per draw at
  opposite ends of the control window, 200 joint draws per point
  (2200 draws total). The sampled set spans **all five MOS bundles**
  (`typical`, `ff`, `fs`, `sf`, `ss`), **all four vertices of the
  temperature x supply box** (-40 C and 125 C x 2.97 V and 3.63 V) and **four of
  the seven adjacent band pairs** (B0 -> B1, B1 -> B2, B3 -> B4, B6 -> B7). The
  exact point list, with each point's group and its systematic reference
  frequencies, is committed at
  `sim/vco-tuning-range/corners/20260927-220631-546a397/per_point.csv` and re-printable with
  `./run_band_pair_worst_corner.sh --grid`, which also re-derives every
  reference frequency in it against the systematic sweep's own CSV with no
  simulator.

  **Justification** (sim/README.md's "Default corner matrix" rule requires one
  for any subset of the 45-point grid) -- the subset is built from three groups,
  each answering a question the single-point predecessor could not:

  1. **The bundle axis (5 points).** Each of the five MOS bundles at ITS OWN
     deterministically-thinnest adjacent-pair point, computed over all
     7 pairs x 3 temperatures x 3 supplies from
     `corners/20260804-164956-72883fb/raw_measures.csv`. That computation
     returns the SAME (pair, temperature, supply) for all five bundles --
     B3 -> B4 at 125 C / 3.63 V -- which is itself the finding that makes this
     group cheap: no bundle is sampled away from its own worst point even though
     temperature and supply are held fixed. Worst systematic ratio per bundle:
     `ss` 1.26784, `sf` 1.26807, `typical` 1.30659, `ff` 1.33878,
     `fs` 1.34419. This group is what discharges the "three of the five MOS
     bundles are never drawn" gap #622 names.
  2. **The temperature x supply box (3 further points).** `ss` -- the thinnest
     bundle -- at B3 -> B4 at the remaining three vertices: -40 C/2.97 V,
     -40 C/3.63 V, 125 C/2.97 V. This group exists to TEST the ordering rather
     than assume it. At -40 C/2.97 V the systematic ratio is WIDEST for this
     bundle (1.40054 against 1.26784 at 125 C/3.63 V), so if relative dispersion
     grows faster than the margin does, the binding point under mismatch is here
     and not in group 1. That possibility is the whole reason #622 was filed and
     nothing in this tree could previously have detected it.
  3. **The pair axis (3 further points).** `ss`/125 C/3.63 V for B0 -> B1,
     B1 -> B2 and B6 -> B7. B0 -> B1 is the continuity/regression point -- the
     exact point `20260927-081930-d004d5b` sampled, re-drawn here on
     independent seeds. B1 -> B2 is the second-thinnest pair at this point
     (1.29887). B6 -> B7 is the top of the band plan and the one pair whose own
     worst point the systematic sweep places at a DIFFERENT supply
     (`ss`/125 C/2.97 V), i.e. the pair whose deterministic optimum disagrees
     with the rest.

  **Axes NOT swept, stated rather than implied**: the 27 C temperature and the
  3.30 V supply mid-points; the two COMPOSITE bundles (`all-slow`/`all-fast`,
  which are not among the 45 mandated MOS-axis points -- see
  `bundle_libs()` in `testbench/common.sh`); pairs B2 -> B3, B4 -> B5,
  B5 -> B6, and B3 -> B4 at bundles other than `ss` away from 125 C/3.63 V;
  and every intermediate Vctrl point. That last one is a DEFINITIONAL exclusion
  rather than a sampling gap: `band_overlap` is
  `f_max(band b) / f_min(band b+1)`, so the inequality this campaign measures
  exists only at the two ends of the 0.9-2.7 V control window and a mid-window
  Vctrl does not appear in it at all. Vctrl = 2.7 V (lower band) and
  0.9 V (upper band) are therefore the only two control voltages in the
  grid, at every point, and they
  are the same two the systematic `band_overlap` check computes its ratio from
  (the seventh and the first of the seven 0.3 V-spaced control points).
- **Methodology / criteria / limitations**:
  - **One invocation = one draw = both bands.** `N_SAMPLES=200`
    invocations of `tb_vco_band_pair.sp` PER GRID POINT (2200 in
    total), one `.option rndseed` each, seeds `1..N` at every point. Each
    invocation runs two `tran` analyses in one `.control` block: the pair's
    LOWER band `b` (band-select code B2 B1 B0 = the three bits of `b`) at
    Vctrl = 2.7 V, then its UPPER band `b+1` at
    Vctrl = 0.9 V. Which `b` that is varies by grid point -- the four
    pairs sampled are B0 -> B1, B1 -> B2, B3 -> B4 and B6 -> B7, and each
    point's own `band_a`/`band_b` are committed in
    `corners/20260927-220631-546a397/per_point.csv` and in every row of
    `corners/20260927-220631-546a397/mismatch.csv`. Measurement criterion identical to every other
    `sim/vco-tuning-range/` record: `f = 4/tp`, `tp` from the first to
    the fifth rising half-supply crossing of the buffered `CLK` output after
    `tsettle` (>= 4 estimated periods), taken independently for each of the
    two runs.
  - **THE VERDICT STATISTIC IS THE RATIO'S OWN TAIL, PER POINT.** Because both
    frequencies come from one draw, the overlap ratio
    `f_max(band b) / f_min(band b+1)` is itself a per-sample quantity, and the
    criterion is its one-sided 3-sigma low tail:
    `mean(ratio) - 3*sigma(ratio) >= 1.0`, evaluated SEPARATELY at
    each of the 11 points. Below 1.0 the lower band's top has
    fallen past the upper band's bottom and there is a frequency neither band
    reaches. The two earliest mismatch records reported `|mean|+3sigma` as a
    PERCENTAGE of one band's mean and read it against the fractional overlap
    margin, and both flagged that in their own text as a sanity flag rather than
    a bound -- necessarily, because with one band drawn the inequality could not
    be written down under mismatch at all. Those percentage figures are carried
    in `per_point.csv` for continuity only.
  - **The verdict is stated PER POINT and the binding point is DERIVED.** The
    Result table below has one row per sampled point, and the binding point is
    the row with the lowest 3-sigma tail -- picked by the runner from the
    committed `per_point.csv`, not asserted in this prose. This is what #622
    asked for over the single-point predecessor: a grid whose every point passes
    comfortably and a grid whose single worst point passes by a hair produce the
    same headline number, and only a per-point table distinguishes them.
    **Mismatch did NOT move the binding point.** The grid's lowest
  3-sigma tail is at `ss_125c_3.63v_b3b4`, the same point the systematic sweep's
  `band_overlap.csv` names as deterministically thinnest. That is now a
  MEASUREMENT over 11 points rather than the assumption the
  single-point version of this campaign rested on, and it is the specific thing
  #622 said had never been checked.
  - **The independent-draw bound is reported beside it, and it is the wrong
    statistic -- measurably so, now at every point rather than at one.** Treating
    the two bands as unrelated and pushing each to its own opposite tail gives
    `(mean(f_A) - 3sd(f_A)) / (mean(f_B) + 3sd(f_B))`, which is reported per
    point in `per_point.csv` and in the Result table. It would have FAILED
    10 of the 11 points, against 0 for the
    joint statistic. The gap is not a modelling preference: the measured Pearson
    correlation between a pair's two frequencies across draws is
    **rho = 0.8874 .. 0.9958** across the whole grid -- high everywhere,
    so the dispersion is largely COMMON to both bands at every point sampled,
    which is what the shared hardware predicts: adjacent bands differ by one
    switched leg of `design/vco_bias.sch`'s mirror cascade and share every
    always-on leg, the V->I converter and all five ring stages. Common-mode
    dispersion cancels in a ratio and does not open a coverage hole; the
    independent bound double-counts it.
  - **rho is a property of the BAND PAIR, not of the corner -- and that is a
    finding this grid produced, not an assumption it inherited.**
    `20260927-081930-d004d5b` measured rho at ONE point (0.9958) and therefore
    could not tell a property of that corner from a property of the hardware.
    This grid separates the two axes by construction, and they separate cleanly:
    holding the PAIR fixed at B3 -> B4 and varying bundle, temperature and
    supply over all eight of those points moves rho only across
    **0.8874 .. 0.8996** (width 0.0122), while holding the CORNER
    fixed at `ss`/125 C/3.63 V and varying the pair moves it across
    **0.8921 .. 0.9958** (width 0.1037). The pair axis is the
    wider by 0.1037 against 0.0122, so rho tracks the BAND PAIR
    and is nearly invariant to corner, temperature and supply. The practical consequence is
    visible in the per-point table's "% margin kept" column: the B3 -> B4 points,
    whose rho is the LOWEST of the grid, keep only ~42-56% of their systematic
    margin, against ~88% at B0 -> B1 where rho is 0.9958. Less common-mode
    cancellation means more of the margin is eaten, which is precisely why the
    binding point is a B3 -> B4 point and why a campaign that had only ever
    sampled B0 -> B1 was reading this claim at its most favourable pair.
  - **What is still not measured.** (1) **Not every pair at every point**: the
    grid is a union of three one-dimensional cuts, not the full
    5 bundles x 4 vertices x 7 pairs cross product (140 points). The cuts are
    chosen so each crosses the other at the deterministically-thinnest point, but
    an interaction that only appears off all three cuts -- say `fs` at
    -40 C/2.97 V on B5 -> B6 -- is not sampled. (2) **Not the 27 C / 3.30 V
    mid-points, and not the composite bundles**: see the Corner matrix run field
    for why each is excluded. (3) **Global process variation stays off**
    (`sw_stat_global = 0`), as in every Monte Carlo campaign here -- the corner
    grid, not a global draw, is how process spread is represented. (4) **N is
    200 per point, and the verdict statistic is a 3-sigma tail**, so the
    figure carries the estimation error of a standard deviation at that N; the
    per-point standard error is committed beside it in `per_point.csv` so a
    reader can weigh a margin against sampling noise rather than read it as
    exact.
  - **Transient window**: sized PER POINT AND PER BAND off that band's own
    SYSTEMATIC frequency at that exact point, transcribed from
    `sim/vco-tuning-range/corners/20260804-164956-72883fb/raw_measures.csv`
    (band b's `f7` column and band b+1's `f1`) and re-derived against that
    CSV on every invocation before any simulator runs, so a stale or mistyped
    reference cannot size a window. Bracket:
    45% /
    45% either side
    -- WIDER than the +/-30% the single-band scripts use, because this window has
    to hold a mismatched frequency whose own 3-sigma spread those records
    measured at roughly 25% of the mean, and a 30% window leaves no margin past
    3 sigma. Never trusted for a result, only for tstep/tstop sizing. Every
    draw's two frequencies are asserted to land inside that bracket before the
    sample is accepted, so a `meas` that latched onto the wrong edge is
    rejected rather than averaged in; all 2200 draws passed that
    assertion, and the runner additionally asserts that each of the
    11 points contributed exactly 200 accepted rows.
- **Statistical convention**: `sw_stat_global = 0`,
  `sw_stat_mismatch = 1` (mismatch-only, global process variation off,
  matching every other Monte Carlo campaign in this repo).
  `N_SAMPLES=200` joint draws PER POINT (2200 total), each
  yielding both bands. Seeds: sequential integers `1..N` at every point, passed
  via `.option rndseed`. The same seed at two different points is a different
  draw (the corner, temperature and supply differ, so the parse differs), so the
  points are independent samples and not a repeated one; every draw's raw log is
  committed under `corners/20260927-220631-546a397/`, named for its point id and seed, and holds
  BOTH runs so a reader can see the two analyses share one parse. Dispersion
  reported at mean +/- sample standard deviation (N-1 denominator); the verdict
  uses the per-draw RATIO's one-sided 3-sigma tail, in the direction that closes
  the overlap, evaluated per point.
- **Result**: 11 PASS / 0 FAIL over 11 points --
  **PASS**. One row per sampled point, generated from
  `corners/20260927-220631-546a397/per_point.csv`, which is itself derived from
  `corners/20260927-220631-546a397/mismatch.csv` with no simulator:

  | point | group | pair | n | ratio mean | ratio sd | **mean-3sigma** | systematic ratio | % margin kept | verdict |
  |---|---|---|---|---|---|---|---|---|---|
  | `typical_125c_3.63v_b3b4` | bundle | B3 -> B4 | 200 | 1.30547 | 0.0448948 | 1.17078 | 1.30659 | 55.7 | **PASS** |
  | `ff_125c_3.63v_b3b4` | bundle | B3 -> B4 | 200 | 1.3368 | 0.0461845 | 1.19824 | 1.33878 | 58.5 | **PASS** |
  | `fs_125c_3.63v_b3b4` | bundle | B3 -> B4 | 200 | 1.34261 | 0.0462878 | 1.20375 | 1.34419 | 59.2 | **PASS** |
  | `sf_125c_3.63v_b3b4` | bundle | B3 -> B4 | 200 | 1.26616 | 0.0421083 | 1.13984 | 1.26807 | 52.2 | **PASS** |
  | `ss_125c_3.63v_b3b4` **(binding)** | bundle | B3 -> B4 | 200 | 1.2664 | 0.0423483 | 1.13935 | 1.26784 | 52 | **PASS** |
  | `ss_-40c_2.97v_b3b4` | tempvolt | B3 -> B4 | 200 | 1.39667 | 0.0727718 | 1.17836 | 1.40054 | 44.5 | **PASS** |
  | `ss_-40c_3.63v_b3b4` | tempvolt | B3 -> B4 | 200 | 1.343 | 0.0649931 | 1.14802 | 1.34609 | 42.8 | **PASS** |
  | `ss_125c_2.97v_b3b4` | tempvolt | B3 -> B4 | 200 | 1.30744 | 0.04644 | 1.16812 | 1.30970 | 54.3 | **PASS** |
  | `ss_125c_3.63v_b0b1` | pair | B0 -> B1 | 200 | 1.31991 | 0.0126595 | 1.28194 | 1.31882 | 88.4 | **PASS** |
  | `ss_125c_3.63v_b1b2` | pair | B1 -> B2 | 200 | 1.30027 | 0.0297566 | 1.21100 | 1.29887 | 70.6 | **PASS** |
  | `ss_125c_3.63v_b6b7` | pair | B6 -> B7 | 200 | 1.37158 | 0.0151588 | 1.32610 | 1.36993 | 88.2 | **PASS** |

  The verdict line is `mean(ratio) - 3*sigma(ratio) >= 1.0` at every
  row. "% margin kept" is that statistic's distance above the floor as a
  percentage of the systematic ratio's own distance above it, so a point whose
  deterministic margin is wide and a point whose margin is narrow are comparable.

  **Every sampled pair stays overlapped with both bands drawn jointly.** All
  11 of the 11 grid points hold their per-draw ratio's
  one-sided 3-sigma low tail at or above the 1.0 floor. The binding
  point is `ss_125c_3.63v_b3b4` at 1.13935 -- 46.54 standard errors
  of that point's ratio mean above the floor, keeping 52% of its
  1.26784 systematic margin. There is no frequency any SAMPLED adjacent pair
  fails to reach at 3 sigma of the joint draw, at any sampled point.

  **The binding point, and the same samples under the retired methodology.**

  | Criterion | Statistic | Line | Verdict |
  |---|---|---|---|
  | binding point `ss_125c_3.63v_b3b4` (group bundle), joint 3-sigma worst case | mean(ratio) - 3sigma(ratio) = **1.13935** | >= 1.0 | **PASS** |
  | -- the same point under the earlier records' INDEPENDENT-draw treatment | 0.88746 | >= 1.0 | FAIL (not this record's verdict) |
  | -- measured correlation at the binding point | rho = 0.8921 | -- | -- |
  | -- the point the SYSTEMATIC sweep predicted would bind, `ss_125c_3.63v_b3b4` | mean(ratio) - 3sigma(ratio) = 1.13935 | >= 1.0 | PASS |
  | -- points the INDEPENDENT-draw bound would have failed | 10 of 11 | -- | (methodology cost, not a verdict) |

  Per-point standard errors, the full per-band moments, the +-3sigma-as-a-
  percentage-of-mean figures the two earliest records used as their proxy, and
  the per-point rho are all committed in `corners/20260927-220631-546a397/per_point.csv` rather
  than quoted selectively here. The proxy figures are carried for continuity
  only; comparing them against a fractional overlap margin is the comparison
  this record's per-draw ratio replaces, and the measured rho above is why.
- **Links**:
  - Testbench: `sim/vco-tuning-range/testbench/tb_vco_band_pair.sp`
    (unchanged from `20260927-081930-d004d5b`),
    `run_band_pair_worst_corner.sh` (extended to the 11-point grid for
    this record; `--grid` prints it and re-derives its reference frequencies
    with no simulator)
  - Design: `design/vco.sch`, `design/vco_bias.sch`, `design/vco_stage.sch`
  - Netlist snapshot:
    `sim/vco-tuning-range/netlist-snapshots/20260927-220631-546a397-vco-band-pair-worst-corner.spice`
  - Raw logs: `sim/vco-tuning-range/corners/20260927-220631-546a397/` (2200 draw logs,
    two analyses each, named `pair_<point_id>_seedNNN.log`)
  - Extracted metrics: `sim/vco-tuning-range/corners/20260927-220631-546a397/mismatch.csv`
    (one row per draw), `.../per_point.csv` (one derived row per grid point --
    the Result table above is generated from it)
  - Systematic sweep and overlap check every grid point's corner, Vctrl points
    and reference frequencies are drawn from (unchanged, untouched):
    `sim/vco-tuning-range/records/20260804-164956-72883fb.md`,
    `sim/vco-tuning-range/corners/20260804-164956-72883fb/band_overlap.csv`,
    `sim/vco-tuning-range/corners/20260804-164956-72883fb/raw_measures.csv`
  - Prior mismatch records this one follows on from (none superseded):
    `sim/vco-tuning-range/records/20260817-143524-0e9cfc9.md` (bands 0 and 7,
    mid-window, nominal corner),
    `sim/vco-tuning-range/records/20260923-084925-1655e11.md` (band 0 at
    `ss`/125C/3.63V, against band 1's systematic floor),
    `sim/vco-tuning-range/records/20260927-081930-d004d5b.md` (the
    single-point B0 -> B1 joint draw this grid's
    `ss_125c_3.63v_b0b1` point re-derives on independent seeds)
  - This campaign's committed negative control, widened alongside this grid to
    cover every point of it:
    `sim/vco-tuning-range/records/20260927-214737-546a397.md`, re-checkable from
    committed bytes with no simulator via
    `./run_mismatch.sh --recheck-control 20260927-214737-546a397`; its
    pre-widening predecessor, which established the three legs on this deck, is
    `sim/vco-tuning-range/records/20260927-094524-b994116.md` (#602)
  - The one-parse-many-analyses idiom this deck reuses:
    `sim/mc-cp-mismatch/testbench/tb_mc_cp_dc.sp`
  - The sibling campaign whose own corner-axis widening (#597) is the precedent
    for this one, and whose finding that a subset's binding corner can move is
    why this grid tests the ordering instead of assuming it:
    `sim/mc-cp-mismatch/records/20260927-102154-d004d5b.md`,
    `sim/mc-cp-mismatch/testbench/run.sh`
- **Timestamp / author**: 2026-09-27T22:07:22Z, agent-builder (issue #622)
- **Supersedes**: (none -- first record for this claim)
