2AMLogic/gf180-pll/sim/vco-tuning-range/records/20260927-094524-b994116.md

# Record 20260927-094524-b994116

- **Record ID**: 20260927-094524-b994116
- **Claim**: a design-input claim, and the one this campaign never made for
  itself -- are `sim/vco-tuning-range`'s band-select-mirror Monte Carlo
  draws DETERMINISTIC in `.option rndseed`, and GATED BY
  `sw_stat_mismatch` rather than by the seed, **in this campaign's own deck,
  DUT and measurement**? This is T1/bronze checklist item 6's "deterministic
  negative control" sub-criterion (#127) for this row, established here
  rather than delegated (#602). Both existing Monte Carlo records in this
  directory -- `records/20260817-143524-0e9cfc9.md` and
  `records/20260923-084925-1655e11.md` -- discharge that sub-criterion by
  CITING `sim/mc-cp-mismatch`'s model-capability finding and saying **"Not
  re-derived here"**. That citation was doubly indirect: it pointed at a
  different DUT (charge pump / PFD, not the VCO bias cascade), a different
  deck and a different measurement, and the sibling's own control was itself
  prose at the time. Those records keep their bytes and their numbers, which
  this record does not touch or re-measure; what changes is that the validity
  leg under them is now committed evidence in this directory, re-derivable by
  `./run_mismatch.sh --recheck-control 20260927-094524-b994116` without a simulator.
- **Model-capability gate**: re-derived here, not cited. `nfet_03v3`/
  `pfet_03v3` (via the `nfet_03v3_dss`/`pfet_03v3_dss` subcircuits)
  carry independent per-instance `agauss()` mismatch draws gated by
  `sw_stat_mismatch`, parsed once at netlist PARSE time and reproducible
  via `.option rndseed=N`. Every point in the Result table below
  re-establishes that on this campaign's own DUT.
- **Netlist provenance**: committed export `design/netlist/vco.spice` (the
  same DUT `tb_vco_tuning.spice` composes and both Monte Carlo records
  sample, unmodified), frozen into
  `sim/vco-tuning-range/netlist-snapshots/20260927-094524-b994116-vco-mismatch.spice`,
  SHA-256 `3d8bf1b307d7b230808c86b318262822fdf525c2503724609bdf51d1b1cc2d31`. Testbench deck: this campaign's own
  `tb_vco_mismatch.sp`, with ONE change made for this record (#602) --
  `sw_stat_mismatch` is now `'mc_mismatch'` instead of a pinned literal
  `1`, because a deck that cannot be run with the switch OFF cannot have a
  negative control. `mc_mismatch` has no default in the deck, so an
  invocation that forgets it fails at parse time instead of silently
  producing a mismatch-free "Monte Carlo" sample. Verified by direct
  experiment: `mc_mismatch=1` reproduces the pinned-literal deck's output
  exactly, so the production sample path is unchanged.
- **Environment provenance**:
  - PDK: volare `gf180mcuD`, open_pdks `c6d73a35f524070e85faff4a6a9eef49553ebc2b`
  - Models: `libs.tech/ngspice/sm141064.ngspice` (MIM devices via
    `sm141064_mim.ngspice`, pulled in by the `mimcap_*` sections);
    `design.ngspice` included first via sim/lib/simenv.sh's simenv_run_deck; this record runs each point at BOTH `sw_stat_mismatch = 1` and `sw_stat_mismatch = 0` (via the deck's `mc_mismatch` handle, see Netlist provenance) -- comparing the two IS the measurement. `sw_stat_global` stays 0 throughout, with `.option rndseed` set per run
  - Simulator: ngspice-46. Schematic capture: N/A -- design/netlist/vco.spice is a committed export, this testbench includes it directly (same convention as tb_vco_tuning.sp/.spice's pre-harness sibling)
  - Repo commit: `b994116` (DIRTY tree)
  - Host: Linux 7.0.0-1012-aws / x86_64
- **Corner matrix run**: every (corner, Vctrl, band) point the two Monte
  Carlo records in this experiment directory actually sample, and no others
  -- `typical`/27C/3.30V (-> `.lib` sections `typical`,
  `res_typical`, `moscap_typical`), Vctrl = 1.8 V, bands 0 and 7
  (`records/20260817-143524-0e9cfc9.md`'s points); and `ss`/125C/3.63V
  (-> `ss`, `res_typical`, `moscap_typical`), Vctrl = 2.7 V, band 0
  (`records/20260923-084925-1655e11.md`'s point).
  **Axes not swept**: the remaining MOS corners (`ff`, `fs`, `sf`), the
  intermediate temperature/supply points, the other six band codes and the
  rest of the Vctrl window.
  **Justification** (sim/README.md's "Default corner matrix" rule requires
  one for any subset): a control's grid is the grid of the samples it
  validates. Extending this campaign's SAMPLE grid past those points is item
  6's sub-criterion (d) and is tracked as #597; doing it here would be a
  different record making a different claim.
- **Methodology / criteria / limitations**:
  - **Five runs per point**, three legs derived from them -- `repeat`
    (mismatch ON, seed 1, twice) must be identical; `vary`
    (mismatch ON, seed 1 vs 97) must DIFFER;
    `gate` (mismatch OFF, seed 1 vs 97) must
    be identical. Schema and rationale: `sim/lib/simenv.sh`'s "Monte Carlo
    negative control" section.
  - **Same deck, same window sizing, same readout as the production
    samples** -- `f = 4 / tp` off the buffered `CLK` output after
    `tsettle`, plus the supply current `i1`, with the transient window
    sized off each point's own systematic nominal frequency exactly as
    `run_one`/`run_band0_worst_corner.sh` size it. A control taken
    through a cheaper or simpler path would not be a control for these
    samples.
  - **Values compared as TEXT, not within a tolerance** -- a tolerance would
    let a drifting draw keep passing.
  - **What this record does NOT establish**: the adequacy of this campaign's
    sample count or its corner/band/Vctrl coverage (item 6's sub-criterion
    (d), #597), and no frequency-dispersion figure -- it re-measures none of
    the two sample records' numbers and supersedes neither.
  - **Read the CSV's `sw_stat_mismatch` COLUMN, not its `# switches:`
    header line.** `simenv_provenance` emits a fixed
    "sw_stat_global=0, sw_stat_mismatch=0" sentence for every campaign in
    this tree -- the separately-filed provenance-header defect (#601), left
    untouched here rather than fixed as a side effect, and doubly wrong for
    an artifact that deliberately runs both values. Column 4 of each data row
    is authoritative.
- **Statistical convention**: N/A as a distribution claim -- no mean, sigma
  or `|mean|+3sigma` is reported and no distribution is sampled. The switch
  settings are the measurement: `sw_stat_global = 0` throughout,
  `sw_stat_mismatch` taking both 1 and 0, seeds 1 and
  97 via `.option rndseed`. Every run's raw log is committed
  under `corners/20260927-094524-b994116/`.
- **Result -- PASS**, per (band, corner) point:

  | Band | Corner | `repeat` same seed -> identical | `vary` other seed -> differs | `gate` mismatch=0 -> seed-independent | Metrics that varied |
  |---|---|---|---|---|---|
  | band0 | `ss_125c_3.63v` | **PASS** | **PASS** | **PASS** | 2 of 2 |
  | band0 | `typical_27c_3.30v` | **PASS** | **PASS** | **PASS** | 2 of 2 |
  | band7 | `typical_27c_3.30v` | **PASS** | **PASS** | **PASS** | 2 of 2 |

  Derived from `corners/20260927-094524-b994116/negative_control.csv`, not written by hand.
  `./run_mismatch.sh --recheck-control 20260927-094524-b994116` reproduces it from the
  committed bytes with no simulator and exits non-zero if any leg fails.
- **Links**:
  - Testbench: `sim/vco-tuning-range/testbench/tb_vco_mismatch.sp`,
    `run_mismatch.sh` (`--control` / `--recheck-control`),
    `run_band0_worst_corner.sh` (the third point's sample script)
  - Design: `design/vco.sch`, `design/vco_bias.sch`
  - Netlist snapshot:
    `sim/vco-tuning-range/netlist-snapshots/20260927-094524-b994116-vco-mismatch.spice`
  - Raw logs: `sim/vco-tuning-range/corners/20260927-094524-b994116/`
  - Extracted metrics:
    `sim/vco-tuning-range/corners/20260927-094524-b994116/negative_control.csv`
  - Sample records this control validates (neither superseded):
    `sim/vco-tuning-range/records/20260817-143524-0e9cfc9.md`,
    `sim/vco-tuning-range/records/20260923-084925-1655e11.md`
  - Sibling campaign's own control (same three legs, same schema):
    `sim/mc-cp-mismatch/records/`
- **Timestamp / author**: 2026-09-27T09:45:36Z, agent-builder (issue #602)
- **Supersedes**: (none -- first record for this claim)
