2AMLogic/gf180-pll/sim/vco-tuning-range/records/20260927-081930-d004d5b.md

# Record 20260927-081930-d004d5b

- **Record ID**: 20260927-081930-d004d5b
- **Claim**: #8 / design/README.md's "3-bit band-select mirror" -- the
  B0 -> B1 adjacent-band pair's coverage-hole check
  (`sim/vco-tuning-range/records/20260804-164956-72883fb.md`'s
  `band_overlap` check, worst ratio 1.319 at `ss`/125C/3.63V) with **both
  bands drawn from ONE per-instance mismatch draw** at that corner, each at its
  own end of the control window -- so the inequality the check actually asks
  about, `f_max(band 0) >= f_min(band 1)` ON ONE DIE, is
  measured under mismatch as a per-draw ratio instead of being proxied by one
  band's relative dispersion. Closes both limitations
  `sim/vco-tuning-range/records/20260923-084925-1655e11.md` names in its own
  Methodology field -- "Band 1's own f_min is NOT re-measured with mismatch
  here ... not a joint two-band Monte Carlo", and the proxy convention it
  inherited ("an order-of-magnitude sanity flag, not a rigorous directional
  bound") -- and the band-axis half of T1/bronze item 6's corner-combination
  sub-criterion (#127, issue #597: this campaign's Monte Carlo evidence was
  2 corners x 1 band, never 1 corner x 2 bands). Neither prior record is
  superseded: `20260817-143524-0e9cfc9` (bands 0 and 7, mid-window, nominal
  corner) and `20260923-084925-1655e11` (band 0 at this corner and Vctrl,
  against band 1's systematic floor) both stand unmodified as historical
  evidence, sim/ being append-only. This record is additive and is the first in
  this repo to draw two band codes from one mismatch draw.
- **Model-capability gate**: this record RESTS ON the parse-time-seed finding
  rather than merely reusing it -- see
  `sim/mc-cp-mismatch/records/20260731-212614-640560e.md`'s
  "Model-capability gate" for the original evidence (`agauss()` per-instance
  draws inside `nfet_03v3_dss`/`pfet_03v3_dss`, gated by
  `sw_stat_mismatch`, evaluated ONCE at netlist PARSE time, reproducible via
  `.option rndseed=N`). Parse-time evaluation is exactly what makes a joint
  two-band draw possible: two `tran` runs inside one `.control` block of
  `testbench/tb_vco_band_pair.sp` see the SAME offsets, because the draws
  happened before either ran. The band code is moved between the two runs with
  `alter` on three DC sources -- no device is added, removed or
  re-parameterised, so nothing the draw depends on changes. The same
  one-parse-many-analyses idiom is already in use in
  `sim/mc-cp-mismatch/testbench/tb_mc_cp_dc.sp` (three Vctrl points per
  draw); what is new here is applying it across the BAND axis.
  #597's own negative-control re-check was performed on the sibling campaign at
  a newly added MOS bundle and is recorded there.
- **Netlist provenance**: committed export `design/netlist/vco.spice` (the
  same DUT both prior mismatch records and the systematic `testbench/tb.json`
  sweep compose, unmodified by this record), frozen into
  `sim/vco-tuning-range/netlist-snapshots/20260927-081930-d004d5b-vco-band-pair-worst-corner.spice`,
  SHA-256 `3d8bf1b307d7b230808c86b318262822fdf525c2503724609bdf51d1b1cc2d31`. Testbench deck
  `sim/vco-tuning-range/testbench/tb_vco_band_pair.sp` is NEW for this record
  (the single-band `tb_vco_mismatch.sp` both prior records use is unchanged
  and still present); it contains stimulus, the two-run control block,
  measurement and the `sw_stat_mismatch`/`rndseed` overrides only, with
  both band codes and both control voltages as parameters.
- **Environment provenance**:
  - PDK: volare `gf180mcuD`, open_pdks `c6d73a35f524070e85faff4a6a9eef49553ebc2b`
  - Models: `libs.tech/ngspice/sm141064.ngspice` (MIM devices via
    `sm141064_mim.ngspice`, pulled in by the `mimcap_*` sections);
    `design.ngspice` included first via sim/lib/simenv.sh's simenv_run_deck; this campaign's own deck (tb_vco_band_pair.sp) then declares sw_stat_global=0 / sw_stat_mismatch=1, positioned after the design.ngspice include so the later declaration wins -- same harness-ordering finding sim/vco-tuning-range/records/20260817-143524-0e9cfc9.md documents in full
  - Simulator: ngspice-46. Schematic capture: N/A -- design/netlist/vco.spice is a committed export, this testbench includes it directly
  - Repo commit: `d004d5b` (DIRTY tree)
  - Host: Darwin 27.0.0 / arm64
- **Corner matrix run**: ONE corner, TWO bands per draw, each at its own
  control-window end -- `ss` (-> `.lib` sections `ss,res_typical,moscap_typical`)
  / 125 C / 3.63 V, with band 0 at Vctrl = 2.7 V (its
  f_max) and band 1 at Vctrl = 0.9 V (its f_min). **Axes not
  swept**: every other corner, temperature and supply; the five intermediate
  Vctrl points; and band codes 2-7. **Justification** (sim/README.md's
  "Default corner matrix" rule): the corner is not chosen for convenience and
  is not nominal -- it is the EXACT point
  `sim/vco-tuning-range/corners/20260804-164956-72883fb/band_overlap.csv`
  reports as this pair's WORST overlap ratio, and the two Vctrl values are the
  exact two points that ratio is computed from (`raw_measures.csv` rows
  `ss,125.0,3.63,band0` f7 = 9122300 Hz and `ss,125.0,3.63,band1` f1 =
  6917000 Hz, ratio 1.31882, matching the 1.319 that file cites). A
  margin binds where it is thinnest, and that corner is already identified by
  the systematic 45-point sweep; measuring the dispersion anywhere else would
  reintroduce exactly the different-point comparison the prior records had to
  flag. What THIS record adds over `20260923-084925-1655e11`, which already
  ran at this corner and this Vctrl, is the SECOND BAND, drawn jointly -- the
  axis #597 found at 1 for this campaign.
- **Methodology / criteria / limitations**:
  - **One invocation = one draw = both bands.** `N_SAMPLES=200`
    invocations of `tb_vco_band_pair.sp`, one `.option rndseed` each, seeds
    `1..N`. Each invocation runs two `tran` analyses in one `.control`
    block: band 0 (band-select code B2 B1 B0 = 000) at
    Vctrl = 2.7 V, then band 1 (code B2 B1 B0 = 001) at
    Vctrl = 0.9 V. Measurement criterion identical to every other
    `sim/vco-tuning-range/` record: `f = 4/tp`, `tp` from the first to
    the fifth rising half-supply crossing of the buffered `CLK` output after
    `tsettle` (>= 4 estimated periods), taken independently for each of the
    two runs.
  - **THE VERDICT STATISTIC IS THE RATIO'S OWN TAIL, and that is the point of
    this record.** Because both frequencies come from one draw, the overlap
    ratio `f_max(band 0) / f_min(band 1)` is itself a
    per-sample quantity, and the criterion is its one-sided 3-sigma low tail:
    `mean(ratio) - 3*sigma(ratio) >= 1.0`. Below 1.0
    the lower band's top has fallen past the upper band's bottom and there is a
    frequency neither band reaches. Both prior mismatch records reported
    `|mean|+3sigma` as a PERCENTAGE of one band's mean and read it against
    the fractional overlap margin, and both flagged that in their own text as a
    sanity flag rather than a bound -- necessarily, because with one band drawn
    the inequality could not be written down under mismatch at all. Those
    percentage figures are reported below for continuity only.
  - **The independent-draw bound is reported beside it, and it is the wrong
    statistic -- measurably so.** On these same samples, treating the two bands
    as unrelated and pushing each to its own opposite tail gives
    `(mean(f_A) - 3sd(f_A)) / (mean(f_B) + 3sd(f_B))` = 0.79910
    (FAIL), against the joint 1.28193 (PASS). The gap between
    those two numbers is not a modelling preference: the measured Pearson
    correlation between the pair's two frequencies across draws is
    **rho = 0.9958**, i.e. the dispersion is largely COMMON to both bands,
    which is what the shared hardware predicts -- bands 0 and
    1 differ by one switched leg of `design/vco_bias.sch`'s mirror
    cascade and share every always-on leg, the V->I converter and all five ring
    stages. Common-mode dispersion cancels in a ratio and does not open a
    coverage hole; the independent bound double-counts it. That correlation is
    a MEASUREMENT here, which is why this record can state the point instead of
    arguing it.
  - **What is still not measured.** (1) Only this pair: B0 ->
    B1 is the pair band 0's own coverage-hole risk lives on,
    but the worst ratio across ALL SEVEN adjacent pairs belongs to B3 -> B4
    (1.268, same corner) and is unmeasured under mismatch on either side. The
    deck takes both band codes as parameters, so extending to another pair is a
    runner change with no deck change -- it is simply not done here.
    (2) Only this corner: the corner axis of this campaign's Monte Carlo
    evidence is still 1 wide, deliberately (the binding corner is known from
    the systematic sweep), whereas the sibling `sim/mc-cp-mismatch` campaign
    is where #597 widens the corner axis. (3) Global process variation stays
    off (`sw_stat_global = 0`), as in every Monte Carlo campaign here -- the
    corner grid, not a global draw, is how process spread is represented.
  - **Transient window**: sized per band off that band's own SYSTEMATIC
    frequency (9122300 Hz for band 0, 6917000 Hz for band
    1, both from
    `sim/vco-tuning-range/corners/20260804-164956-72883fb/raw_measures.csv`)
    with a 45% /
    45% bracket
    either side -- WIDER than the +/-30% the single-band scripts use, because
    this window has to hold a mismatched frequency whose own 3-sigma spread
    those records measured at roughly 25% of the mean, and a 30% window leaves
    no margin past 3 sigma. Never trusted for a result, only for tstep/tstop
    sizing. Every draw's two frequencies are asserted to land inside that
    bracket before the sample is accepted, so a `meas` that latched onto the
    wrong edge is rejected rather than averaged in; all 200 draws
    passed that assertion.
- **Statistical convention**: `sw_stat_global = 0`,
  `sw_stat_mismatch = 1` (mismatch-only, global process variation off,
  matching every other Monte Carlo campaign in this repo).
  `N_SAMPLES=200` joint draws, each yielding both bands. Seeds:
  sequential integers `1..N`, passed via `.option rndseed`; every draw's
  raw log is committed under `corners/20260927-081930-d004d5b/` and holds BOTH runs, so a
  reader can see the two analyses share one parse. Dispersion reported at mean
  +/- sample standard deviation (N-1 denominator); the verdict uses the
  per-draw RATIO's one-sided 3-sigma tail, in the direction that closes the
  overlap.
- **Result**:

  | Quantity | Mean | sd | n | systematic reference |
  |---|---|---|---|---|
  | band 0 f at Vctrl=2.7 V (f_max side) | 9.07395e+06 Hz | 722404 Hz | 200 | 9122300 Hz |
  | band 1 f at Vctrl=0.9 V (f_min side) | 6.87832e+06 Hz | 588269 Hz | 200 | 6917000 Hz |
  | **per-draw overlap ratio f_A / f_B** | **1.31991** | **0.0126595** | 200 | 1.31882 |

  | Criterion | Statistic | Line | Verdict |
  |---|---|---|---|
  | B0 -> B1 overlap, joint 3-sigma worst case | mean(ratio) - 3sigma(ratio) = **1.28193** | >= 1.0 | **PASS** |
  | -- the same samples under the prior records' INDEPENDENT-draw treatment | 6.90674e+06 / 8.64313e+06 = 0.79910 | >= 1.0 | FAIL (not this record's verdict) |
  | -- measured correlation between the pair's two frequencies | rho = 0.9958 | -- | -- |

  **The pair stays overlapped with both bands drawn jointly.** The per-draw
  ratio's own 3-sigma low tail is 1.28193 against the 1.0 floor --
  314.9 standard errors of the ratio's mean above it, keeping
  88.4% of the 1.31882 systematic margin. There is no
  frequency the B0/B1 pair fails to reach at this corner at
  3 sigma of the joint draw.

  Standard error of the ratio's mean: 0.000895162 at n=200 -- reported so the
  verdict's margin can be weighed against sampling noise rather than read as an
  exact figure. It is the MEAN's standard error, a lower bound on the
  uncertainty in `mean - 3sigma`, which also carries the 3-sigma multiplier's
  own estimation error.

  The prior two records' proxy figure, for continuity only and NOT this
  record's verdict: +-3sigma as a percentage of the mean is 23.88% for
  band 0 and 25.66% for band 1, against the
  1.31882 systematic ratio's 31.88% fractional margin.
  Comparing those percentages against that margin is the comparison this
  record replaces, and the rho = 0.9958 above is why.
- **Links**:
  - Testbench: `sim/vco-tuning-range/testbench/tb_vco_band_pair.sp` (new),
    `run_band_pair_worst_corner.sh` (new)
  - Design: `design/vco.sch`, `design/vco_bias.sch`, `design/vco_stage.sch`
  - Netlist snapshot:
    `sim/vco-tuning-range/netlist-snapshots/20260927-081930-d004d5b-vco-band-pair-worst-corner.spice`
  - Raw logs: `sim/vco-tuning-range/corners/20260927-081930-d004d5b/`
  - Extracted metrics: `sim/vco-tuning-range/corners/20260927-081930-d004d5b/mismatch.csv`
  - Systematic sweep and overlap check this record's corner, Vctrl points and
    reference frequencies are drawn from (unchanged, untouched):
    `sim/vco-tuning-range/records/20260804-164956-72883fb.md`,
    `sim/vco-tuning-range/corners/20260804-164956-72883fb/band_overlap.csv`,
    `sim/vco-tuning-range/corners/20260804-164956-72883fb/raw_measures.csv`
  - Prior mismatch records this one follows on from (neither superseded):
    `sim/vco-tuning-range/records/20260817-143524-0e9cfc9.md` (bands 0 and 7,
    mid-window, nominal corner),
    `sim/vco-tuning-range/records/20260923-084925-1655e11.md` (band 0 at this
    same corner and Vctrl, against band 1's systematic floor)
  - The one-parse-many-analyses idiom this deck reuses:
    `sim/mc-cp-mismatch/testbench/tb_mc_cp_dc.sp`
  - Companion campaign in the same issue (the CORNER axis half):
    `sim/mc-cp-mismatch/testbench/run.sh`
- **Timestamp / author**: 2026-09-27T08:19:41Z, agent-builder (issue #597)
- **Supersedes**: (none -- first record for this claim)
