2AMLogic/gf180-pll/sim/vco-tuning-range/records/20260923-084925-1655e11.md

# Record 20260923-084925-1655e11

- **Record ID**: 20260923-084925-1655e11
- **Claim**: #8 / design/README.md's "3-bit band-select mirror" -- band 0's
  OWN adjacent-band coverage-hole check (`sim/vco-tuning-range/records/20260804-164956-72883fb.md`'s
  band_overlap check, B0 -> B1 pair, worst overlap ratio 1.319 at
  `ss`/125C/3.63V), combined with the RANDOM device (Vth/beta) mismatch
  dispersion the band-select mirror cascade (`design/vco_bias.sch`) adds to
  band 0's frequency AT THAT EXACT (corner, Vctrl) point -- closing the
  open follow-on
  `sim/vco-tuning-range/records/20260817-143524-0e9cfc9.md`'s own "What
  this is NOT" paragraph named (issue #482). That record's mid-window
  (`typical`/27C/3.30V, Vctrl=1.8V) characterization of band 0 AND band 7
  stands unmodified as historical evidence (append-only); this record is
  additive, giving band 0 specifically the same-corner, same-Vctrl verdict
  the earlier record's own borrowed-headroom comparison could not.
- **Model-capability gate**: unchanged from every other Monte Carlo campaign
  in this repo -- see `sim/mc-cp-mismatch/records/20260731-212614-640560e.md`'s
  "Model-capability gate" for the full `agauss()`/parse-time-seed finding
  this campaign relies on (independent per-instance mismatch draws, gated by
  `sw_stat_mismatch`, reproducible via `.option rndseed=N`). Not
  re-derived here.
- **Netlist provenance**: committed export `design/netlist/vco.spice`
  (same DUT `sim/vco-tuning-range/records/20260817-143524-0e9cfc9.md` and
  the systematic `testbench/tb.json` sweep both compose, unmodified by this
  record), frozen into
  `sim/vco-tuning-range/netlist-snapshots/20260923-084925-1655e11-vco-band0-worst-corner.spice`,
  SHA-256 `3d8bf1b307d7b230808c86b318262822fdf525c2503724609bdf51d1b1cc2d31`. Testbench deck (`tb_vco_mismatch.sp`, unchanged
  from the sibling record) contains stimulus, measurement and the
  `sw_stat_mismatch`/`rndseed` overrides only.
- **Environment provenance**:
  - PDK: volare `gf180mcuD`, open_pdks `c6d73a35f524070e85faff4a6a9eef49553ebc2b`
  - Models: `libs.tech/ngspice/sm141064.ngspice` (MIM devices via
    `sm141064_mim.ngspice`, pulled in by the `mimcap_*` sections);
    `design.ngspice` included first via sim/lib/simenv.sh's simenv_run_deck; this campaign's own deck (tb_vco_mismatch.sp) then declares sw_stat_global=0 / sw_stat_mismatch=1, positioned after the design.ngspice include so the later declaration wins -- same harness-ordering finding sim/vco-tuning-range/records/20260817-143524-0e9cfc9.md documents in full
  - Simulator: ngspice-46. Schematic capture: N/A -- design/netlist/vco.spice is a committed export, this testbench includes it directly
  - Repo commit: `1655e11` (DIRTY tree)
  - Host: Linux 7.0.0-1010-aws / x86_64
- **Corner matrix run**: ONE targeted point, deliberately NOT nominal --
  `ss` (-> `.lib` sections `ss,res_typical,moscap_typical`) / 125 C / 3.63 V,
  Vctrl = 2.7 V. **Axes not swept**: every other corner, temperature,
  supply, and Vctrl point, plus all band codes other than 0, are fixed/omitted
  by design -- this record's entire job is a same-point re-check of ONE
  specific coverage-hole risk already identified elsewhere, not a
  characterization sweep. **Justification** (sim/README.md's "Default corner
  matrix" rule): this (corner, Vctrl) point is not chosen for convenience --
  it is the EXACT point
  `sim/vco-tuning-range/records/20260804-164956-72883fb.md`'s own
  band_overlap check used to compute the B0->B1 pair's worst overlap ratio
  (1.319, 31.9% headroom). Measuring anywhere else would reintroduce the
  uncombined, different-corner comparison this record exists to fix. See this
  file's header comment for the full raw_measures.csv cross-check confirming
  `ss`/125C/3.63V, Vctrl=2.7V, band0's f7 point (9122300 Hz) is the same
  point that record's f_max(band0) uses.
- **Methodology / criteria / limitations**:
  - Single VCO copy, band 0 only, at Vctrl = 2.7 V (the TOP of the
    0.9-2.7V control window -- f_max(band0), not the mid-window point
    `sim/vco-tuning-range/records/20260817-143524-0e9cfc9.md` used),
    `N_SAMPLES=100` single-instance invocations, one `.option
    rndseed` per sample. Measurement criterion identical to every other
    `sim/vco-tuning-range/` record: `f = 4/tp`, `tp` from the first to
    the fifth rising half-supply crossing of the buffered `CLK` output
    after `tsettle` (>= 4 estimated periods).
  - **Transient window**: sized off the SYSTEMATIC frequency at this exact
    point (9122300 Hz, from
    `sim/vco-tuning-range/corners/20260804-164956-72883fb/raw_measures.csv`,
    corner=ss/temp_c=125/vdd=3.63/band0, f7 column) with a +/-30% margin
    either side -- never trusted for a result, only for tstep/tstop sizing.
  - **Headroom is band 0's OWN pair, at its OWN worst corner -- not a
    borrowed figure.** `HEADROOM_PCT=31.88` is the fractional part
    of the B0->B1 pair's worst overlap ratio (1.319) from
    `sim/vco-tuning-range/corners/20260804-164956-72883fb/band_overlap.csv`,
    cross-checked directly against that record's own per-point
    `raw_measures.csv` (band0 f7 / band1 f1 at this exact corner = 1.3188,
    matching the cited 1.319) -- see this file's header comment for the full
    derivation. This replaces
    `sim/vco-tuning-range/records/20260817-143524-0e9cfc9.md`'s use of
    1.268 (26.8%), which was that record's own honestly-flagged proxy: the
    worst overlap ratio ACROSS ALL SEVEN adjacent-band pairs (which turns out
    to be the B3->B4 pair, at the same corner but not the same pair), not
    band 0's own pair.
  - **Same-corner, same-Vctrl, but still NOT a joint two-band Monte Carlo.**
    Band 1's own f_min is NOT re-measured with mismatch here -- this record
    compares band 0's mismatch-driven dispersion against band 1's UNCHANGED
    systematic (`sw_stat_mismatch=0`) reference floor (6917000 Hz, same
    source file/point, band1 f1). A fully joint check would need band 0 and
    band 1 to share ONE per-instance mismatch draw on their common always-on
    mirror legs (they are the same physical devices on one die across band
    codes) within a single simulation -- this script, like its predecessor,
    draws independently instead. This is a real, stated limitation of the
    Monte Carlo methodology this repo currently has, not a gap specific to
    this record.
  - **Proxy convention unchanged from the sibling record**: `|mean|+3sigma`
    as a percentage of the mean is a two-sided relative-dispersion figure
    compared against a one-sided fractional overlap margin -- an
    order-of-magnitude sanity flag, not a rigorous directional bound. See
    `sim/vco-tuning-range/records/20260817-143524-0e9cfc9.md`'s own caveat
    for the full statement; this record inherits it unchanged.
- **Statistical convention**: `sw_stat_global = 0`, `sw_stat_mismatch = 1`
  (mismatch-only, global process variation off, matching every other Monte
  Carlo campaign in this repo). `N_SAMPLES=100`, band 0 only.
  Seeds: sequential integers `1..N`, passed via `.option rndseed`; every
  seed's raw log is committed under `corners/20260923-084925-1655e11/`.
- **Result**:

  | Band | f mean | f sd | \|mean\|+3sigma as %% of mean | vs. 31.88% headroom (B0->B1 pair, its own worst corner) | n |
  |---|---|---|---|---|---|
  | 0 (at Vctrl=2.7V, `ss`/125C/3.63V -- its own f_max/overlap point) | 9.09683e+06 Hz | 751582 Hz | 24.79% | **under** | 100 |

  Reference (unchanged, systematic, `sw_stat_mismatch=0`, from
  `sim/vco-tuning-range/corners/20260804-164956-72883fb/raw_measures.csv`):
  f_max(band0) = 9122300 Hz at this exact point; f_min(band1) = 6917000 Hz at
  `ss`/125C/3.63V, Vctrl=0.9V -- ratio 1.3188, matching the cited 1.319.

  This is now a genuine same-corner, same-Vctrl combined check (not the
  earlier record's nominal-dispersion-vs-worst-pair-elsewhere comparison),
  subject to the two limitations named above (proxy convention;
  independent-draw, not joint, Monte Carlo). Read together with
  `sim/vco-tuning-range/records/20260817-143524-0e9cfc9.md`'s band 7 result
  (comfortably under headroom at its own mid-window nominal point, unaffected
  by this record), this closes the item-6 gap #482 filed for band 0's
  coverage-hole risk.
- **Links**:
  - Testbench: `sim/vco-tuning-range/testbench/tb_vco_mismatch.sp`,
    `run_band0_worst_corner.sh`
  - Design: `design/vco.sch`, `design/vco_bias.sch`, `design/vco_stage.sch`
  - Netlist snapshot:
    `sim/vco-tuning-range/netlist-snapshots/20260923-084925-1655e11-vco-band0-worst-corner.spice`
  - Raw logs: `sim/vco-tuning-range/corners/20260923-084925-1655e11/`
  - Extracted metrics: `sim/vco-tuning-range/corners/20260923-084925-1655e11/mismatch.csv`
  - Systematic sweep and overlap check this record's headroom is drawn from
    (unchanged, untouched): `sim/vco-tuning-range/testbench/tb.json`,
    `sim/vco-tuning-range/records/20260804-164956-72883fb.md`,
    `sim/vco-tuning-range/corners/20260804-164956-72883fb/band_overlap.csv`,
    `sim/vco-tuning-range/corners/20260804-164956-72883fb/raw_measures.csv`
  - Sibling Monte Carlo record this follows on from (mid-window
    characterization, band0 + band7, not superseded):
    `sim/vco-tuning-range/records/20260817-143524-0e9cfc9.md`
- **Timestamp / author**: 2026-09-23T08:49:40Z, agent-builder (issue #482)
- **Supersedes**: (none -- first record for this claim)
