2AMLogic/gf180-pll/sim/vco-tuning-range/records/20260817-143524-0e9cfc9.md

# Record 20260817-143524-0e9cfc9

- **Record ID**: 20260817-143524-0e9cfc9
- **Claim**: #8 / design/README.md's "3-bit band-select mirror" -- does
  RANDOM device (Vth/beta) mismatch in the band-select mirror cascade
  (`design/vco_bias.sch`'s three cascaded current mirrors, see
  design/README.md's "Band map: a geometric mirror cascade" section) shift
  the VCO's oscillation frequency enough to matter against the systematic
  f(Vctrl)/band-plan curve `testbench/tb.json`'s harness-driven sweep
  measures (`sw_stat_mismatch = 0` there -- an explicitly documented gap in
  every prior `sim/vco-tuning-range/` record's methodology field, closed by
  this record). This is the second half of #146 (the first half extends
  `sim/mc-cp-mismatch/` with a corner-combined Monte Carlo record).
  Spec-line references are placeholders pending ratification (#1):
  `spec/pll.md#output-band`, `spec/pll.md#kvco`.
- **Model-capability gate**: reuses the finding
  `sim/mc-cp-mismatch/records/20260731-212614-640560e.md` established and
  `sim/mc-cp-mismatch`'s #146 corner-grid extension re-confirmed at a
  non-nominal corner -- `nfet_03v3`/`pfet_03v3` (via the
  `nfet_03v3_dss`/`pfet_03v3_dss` subcircuits) carry independent
  per-instance `agauss()` mismatch draws gated by `sw_stat_mismatch`,
  parsed once at netlist PARSE time, reproducible via `.option rndseed=N`.
  Not re-derived here.
- **Why a raw `sim/lib/simenv.sh` deck, not a `testbench/tb.json` manifest
  edit**: see `run_mismatch.sh`'s header comment for the full finding --
  in short, `sim/harness/runner.py`'s `compose_deck()` emits a manifest's
  `params` BEFORE `.include design.ngspice`, so a tb.json
  `sw_stat_mismatch` override is silently nullified by design.ngspice's own
  later-in-deck default (confirmed by direct ngspice-46 experiment: last
  `.param` redefinition in deck order wins). The harness also has no Monte
  Carlo seed axis. `testbench/tb.json`'s own 45-corner harness sweep is
  UNCHANGED and UNTOUCHED by this record (still `sw_stat_mismatch = 0`,
  still the systematic claim) -- this record is additive, reusing
  `sim/mc-cp-mismatch`'s pre-harness pattern for the one thing the harness
  cannot yet do.
- **Netlist provenance**: committed export `design/netlist/vco.spice`
  (same DUT `testbench/tb_vco_tuning.spice` composes, unmodified by this
  record), frozen into
  `sim/vco-tuning-range/netlist-snapshots/20260817-143524-0e9cfc9-vco-mismatch.spice`,
  SHA-256 `3d8bf1b307d7b230808c86b318262822fdf525c2503724609bdf51d1b1cc2d31`. Testbench deck (`tb_vco_mismatch.sp`) contains
  stimulus, measurement and the `sw_stat_mismatch`/`rndseed` overrides
  only -- one VCO instance instead of `tb_vco_tuning.sp/.spice`'s seven, no
  other change to the DUT.
- **Environment provenance**:
  - PDK: volare `gf180mcuD`, open_pdks `c6d73a35f524070e85faff4a6a9eef49553ebc2b`
  - Models: `libs.tech/ngspice/sm141064.ngspice` (MIM devices via
    `sm141064_mim.ngspice`, pulled in by the `mimcap_*` sections);
    `design.ngspice` included first via sim/lib/simenv.sh's simenv_run_deck; this campaign's own deck (tb_vco_mismatch.sp) then declares sw_stat_global=0 / sw_stat_mismatch=1, positioned after the design.ngspice include specifically so the later declaration wins -- see this record's own note on the harness-ordering finding above; sw_stat_mismatch defaults to 0 in every OTHER sim/vco-tuning-range/ record, including this campaign's own harness-driven testbench/tb.json sweep, unaffected by this file
  - Simulator: ngspice-46. Schematic capture: N/A -- design/netlist/vco.spice is a committed export, this testbench includes it directly (same convention as tb_vco_tuning.sp/.spice's pre-harness sibling)
  - Repo commit: `0e9cfc9` (DIRTY tree)
  - Host: Linux 7.0.0-1010-aws / x86_64
- **Corner matrix run**: ONE nominal PVT point -- `typical` (-> `.lib`
  section `typical`) / 27 C / 3.30 V, Vctrl = 1.8 V (mid-window).
  **Axes not swept**: temperature, supply, MOS process corner, Vctrl (beyond
  the one mid-window point) and 6 of the 8 band codes are all fixed/omitted.
  **Justification** (sim/README.md's "Default corner matrix" rule): same
  reasoning as `sim/mc-cp-mismatch`'s original nominal-only record -- corner
  sensitivity of the MEAN f(Vctrl) curve is already `testbench/tb.json`'s
  45-corner harness sweep's job; this record's job is the DISPERSION random
  mismatch adds on top, and Pelgrom-mismatch dispersion is not expected to
  carry strong PVT dependence the way a systematic mechanism would. Band 0
  and band 7 are chosen as the two ends of the band-select mirror's cascade
  activation (band 0: only the three always-on legs; band 7: every switched
  leg active, the full three-mirror cascade) -- the intermediate 6 band codes
  and the rest of the Vctrl window are not sampled, a genuine limitation a
  future pass could widen.
- **Methodology / criteria / limitations**:
  - Single VCO copy (not `tb_vco_tuning.sp/.spice`'s seven), at Vctrl =
    1.8 V, band 0 or band 7, `N_SAMPLES=25` single-instance
    invocations per band (`50` total), one `.option
    rndseed` per sample. Measurement criterion identical to
    `tb_vco_tuning.sp/.spice`: `f = 4 / tp`, `tp` from the first to the
    fifth rising half-supply crossing of the buffered `CLK` output after
    `tsettle` (>= 4 estimated periods), so the bias generator's own
    start-up transient is excluded.
  - **Transient window**: sized off the SYSTEMATIC nominal frequency at each
    band (from
    `sim/vco-tuning-range/records/20260804-164956-72883fb.md`'s
    `raw_measures.csv`, `typical/27C/3.30V`, `Vctrl=1.8V`: band0
    6526290 Hz, band7 261947000 Hz) with a +/-30%
    margin either side -- never trusted for a result, only for
    `tstep`/`tstop` sizing; a missed `.meas` trigger would fail the
    sample rather than silently mis-measure it.
  - **No numeric budget exists for this term.** Unlike
    `sim/mc-cp-mismatch`'s charge-pump terms, design/README.md carries no
    "band-select mirror mismatch budget" table -- this record reports the
    measured dispersion as a characterization, not a pass/fail verdict, the
    same honest handling `mc-cp-mismatch` already uses for its
    divider-retiming-flop term (also not itself a budget-table line).
  - **Two band codes only, one Vctrl point.** A future, more complete pass
    would sweep the intermediate 6 band codes and more of the Vctrl window;
    this record characterizes the cascade's two activation extremes as an
    initial, honestly-scoped pass, matching this repo's evidence culture of
    a stated, narrower claim over a fabricated broad one.
  - Bias generation is NOT idealized here (unlike `sim/mc-cp-mismatch`'s
    charge-pump decks) -- the full `vco_bias` subcircuit, including its own
    mirror devices, is part of the DUT, so this record's dispersion already
    includes the bias generator's own mismatch contribution alongside the
    band-select mirror's.
- **Statistical convention**: `sw_stat_global = 0`, `sw_stat_mismatch = 1`
  (mismatch-only, global process variation off, matching every other Monte
  Carlo campaign in this repo). `N_SAMPLES=25` per band. Seeds:
  sequential integers `1..N` per band, passed via `.option rndseed`; every
  seed's raw log is committed under `corners/20260817-143524-0e9cfc9/`.
- **Result**:

  | Band | f mean | f sd | \|mean\|+3sigma as %% of mean | vs. 26.8% headroom (see below) | n |
  |---|---|---|---|---|---|
  | 0 (no switched leg) | 6.49648e+06 Hz | 840084 Hz | 38.79% | **OVER** | 25 |
  | 7 (full cascade) | 2.62123e+08 Hz | 1.3436e+07 Hz | 15.38% | **under** | 25 |

  Compare against `sim/vco-tuning-range/records/20260804-164956-72883fb.md`'s
  worst adjacent-overlap ratio (1.268, `ss/125C/3.63V`) -- the margin that
  ratio carries above 1.0 is the headroom this dispersion draws against
  before mismatch alone could open a coverage hole at a band edge, expressed
  here as 26.8% (the fractional part of the 1.268 ratio). **This
  is not a symmetric statement across both bands, and the two verdicts above
  are reported exactly as measured, not smoothed into one blanket
  conclusion.** Band 7 (full cascade, highest bias current) is comfortably
  UNDER headroom -- Pelgrom mismatch scales down with device current, so the
  highest-current band shows the tightest relative dispersion, as expected.
  Band 0 (only the always-on legs, the LOWEST bias current in the band plan)
  measures `|mean|+3sigma` OVER the 26.8% headroom figure: at this band's
  low bias current, per-instance Vth/beta mismatch is a much larger fraction
  of the drive, so its relative frequency dispersion is large enough that, in
  the worst case, random mismatch alone could plausibly erode band 0's
  adjacent-overlap margin against band 1 -- a genuine, not-yet-formally-closed
  finding, reported honestly rather than rounded down to a reassuring
  headline. **What this is NOT**: a formal combined verdict. The two source
  records' PVT points differ (this record is nominal-only `typical/27C/3.30V`;
  the 1.268 ratio is `ss/125C/3.63V`, a different corner entirely), band 0's
  own overlap ratio at its worst corner is not reproduced here, and
  `n=25/band` is far short of the statistical power a real
  budget-table verdict would need. A follow-on record combining this
  campaign's per-band Monte Carlo with the systematic sweep's own worst-corner
  band-0-specific overlap ratio (not the worst-pair-overall figure used here
  as an order-of-magnitude proxy) would be needed to turn "band 0's dispersion
  looks large enough to matter" into an actual pass/fail coverage-hole check.
- **Links**:
  - Testbench: `sim/vco-tuning-range/testbench/tb_vco_mismatch.sp`,
    `run_mismatch.sh`
  - Design: `design/vco.sch`, `design/vco_bias.sch`, `design/vco_stage.sch`
  - Netlist snapshot:
    `sim/vco-tuning-range/netlist-snapshots/20260817-143524-0e9cfc9-vco-mismatch.spice`
  - Raw logs: `sim/vco-tuning-range/corners/20260817-143524-0e9cfc9/`
  - Extracted metrics: `sim/vco-tuning-range/corners/20260817-143524-0e9cfc9/mismatch.csv`
  - Systematic sweep this record adds dispersion on top of (unchanged,
    untouched): `sim/vco-tuning-range/testbench/tb.json`,
    `sim/vco-tuning-range/records/20260804-164956-72883fb.md`
  - Sibling Monte Carlo methodology (parse-time-seed finding, corner-combined
    precedent): `sim/mc-cp-mismatch/`
- **Timestamp / author**: 2026-08-17T14:35:24Z, agent-builder (issue #146)
- **Supersedes**: (none -- first record for this claim)
