2AMLogic/gf180-pll/sim/vco-tuning-range/records/20260804-211600-f599a65.md

# Record 20260804-211600-f599a65

- **Record ID**: 20260804-211600-f599a65
- **Claim**: #8 (design-input claim feeding two spec lines) -- how much does `vdd_vco` move the ring VCO's frequency, statically and in a transient, and what timing error does a realistic supply disturbance therefore inject? DR-001's Consequences section names this the accepted risk of the current-starved single-ended ring and states the requirement in terms this record answers: "#8 must produce a supply-step/supply-noise jitter testbench, not just a clean-supply Kvco sweep. This is the number most likely to force a supersede." Feeds #14's supply-sensitivity budget and #13's jitter budget. Spec-line references are placeholders pending ratification (#1): `spec/pll.md#supply-sensitivity`, `spec/pll.md#period-jitter`.
- **Netlist provenance**: schematic export(s) `design/netlist/vco.spice` (SHA-256 `3d8bf1b307d7b230808c86b318262822fdf525c2503724609bdf51d1b1cc2d31`) composed with 2 stimulus decks, one record: `push` — `sim/vco-tuning-range/testbench-supply/tb_vco_pushing.spice` (SHA-256 `eae2b3ba3744dddb24222980b23ce746a81c6b26933415dcb00261f9ab7c378d`); `jit` — `sim/vco-tuning-range/testbench-supply/tb_vco_supply_jitter.spice` (SHA-256 `0b8295b1663d8aa59cbb8c020b10014e42d7fdd2e1ac5e073343ae0e22f499c2`); composed SHA-256 `281fef668642181ab724b0c862ac98420298bd4f0b3d78076c2d6aa82a19b586` — this is what the netlist snapshot holds
- **Environment provenance**:
  - PDK: volare `gf180mcuD`, open_pdks `c6d73a35f524070e85faff4a6a9eef49553ebc2b` (/home/ubuntu/.volare/gf180mcuD, found via search_root:~/.volare)
  - Models: `libs.tech/ngspice/sm141064.ngspice`; `design.ngspice` included first
  - Simulator: ngspice-46 : Circuit level simulation program. Harness: sim/harness 0.1.0, python 3.12.3
  - Repo commit: `f599a65654b55c73347488758c1156a104569bd3` (clean tree)
  - Host: Linux-7.0.0-1009-aws-x86_64-with-glibc2.39 (ip-172-31-74-176)
- **Corner matrix run**:
  - Process (bundle -> `.lib` sections): `typical` -> typical res_typical moscap_typical mimcap_typical; `ff` -> ff res_typical moscap_typical mimcap_typical; `ss` -> ss res_typical moscap_typical mimcap_typical; `fs` -> fs res_typical moscap_typical mimcap_typical; `sf` -> sf res_typical moscap_typical mimcap_typical; `all-slow` -> ss res_ss moscap_ss mimcap_ss; `all-fast` -> ff res_ff moscap_ff mimcap_ff
  - Temperature: -40 °C, 27 °C, 125 °C
  - Supply: 2.97 V, 3.30 V, 3.63 V
  - 144 point grid (process x temperature x supply x band x rdiv x fcal), 144 completed
  - Full PVT matrix per CLAUDE.md / sim/README.md (-40/27/125 °C, ±10% supply, the five MOS process bundles).
  - Extra swept variables (beyond process x temperature x supply):
    - `band` — 3-bit static band-select code (B2 B1 B0): `band0`, `band4`, `band7`, `band5`, `band1`, `band2`, `band3`, `band6`
    - `rdiv` — supply-ripple frequency as a divisor of the estimated f_osc; w_ncyc is the measurement window in VCO cycles, always >= 64 and >= 4 whole ripple periods: `r16`, `r4`, `r32`
    - `fcal` — process factor of the in-deck FREQUENCY ESTIMATE (window sizing, and the f_osc/N ripple frequency) -- a calibration constant of the estimator, paired with the corner bundles it calibrates by the grid blocks below. It selects no model section and enters no result.: `f100`, `f080`, `f125`
    - **Deliberately non-rectangular**: 144 points run of the 4536 a full cross-product of the axes above would be. The slices actually covered, and why:
      - static-pushing grid, the five MOS-only bundles: band codes B0/B4/B7 bracket the geometric band map at every temperature. The pushing deck sweeps its seven supply points internally, so this block runs at the nominal PVT supply only -- the supply axis of the pushing claim is inside the deck, not on the grid. The jitter deck runs here too (it runs at every point of the shared grid) and contributes the band dependence of supply-induced jitter at all seven bundles. — 45 point(s)
      - static-pushing grid, all-slow: band codes B0/B4/B7 bracket the geometric band map at every temperature. The pushing deck sweeps its seven supply points internally, so this block runs at the nominal PVT supply only -- the supply axis of the pushing claim is inside the deck, not on the grid. The jitter deck runs here too (it runs at every point of the shared grid) and contributes the band dependence of supply-induced jitter at all seven bundles. — 9 point(s)
      - static-pushing grid, all-fast: band codes B0/B4/B7 bracket the geometric band map at every temperature. The pushing deck sweeps its seven supply points internally, so this block runs at the nominal PVT supply only -- the supply axis of the pushing claim is inside the deck, not on the grid. The jitter deck runs here too (it runs at every point of the shared grid) and contributes the band dependence of supply-induced jitter at all seven bundles. — 9 point(s)
      - transient grid, the five MOS-only bundles: the full mandated PVT matrix (3 temperatures x 3 supplies) at band 5, Vctrl 1.8 V -- the ~100 MHz class the draft jitter line is quoted at -- with ripple at f_osc/16. This is the block that carries the record's mandated corner coverage. — 45 point(s)
      - transient grid, all-slow: the full mandated PVT matrix (3 temperatures x 3 supplies) at band 5, Vctrl 1.8 V -- the ~100 MHz class the draft jitter line is quoted at -- with ripple at f_osc/16. This is the block that carries the record's mandated corner coverage. — 9 point(s)
      - transient grid, all-fast: the full mandated PVT matrix (3 temperatures x 3 supplies) at band 5, Vctrl 1.8 V -- the ~100 MHz class the draft jitter line is quoted at -- with ripple at f_osc/16. This is the block that carries the record's mandated corner coverage. — 9 point(s)
      - band sweep, typical: all eight band codes at the nominal temperature and supply, so the band dependence of supply-induced jitter is measured over the whole 40:1 output range rather than inferred from band 5. Three bundles (typical / all-slow / all-fast) bracket the process spread; the full-PVT block above carries the rest. — 4 point(s)
      - band sweep, all-slow: all eight band codes at the nominal temperature and supply, so the band dependence of supply-induced jitter is measured over the whole 40:1 output range rather than inferred from band 5. Three bundles (typical / all-slow / all-fast) bracket the process spread; the full-PVT block above carries the rest. — 4 point(s)
      - band sweep, all-fast: all eight band codes at the nominal temperature and supply, so the band dependence of supply-induced jitter is measured over the whole 40:1 output range rather than inferred from band 5. Three bundles (typical / all-slow / all-fast) bracket the process spread; the full-PVT block above carries the rest. — 4 point(s)
      - ripple-frequency check, typical: the same band-5 point at f_osc/4 and f_osc/32 as well as the f_osc/16 above, so the measured TIE can be tested against the quasi-static 1/f_ripple model instead of the model being assumed. Three bundles at the nominal temperature and supply. — 2 point(s)
      - ripple-frequency check, all-slow: the same band-5 point at f_osc/4 and f_osc/32 as well as the f_osc/16 above, so the measured TIE can be tested against the quasi-static 1/f_ripple model instead of the model being assumed. Three bundles at the nominal temperature and supply. — 2 point(s)
      - ripple-frequency check, all-fast: the same band-5 point at f_osc/4 and f_osc/32 as well as the f_osc/16 above, so the measured TIE can be tested against the quasi-static 1/f_ripple model instead of the model being assumed. Three bundles at the nominal temperature and supply. — 2 point(s)
- **Methodology / criteria / limitations**:
  - **Two decks, one record.** The claim is a pair: a *static* pushing deck (`tb_vco_pushing.spice`, seven VCO copies at seven supplies) and a *transient* deck (`tb_vco_supply_jitter.spice`, a quiet / stepped / rippled copy). The jitter numbers are not interpretable without the pushing numbers -- the quasi-static model that says whether they project to other ripple frequencies is written in terms of the pushing coefficient -- so they are one record, minted through the harness's `phases` key. Every PVT point of the shared grid runs both decks; each deck's log is `<phase>_<corner-id>.log`.
  - **Static pushing measurement criterion**: seven independent VCO copies, one per supply point (2.97 .. 3.63 V in 0.11 V steps), in a single transient. Each copy carries its own supply source, its own ammeter and its own band-code sources **referenced to that copy's rail** -- a shared logic-level band code would leave the band-select pass gates of the higher-rail copies partly on and corrupt the measurement. Frequency is taken at each copy's buffered `CLK` over four whole cycles after a settle window of >= 4 estimated periods. The per-corner pushing coefficient is a least-squares fit of f against vdd over those seven points, and `push_nl_pct` is the largest departure of the measured curve from its own straight line, as a percentage of the nominal-supply frequency -- so the record states how good the single-coefficient summary is rather than assuming it.
  - **Transient measurement criterion**: three VCO copies per run, identical except for their supply drive -- quiet (dc), stepped (0.1 V step, 1 ns edge, at the window midpoint) and rippled (0.05 V amplitude sine). Every reported number comes from **interpolated half-supply crossings of the buffered output**, extracted by `derive_supply.py` from the deck's own `jit.dat` waveform, not from `.measure`: jitter is a property of the period *sequence* and `.measure` reports scalars. The window always holds four whole ripple periods and at least 64 cycles, so a peak-to-peak TIE is a real peak-to-peak.
  - **The quiet copy is the noise floor, not a result.** Any period variation it shows is the transient solver's own local truncation error at these settings (`reltol = 1e-4`, max timestep 1/(200 f_osc)). The record reports the stepped and rippled numbers **against** that floor: `floor_margin_x` is the rippled TIE RMS divided by that point's own quiet TIE RMS, and it is a checked quantity, so a record in which any supply-induced number is not comfortably above the floor fails rather than quoting it.
  - **Quasi-static model, and why it is checked**: a ring VCO's supply response is flat well beyond any supply-noise frequency of interest, so f(t) = f0 + K_vdd*v_ripple(t) predicts TIE_pp = K*A/(pi*f_rip*f0) and period modulation 2*T0*K*A/f0. Both predictions are computed from the *measured transient* K_vdd and compared with the measured jitter at three ripple frequencies (f_osc/4, /16, /32). Agreement is what licenses projecting these numbers to ripple frequencies that were not simulated; disagreement means they cannot be projected, and the record says so instead.
  - **The window estimator, and why it is also the stimulus.** Both decks size their transient window in-deck from a calibrated frequency estimate (see the fragment headers). For the pushing deck that is a pure runtime knob -- an estimate wrong enough to lose a rising edge makes the `.measure` fail and the point is reported failed, never silently mis-measured. For the jitter deck it is more than that: the ripple frequency is *specified* as f_osc/N, so the estimate sets the stimulus. That is why the estimator's process term reaches the deck as the `fcal` sweep axis, whose grid blocks pair each factor with the corner bundles it calibrates: a ripple defined relative to f_osc cannot be corner-blind. `fcal` is a calibration constant of the estimator, not a model corner -- the `.lib` sections are the harness's, as always. The estimator is preserved term-for-term from the pre-migration bash runner (`testbench/common.sh :: f_est`) so that this record re-runs the *same* experiment as the record it supersedes rather than a similar one.
  - **Migration self-check.** This campaign replaces `testbench/run_supply.sh`, which minted record `20260731-184845-0a12e6c` through the `sim/lib/simenv.sh` shim. The `migration_delta` derived table joins that record's own committed CSVs and reports, per quantity, the median and worst relative deviation of the migrated numbers from it over the points the two grids share. A migration whose numbers moved is a finding, not a footnote, so it is computed into the record rather than asserted in a commit message.
  - **Limitations**:
  -   - **Open loop.** No PLL is closed around this VCO here, so nothing corrects the supply-induced frequency error. The reported TIE is therefore an upper bound for supply disturbances *inside* the (not yet designed) loop bandwidth and approximately correct for disturbances above it. The closed-loop number is #12/#13's, and it cannot be produced before #9/#10 fix the loop bandwidth.
  -   - **Deterministic disturbances only.** This record injects a step and a sinusoid. It is not a random-noise (phase-noise) simulation and reports no random jitter number; `sim/README.md`'s worked example and #13 both flag ngspice transient noise as a separate, harder question.
  -   - **Schematic level.** No supply-network parasitics: the rail is driven by an ideal source through the on-chip decap only. Real bond-wire and on-die rail impedance will make the *disturbance* larger for a given external event; this record characterizes the VCO's sensitivity to a rail disturbance, not the disturbance itself. Layout extraction (#18) will also move every absolute frequency here downward.
  -   - **One control voltage.** Both decks run at Vctrl = 1.8 V, the middle of the 0.9-2.7 V window. The Vctrl dependence of f_osc is the tuning-range record's claim, not this one's.
  -   - Statistical switches: `sw_stat_global = sw_stat_mismatch = 0` (nominal per-corner skew, no Monte Carlo mismatch).
- **Statistical convention**: N/A (corner-matrix claim, not a distribution claim)
- **Result**:

  **supply_pushing_summary** (derived) — static supply pushing, per band code (deck tb_vco_pushing.spice)

  Local slope of f_osc against vdd_vco, least-squares over the seven supply points spanning 2.97-3.63 V, at every (bundle, temperature, band) combination -- 96 curves of 7 points each.
  Worst (most supply-sensitive) point: **-54.5 %/V** (-44.91 MHz/V at 82.34 MHz) at ss/-40C, band 5, Vctrl 1.8 V.
  Best: **-24.1 %/V** at ff/-40C, band 0.
  Curvature: the largest departure of any measured f(vdd) curve from its own straight-line fit is 3.41 % of f_nom, so pushing is effectively linear across the whole +/-10 % rail and a single coefficient per corner is a fair summary.
  **Where the sensitivity comes from, and why it is not a sizing error.** A current-starved ring runs at f ~ I_stage / (N * C_stage * V_swing), and V_swing *is* the supply. Even with a perfectly supply-independent starving current, f therefore carries a -1/vdd term = **-30.3 %/V** at 3.3 V. The measured median of -40.5 %/V is 1.34x that floor, i.e. the bias generator contributes only the remainder. Reducing supply pushing materially would require a regulated VCO rail or a swing-independent cell (a differential delay cell with replica-biased load), i.e. exactly the alternatives DR-001 Decision 2 considered and rejected on power and cell-count grounds -- not a resizing of this cell.

  | band | curves | most_negative_pct_per_v | most_negative_at | median_pct_per_v | least_negative_pct_per_v | least_negative_at | worst_shift_over_pm10pct_rail_pct |
  |---|---|---|---|---|---|---|---|
  | B0 | 21 | -35.4 | ss/-40C | -29.1 | -24.1 | ff/-40C | 12 |
  | B1 | 3 | -36.7 | all-slow/27C | -32.0 | -29.2 | all-fast/27C | 12 |
  | B2 | 3 | -39.7 | all-slow/27C | -34.7 | -31.2 | all-fast/27C | 13 |
  | B3 | 3 | -44.6 | all-slow/27C | -38.6 | -35.0 | all-fast/27C | 15 |
  | B4 | 21 | -50.8 | ss/-40C | -41.3 | -33.6 | ff/-40C | 17 |
  | B5 | 21 | -54.5 | ss/-40C | -46.0 | -37.9 | ff/-40C | 18 |
  | B6 | 3 | -51.9 | all-slow/27C | -48.8 | -44.9 | all-fast/27C | 17 |
  | B7 | 21 | -50.1 | sf/-40C | -44.6 | -32.7 | ss/125C | 17 |

  Full table: `supply_pushing_summary.csv`, alongside this record's raw logs.

  **supply_step_response** (derived) — response to a 0.1 V supply step with a 1 ns edge, over the 63-point mandated PVT grid (band 5, Vctrl 1.8 V ~ 100 MHz class)

  The last column is the number a loop-bandwidth budget has to beat: with the loop open, a supply step of this size walks the VCO's output edge by that much timing error for every microsecond the loop takes to correct it. It is *not* a jitter spec violation on its own -- inside the loop bandwidth the PLL cancels it -- but it is the reason #10 cannot choose an arbitrarily low loop bandwidth, and it is a direct input to #14's supply-sensitivity budget.

  | case | corner | df_mhz | df_over_f_pct | transient_pushing_mhz_per_v | open_loop_timing_error_per_us_ns |
  |---|---|---|---|---|---|
  | worst | all-slow/-40C/2.97V | -4.77 | -6.08 | -47.7 | -60.8 |
  | median | fs/125C/3.30V | -4.06 | -4.16 | -40.6 | -41.6 |
  | best | ff/-40C/3.63V | -1.68 | -2.57 | -16.8 | -25.7 |

  Full table: `supply_step_response.csv`, alongside this record's raw logs.

  **supply_ripple_jitter** (derived) — sinusoidal ripple of 0.05 V amplitude (100 mV peak-to-peak, 3.0 % of the nominal rail) at f_osc/16, over the 63-point mandated PVT grid

  The smallest margin between a rippled result and its own run's quiet reference anywhere on the grid is **135x** in TIE RMS (at sf/125C/3.30V), so every supply-induced number above is a circuit result, not solver noise.
  Worst case as a fraction of the period: **2.51 % RMS period jitter** and 7.14 % peak-to-peak, at all-slow/-40C/2.97V, f_osc = 78.52 MHz.
  The draft spec line is < 1 % RMS period jitter, so **a 100 mV peak-to-peak ripple on an unregulated VCO rail is on its own sufficient to break that line** open-loop.

  | case | corner | period_jitter_pp | period_jitter_rms | tie_pp | tie_rms |
  |---|---|---|---|---|---|
  | rippled, worst | all-slow/-40C/2.97V | 910 ps | 320 ps | 3.37 ns | 1.02 ns |
  | rippled, median | ff/-40C/3.63V | 540 ps | 191 ps | 1.69 ns | 516 ps |
  | rippled, best | all-fast/125C/3.63V | 349 ps | 123 ps | 829 ps | 259 ps |
  | **quiet reference, worst** (numerical floor) | sf/125C/3.30V | 2.68 ps | 0.611 ps | 9.5 ps | 2.78 ps |

  Full table: `supply_ripple_jitter.csv`, alongside this record's raw logs.

  **ripple_band_dependence** (derived) — the same ripple at every band code -- jitter *as a fraction of the period* is the comparable quantity across a 40:1 frequency range

  | band | points | f_osc_min_mhz | f_osc_max_mhz | worst_tie_pp | worst_period_jitter_rms_pct_of_period | worst_at |
  |---|---|---|---|---|---|---|
  | B0 | 7 | 5.344 | 8.577 | 16.2 ns | 1.18 | all-slow/27C/3.30V |
  | B1 | 3 | 8.691 | 13.83 | 10.5 ns | 1.31 | all-slow/27C/3.30V |
  | B2 | 3 | 14.63 | 23.15 | 7.11 ns | 1.42 | all-slow/27C/3.30V |
  | B3 | 3 | 24.18 | 37.92 | 4.83 ns | 1.59 | all-slow/27C/3.30V |
  | B4 | 7 | 41.79 | 65.34 | 3.63 ns | 1.94 | all-slow/27C/3.30V |
  | B5 | 7 | 70.89 | 110 | 2.38 ns | 2.12 | all-slow/27C/3.30V |
  | B6 | 3 | 126.1 | 196.2 | 1.68 ns | 2.46 | all-slow/27C/3.30V |
  | B7 | 7 | 217.1 | 343.9 | 924 ps | 2.33 | all-slow/27C/3.30V |

  Full table: `ripple_band_dependence.csv`, alongside this record's raw logs.

  **ripple_frequency_check** (derived) — does the quasi-static model reproduce the measurement, i.e. may these numbers be projected to ripple frequencies that were not simulated?

  Each row is averaged over the 3 bundle(s) that ran at every ripple frequency (all-fast, all-slow, typical), at 27 C and the nominal supply, so the ripple frequency is the only variable between rows.
  Across all 144 rippled runs the measured/predicted ratio spans 1.22 .. 2.29 (median 1.46).
  TIE scales as 1/f_ripple as the model predicts -- the *shape* is right -- but the magnitude is consistently off by that factor, so the step-derived coefficient is **not** a safe basis for projecting ripple jitter: a ring's response to a bidirectional ripple is larger than its response to a unidirectional step of the same peak-to-peak size, because f ~ 1/vdd is convex. Ripple jitter at a ripple frequency that matters must be **measured**, not extrapolated. The measured numbers stand on their own; only the extrapolation is withheld.

  | ripple_frequency | points | f_ripple_mhz | tie_pp_measured | tie_pp_predicted_from_step | measured_over_predicted |
  |---|---|---|---|---|---|
  | f_osc/4 | 3 | 23.5 | 673 ps | 303 ps | 2.22 |
  | f_osc/16 | 3 | 5.86 | 1.76 ns | 1.21 ns | 1.45 |
  | f_osc/32 | 3 | 2.93 | 2.99 ns | 2.44 ns | 1.23 |

  Full table: `ripple_frequency_check.csv`, alongside this record's raw logs.

  **periods_nominal** (derived) — per-cycle period and TIE sequence at the nominal point -- `typical_27c_3.30v_band5_r16_f100`

  One row per measured cycle of each of the three copies. The quiet column is the transient solver's own numerical floor at these settings; the ripple column is the signal.

  | cycle | quiet_t_s | quiet_period_s | quiet_tie_s | step_t_s | step_period_s | step_tie_s | ripple_t_s | ripple_period_s | ripple_tie_s |
  |---|---|---|---|---|---|---|---|---|---|
  | 0 | 7.139728962e-08 | 1.18369e-08 | -6.71816e-14 | 7.139728961e-08 | 1.18369e-08 | 3.16525e-09 | 7.208044842e-08 | 1.21413e-08 | -9.74654e-11 |
  | 1 | 8.323422318e-08 | 1.18369e-08 | 6.31966e-14 | 8.323422317e-08 | 1.18369e-08 | 2.94801e-09 | 8.42217616e-08 | 1.20706e-08 | 2.16264e-10 |
  | 2 | 9.507110656e-08 | 1.18373e-08 | 1.43384e-13 | 9.507110655e-08 | 1.18373e-08 | 2.73072e-09 | 9.629235311e-08 | 1.19532e-08 | 4.59272e-10 |
  | 3 | 1.069083696e-07 | 1.18369e-08 | 6.03272e-13 | 1.069083696e-07 | 1.18369e-08 | 2.51382e-09 | 1.082455636e-07 | 1.18172e-08 | 5.84898e-10 |
  | 4 | 1.1874526e-07 | 1.18366e-08 | 6.90465e-13 | 1.1874526e-07 | 1.18366e-08 | 2.29654e-09 | 1.200627707e-07 | 1.16855e-08 | 5.74522e-10 |
  | 5 | 1.30581817e-07 | 1.18374e-08 | 4.44296e-13 | 1.30581817e-07 | 1.18374e-08 | 2.07892e-09 | 1.317482314e-07 | 1.1584e-08 | 4.32398e-10 |
  | 6 | 1.424192289e-07 | 1.18365e-08 | 1.05295e-12 | 1.424192289e-07 | 1.18365e-08 | 1.86216e-09 | 1.43332268e-07 | 1.15275e-08 | 1.88851e-10 |
  | 7 | 1.542557069e-07 | 1.18364e-08 | 7.27834e-13 | 1.542557069e-07 | 1.18364e-08 | 1.64447e-09 | 1.548597959e-07 | 1.15264e-08 | -1.11205e-10 |
  | 8 | 1.660920944e-07 | 1.18365e-08 | 3.12063e-13 | 1.660920943e-07 | 1.18365e-08 | 1.42668e-09 | 1.663861698e-07 | 1.15768e-08 | -4.12415e-10 |
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
  | 37 | 5.093579012e-07 | 1.1837e-08 | -1.17347e-12 | 5.123841133e-07 | 1.23594e-08 | -1.85227e-09 | 5.096524472e-07 | 1.1556e-08 | -1.46069e-10 |
  | 38 | 5.211949251e-07 | 1.18374e-08 | -9.52792e-13 | 5.24743499e-07 | 1.23604e-08 | -1.54706e-09 | 5.212084441e-07 | 1.16384e-08 | -4.17655e-10 |
  | 39 | 5.330322963e-07 | 1.18367e-08 | -3.84825e-13 | 5.371038938e-07 | 1.23597e-08 | -1.24084e-09 | 5.328468737e-07 | 1.17571e-08 | -6.0681e-10 |
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

  Full table: `periods_nominal.csv`, alongside this record's raw logs.

  **periods_worst_ripple** (derived) — per-cycle period and TIE sequence at the worst-TIE point -- `all-slow_-40c_3.30v_band0_r16_f080`

  One row per measured cycle of each of the three copies. The quiet column is the transient solver's own numerical floor at these settings; the ripple column is the signal.
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
