2AMLogic/gf180-pll/sim/vco-tuning-range/records/20260804-162735-72883fb.md

# Record 20260804-162735-72883fb

- **Record ID**: 20260804-162735-72883fb
- **Claim**: #8 (design-input claim, and a pass/fail against two proposed spec lines) -- does the 5-stage current-starved ring VCO of `design/vco.sch` cover the ratified v1 output band of 10-200 MHz (DR-002 Decision 2) at every PVT corner, with adjacent-band overlap and no coverage hole, and with Kvco inside the ceiling DR-001 Decision 1's fixed loop filter assumes? Two of the checks below are binding on sibling issues: the **low-band floor** is DR-002 Decision 2's documented trigger for whether an output divider enters v1 scope (#11), and the **Kvco table** is the input #9/#10 size the charge pump and loop filter against. Spec-line references are placeholders pending ratification (#1): `spec/pll.md#output-band`, `spec/pll.md#kvco`.
- **Netlist provenance**: schematic export(s) `design/netlist/vco.spice` (SHA-256 `3d8bf1b307d7b230808c86b318262822fdf525c2503724609bdf51d1b1cc2d31`) composed with stimulus `sim/vco-tuning-range/testbench/tb_vco_tuning.spice` (SHA-256 `fab73ac36d339b9ae02c3f3172ecca46432179720a57fbd544e7e51a426b6892`); composed SHA-256 `75f6fbf7b344c738b29c3189e338740dd23c7ab47f5a40bafa1e68674202ffd0` — this is what the netlist snapshot holds
- **Environment provenance**:
  - PDK: volare `gf180mcuD`, open_pdks `c6d73a35f524070e85faff4a6a9eef49553ebc2b` (/Users/rwalters/.volare/gf180mcuD, found via search_root:~/.volare)
  - Models: `libs.tech/ngspice/sm141064.ngspice`; `design.ngspice` included first
  - Simulator: ngspice-46 : Circuit level simulation program. Harness: sim/harness 0.1.0, python 3.14.6
  - Repo commit: `72883fb759c0ab3f25ebdb3da62afa37e831fd38` (clean tree)
  - Host: macOS-26.6-arm64-arm-64bit-Mach-O (robb-studio)
- **Corner matrix run**:
  - Process (bundle -> `.lib` sections): `typical` -> typical res_typical moscap_typical mimcap_typical; `ff` -> ff res_typical moscap_typical mimcap_typical; `ss` -> ss res_typical moscap_typical mimcap_typical; `fs` -> fs res_typical moscap_typical mimcap_typical; `sf` -> sf res_typical moscap_typical mimcap_typical; `all-slow` -> ss res_ss moscap_ss mimcap_ss; `all-fast` -> ff res_ff moscap_ff mimcap_ff
  - Temperature: -40 °C, 27 °C, 125 °C
  - Supply: 2.97 V, 3.30 V, 3.63 V
  - 504 point grid (process x temperature x supply x band), 504 completed
  - Full PVT matrix per CLAUDE.md / sim/README.md (-40/27/125 °C, ±10% supply, the five MOS process bundles).
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
