2AMLogic/gf180-pll/design/netlist/pll_top.spice

* gf180-pll :: pll_top -- generated by design/netlist.sh from pll_top.sch
* xschem XSCHEM V3.4.7; do not edit by hand.
** sch_path: design/pll_top.sch
.subckt pll_top REF B0 B1 B2 CPB0 CPB1 LDT0 LDT1 LDT2 LDT3 P0 P1 P2 P3 P4 P5 SEL0 SEL1 SEL2 SEL3 SEL4 SEL5 IBN ICN IBP ICP CLK
+ DIVOUT FB LOCK VCTRL VDD VDD_VCO GND_VCO VDD_DIV VSS
*.ipin REF
*.ipin B0
*.ipin B1
*.ipin B2
*.ipin CPB0
*.ipin CPB1
*.ipin LDT0
*.ipin LDT1
*.ipin LDT2
*.ipin LDT3
*.ipin P0
*.ipin P1
*.ipin P2
*.ipin P3
*.ipin P4
*.ipin P5
*.ipin SEL0
*.ipin SEL1
*.ipin SEL2
*.ipin SEL3
*.ipin SEL4
*.ipin SEL5
*.ipin IBN
*.ipin ICN
*.ipin IBP
*.ipin ICP
*.opin CLK
*.opin DIVOUT
*.opin FB
*.opin LOCK
*.iopin VCTRL
*.iopin VDD
*.iopin VDD_VCO
*.iopin GND_VCO
*.iopin VDD_DIV
*.iopin VSS
XPFD REF FB CPB0 CPB1 IBN ICN IBP ICP VCTRL UP DN VDD VSS pfd_cp
XLF VCTRL VSS loop_filter
XVCO VCTRL B0 B1 B2 CLK VDD_VCO GND_VCO vco
XDIV CLK P0 P1 P2 P3 P4 P5 SEL0 SEL1 SEL2 SEL3 SEL4 SEL5 DIVOUT FB VDD_DIV VSS divider_chain
XLD UP DN LOCK VWIN LDT0 LDT1 LDT2 LDT3 VDD VSS lock_detector
.ends

* expanding   symbol:  pfd_cp.sym # of pins=13
** sym_path: design/pfd_cp.sym
** sch_path: design/pfd_cp.sch
.subckt pfd_cp REF FB B0 B1 IBN ICN IBP ICP VOUT UP DN VDD VSS
*.ipin REF
*.ipin FB
*.ipin B0
*.ipin B1
*.iopin IBN
*.iopin ICN
*.iopin IBP
*.iopin ICP
*.iopin VOUT
*.opin UP
*.opin DN
*.iopin VDD
*.iopin VSS
xpfd REF FB UP DN VDD VSS pfd
xcp UP DN B0 B1 IBN ICN IBP ICP VOUT VDD VSS cp
.ends


* expanding   symbol:  loop_filter.sym # of pins=2
** sym_path: design/loop_filter.sym
** sch_path: design/loop_filter.sch
.subckt loop_filter VCTRL VSS
*.iopin VCTRL
*.iopin VSS
XRF1 NR1 VCTRL VSS ppolyf_u r_width=2u r_length=107u m=1
XRF2 NR2 NR1 VSS ppolyf_u r_width=2u r_length=107u m=1
XRF3 NR3 NR2 VSS ppolyf_u r_width=2u r_length=107u m=1
XRF4 NZ NR3 VSS ppolyf_u r_width=2u r_length=107u m=1
XCF1 NZ VSS cap_nmos_03v3_b c_width=87u c_length=87u m=1
XCF2 NZ VSS cap_nmos_03v3_b c_width=87u c_length=87u m=1
XCF3 NZ VSS cap_nmos_03v3_b c_width=87u c_length=87u m=1
XCF4 NZ VSS cap_nmos_03v3_b c_width=87u c_length=87u m=1
XCF5 VCTRL VSS cap_mim_2f0_m2m3_noshield c_width=31.4u c_length=31.4u m=1
.ends


* expanding   symbol:  vco.sym # of pins=7
** sym_path: design/vco.sym
** sch_path: design/vco.sch
.subckt vco VCTRL B0 B1 B2 CLK VDD_VCO GND_VCO
*.ipin VCTRL
*.ipin B0
*.ipin B1
*.ipin B2
*.opin CLK
*.iopin VDD_VCO
*.iopin GND_VCO
XBIAS VCTRL B0 B1 B2 VBP VBN VDD_VCO GND_VCO vco_bias
XS1 Y5 Y1 VDD_VCO GND_VCO VBP VBN vco_stage
XS2 Y1 Y2 VDD_VCO GND_VCO VBP VBN vco_stage
XS3 Y2 Y3 VDD_VCO GND_VCO VBP VBN vco_stage
XS4 Y3 Y4 VDD_VCO GND_VCO VBP VBN vco_stage
XS5 Y4 Y5 VDD_VCO GND_VCO VBP VBN vco_stage
XMBP1 NB1 Y5 VDD_VCO VDD_VCO pfet_03v3 L=0.28u W=1.25u nf=1 ad='int((nf+1)/2) * W/nf * 0.18u' as='int((nf+2)/2) * W/nf * 0.18u' pd='2*int((nf+1)/2) * (W/nf + 0.18u)'
+ ps='2*int((nf+2)/2) * (W/nf + 0.18u)' nrd='0.18u / W' nrs='0.18u / W' sa=0 sb=0 sd=0 m=1
XMBN1 NB1 Y5 GND_VCO GND_VCO nfet_03v3 L=0.28u W=0.5u nf=1 ad='int((nf+1)/2) * W/nf * 0.18u' as='int((nf+2)/2) * W/nf * 0.18u' pd='2*int((nf+1)/2) * (W/nf + 0.18u)'
+ ps='2*int((nf+2)/2) * (W/nf + 0.18u)' nrd='0.18u / W' nrs='0.18u / W' sa=0 sb=0 sd=0 m=1
XMBP2 NB2 NB1 VDD_VCO VDD_VCO pfet_03v3 L=0.28u W=3.75u nf=1 ad='int((nf+1)/2) * W/nf * 0.18u' as='int((nf+2)/2) * W/nf * 0.18u' pd='2*int((nf+1)/2) * (W/nf + 0.18u)'
+ ps='2*int((nf+2)/2) * (W/nf + 0.18u)' nrd='0.18u / W' nrs='0.18u / W' sa=0 sb=0 sd=0 m=1
XMBN2 NB2 NB1 GND_VCO GND_VCO nfet_03v3 L=0.28u W=1.5u nf=1 ad='int((nf+1)/2) * W/nf * 0.18u' as='int((nf+2)/2) * W/nf * 0.18u' pd='2*int((nf+1)/2) * (W/nf + 0.18u)'
+ ps='2*int((nf+2)/2) * (W/nf + 0.18u)' nrd='0.18u / W' nrs='0.18u / W' sa=0 sb=0 sd=0 m=1
XMBP3 CLK NB2 VDD_VCO VDD_VCO pfet_03v3 L=0.28u W=11.25u nf=1 ad='int((nf+1)/2) * W/nf * 0.18u' as='int((nf+2)/2) * W/nf * 0.18u' pd='2*int((nf+1)/2) * (W/nf + 0.18u)'
+ ps='2*int((nf+2)/2) * (W/nf + 0.18u)' nrd='0.18u / W' nrs='0.18u / W' sa=0 sb=0 sd=0 m=1
XMBN3 CLK NB2 GND_VCO GND_VCO nfet_03v3 L=0.28u W=4.5u nf=1 ad='int((nf+1)/2) * W/nf * 0.18u' as='int((nf+2)/2) * W/nf * 0.18u' pd='2*int((nf+1)/2) * (W/nf + 0.18u)'
+ ps='2*int((nf+2)/2) * (W/nf + 0.18u)' nrd='0.18u / W' nrs='0.18u / W' sa=0 sb=0 sd=0 m=1
XCDEC1 VDD_VCO GND_VCO cap_nmos_03v3 c_width=50u c_length=50u m=1
XCDEC2 VDD_VCO GND_VCO cap_nmos_03v3 c_width=50u c_length=50u m=1
.ends


* expanding   symbol:  divider_chain.sym # of pins=17
** sym_path: design/divider_chain.sym
** sch_path: design/divider_chain.sch
.subckt divider_chain VCO P0 P1 P2 P3 P4 P5 SEL0 SEL1 SEL2 SEL3 SEL4 SEL5 DIVOUT FB VDD_DIV VSS
*.ipin VCO
*.ipin P0
*.ipin P1
*.ipin P2
*.ipin P3
*.ipin P4
*.ipin P5
*.ipin SEL0
*.ipin SEL1
*.ipin SEL2
*.ipin SEL3
*.ipin SEL4
*.ipin SEL5
*.opin DIVOUT
*.opin FB
*.iopin VDD_DIV
*.iopin VSS
XD0 VCO MI0 P0 CK1 MO0 VDD_DIV VSS div23_cell
XD1 CK1 MI1 P1 CK2 MO1 VDD_DIV VSS div23_cell
XD2 CK2 MI2 P2 CK3 MO2 VDD_DIV VSS div23_cell
XD3 CK3 MI3 P3 CK4 MO3 VDD_DIV VSS div23_cell
XD4 CK4 MI4 P4 CK5 MO4 VDD_DIV VSS div23_cell
XD5 CK5 SEL5 P5 CK6 MO5 VDD_DIV VSS div23_cell
XNR0 MO1 SEL0 NMI0 VDD_DIV VSS nor2_3v3
XIV0 NMI0 MI0 VDD_DIV VSS inv_3v3
XNR1 MO2 SEL1 NMI1 VDD_DIV VSS nor2_3v3
XIV1 NMI1 MI1 VDD_DIV VSS inv_3v3
XNR2 MO3 SEL2 NMI2 VDD_DIV VSS nor2_3v3
XIV2 NMI2 MI2 VDD_DIV VSS inv_3v3
XNR3 MO4 SEL3 NMI3 VDD_DIV VSS nor2_3v3
XIV3 NMI3 MI3 VDD_DIV VSS inv_3v3
XNR4 MO5 SEL4 NMI4 VDD_DIV VSS nor2_3v3
XIV4 NMI4 MI4 VDD_DIV VSS inv_3v3
XM0 CK1 SEL0 T0 VDD_DIV VSS nand2_3v3
XM1 CK2 SEL1 T1 VDD_DIV VSS nand2_3v3
XM2 CK3 SEL2 T2 VDD_DIV VSS nand2_3v3
XM3 CK4 SEL3 T3 VDD_DIV VSS nand2_3v3
XM4 CK5 SEL4 T4 VDD_DIV VSS nand2_3v3
XM5 CK6 SEL5 T5 VDD_DIV VSS nand2_3v3
XMA T0 T1 T2 MA VDD_DIV VSS nand3_3v3
XMB T3 T4 T5 MB VDD_DIV VSS nand3_3v3
XMNO MA MB DIVOUTB VDD_DIV VSS nor2_3v3
XIDO DIVOUTB DIVOUT VDD_DIV VSS inv2x_3v3
XFRT DIVOUT VCO FB FBB VDD_DIV VSS dff_tg_3v3
.ends


* expanding   symbol:  lock_detector.sym # of pins=10
** sym_path: design/lock_detector.sym
** sch_path: design/lock_detector.sch
.subckt lock_detector UP DN LOCK VWIN LDT0 LDT1 LDT2 LDT3 VDD VSS
*.ipin UP
*.ipin DN
*.opin LOCK
*.opin VWIN
*.iopin VDD
*.iopin VSS
*.ipin LDT0
*.ipin LDT1
*.ipin LDT2
*.ipin LDT3
XERR UP DN ERR VDD VSS xor2_3v3
XDLY ERR ERRD LDT0 LDT1 LDT2 LDT3 VDD VSS delaywin_3v3
XNW ERR ERRD WIDEB VDD VSS nand2_3v3
XIW WIDEB WIDE VDD VSS inv_3v3
XMDNW VWIN WIDE VSS VSS nfet_03v3 L=0.5u W=2u nf=1 ad='int((nf+1)/2) * W/nf * 0.18u' as='int((nf+2)/2) * W/nf * 0.18u' pd='2*int((nf+1)/2) * (W/nf + 0.18u)'
+ ps='2*int((nf+2)/2) * (W/nf + 0.18u)' nrd='0.18u / W' nrs='0.18u / W' sa=0 sb=0 sd=0 m=1
XMUPW VWIN VSS VDD VDD pfet_03v3 L=20u W=0.22u nf=1 ad='int((nf+1)/2) * W/nf * 0.18u' as='int((nf+2)/2) * W/nf * 0.18u' pd='2*int((nf+1)/2) * (W/nf + 0.18u)'
+ ps='2*int((nf+2)/2) * (W/nf + 0.18u)' nrd='0.18u / W' nrs='0.18u / W' sa=0 sb=0 sd=0 m=1
XMCW VSS VWIN VSS VSS nfet_03v3 L=6u W=30u nf=1 ad='int((nf+1)/2) * W/nf * 0.18u' as='int((nf+2)/2) * W/nf * 0.18u' pd='2*int((nf+1)/2) * (W/nf + 0.18u)'
+ ps='2*int((nf+2)/2) * (W/nf + 0.18u)' nrd='0.18u / W' nrs='0.18u / W' sa=0 sb=0 sd=0 m=1
XSCH VWIN LOCKB VDD VSS schmitt_3v3
XILK LOCKB LOCK VDD VSS inv_3v3
.ends


* expanding   symbol:  pfd.sym # of pins=6
** sym_path: design/pfd.sym
** sch_path: design/pfd.sch
.subckt pfd REF FB UP DN VDD VSS
*.ipin REF
*.ipin FB
*.opin UP
*.opin DN
*.iopin VDD
*.iopin VSS
xed_ref REF PR VDD VSS edgedet
xed_fb FB PF VDD VSS edgedet
xinv_sr PR SBR VDD VSS pfdcp_inv_3v3
xinv_sf PF SBF VDD VSS pfdcp_inv_3v3
xlat_ref SBR RB UP UPB VDD VSS srlatch
xlat_fb SBF RB DN DNB VDD VSS srlatch
xnand_rst UP DN NRST VDD VSS pfdcp_nand2_3v3
xinv_r0 NRST RST_RAW VDD VSS pfdcp_inv_3v3
xd1 RST_RAW RD1 VDD VSS pfdcp_inv_3v3
xd2 RD1 RD2 VDD VSS pfdcp_inv_3v3
xd3 RD2 RD3 VDD VSS pfdcp_inv_3v3
xd4 RD3 RD4 VDD VSS pfdcp_inv_3v3
xd5 RD4 RD5 VDD VSS pfdcp_inv_3v3
xd6 RD5 RD6 VDD VSS pfdcp_inv_3v3
xd7 RD6 RD7 VDD VSS pfdcp_inv_3v3
xd8 RD7 RD8 VDD VSS pfdcp_inv_3v3
xd9 RD8 RD9 VDD VSS pfdcp_inv_3v3
xd10 RD9 RD10 VDD VSS pfdcp_inv_3v3
xd11 RD10 RD11 VDD VSS pfdcp_inv_3v3
xd12 RD11 RD12 VDD VSS pfdcp_inv_3v3
xd13 RD12 RD13 VDD VSS pfdcp_inv_3v3
xd14 RD13 RD14 VDD VSS pfdcp_inv_3v3
xd15 RD14 RD15 VDD VSS pfdcp_inv_3v3
xd16 RD15 RD16 VDD VSS pfdcp_inv_3v3
xd17 RD16 RD17 VDD VSS pfdcp_inv_3v3
xd18 RD17 RD18 VDD VSS pfdcp_inv_3v3
xd19 RD18 RD19 VDD VSS pfdcp_inv_3v3
xd20 RD19 RD20 VDD VSS pfdcp_inv_3v3
xd21 RD20 RD21 VDD VSS pfdcp_inv_3v3
xd22 RD21 RD22 VDD VSS pfdcp_inv_3v3
xd23 RD22 RD23 VDD VSS pfdcp_inv_3v3
xd24 RD23 RST_DLY VDD VSS pfdcp_inv_3v3
xinv_rb RST_DLY RB VDD VSS pfdcp_inv_3v3
.ends


* expanding   symbol:  cp.sym # of pins=11
** sym_path: design/cp.sym
** sch_path: design/cp.sch
.subckt cp UP DN B0 B1 IBN ICN IBP ICP VOUT VDD VSS
*.ipin UP
*.ipin DN
*.ipin B0
*.ipin B1
*.iopin IBN
*.iopin ICN
*.iopin IBP
*.iopin ICP
*.iopin VOUT
*.iopin VDD
*.iopin VSS
XMBN IBN IBN VSS VSS nfet_03v3 L=1u W=16u nf=1 ad='int((nf+1)/2) * W/nf * 0.18u' as='int((nf+2)/2) * W/nf * 0.18u' pd='2*int((nf+1)/2) * (W/nf + 0.18u)'
+ ps='2*int((nf+2)/2) * (W/nf + 0.18u)' nrd='0.18u / W' nrs='0.18u / W' sa=0 sb=0 sd=0 m=1
XMCN ICN ICN VSS VSS nfet_03v3 L=1u W=4u nf=1 ad='int((nf+1)/2) * W/nf * 0.18u' as='int((nf+2)/2) * W/nf * 0.18u' pd='2*int((nf+1)/2) * (W/nf + 0.18u)'
+ ps='2*int((nf+2)/2) * (W/nf + 0.18u)' nrd='0.18u / W' nrs='0.18u / W' sa=0 sb=0 sd=0 m=1
XMBP IBP IBP VDD VDD pfet_03v3 L=1u W=48u nf=1 ad='int((nf+1)/2) * W/nf * 0.18u' as='int((nf+2)/2) * W/nf * 0.18u' pd='2*int((nf+1)/2) * (W/nf + 0.18u)'
+ ps='2*int((nf+2)/2) * (W/nf + 0.18u)' nrd='0.18u / W' nrs='0.18u / W' sa=0 sb=0 sd=0 m=1
XMCP ICP ICP VDD VDD pfet_03v3 L=1u W=12u nf=1 ad='int((nf+1)/2) * W/nf * 0.18u' as='int((nf+2)/2) * W/nf * 0.18u' pd='2*int((nf+1)/2) * (W/nf + 0.18u)'
+ ps='2*int((nf+2)/2) * (W/nf + 0.18u)' nrd='0.18u / W' nrs='0.18u / W' sa=0 sb=0 sd=0 m=1
xi_b0 B0 B0B VDD VSS pfdcp_inv_3v3
xi_b1 B1 B1B VDD VSS pfdcp_inv_3v3
xi_up UP UPB VDD VSS pfdcp_inv_3v3
xi_dn DN DNB VDD VSS pfdcp_inv_3v3
xn_base IBN ICN VDD VSS DNT VSS cp_leg_n
xn_t0 IBN ICN B0 B0B DNT VSS cp_leg_n
xn_t1a IBN ICN B1 B1B DNT VSS cp_leg_n
xn_t1b IBN ICN B1 B1B DNT VSS cp_leg_n
xp_base IBP ICP VDD VSS UPT VDD cp_leg_p
xp_t0 IBP ICP B0 B0B UPT VDD cp_leg_p
xp_t1a IBP ICP B1 B1B UPT VDD cp_leg_p
xp_t1b IBP ICP B1 B1B UPT VDD cp_leg_p
XMSWDN VOUT DN DNT VSS nfet_03v3 L=0.3u W=6u nf=1 ad='int((nf+1)/2) * W/nf * 0.18u' as='int((nf+2)/2) * W/nf * 0.18u' pd='2*int((nf+1)/2) * (W/nf + 0.18u)'
+ ps='2*int((nf+2)/2) * (W/nf + 0.18u)' nrd='0.18u / W' nrs='0.18u / W' sa=0 sb=0 sd=0 m=1
XMDMPDN VDUMP DNB DNT VSS nfet_03v3 L=0.3u W=6u nf=1 ad='int((nf+1)/2) * W/nf * 0.18u' as='int((nf+2)/2) * W/nf * 0.18u' pd='2*int((nf+1)/2) * (W/nf + 0.18u)'
+ ps='2*int((nf+2)/2) * (W/nf + 0.18u)' nrd='0.18u / W' nrs='0.18u / W' sa=0 sb=0 sd=0 m=1
XMSWUP VOUT UPB UPT VDD pfet_03v3 L=0.3u W=6u nf=1 ad='int((nf+1)/2) * W/nf * 0.18u' as='int((nf+2)/2) * W/nf * 0.18u' pd='2*int((nf+1)/2) * (W/nf + 0.18u)'
+ ps='2*int((nf+2)/2) * (W/nf + 0.18u)' nrd='0.18u / W' nrs='0.18u / W' sa=0 sb=0 sd=0 m=1
XMDMPUP VDUMP UP UPT VDD pfet_03v3 L=0.3u W=6u nf=1 ad='int((nf+1)/2) * W/nf * 0.18u' as='int((nf+2)/2) * W/nf * 0.18u' pd='2*int((nf+1)/2) * (W/nf + 0.18u)'
+ ps='2*int((nf+2)/2) * (W/nf + 0.18u)' nrd='0.18u / W' nrs='0.18u / W' sa=0 sb=0 sd=0 m=1
XMDUMN VOUT DNB VOUT VSS nfet_03v3 L=0.3u W=3u nf=1 ad='int((nf+1)/2) * W/nf * 0.18u' as='int((nf+2)/2) * W/nf * 0.18u' pd='2*int((nf+1)/2) * (W/nf + 0.18u)'
+ ps='2*int((nf+2)/2) * (W/nf + 0.18u)' nrd='0.18u / W' nrs='0.18u / W' sa=0 sb=0 sd=0 m=1
XMDUMP VOUT UP VOUT VDD pfet_03v3 L=0.3u W=3u nf=1 ad='int((nf+1)/2) * W/nf * 0.18u' as='int((nf+2)/2) * W/nf * 0.18u' pd='2*int((nf+1)/2) * (W/nf + 0.18u)'
+ ps='2*int((nf+2)/2) * (W/nf + 0.18u)' nrd='0.18u / W' nrs='0.18u / W' sa=0 sb=0 sd=0 m=1
xbuf VOUT IBN IBP VDUMP VDD VSS cp_dumpbuf
.ends


* expanding   symbol:  vco_bias.sym # of pins=8
** sym_path: design/vco_bias.sym
** sch_path: design/vco_bias.sch
.subckt vco_bias VCTRL B0 B1 B2 VBP VBN VDD VSS
*.ipin VCTRL
*.ipin B0
*.ipin B1
*.ipin B2
*.iopin VBP
*.iopin VBN
*.iopin VDD
*.iopin VSS
XMP1 NA VBPC VDD VDD pfet_03v3 L=1u W=10u nf=1 ad='int((nf+1)/2) * W/nf * 0.18u' as='int((nf+2)/2) * W/nf * 0.18u' pd='2*int((nf+1)/2) * (W/nf + 0.18u)'
+ ps='2*int((nf+2)/2) * (W/nf + 0.18u)' nrd='0.18u / W' nrs='0.18u / W' sa=0 sb=0 sd=0 m=1
XMP2 VBPC VBPC VDD VDD pfet_03v3 L=1u W=10u nf=1 ad='int((nf+1)/2) * W/nf * 0.18u' as='int((nf+2)/2) * W/nf * 0.18u' pd='2*int((nf+1)/2) * (W/nf + 0.18u)'
+ ps='2*int((nf+2)/2) * (W/nf + 0.18u)' nrd='0.18u / W' nrs='0.18u / W' sa=0 sb=0 sd=0 m=1
XMN1 NA NA VSS VSS nfet_03v3 L=1u W=1.4u nf=1 ad='int((nf+1)/2) * W/nf * 0.18u' as='int((nf+2)/2) * W/nf * 0.18u' pd='2*int((nf+1)/2) * (W/nf + 0.18u)'
+ ps='2*int((nf+2)/2) * (W/nf + 0.18u)' nrd='0.18u / W' nrs='0.18u / W' sa=0 sb=0 sd=0 m=1
XMN2 VBPC NA NC VSS nfet_03v3 L=1u W=5.6u nf=1 ad='int((nf+1)/2) * W/nf * 0.18u' as='int((nf+2)/2) * W/nf * 0.18u' pd='2*int((nf+1)/2) * (W/nf + 0.18u)'
+ ps='2*int((nf+2)/2) * (W/nf + 0.18u)' nrd='0.18u / W' nrs='0.18u / W' sa=0 sb=0 sd=0 m=1
XRCG NC VSS VSS ppolyf_u_3k r_width=1u r_length=5.6u m=1
XMSU1 NSU VSS VDD VDD pfet_03v3 L=20u W=0.22u nf=1 ad='int((nf+1)/2) * W/nf * 0.18u' as='int((nf+2)/2) * W/nf * 0.18u' pd='2*int((nf+1)/2) * (W/nf + 0.18u)'
+ ps='2*int((nf+2)/2) * (W/nf + 0.18u)' nrd='0.18u / W' nrs='0.18u / W' sa=0 sb=0 sd=0 m=1
XMSU2 NSU NA VSS VSS nfet_03v3 L=1u W=2u nf=1 ad='int((nf+1)/2) * W/nf * 0.18u' as='int((nf+2)/2) * W/nf * 0.18u' pd='2*int((nf+1)/2) * (W/nf + 0.18u)'
+ ps='2*int((nf+2)/2) * (W/nf + 0.18u)' nrd='0.18u / W' nrs='0.18u / W' sa=0 sb=0 sd=0 m=1
XMSU3 VBPC NSU VSS VSS nfet_03v3 L=1u W=1u nf=1 ad='int((nf+1)/2) * W/nf * 0.18u' as='int((nf+2)/2) * W/nf * 0.18u' pd='2*int((nf+1)/2) * (W/nf + 0.18u)'
+ ps='2*int((nf+2)/2) * (W/nf + 0.18u)' nrd='0.18u / W' nrs='0.18u / W' sa=0 sb=0 sd=0 m=1
XMPR VFIX VBPC VDD VDD pfet_03v3 L=1u W=2.5u nf=1 ad='int((nf+1)/2) * W/nf * 0.18u' as='int((nf+2)/2) * W/nf * 0.18u' pd='2*int((nf+1)/2) * (W/nf + 0.18u)'
+ ps='2*int((nf+2)/2) * (W/nf + 0.18u)' nrd='0.18u / W' nrs='0.18u / W' sa=0 sb=0 sd=0 m=1
XMD1 VFIX VFIX NMD VSS nfet_03v3 L=1u W=2u nf=1 ad='int((nf+1)/2) * W/nf * 0.18u' as='int((nf+2)/2) * W/nf * 0.18u' pd='2*int((nf+1)/2) * (W/nf + 0.18u)'
+ ps='2*int((nf+2)/2) * (W/nf + 0.18u)' nrd='0.18u / W' nrs='0.18u / W' sa=0 sb=0 sd=0 m=1
XMD2 NMD NMD VSS VSS nfet_03v3 L=1u W=2u nf=1 ad='int((nf+1)/2) * W/nf * 0.18u' as='int((nf+2)/2) * W/nf * 0.18u' pd='2*int((nf+1)/2) * (W/nf + 0.18u)'
+ ps='2*int((nf+2)/2) * (W/nf + 0.18u)' nrd='0.18u / W' nrs='0.18u / W' sa=0 sb=0 sd=0 m=1
XMOFF VBP0 VFIX NOFF VSS nfet_03v3 L=1u W=10u nf=1 ad='int((nf+1)/2) * W/nf * 0.18u' as='int((nf+2)/2) * W/nf * 0.18u' pd='2*int((nf+1)/2) * (W/nf + 0.18u)'
+ ps='2*int((nf+2)/2) * (W/nf + 0.18u)' nrd='0.18u / W' nrs='0.18u / W' sa=0 sb=0 sd=0 m=1
XROFF NOFF VSS VSS ppolyf_u_3k r_width=1u r_length=33u m=1
XMVI VBP0 VCTRL NVI VSS nfet_03v3 L=1u W=10u nf=1 ad='int((nf+1)/2) * W/nf * 0.18u' as='int((nf+2)/2) * W/nf * 0.18u' pd='2*int((nf+1)/2) * (W/nf + 0.18u)'
+ ps='2*int((nf+2)/2) * (W/nf + 0.18u)' nrd='0.18u / W' nrs='0.18u / W' sa=0 sb=0 sd=0 m=1
XRDEG NVI VSS VSS ppolyf_u_3k r_width=1u r_length=33u m=1
XMSUM VBP0 VBP0 VDD VDD pfet_03v3 L=1u W=60u nf=4 ad='int((nf+1)/2) * W/nf * 0.18u' as='int((nf+2)/2) * W/nf * 0.18u' pd='2*int((nf+1)/2) * (W/nf + 0.18u)'
+ ps='2*int((nf+2)/2) * (W/nf + 0.18u)' nrd='0.18u / W' nrs='0.18u / W' sa=0 sb=0 sd=0 m=1
XMIP0 B0B B0 VDD VDD pfet_03v3 L=0.28u W=2u nf=1 ad='int((nf+1)/2) * W/nf * 0.18u' as='int((nf+2)/2) * W/nf * 0.18u' pd='2*int((nf+1)/2) * (W/nf + 0.18u)'
+ ps='2*int((nf+2)/2) * (W/nf + 0.18u)' nrd='0.18u / W' nrs='0.18u / W' sa=0 sb=0 sd=0 m=1
XMIN0 B0B B0 VSS VSS nfet_03v3 L=0.28u W=1u nf=1 ad='int((nf+1)/2) * W/nf * 0.18u' as='int((nf+2)/2) * W/nf * 0.18u' pd='2*int((nf+1)/2) * (W/nf + 0.18u)'
+ ps='2*int((nf+2)/2) * (W/nf + 0.18u)' nrd='0.18u / W' nrs='0.18u / W' sa=0 sb=0 sd=0 m=1
XMIP1 B1B B1 VDD VDD pfet_03v3 L=0.28u W=2u nf=1 ad='int((nf+1)/2) * W/nf * 0.18u' as='int((nf+2)/2) * W/nf * 0.18u' pd='2*int((nf+1)/2) * (W/nf + 0.18u)'
+ ps='2*int((nf+2)/2) * (W/nf + 0.18u)' nrd='0.18u / W' nrs='0.18u / W' sa=0 sb=0 sd=0 m=1
XMIN1 B1B B1 VSS VSS nfet_03v3 L=0.28u W=1u nf=1 ad='int((nf+1)/2) * W/nf * 0.18u' as='int((nf+2)/2) * W/nf * 0.18u' pd='2*int((nf+1)/2) * (W/nf + 0.18u)'
+ ps='2*int((nf+2)/2) * (W/nf + 0.18u)' nrd='0.18u / W' nrs='0.18u / W' sa=0 sb=0 sd=0 m=1
XMIP2 B2B B2 VDD VDD pfet_03v3 L=0.28u W=2u nf=1 ad='int((nf+1)/2) * W/nf * 0.18u' as='int((nf+2)/2) * W/nf * 0.18u' pd='2*int((nf+1)/2) * (W/nf + 0.18u)'
+ ps='2*int((nf+2)/2) * (W/nf + 0.18u)' nrd='0.18u / W' nrs='0.18u / W' sa=0 sb=0 sd=0 m=1
XMIN2 B2B B2 VSS VSS nfet_03v3 L=0.28u W=1u nf=1 ad='int((nf+1)/2) * W/nf * 0.18u' as='int((nf+2)/2) * W/nf * 0.18u' pd='2*int((nf+1)/2) * (W/nf + 0.18u)'
+ ps='2*int((nf+2)/2) * (W/nf + 0.18u)' nrd='0.18u / W' nrs='0.18u / W' sa=0 sb=0 sd=0 m=1
XMA0 VBN1 VBP0 VDD VDD pfet_03v3 L=1u W=26.5u nf=2 ad='int((nf+1)/2) * W/nf * 0.18u' as='int((nf+2)/2) * W/nf * 0.18u' pd='2*int((nf+1)/2) * (W/nf + 0.18u)'
+ ps='2*int((nf+2)/2) * (W/nf + 0.18u)' nrd='0.18u / W' nrs='0.18u / W' sa=0 sb=0 sd=0 m=1
XMA1 VBN1 GA VDD VDD pfet_03v3 L=1u W=17.225u nf=2 ad='int((nf+1)/2) * W/nf * 0.18u' as='int((nf+2)/2) * W/nf * 0.18u' pd='2*int((nf+1)/2) * (W/nf + 0.18u)'
+ ps='2*int((nf+2)/2) * (W/nf + 0.18u)' nrd='0.18u / W' nrs='0.18u / W' sa=0 sb=0 sd=0 m=1
XMSWA0 GA B0B VBP0 VDD pfet_03v3 L=0.5u W=2u nf=1 ad='int((nf+1)/2) * W/nf * 0.18u' as='int((nf+2)/2) * W/nf * 0.18u' pd='2*int((nf+1)/2) * (W/nf + 0.18u)'
+ ps='2*int((nf+2)/2) * (W/nf + 0.18u)' nrd='0.18u / W' nrs='0.18u / W' sa=0 sb=0 sd=0 m=1
XMSWA1 GA B0 VDD VDD pfet_03v3 L=0.5u W=2u nf=1 ad='int((nf+1)/2) * W/nf * 0.18u' as='int((nf+2)/2) * W/nf * 0.18u' pd='2*int((nf+1)/2) * (W/nf + 0.18u)'
+ ps='2*int((nf+2)/2) * (W/nf + 0.18u)' nrd='0.18u / W' nrs='0.18u / W' sa=0 sb=0 sd=0 m=1
XMDA VBN1 VBN1 VSS VSS nfet_03v3 L=1u W=10u nf=1 ad='int((nf+1)/2) * W/nf * 0.18u' as='int((nf+2)/2) * W/nf * 0.18u' pd='2*int((nf+1)/2) * (W/nf + 0.18u)'
+ ps='2*int((nf+2)/2) * (W/nf + 0.18u)' nrd='0.18u / W' nrs='0.18u / W' sa=0 sb=0 sd=0 m=1
XMB0 VBP2 VBN1 VSS VSS nfet_03v3 L=1u W=5u nf=1 ad='int((nf+1)/2) * W/nf * 0.18u' as='int((nf+2)/2) * W/nf * 0.18u' pd='2*int((nf+1)/2) * (W/nf + 0.18u)'
+ ps='2*int((nf+2)/2) * (W/nf + 0.18u)' nrd='0.18u / W' nrs='0.18u / W' sa=0 sb=0 sd=0 m=1
XMB1 VBP2 GB VSS VSS nfet_03v3 L=1u W=8.6125u nf=1 ad='int((nf+1)/2) * W/nf * 0.18u' as='int((nf+2)/2) * W/nf * 0.18u' pd='2*int((nf+1)/2) * (W/nf + 0.18u)'
+ ps='2*int((nf+2)/2) * (W/nf + 0.18u)' nrd='0.18u / W' nrs='0.18u / W' sa=0 sb=0 sd=0 m=1
XMSWB0 GB B1 VBN1 VSS nfet_03v3 L=0.5u W=2u nf=1 ad='int((nf+1)/2) * W/nf * 0.18u' as='int((nf+2)/2) * W/nf * 0.18u' pd='2*int((nf+1)/2) * (W/nf + 0.18u)'
+ ps='2*int((nf+2)/2) * (W/nf + 0.18u)' nrd='0.18u / W' nrs='0.18u / W' sa=0 sb=0 sd=0 m=1
XMSWB1 GB B1B VSS VSS nfet_03v3 L=0.5u W=2u nf=1 ad='int((nf+1)/2) * W/nf * 0.18u' as='int((nf+2)/2) * W/nf * 0.18u' pd='2*int((nf+1)/2) * (W/nf + 0.18u)'
+ ps='2*int((nf+2)/2) * (W/nf + 0.18u)' nrd='0.18u / W' nrs='0.18u / W' sa=0 sb=0 sd=0 m=1
XMDB VBP2 VBP2 VDD VDD pfet_03v3 L=1u W=20u nf=1 ad='int((nf+1)/2) * W/nf * 0.18u' as='int((nf+2)/2) * W/nf * 0.18u' pd='2*int((nf+1)/2) * (W/nf + 0.18u)'
+ ps='2*int((nf+2)/2) * (W/nf + 0.18u)' nrd='0.18u / W' nrs='0.18u / W' sa=0 sb=0 sd=0 m=1
XMC0 VBN VBP2 VDD VDD pfet_03v3 L=1u W=12.3u nf=1 ad='int((nf+1)/2) * W/nf * 0.18u' as='int((nf+2)/2) * W/nf * 0.18u' pd='2*int((nf+1)/2) * (W/nf + 0.18u)'
+ ps='2*int((nf+2)/2) * (W/nf + 0.18u)' nrd='0.18u / W' nrs='0.18u / W' sa=0 sb=0 sd=0 m=1
XMC1 VBN GC VDD VDD pfet_03v3 L=1u W=78.87u nf=8 ad='int((nf+1)/2) * W/nf * 0.18u' as='int((nf+2)/2) * W/nf * 0.18u' pd='2*int((nf+1)/2) * (W/nf + 0.18u)'
+ ps='2*int((nf+2)/2) * (W/nf + 0.18u)' nrd='0.18u / W' nrs='0.18u / W' sa=0 sb=0 sd=0 m=1
XMSWC0 GC B2B VBP2 VDD pfet_03v3 L=0.5u W=2u nf=1 ad='int((nf+1)/2) * W/nf * 0.18u' as='int((nf+2)/2) * W/nf * 0.18u' pd='2*int((nf+1)/2) * (W/nf + 0.18u)'
+ ps='2*int((nf+2)/2) * (W/nf + 0.18u)' nrd='0.18u / W' nrs='0.18u / W' sa=0 sb=0 sd=0 m=1
XMSWC1 GC B2 VDD VDD pfet_03v3 L=0.5u W=2u nf=1 ad='int((nf+1)/2) * W/nf * 0.18u' as='int((nf+2)/2) * W/nf * 0.18u' pd='2*int((nf+1)/2) * (W/nf + 0.18u)'
+ ps='2*int((nf+2)/2) * (W/nf + 0.18u)' nrd='0.18u / W' nrs='0.18u / W' sa=0 sb=0 sd=0 m=1
XMDN VBN VBN VSS VSS nfet_03v3 L=0.5u W=4u nf=1 ad='int((nf+1)/2) * W/nf * 0.18u' as='int((nf+2)/2) * W/nf * 0.18u' pd='2*int((nf+1)/2) * (W/nf + 0.18u)'
+ ps='2*int((nf+2)/2) * (W/nf + 0.18u)' nrd='0.18u / W' nrs='0.18u / W' sa=0 sb=0 sd=0 m=1
XMMN VBP VBN VSS VSS nfet_03v3 L=0.5u W=4u nf=1 ad='int((nf+1)/2) * W/nf * 0.18u' as='int((nf+2)/2) * W/nf * 0.18u' pd='2*int((nf+1)/2) * (W/nf + 0.18u)'
+ ps='2*int((nf+2)/2) * (W/nf + 0.18u)' nrd='0.18u / W' nrs='0.18u / W' sa=0 sb=0 sd=0 m=1
XMDP VBP VBP VDD VDD pfet_03v3 L=0.5u W=10u nf=1 ad='int((nf+1)/2) * W/nf * 0.18u' as='int((nf+2)/2) * W/nf * 0.18u' pd='2*int((nf+1)/2) * (W/nf + 0.18u)'
+ ps='2*int((nf+2)/2) * (W/nf + 0.18u)' nrd='0.18u / W' nrs='0.18u / W' sa=0 sb=0 sd=0 m=1
.ends


* expanding   symbol:  vco_stage.sym # of pins=6
** sym_path: design/vco_stage.sym
** sch_path: design/vco_stage.sch
.subckt vco_stage A Y VDD VSS VBP VBN
*.ipin A
*.opin Y
*.iopin VDD
*.iopin VSS
*.iopin VBP
*.iopin VBN
XMPH NH VBP VDD VDD pfet_03v3 L=0.5u W=10u nf=1 ad='int((nf+1)/2) * W/nf * 0.18u' as='int((nf+2)/2) * W/nf * 0.18u' pd='2*int((nf+1)/2) * (W/nf + 0.18u)'
+ ps='2*int((nf+2)/2) * (W/nf + 0.18u)' nrd='0.18u / W' nrs='0.18u / W' sa=0 sb=0 sd=0 m=1
XMP Y A NH VDD pfet_03v3 L=0.28u W=5u nf=1 ad='int((nf+1)/2) * W/nf * 0.18u' as='int((nf+2)/2) * W/nf * 0.18u' pd='2*int((nf+1)/2) * (W/nf + 0.18u)'
+ ps='2*int((nf+2)/2) * (W/nf + 0.18u)' nrd='0.18u / W' nrs='0.18u / W' sa=0 sb=0 sd=0 m=1
XMN Y A NT VSS nfet_03v3 L=0.28u W=2u nf=1 ad='int((nf+1)/2) * W/nf * 0.18u' as='int((nf+2)/2) * W/nf * 0.18u' pd='2*int((nf+1)/2) * (W/nf + 0.18u)'
+ ps='2*int((nf+2)/2) * (W/nf + 0.18u)' nrd='0.18u / W' nrs='0.18u / W' sa=0 sb=0 sd=0 m=1
XMNT NT VBN VSS VSS nfet_03v3 L=0.5u W=4u nf=1 ad='int((nf+1)/2) * W/nf * 0.18u' as='int((nf+2)/2) * W/nf * 0.18u' pd='2*int((nf+1)/2) * (W/nf + 0.18u)'
+ ps='2*int((nf+2)/2) * (W/nf + 0.18u)' nrd='0.18u / W' nrs='0.18u / W' sa=0 sb=0 sd=0 m=1
.ends


* expanding   symbol:  div23_cell.sym # of pins=7
** sym_path: design/div23_cell.sym
** sch_path: design/div23_cell.sch
.subckt div23_cell CKIN MODIN P CKOUT MODOUT VDD VSS
*.ipin CKIN
*.ipin MODIN
*.ipin P
*.opin CKOUT
*.opin MODOUT
*.iopin VDD
*.iopin VSS
XN3 MODIN P MODOUT SB VDD VSS nand3_3v3
XN2Q QB SB DQN VDD VSS nand2_3v3
XIQ DQN DQ VDD VSS inv_3v3
XFQ DQ CKIN Q QB VDD VSS dff_tg_3v3
XICKO QB CKOUT VDD VSS inv2x_3v3
XN2M MODIN Q NMO VDD VSS nand2_3v3
XIM NMO DMO VDD VSS inv_3v3
XFMO DMO CKIN MODOUT MOB VDD VSS dff_tg_3v3
.ends


* expanding   symbol:  nor2_3v3.sym # of pins=5
** sym_path: design/nor2_3v3.sym
** sch_path: design/nor2_3v3.sch
.subckt nor2_3v3 A B Y VDD VSS
*.ipin A
*.ipin B
*.opin Y
*.iopin VDD
*.iopin VSS
XMPA PMID A VDD VDD pfet_03v3 L=0.28u W=5u nf=1 ad='int((nf+1)/2) * W/nf * 0.18u' as='int((nf+2)/2) * W/nf * 0.18u' pd='2*int((nf+1)/2) * (W/nf + 0.18u)'
+ ps='2*int((nf+2)/2) * (W/nf + 0.18u)' nrd='0.18u / W' nrs='0.18u / W' sa=0 sb=0 sd=0 m=1
XMPB Y B PMID VDD pfet_03v3 L=0.28u W=5u nf=1 ad='int((nf+1)/2) * W/nf * 0.18u' as='int((nf+2)/2) * W/nf * 0.18u' pd='2*int((nf+1)/2) * (W/nf + 0.18u)'
+ ps='2*int((nf+2)/2) * (W/nf + 0.18u)' nrd='0.18u / W' nrs='0.18u / W' sa=0 sb=0 sd=0 m=1
XMNA Y A VSS VSS nfet_03v3 L=0.28u W=1u nf=1 ad='int((nf+1)/2) * W/nf * 0.18u' as='int((nf+2)/2) * W/nf * 0.18u' pd='2*int((nf+1)/2) * (W/nf + 0.18u)'
+ ps='2*int((nf+2)/2) * (W/nf + 0.18u)' nrd='0.18u / W' nrs='0.18u / W' sa=0 sb=0 sd=0 m=1
XMNB Y B VSS VSS nfet_03v3 L=0.28u W=1u nf=1 ad='int((nf+1)/2) * W/nf * 0.18u' as='int((nf+2)/2) * W/nf * 0.18u' pd='2*int((nf+1)/2) * (W/nf + 0.18u)'
+ ps='2*int((nf+2)/2) * (W/nf + 0.18u)' nrd='0.18u / W' nrs='0.18u / W' sa=0 sb=0 sd=0 m=1
.ends


* expanding   symbol:  inv_3v3.sym # of pins=4
** sym_path: design/inv_3v3.sym
** sch_path: design/inv_3v3.sch
.subckt inv_3v3 A Y VDD VSS
*.ipin A
*.opin Y
*.iopin VDD
*.iopin VSS
XMP Y A VDD VDD pfet_03v3 L=0.28u W=2.5u nf=1 ad='int((nf+1)/2) * W/nf * 0.18u' as='int((nf+2)/2) * W/nf * 0.18u' pd='2*int((nf+1)/2) * (W/nf + 0.18u)'
+ ps='2*int((nf+2)/2) * (W/nf + 0.18u)' nrd='0.18u / W' nrs='0.18u / W' sa=0 sb=0 sd=0 m=1
XMN Y A VSS VSS nfet_03v3 L=0.28u W=1u nf=1 ad='int((nf+1)/2) * W/nf * 0.18u' as='int((nf+2)/2) * W/nf * 0.18u' pd='2*int((nf+1)/2) * (W/nf + 0.18u)'
+ ps='2*int((nf+2)/2) * (W/nf + 0.18u)' nrd='0.18u / W' nrs='0.18u / W' sa=0 sb=0 sd=0 m=1
.ends


* expanding   symbol:  nand2_3v3.sym # of pins=5
** sym_path: design/nand2_3v3.sym
** sch_path: design/nand2_3v3.sch
.subckt nand2_3v3 A B Y VDD VSS
*.ipin A
*.ipin B
*.opin Y
*.iopin VDD
*.iopin VSS
XMPA Y A VDD VDD pfet_03v3 L=0.28u W=2.5u nf=1 ad='int((nf+1)/2) * W/nf * 0.18u' as='int((nf+2)/2) * W/nf * 0.18u' pd='2*int((nf+1)/2) * (W/nf + 0.18u)'
+ ps='2*int((nf+2)/2) * (W/nf + 0.18u)' nrd='0.18u / W' nrs='0.18u / W' sa=0 sb=0 sd=0 m=1
XMPB Y B VDD VDD pfet_03v3 L=0.28u W=2.5u nf=1 ad='int((nf+1)/2) * W/nf * 0.18u' as='int((nf+2)/2) * W/nf * 0.18u' pd='2*int((nf+1)/2) * (W/nf + 0.18u)'
+ ps='2*int((nf+2)/2) * (W/nf + 0.18u)' nrd='0.18u / W' nrs='0.18u / W' sa=0 sb=0 sd=0 m=1
XMNA Y A NMID VSS nfet_03v3 L=0.28u W=2u nf=1 ad='int((nf+1)/2) * W/nf * 0.18u' as='int((nf+2)/2) * W/nf * 0.18u' pd='2*int((nf+1)/2) * (W/nf + 0.18u)'
+ ps='2*int((nf+2)/2) * (W/nf + 0.18u)' nrd='0.18u / W' nrs='0.18u / W' sa=0 sb=0 sd=0 m=1
XMNB NMID B VSS VSS nfet_03v3 L=0.28u W=2u nf=1 ad='int((nf+1)/2) * W/nf * 0.18u' as='int((nf+2)/2) * W/nf * 0.18u' pd='2*int((nf+1)/2) * (W/nf + 0.18u)'
+ ps='2*int((nf+2)/2) * (W/nf + 0.18u)' nrd='0.18u / W' nrs='0.18u / W' sa=0 sb=0 sd=0 m=1
.ends


* expanding   symbol:  nand3_3v3.sym # of pins=6
** sym_path: design/nand3_3v3.sym
** sch_path: design/nand3_3v3.sch
.subckt nand3_3v3 A B C Y VDD VSS
*.ipin A
*.ipin B
*.ipin C
*.opin Y
*.iopin VDD
*.iopin VSS
XMPA Y A VDD VDD pfet_03v3 L=0.28u W=2.5u nf=1 ad='int((nf+1)/2) * W/nf * 0.18u' as='int((nf+2)/2) * W/nf * 0.18u' pd='2*int((nf+1)/2) * (W/nf + 0.18u)'
+ ps='2*int((nf+2)/2) * (W/nf + 0.18u)' nrd='0.18u / W' nrs='0.18u / W' sa=0 sb=0 sd=0 m=1
XMPB Y B VDD VDD pfet_03v3 L=0.28u W=2.5u nf=1 ad='int((nf+1)/2) * W/nf * 0.18u' as='int((nf+2)/2) * W/nf * 0.18u' pd='2*int((nf+1)/2) * (W/nf + 0.18u)'
+ ps='2*int((nf+2)/2) * (W/nf + 0.18u)' nrd='0.18u / W' nrs='0.18u / W' sa=0 sb=0 sd=0 m=1
XMPC Y C VDD VDD pfet_03v3 L=0.28u W=2.5u nf=1 ad='int((nf+1)/2) * W/nf * 0.18u' as='int((nf+2)/2) * W/nf * 0.18u' pd='2*int((nf+1)/2) * (W/nf + 0.18u)'
+ ps='2*int((nf+2)/2) * (W/nf + 0.18u)' nrd='0.18u / W' nrs='0.18u / W' sa=0 sb=0 sd=0 m=1
XMNA Y A NM1 VSS nfet_03v3 L=0.28u W=3u nf=1 ad='int((nf+1)/2) * W/nf * 0.18u' as='int((nf+2)/2) * W/nf * 0.18u' pd='2*int((nf+1)/2) * (W/nf + 0.18u)'
+ ps='2*int((nf+2)/2) * (W/nf + 0.18u)' nrd='0.18u / W' nrs='0.18u / W' sa=0 sb=0 sd=0 m=1
XMNB NM1 B NM2 VSS nfet_03v3 L=0.28u W=3u nf=1 ad='int((nf+1)/2) * W/nf * 0.18u' as='int((nf+2)/2) * W/nf * 0.18u' pd='2*int((nf+1)/2) * (W/nf + 0.18u)'
+ ps='2*int((nf+2)/2) * (W/nf + 0.18u)' nrd='0.18u / W' nrs='0.18u / W' sa=0 sb=0 sd=0 m=1
XMNC NM2 C VSS VSS nfet_03v3 L=0.28u W=3u nf=1 ad='int((nf+1)/2) * W/nf * 0.18u' as='int((nf+2)/2) * W/nf * 0.18u' pd='2*int((nf+1)/2) * (W/nf + 0.18u)'
+ ps='2*int((nf+2)/2) * (W/nf + 0.18u)' nrd='0.18u / W' nrs='0.18u / W' sa=0 sb=0 sd=0 m=1
.ends


* expanding   symbol:  inv2x_3v3.sym # of pins=4
** sym_path: design/inv2x_3v3.sym
** sch_path: design/inv2x_3v3.sch
.subckt inv2x_3v3 A Y VDD VSS
*.ipin A
*.opin Y
*.iopin VDD
*.iopin VSS
XMP Y A VDD VDD pfet_03v3 L=0.28u W=5u nf=1 ad='int((nf+1)/2) * W/nf * 0.18u' as='int((nf+2)/2) * W/nf * 0.18u' pd='2*int((nf+1)/2) * (W/nf + 0.18u)'
+ ps='2*int((nf+2)/2) * (W/nf + 0.18u)' nrd='0.18u / W' nrs='0.18u / W' sa=0 sb=0 sd=0 m=1
XMN Y A VSS VSS nfet_03v3 L=0.28u W=2u nf=1 ad='int((nf+1)/2) * W/nf * 0.18u' as='int((nf+2)/2) * W/nf * 0.18u' pd='2*int((nf+1)/2) * (W/nf + 0.18u)'
+ ps='2*int((nf+2)/2) * (W/nf + 0.18u)' nrd='0.18u / W' nrs='0.18u / W' sa=0 sb=0 sd=0 m=1
.ends


* expanding   symbol:  dff_tg_3v3.sym # of pins=6
** sym_path: design/dff_tg_3v3.sym
** sch_path: design/dff_tg_3v3.sch
.subckt dff_tg_3v3 D CK Q QB VDD VSS
*.ipin D
*.ipin CK
*.opin Q
*.opin QB
*.iopin VDD
*.iopin VSS
XICKB CK CKB VDD VSS inv_3v3
XICKBB CKB CKBB VDD VSS inv_3v3
XTGMI D NM CKB CKBB VDD VSS tgate_3v3
XIA NM NMA VDD VSS inv_3v3
XIB NMA NMB VDD VSS inv_3v3
XTGMF NMB NM CKBB CKB VDD VSS tgate_3v3
XTGSI NMA NS CKBB CKB VDD VSS tgate_3v3
XIC NS Q VDD VSS inv_3v3
XID Q QB VDD VSS inv_3v3
XTGSF QB NS CKB CKBB VDD VSS tgate_3v3
.ends


* expanding   symbol:  xor2_3v3.sym # of pins=5
** sym_path: design/xor2_3v3.sym
** sch_path: design/xor2_3v3.sch
.subckt xor2_3v3 A B Y VDD VSS
*.ipin A
*.ipin B
*.opin Y
*.iopin VDD
*.iopin VSS
XG1 A B N1 VDD VSS nand2_3v3
XG2 A N1 N2 VDD VSS nand2_3v3
XG3 B N1 N3 VDD VSS nand2_3v3
XG4 N2 N3 Y VDD VSS nand2_3v3
.ends
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
