2AMLogic/gf180-pll/sim/lock-window-proxy/testbench/tb_window.sp

* gf180-pll :: lock-window-proxy :: phase 'win' -- all sixteen trim codes at once
*
* This phase measures exactly what sim/lock-window-trim measures -- t_win, the
* ERR -> ERRD propagation delay of the committed delaywin_3v3 -- but it puts
* all sixteen codes in ONE deck rather than sweeping the code as a harness
* axis.  The reason is the campaign's whole question: the proxy phase's VCO
* frequency and this phase's window have to be a PAIR taken at the same PVT
* point of the same run, or the mapping between them is an inference across
* campaigns rather than a measurement.  Sixteen copies driven from one ideal
* source is how that pairing is made without running the code axis 16x.
*
* The sixteen copies see an IDENTICAL stimulus: `vstep` is a voltage source,
* so its output impedance is zero and the sixteen input capacitances do not
* load each other.  The measured delay is therefore the same quantity
* sim/lock-window-trim's single-copy deck measures, and the two are compared
* point-for-point in the record (the 'twin_crosscheck' table) rather than
* assumed equal.
*
* Which edge IS the window: ERR rises at t0 and falls at t0 + tau, ERRD at
* t0 + twin_r and t0 + tau + twin_f, so WIDE = ERR . ERRD is non-empty exactly
* when tau > twin_r.  twin_r is the discrimination threshold and is what this
* deck measures, per code.
*
* Expects from the harness-generated header:
*   .lib <process corner section>, .temp <temp_c>
*   .param vdd_val=<supply volts>  vdd_nom=<nominal volts>
*   .param ktstepw=<max timestep>  ktstopw=<stop>
*
* design/netlist/pll_top.spice is composed ahead of this fragment by the
* harness (tb.json "dut").  The DUT is the ASSEMBLED part's own export, not a
* block export, because the question this campaign asks is a question about a
* packaged part: both the delay cell and the VCO the tester reads have to come
* from the same netlist a tester would be holding.

.param ttr='100p'
.param ttd='2n'
.param twide='ktstopw/2'

vdd vdd 0 dc 'vdd_val'
vone vone 0 dc 'vdd_val'

* ---- the ideal step -------------------------------------------------------
vstep step 0 pulse(0 'vdd_val' 'ttd' 'ttr' 'ttr' 'twide' '1000*ktstopw')
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
