2AMLogic/gf180-pll/layout/pll_top/divider_chain/divider_chain.py

"""``divider_chain`` -- the full block assembly (issue #310, Part 5/final of
#295's ``divider_chain`` full-custom layout decomposition).

WHAT THIS BUILDS
-----------------
The complete ``divider_chain`` block per ``design/netlist/divider_chain.spice``'s
own ``divider_chain`` subckt:

* ``XD0``..``XD5`` -- Part 4's ``div23_cell`` composite macro (issue #309),
  instantiated **six times, identically**, chained
  ``VCO -> CK1 -> CK2 -> CK3 -> CK4 -> CK5 -> CK6``.
* Termination / one-hot-mux glue logic: 5x ``nor2_3v3`` + 5x ``inv_3v3``
  forming the modulus-in feedback chain (``XNR0``-``XNR4``/``XIV0``-``XIV4``),
  6x ``nand2_3v3`` + 2x ``nand3_3v3`` + 1x ``nor2_3v3`` + 1x ``inv2x_3v3``
  forming the one-hot ``SEL0``-``SEL5`` output mux to ``DIVOUT``
  (``XM0``-``XM5``, ``XMA``, ``XMB``, ``XMNO``, ``XIDO``).
* ``XFRT`` -- one Part 3 ``dff_tg_3v3`` composite (issue #308), retiming
  ``DIVOUT`` on ``VCO`` to produce ``FB``.

452 transistors total: 360 across the six ``div23_cell`` instances (60 each)
plus 92 in the glue logic above (24 nor2_3v3 x6 + 10 inv_3v3 x5 + 24
nand2_3v3 x6 + 12 nand3_3v3 x2 + 2 inv2x_3v3 x1 + 20 dff_tg_3v3 x1).

SIX IDENTICAL ``div23_cell`` INSTANCES: GDS-LEVEL PLACEMENT, NOT SIX REDRAWS
------------------------------------------------------------------------------
Every other composite in this package (``dff_tg_3v3.py``, ``div23_cell.py``)
is flat macro composition -- every sub-cell's own devices drawn directly into
one shared ``Canvas``, no GDS-level ``CellInstArray`` hierarchy (see those
modules' own docstrings for why: composing *distinct* leaf cells into a new
macro needs a routing fabric that reasons about every net across the whole
composite, which only works if every device is a plain shape in one cell).

``div23_cell`` here is different: this block does not compose six distinct
cells, it places the *same already-built macro* six times. #295's own
acceptance criteria requires those six instances stay byte-identical -- a
future single-cell TSPC/E-TSPC swap must remain a one-symbol substitution
across all six, not something that can silently drift if one of six
independent redraws is edited without the others. So this module builds
``div23_cell`` exactly **once** (:func:`div23_cell.build`), writes it to one
scratch GDS, and places six ``klayout.db.CellInstArray`` references to that
one cell, translated onto :data:`ROW_PLAN`'s own placement grid (one row
through issue #341, two since #344) -- the same technique
``layout/harness/cell.py``'s own ``build()`` already uses (the only other
``CellInstArray`` use in this repo, there placing PDK standard cells instead
of a locally-built composite). Once every row is placed and routed the top
cell is flattened (``top.flatten(-1, True)``) -- same reason
``harness/cell.py`` gives: "the DRC/LVS deck then compares a flat layout
against the flat reference netlist, with no subcircuit-correspondence
question in the way." The glue logic is drawn directly into that same top
cell, exactly like every other composite in this package.

Flattening after placement does not undermine "byte-identical": the six
placements are geometrically identical copies of the one drawn cell (each
just translated by a different offset), not six independent code paths that
could drift from each other -- which is the property #295's AC actually
cares about (see that issue's own text: "a one-symbol substitution point for
a future TSPC/E-TSPC single-cell swap").

ROUTING THE SIX INSTANCES' BOUNDARY PINS: THE SAME FABRIC, ONE LEVEL UP
-------------------------------------------------------------------------
``div23_cell.py``'s own ``Div23Layout.pins`` records exactly one
representative Metal1 pad point per top-level net (``CKIN``, ``MODIN``,
``P``, ``CKOUT``, ``MODOUT``, ``VDD``, ``VSS``) -- already internally wired
throughout that macro, so a single riser landing anywhere on that pad
reaches the whole net. Translating each of the six instances' own ``pins``
dict by that instance's own placement offset gives this module the exact
physical location of every boundary connection it needs to make, without
caring at all how ``div23_cell`` wired its own interior.

Those translated points are fed into the *same* per-net Metal2/3
riser-to-bus fabric (:func:`devgen.route_net`) this package's every other
composite already uses, mixed in with this module's own freshly-drawn
glue-logic pads -- one ``nets`` dict per row, one track-assignment pass per
row, otherwise exactly like ``div23_cell.py``'s own ``build()``. The only
new constraint this introduces is that a row's routing base_y must sit above
every div23_cell instance *in that row*'s own already-flattened internal
top-of-footprint (each instance's own internal Metal2/3 bus fabric is
already baked into its footprint's own top edge) -- so a new, higher-level
riser continuing straight up from one of those instances' own boundary pads
never has to cross that instance's own internal geometry sideways, only
extend further up the same net's own already-reserved x column (extending a
net's own riser upward, at the same x, is the "two risers for the same
net... not a problem" case ``devgen.py``'s own "Composite macro routing
fabric" section documents).

This module's own track-assignment pass is
:func:`devgen.pack_tracks_over_devices`, not :class:`devgen.NetTracks`
(issue #341 moved it to :func:`devgen.pack_tracks`; issue #458 to the
obstacle-aware form) -- see :func:`devgen.pack_tracks`'s own
docstring/module-level comment for why this block's own top-level pass
specifically benefits from reusing a track across non-colliding nets rather
than handing out a fresh one per net,
``layout/evidence/divider-chain-layout/PROOF-track-packing.md`` for that
measured result, and "ROUTING OVER THE DEVICE ROWS" below for the second
half of the same lever.

ROUTING OVER THE DEVICE ROWS, NOT IN A BAND ABOVE THEM (issue #458)
----------------------------------------------------------------------
Through issue #454 every track this block assigned -- at both levels of its
hierarchy -- came out of a band stacked *on top of* the device rows, at
``content_top + 3.0`` and upwards. Packing (#341, #454) made that band as
short as an interval assignment can make it (43 distinct tracks, a 32.25 um
packed floor), but the band's whole height was still added to the block's:
43.97 um of it over 26.32 um of device rows, with the Metal2 plane over
those rows measured 1.0 % occupied
(``layout/evidence/area-audit/area-audit.md``).

Metal2 has no DRC relationship to the diffusion, poly, implant, well or
Metal1 beneath it, so that plane was never reserved -- only unused. What a
track there does have to clear is other *Metal2*, and this block has exactly
two sources of it: the Via1/Metal2 landing square
:func:`devgen.route_net`'s own risers drop on every pad, and each placed
``div23_cell`` instance's own interior. :func:`devgen.pack_tracks_over_devices`
takes both as an explicit obstacle map (:func:`devgen.metal2_boxes` reads the
second straight back off the canvas, so no second model of the macro's
geometry exists to drift) and gives each net the lowest
:data:`devgen.METAL2_TRACK_PITCH_UM` step at or above the row's own baseline
whose drawn rectangle clears every obstacle.

On this package's fixed row-cell frame (``devgen.ROW_PD_Y0`` = 0,
``devgen.ROW_PU_Y0`` = 10) that opens a Metal2-free horizontal corridor
between the pulldown and pullup device rows which no pad and no sub-block
track occupies, plus several narrower ones; tracks fall into them, and only
the nets that genuinely cannot fit -- their x-extent crosses a
``div23_cell`` instance's own full-height interior -- still open a track
above the rows. The same one-line substitution is made inside
``div23_cell.py`` (see its own "ROUTING OVER THE DEVICE ROWS" section); the
two levels compete for the same corridor, and giving it to the macro is
worth more, because a row's height is gated by the instance standing in it.
Measured together: **1317.66 x 70.29 um -> 1317.66 x 41.99 um**, -40.3 %,
re-verified DRC-clean (default and ``--offgrid``) and LVS-matched at both
levels -- ``layout/evidence/divider-chain-layout/PROOF-over-device-rows.md``.

Nothing about what :func:`devgen.route_net` *draws* changed: it still draws
one Metal2 bus rectangle plus one riser per pad, at whatever ``track_y`` it
is handed. Only which ``track_y`` values are legal changed, which is why
:func:`reference_netlist` is byte-for-byte what it was.

FOLDING THE ROW: TWO ROWS, ONE PACKED BAND EACH (issue #344)
---------------------------------------------------------------
Through issue #341 this block was a **single row**: six ``div23_cell``
instances plus 46 glue-logic columns placed left to right, so its width
(2634.28 um) was the sum of every sub-cell's width and the block on its own
(0.1503 mm^2) was just over the entire 0.15 mm^2 whole-chip area target.
:data:`ROW_PLAN` now folds that into **two rows**, each with its own
independent track-assignment pass (a :func:`devgen.pack_tracks` band above
the row through issue #454; a
:func:`devgen.pack_tracks_over_devices` assignment placed into the row's own
device plane since #458 -- see above).

Why the fold pays off now and did not before #341: with
:class:`devgen.NetTracks`'s one-never-reused-track-per-net scheme, every new
row wants its own band whose height scales with the block's *total* net
count, so folding trades width for height at roughly constant area. With
packing, a row's band height scales with how many of that row's own nets
*mutually collide in x* -- which folding reduces twice over, because each
row holds fewer nets and each net's own extent is bounded by the (now much
narrower) row.

Two placement choices do most of the work, and both are placement-only (no
electrical change whatsoever -- :func:`reference_netlist` is generated from
the same net tables and is byte-for-byte what it was):

* **Glue interleaved with the instances it wires, not parked at one end.**
  ``_glue_group("S<i>")`` holds exactly the gates whose nets terminate on
  ``XD<i>``/``XD<i+1>`` (:func:`_stage_columns`), and :data:`ROW_PLAN` places
  each next to those instances. Through #341 all 46 glue columns sat to the
  right of all six instances, so *every* chain net ran the block's full
  width to reach them -- the measured net-extent profile ramped from 0 at the
  block's left edge to its maximum of 22 mutually-overlapping nets at the
  first glue column, and that peak *is* the track count (it is the interval
  graph's own clique number, which is what :func:`devgen.pack_tracks`
  provably achieves).
* **The one-hot AND second stage split in two.** ``XMA`` consumes
  ``T0``/``T1``/``T2`` and ``XMB`` consumes ``T3``/``T4``/``T5``, so placing
  each in the row holding the three stages that produce its own terms keeps
  all six ``T`` nets inside one row (:func:`_nand3_columns`). Keeping them in
  one shared group instead leaves three of the six crossing a row boundary,
  and a cross-row net costs a track in *every* row it appears in.

CROSS-ROW NETS: A LEFT-HAND METAL3 SPINE
-------------------------------------------
Because each row's band is packed independently, a net with pads in both
rows gets a bus in each and needs the two tied together.
:func:`spine_columns` reserves one vertical Metal3 column per such net,
outside every row's own content, and :func:`devgen.route_spine` draws the
tie; :func:`devgen.route_net`'s own ``bus_to_x`` extends each row's bus out
to meet it. The run crosses only other rows' Metal2 buses and device
geometry -- different layers with no via between them, the same property
:func:`devgen.route_net`'s own long Metal3 risers already rely on.

The spine is at *negative* x (left of every row, which all start at x = 0)
for a mechanical reason worth recording: a right-hand spine's x would depend
on the widest row's drawn width, which is not known until the glue columns
are drawn, which cannot happen until each row's own y placement is known,
which needs that row's own track count, which needs the spine. Anchoring at
x = 0 makes the spine's own geometry a function of the *net tables alone*
and cuts that circularity instead of resolving it with a throwaway
measurement pass.

A cross-row net is therefore never free: it reaches from its own pads out to
the spine, so every cross-row net in a row mutually overlaps every other one
there and each takes a whole track of that row's band. That is exactly why
:data:`ROW_PLAN` is built to minimise their number rather than to balance
the two rows' widths perfectly.

GLUE LOGIC: THE SAME FLAT-COMPOSITE FABRIC AS ``div23_cell.py``
------------------------------------------------------------------
The termination/one-hot-mux glue (92 transistors across 46 columns: 5x
``nor2_3v3`` + 5x ``inv_3v3`` + 6x ``nand2_3v3`` + 2x ``nand3_3v3`` + 1x
``nor2_3v3`` + 1x ``inv2x_3v3`` + one ``dff_tg_3v3`` for ``XFRT``) is drawn
with exactly the same per-column, per-role (gate/channel) net-offset
bucketing and periodic-tap placement ``div23_cell.py``'s own ``build()``
already proved DRC-clean for this same leaf-cell family -- reused via this
module's own :data:`GATE_REF_DX_UM`/:data:`CHANNEL_REF_DX_UM`/etc. (imported
from that module rather than re-derived, since the underlying device
geometry -- gf180mcu's own ``nfet_03v3``/``pfet_03v3`` construction -- is
identical). Each column is tied into its own supply net (``VDD_DIV``, not
``VDD``) at its own periodic tap pair, exactly as the block's own top-level
supply domain requires (see "VDD_DIV supply domain" below).

*Where* those columns sit changed at issue #344: through #341 all 46 sat to
the right of all six ``div23_cell`` instances; they are now grouped
(:data:`GLUE_GROUPS`) and interleaved beside the instances each group wires
(see "FOLDING THE ROW" below for why -- it is the single largest term in
that fold's own result). Only ``div23_cell``'s own frame constants are
shared with those groups; each glue column's own row-cell frame is lifted to
its row's baseline by :func:`_draw_glue_column`.

VDD_DIV SUPPLY DOMAIN
-----------------------
``design/netlist/divider_chain.spice``'s own subckt already names this
block's supply net ``VDD_DIV`` throughout (never ``VDD``) -- every device
here, both inside the six flattened ``div23_cell`` copies (whose own local
``VDD`` boundary pin is translated onto this block's ``VDD_DIV`` net, not
merged with any other block's supply) and in the glue logic (whose own
periodic taps are tied to ``VDD_DIV`` directly, not ``VDD``), lands on one
Metal1/2/3 fabric carrying only that name. Since this block's own generated
GDS contains no other supply net, ``VDD_DIV`` is -- by construction, not by
convention -- never physically merged with any ``VDD``/``VDD_VCO`` segment;
its own Metal2 bus (built by the shared track-assignment pass, one
continuous run spanning every tap/pin on the net) *is* this block's own
supply trunk. ``VDD_DIV`` (like ``VSS``) reaches every column in the block,
so :func:`devgen.pack_tracks` still gives it its own dedicated track --
reuse only helps nets whose own extent leaves room for another net's bus,
which a block-wide supply trunk never does.

REFERENCE NETLIST: A FLATTENED RE-EXPRESSION OF THE EXISTING GENERATED ONE
------------------------------------------------------------------------------
issue #310's own Acceptance Criteria names a *specific*, already-existing
reference: ``design/netlist/divider_chain.spice``, generated by
``design/netlist.sh`` from ``design/divider_chain.sch`` and already
committed on ``main`` -- "the generated, independently-stated reference
netlist". This module's own :func:`reference_netlist` is not an independent
re-derivation of that file's content -- every device, size and connection in
it traces directly to that generated file's own ``.subckt`` bodies, via each
referenced leaf/composite module's own already-independently-stated
``reference_netlist()`` (``div23_cell.reference_netlist()``,
``nor2_3v3.reference_netlist()``, etc.) -- but it *is* a flattened
re-expression of it (:func:`_instance_body` inlines each of those, with
every net not one of that leaf's own subckt ports uniquely prefixed per
instance), not that generated file's own literal hierarchical text.

**This was not a stylistic choice; a first attempt used the generated file
directly and failed LVS with total mismatch (every net and device
unmatched).** gf180mcu's LVS deck (``align``, in
``libs.tech/klayout/lvs/gf180mcu.lvs``) does not flatten a hierarchical
schematic to match a flat layout on its own: it corresponds circuits by
*name*, and this block's own GDS (six flattened ``div23_cell``
``CellInstArray`` placements plus directly-drawn glue logic -- see "SIX
IDENTICAL ``div23_cell`` INSTANCES" above) has no named sub-circuits at all
once flattened, so there is nothing for a hierarchical reference's own
``X div23_cell`` calls to align against. Flattening the reference the same
way -- the same discipline ``div23_cell.py``/``dff_tg_3v3.py`` already use,
generalized to reuse *their* references rather than re-deriving from
scratch -- makes the comparison the same flat-vs-flat case those modules
already prove out.

NAME-BASED LVS MATCHING: WHY EVERY NET THIS MODULE ROUTES IS LABELLED
-------------------------------------------------------------------------
Flattening the reference alone was still not enough. **Confirmed
empirically**: two independent ``div23_cell`` instances, chained with no
glue logic at all, LVS-match cleanly; the same construction extended to six
chained instances (still with no glue logic) reproduces this block's own
full-design LVS mismatch, though DRC stays clean throughout. This isolates
the cause to gf180mcu's LVS comparer's own topology-only graph-matching: six
structurally identical macro copies (each already containing some internal
repetition of its own -- two ``nand2_3v3``, two ``inv_3v3``, two
``dff_tg_3v3`` instances) is enough symmetric structure that the comparer
cannot always find the correct correspondence from connectivity alone, even
though (independently confirmed by probing the reference netlist's own net
terminal lists) the connectivity itself is correct on both sides. This is a
real limitation of the comparer on a highly repetitive design, not a design
defect -- and not a `klt` (klayout-tools) gap either, since it is gf180mcu's
LVS deck driving KLayout's own native ``NetlistComparer`` directly, not
`klt`, per this repo's friction protocol (CLAUDE.md) naming `klt` gaps
specifically.

The fix: give the comparer's own name-based hint matching enough to work
with. ``div23_cell.py``'s own ``Div23Layout.pins`` only labels its 7
boundary nets, and this module previously only labelled its own 17 official
``BOUNDARY_NETS`` the same way -- leaving every glue-level/chain net this
module itself routes (``CK1``..``CK6``, ``MI0``..``MI4``, ``MO0``..``MO5``,
``T0``..``T5``, ``MA``, ``MB``, ``NMI0``..``NMI4``, ``DIVOUTB``, ``FBB``)
unlabelled and therefore anonymous to the comparer, with nothing to
distinguish, say, instance 2's own ``MI2`` from instance 3's own ``MI3``
beyond position in the overall graph. :func:`build` now labels *every* net
in its own ``nets`` dict, not just the 17 official ports -- each with the
exact same name :func:`reference_netlist` already gives it, since both are
derived from the same tables (:data:`_DIV23_NET_MAP`, :data:`_NOR_SPECS`,
etc.). That anchors every one of the six ``div23_cell`` instances' own
boundary uniquely by name, which is sufficient: each instance's own
*internal-only* nets (``SB``, ``DQN``, ``Q``, ``QB``, ``NMO``, ``DMO``,
``MOB``, and each of its two ``dff_tg_3v3``'s own six internal nets) stay
unlabelled -- exactly as they were in ``div23_cell.py``'s own standalone,
independently-LVS-clean build -- because once an instance's own boundary is
correctly anchored, resolving its own 60-device interior is the same
bounded, already-proven-tractable problem that build already solves on its
own, not a new one this module reopens.

This module's own re-labeling of every routed net is a *different*
mitigation than ``_canvas.Canvas.clear_inherited_labels()`` (issue #440,
extended to every read-GDS-and-flatten composition site including this one
by issue #453): re-labeling supplies the comparer's name-based hint
matching with a name for every net (the problem this section is about), it
does not by itself remove the six ``div23_cell`` instances' own stray
*inherited* local-named texts (``CKIN``/``MODIN``/``P``/``CKOUT``/
``MODOUT``/``VDD``/``VSS``, each repeated once per instance) that flattening
those instances in also carries into this cell. :func:`build` calls
``clear_inherited_labels()`` immediately after its own ``flatten()`` and
before this labeling loop for exactly that reason -- both mitigations are
needed, each for a different half of the same underlying risk.
"""

from __future__ import annotations

import tempfile
from collections.abc import Callable
from dataclasses import dataclass, field
from pathlib import Path

from . import devgen, dff_tg_3v3, div23_cell, inv2x_3v3, inv_3v3, nand2_3v3, nand3_3v3, nor2_3v3
from .devgen import (
    Canvas,
    offset_pad_x,
    pack_tracks_over_devices,
    pad_center,
    route_net,
    route_spine,
    well_tap,
)

TOP_CELL = "divider_chain"

#: This block's own top-level I/O (``design/divider_chain.sch``'s subckt
#: ports), per ``design/netlist/divider_chain.spice``'s own
#: ``.subckt divider_chain VCO P0 .. P5 SEL0 .. SEL5 DIVOUT FB VDD_DIV VSS``
#: header.
BOUNDARY_NETS: tuple[str, ...] = (
    "VCO",
    "P0", "P1", "P2", "P3", "P4", "P5",
    "SEL0", "SEL1", "SEL2", "SEL3", "SEL4", "SEL5",
    "DIVOUT", "FB",
    "VDD_DIV", "VSS",
)

#: Per-instance global net mapping for the six ``div23_cell`` copies
#: (``XD0``..``XD5``), read straight off
#: ``design/netlist/divider_chain.spice``'s own X-instance list:
#:
#:     XD0 VCO MI0 P0 CK1 MO0 VDD_DIV VSS div23_cell
#:     XD1 CK1 MI1 P1 CK2 MO1 VDD_DIV VSS div23_cell
#:     XD2 CK2 MI2 P2 CK3 MO2 VDD_DIV VSS div23_cell
#:     XD3 CK3 MI3 P3 CK4 MO3 VDD_DIV VSS div23_cell
#:     XD4 CK4 MI4 P4 CK5 MO4 VDD_DIV VSS div23_cell
#:     XD5 CK5 SEL5 P5 CK6 MO5 VDD_DIV VSS div23_cell
#:
#: ``VDD``/``VSS`` are handled uniformly for every instance (see
#: :func:`build`), not repeated in this table.
_DIV23_NET_MAP: tuple[dict[str, str], ...] = (
    {"CKIN": "VCO", "MODIN": "MI0", "P": "P0", "CKOUT": "CK1", "MODOUT": "MO0"},
    {"CKIN": "CK1", "MODIN": "MI1", "P": "P1", "CKOUT": "CK2", "MODOUT": "MO1"},
    {"CKIN": "CK2", "MODIN": "MI2", "P": "P2", "CKOUT": "CK3", "MODOUT": "MO2"},
    {"CKIN": "CK3", "MODIN": "MI3", "P": "P3", "CKOUT": "CK4", "MODOUT": "MO3"},
    {"CKIN": "CK4", "MODIN": "MI4", "P": "P4", "CKOUT": "CK5", "MODOUT": "MO4"},
    {"CKIN": "CK5", "MODIN": "SEL5", "P": "P5", "CKOUT": "CK6", "MODOUT": "MO5"},
)

#: Horizontal clearance between two adjacent ``div23_cell`` instances' own
#: drawn extents.
#:
#: Headroom past NW.2b's ~1.4 um min nwell-to-nwell spacing (see
#: ``vco/block.py``'s own citation of the same rule). #310 set this to 20 um
#: on the reasoning that "each instance's own nwell already reaches close to
#: its footprint's own edge"; issue #344 re-derived it against the drawn cell
#: instead, because with the block folded (:data:`ROW_PLAN`) each row pays
#: this gap several times over and the block's own width is the axis the fold
#: is trying to reduce:
#:
#: * ``div23_cell``'s nwell spans x = -0.5 .. 329.3 inside a footprint of
#:   -2.62 .. 329.52, i.e. it is inset 2.12 um from the instance box's own
#:   left edge and 0.22 um from its right -- so two abutted instances G um
#:   apart have G + 2.34 um between their nwells. At G = 6 that is 8.34 um,
#:   ~6x NW.2b's minimum.
#: * The tightest rule at this boundary is therefore not the well spacing at
#:   all but plain same-layer metal spacing: Metal1/2/3 *do* reach the
#:   instance box's own edge, so two instances G apart have G um of
#:   metal-to-metal clearance, against M1.2a/M2.2a/M3.2a's 0.23-0.28 um.
#: * DF.16_LV (nwell to nmos comp, 0.43 um min) is likewise slack: the
#:   neighbour's own leftmost nfet comp is a further 2.62 um in.
#:
#: 6 um keeps at least an order of magnitude of headroom on every one of
#: those, and is signed off the only way that counts -- the assembled block
#: at this value is DRC-clean on the PDK's own deck (see
#: ``layout/evidence/divider-chain-layout/PROOF-fold.md``).
DIV23_GAP_X_UM = 6.0

#: Horizontal clearance between a ``div23_cell`` instance's own drawn extent
#: and an adjacent glue-logic column -- same rationale/value as
#: :data:`DIV23_GAP_X_UM`, with the glue side even slacker (a glue run's own
#: nwell is drawn by :func:`devgen.nwell_over` around its pfet comps only,
#: which start well inside the run's own first column).
GLUE_GAP_X_UM = 6.0

#: Vertical clearance from one row's own topmost drawn shape (its Metal2
#: track band's top edge, or its own content top if every track fell below
#: it) to the next row up's own bottom-most drawn shape -- see the module
#: docstring's "FOLDING THE ROW" section. Nothing overlaps across this gap: a
#: row's band is Metal2/Metal3 only and the next row's own bottom is device
#: geometry (comp/implant) plus its own Metal1/2/3 fabric, so the only rule
#: in play is same-layer Metal2/Metal3 spacing (M2.2a/M3.2a, 0.28 um min).
#:
#: Deliberately left at 3.0 um by issue #458, which removed the *other* blanket
#: 3.0 um margin this module used to carry (the band base gap, now computed
#: per net against the real Metal2 obstacle map -- see the module docstring's
#: "ROUTING OVER THE DEVICE ROWS" section). This one stays a flat, generous
#: number on purpose: every track a row assigns is bounded below by that row's
#: own baseline, so no track is ever placed *into* this gap and nothing here
#: is obstacle-checked. It is the one clearance in this module that no
#: computed check backs up, so it keeps its full ~10x headroom.
ROW_GAP_Y_UM = 3.0

#: Left-hand spine (see the module docstring's "CROSS-ROW NETS" section):
#: clearance from every row's own left edge (x = 0) to the *rightmost* spine
#: column, and the x pitch between two adjacent spine columns. Each spine
#: column is a Metal3 run 0.34 um wide with 0.44 um Via2 landing squares, so a
#: 1.0 um pitch leaves 0.56 um between two neighbours' widest drawn shapes --
#: comfortably over M3.2a's 0.28 um minimum Metal3 spacing, and the same
#: order of headroom :data:`devgen.METAL2_TRACK_PITCH_UM` leaves between two
#: Metal2 tracks.
SPINE_GAP_X_UM = 3.0
SPINE_PITCH_UM = 1.0

#: Reused unchanged from ``div23_cell.py`` -- the same leaf-cell family, same
#: proven-DRC-clean net-offset/tap geometry (see that module's own
#: docstring's "NET-COLLISION FIX" section for the full derivation).
NET_OFFSET_STEP_UM = div23_cell.NET_OFFSET_STEP_UM
GATE_REF_DX_UM = div23_cell.GATE_REF_DX_UM
CHANNEL_REF_DX_UM = div23_cell.CHANNEL_REF_DX_UM
TAP_LEFT_MARGIN_UM = div23_cell.TAP_LEFT_MARGIN_UM
TAP_OFFSET_UM = div23_cell.TAP_OFFSET_UM
PTAP_Y0_UM = div23_cell.PTAP_Y0_UM
NTAP_Y0_UM = div23_cell.NTAP_Y0_UM
COLUMN_CLEAR_GAP_UM = div23_cell.COLUMN_CLEAR_GAP_UM

#: Reused private helpers from ``div23_cell.py`` -- same package, same
#: leaf-cell family, deliberately not duplicated (unlike the *constants*
#: above, which this module also could have re-derived, these are enough
#: logic that duplicating them would be a real drift risk for no benefit).
_leaf_columns = div23_cell._leaf_columns
_split_branches = div23_cell._split_branches
_dff_columns = div23_cell._dff_columns
_draw_branch = div23_cell._draw_branch

_Placement = tuple[devgen.Column, dict[str, str]]

#: XNR0..XNR4 / XIV0..XIV4 -- modulus-in feedback chain. Shared between
#: :func:`_glue_placements` (physical layout) and :func:`reference_netlist`
#: (flattened LVS reference generation) so the two can never drift apart.
_NOR_SPECS: tuple[tuple[str, str, str, str], ...] = (
    ("XNR0", "MO1", "SEL0", "NMI0"),
    ("XNR1", "MO2", "SEL1", "NMI1"),
    ("XNR2", "MO3", "SEL2", "NMI2"),
    ("XNR3", "MO4", "SEL3", "NMI3"),
    ("XNR4", "MO5", "SEL4", "NMI4"),
)
_INV_SPECS: tuple[tuple[str, str, str], ...] = (
    ("XIV0", "NMI0", "MI0"),
    ("XIV1", "NMI1", "MI1"),
    ("XIV2", "NMI2", "MI2"),
    ("XIV3", "NMI3", "MI3"),
    ("XIV4", "NMI4", "MI4"),
)
#: XM0..XM5 -- one-hot AND-gate first stage.
_NAND2_SPECS: tuple[tuple[str, str, str, str], ...] = (
    ("XM0", "CK1", "SEL0", "T0"),
    ("XM1", "CK2", "SEL1", "T1"),
    ("XM2", "CK3", "SEL2", "T2"),
    ("XM3", "CK4", "SEL3", "T3"),
    ("XM4", "CK5", "SEL4", "T4"),
    ("XM5", "CK6", "SEL5", "T5"),
)


def _stage_columns(i: int) -> list[_Placement]:
    """The glue columns belonging to divider stage ``i`` -- ``XNR_i``/``XIV_i``
    (the modulus-in feedback pair, 3 columns) plus ``XM_i`` (that stage's own
    one-hot AND first stage, 2 columns).

    Grouped *by stage* rather than by gate type (which is how
    ``design/netlist/divider_chain.spice``'s own X-instance list, and this
    module's own :func:`reference_netlist`, order them) purely for
    **placement**: every net in stage ``i``'s group has its other end on
    ``XD_i`` or ``XD_{i+1}``, so keeping the group physically next to those
    instances is what keeps this block's own top-level nets short -- and a
    net's own drawn extent is exactly what decides how many Metal2 tracks
    :func:`devgen.pack_tracks` has to open (issue #341). Placement order has
    no electrical meaning at all: the reference netlist is generated from the
    same ``_NOR_SPECS``/``_INV_SPECS``/``_NAND2_SPECS`` tables independently
    of it.

    Stage 5 is the odd one out: ``XD5``'s own ``MODIN`` is driven directly by
    the block port ``SEL5`` (see :data:`_DIV23_NET_MAP`), so there is no
    ``XNR5``/``XIV5`` pair -- only ``XM5``.
    """
    result: list[_Placement] = []
    if i < len(_NOR_SPECS):
        nname, a, b, y = _NOR_SPECS[i]
        _iname, ia, iy = _INV_SPECS[i]
        result += _leaf_columns(
            nor2_3v3.COLUMNS, {"A": a, "B": b, "Y": y, "VDD": "VDD_DIV", "VSS": "VSS", "PMID": f"{nname}_PMID"}
        )
        result.append((_split_branches(inv_3v3.INV_DEVICES), {"A": ia, "Y": iy, "VDD": "VDD_DIV", "VSS": "VSS"}))

    name, a, b, y = _NAND2_SPECS[i]
    result += _leaf_columns(
        nand2_3v3.COLUMNS, {"A": a, "B": b, "Y": y, "VDD": "VDD_DIV", "VSS": "VSS", "NMID": f"{name}_NMID"}
    )
    return result


def _nand3_columns(name: str, a: str, b: str, c: str, y: str) -> list[_Placement]:
    """One ``nand3_3v3`` one-hot AND second stage (``XMA`` or ``XMB``) -- 3
    columns.

    Its own group rather than half of a single "output stage" group because
    ``XMA`` and ``XMB`` between them consume all six ``T0``..``T5`` one-hot
    terms: placing each next to the three stages that produce its own three
    terms keeps all six of those nets inside one row, where a single shared
    ``MUX`` group would leave three of them crossing a row boundary (and a
    cross-row net costs a Metal2 track in *every* row it appears in, plus its
    own spine column -- see :func:`spine_columns`).
    """
    return _leaf_columns(
        nand3_3v3.COLUMNS,
        {"A": a, "B": b, "C": c, "Y": y, "VDD": "VDD_DIV", "VSS": "VSS", "NM1": f"{name}_NM1", "NM2": f"{name}_NM2"},
    )


def _out_columns() -> list[_Placement]:
    """``XMNO``/``XIDO`` -- the one-hot mux output stage, 3 columns."""
    result: list[_Placement] = []
    result += _leaf_columns(
        nor2_3v3.COLUMNS, {"A": "MA", "B": "MB", "Y": "DIVOUTB", "VDD": "VDD_DIV", "VSS": "VSS", "PMID": "XMNO_PMID"}
    )
    result += _leaf_columns(inv2x_3v3.COLUMNS, {"A": "DIVOUTB", "Y": "DIVOUT", "VDD": "VDD_DIV", "VSS": "VSS"})
    return result


def _frt_columns() -> list[_Placement]:
    """``XFRT`` -- the divider-retiming flop (Part 3's ``dff_tg_3v3``, issue
    #308), 10 columns.
    """
    return _dff_columns(
        "XFRT", {"D": "DIVOUT", "CK": "VCO", "Q": "FB", "QB": "FBB", "VDD": "VDD_DIV", "VSS": "VSS"}
    )


#: Every glue-logic group by name -- the placement unit :data:`ROW_PLAN`
#: refers to. ``S0``..``S5`` are the per-stage groups (:func:`_stage_columns`),
#: ``MA``/``MB`` the two one-hot AND second stages, ``OUT`` the mux output
#: stage, ``FRT`` the retiming flop. 5x5 + 2 + 3 + 3 + 3 + 10 = 46 columns, 92
#: transistors -- the same set (never a different one) this block's glue logic
#: has always been.
GLUE_GROUPS: tuple[str, ...] = ("S0", "S1", "S2", "S3", "S4", "S5", "MA", "MB", "OUT", "FRT")


def _glue_group(name: str) -> list[_Placement]:
    if name == "MA":
        return _nand3_columns("XMA", "T0", "T1", "T2", "MA")
    if name == "MB":
        return _nand3_columns("XMB", "T3", "T4", "T5", "MB")
    if name == "OUT":
        return _out_columns()
    if name == "FRT":
        return _frt_columns()
    return _stage_columns(int(name[1:]))


def _glue_placements() -> list[_Placement]:
    """All 46 columns (92 transistors) of termination/one-hot-mux glue logic
    -- see module docstring's "GLUE LOGIC" section.

    Kept as one flat list (in :data:`GLUE_GROUPS` order) for the device-count
    checks that do not care where a column is placed; :func:`build` itself
    walks :data:`ROW_PLAN` group by group instead.
    """
    result: list[_Placement] = []
    for name in GLUE_GROUPS:
        result += _glue_group(name)
    return result


#: How this block's content is folded into rows (issue #344) -- see the module
#: docstring's "FOLDING THE ROW" section for the derivation.
#:
#: One entry per row, bottom row first; each row is an ordered left-to-right
#: sequence of placement items, where ``("div23", i)`` is the i-th
#: ``div23_cell`` instance (``XD<i>``, per :data:`_DIV23_NET_MAP`) and
#: ``("glue", name)`` is one :data:`GLUE_GROUPS` entry. Every instance must
#: appear exactly once and every glue group exactly once -- checked by
#: ``layout/tests/test_divider_chain.py``, since a typo here would silently
#: drop devices the DRC deck alone would never notice.
ROW_PLAN: tuple[tuple[tuple[str, object], ...], ...] = (
    (
        ("glue", "OUT"),
        ("div23", 0), ("glue", "S0"),
        ("div23", 1), ("glue", "S1"),
        ("div23", 2), ("glue", "S2"),
        ("glue", "MA"),
    ),
    (
        ("glue", "FRT"),
        ("div23", 3), ("glue", "S3"),
        ("div23", 4), ("glue", "S4"),
        ("div23", 5), ("glue", "S5"),
        ("glue", "MB"),
    ),
)


def _row_nets() -> tuple[set[str], ...]:
    """The set of net names each :data:`ROW_PLAN` row touches -- derived from
    the same tables :func:`build` and :func:`reference_netlist` both use, with
    no geometry involved, so the cross-row net set (and therefore the spine's
    own width) is known before anything is drawn.
    """
    rows: list[set[str]] = []
    for plan in ROW_PLAN:
        here: set[str] = set()
        for kind, key in plan:
            if kind == "div23":
                net_map = _DIV23_NET_MAP[int(key)]
                here.update(net_map.values())
                here.update(("VDD_DIV", "VSS"))
            else:
                for col, port_map in _glue_group(str(key)):
                    for d in col.pulldown + col.pullup:
                        here.update(port_map[n] for n in (d.gate_net, d.top_net, d.bottom_net))
                    # every column carries its own VDD_DIV/VSS tap pair
                    here.update(("VDD_DIV", "VSS"))
        rows.append(here)
    return tuple(rows)


def spine_columns() -> dict[str, float]:
    """The x of every cross-row net's own vertical Metal3 spine column.

    A net whose pads live in more than one :data:`ROW_PLAN` row gets a
    separate packed Metal2 bus per row (:func:`devgen.pack_tracks` runs
    independently per row), and those buses have to be tied together --
    :func:`devgen.route_spine` draws that tie as one vertical Metal3 run at
    the x this function reserves for the net.

    The spine sits at **negative x**, left of every row's own content (which
    always starts at x = 0), one column per cross-row net at
    :data:`SPINE_PITCH_UM` pitch, nearest column :data:`SPINE_GAP_X_UM` from
    the rows' own left edge. Left rather than right on purpose: a left-hand
    spine's x positions depend only on *how many* nets cross a row boundary
    -- pure table data, available before any geometry exists -- whereas a
    right-hand spine's would depend on the widest row's own drawn width,
    which is not known until the glue columns have been drawn, which cannot
    happen until each row's own y placement is known, which needs each row's
    own track count, which needs the spine. Anchoring at x = 0 cuts that
    circularity instead of resolving it with a throwaway measurement pass.
    """
    rows = _row_nets()
    crossing = sorted({net for net in set().union(*rows) if sum(net in r for r in rows) > 1})
    return {net: -(SPINE_GAP_X_UM + i * SPINE_PITCH_UM) for i, net in enumerate(crossing)}


def _rename_token(token: str, prefix: str, port_map: dict[str, str]) -> str:
    """One SPICE-line token, renamed for one flattened instance -- see
    :func:`_instance_body`'s own docstring.
    """
    if token in port_map:
        return port_map[token]
    if "_03v3" in token or "=" in token:
        return token  # PDK model name (pfet_03v3/nfet_03v3) or a W=/L=/... parameter
    return f"{prefix}_{token}"


def _rename_line(line: str, prefix: str, port_map: dict[str, str]) -> str:
    tokens = line.split()
    device_name, *rest = tokens
    renamed_device = f"M_{prefix}_{device_name[2:]}" if device_name.startswith("M_") else device_name
    return " ".join([renamed_device] + [_rename_token(t, prefix, port_map) for t in rest])


def _instance_body(ref_text: str, prefix: str, port_map: dict[str, str]) -> str:
    """Flatten one standalone leaf/composite module's own
    ``reference_netlist()`` text into ``prefix``-qualified ``M`` lines, for
    reuse inside this block's own flattened reference netlist -- see module
    docstring's "REFERENCE NETLIST" section for why this block's own
    reference is the pre-existing ``design/netlist/divider_chain.spice``, not
    a fresh hand-written one, and why that reference still needs to be a
    *flat* ``M``-line list here rather than reusable as literal text: gf180mcu's
    LVS deck (``align``) does not flatten a hierarchical schematic to match a
    flat layout on its own (confirmed empirically: comparing this block's
    flat GDS directly against the hierarchical
    ``design/netlist/divider_chain.spice`` produced total mismatch -- every
    net and device unmatched -- because the deck's ``align`` step only
    corresponds circuits by name, and this block's GDS has none once
    flattened). Flattening this reference the same way keeps the *content*
    independently derived from ``design/netlist/divider_chain.spice`` (every
    device/size/connection below is that generated file's own, only
    re-expressed flat) while making the comparison the same flat-vs-flat
    case ``div23_cell.py``/``dff_tg_3v3.py`` already prove out.

    Every net named in ``port_map`` (that leaf/composite's own subckt ports,
    including ``VDD``/``VSS``) is translated to this block's own global net
    name; every other token that is not a PDK model name or a ``KEY=value``
    parameter is a net local to that one standalone reference (e.g.
    ``nor2_3v3``'s own internal ``PMID``) and gets ``prefix_``-qualified so
    multiple instances of the same leaf cell stay electrically distinct once
    flattened together. Device names (``M_...``) are always ``prefix_``-
    qualified, for the same reason.
    """
    lines = [line for line in ref_text.splitlines() if line.startswith("M_")]
    return "\n".join(_rename_line(line, prefix, port_map) for line in lines) + "\n"


def reference_netlist() -> str:
    """This block's own flattened LVS reference netlist -- see
    :func:`_instance_body`'s docstring for why this is a flattened
    re-expression of ``design/netlist/divider_chain.spice`` (the real
    Acceptance-Criteria reference) rather than an independently hand-derived
    netlist: every device/connection below traces directly to that
    generated file's own ``.subckt`` bodies (``div23_cell``, ``nor2_3v3``,
    ``inv_3v3``, ``nand2_3v3``, ``nand3_3v3``, ``inv2x_3v3``,
    ``dff_tg_3v3``), each already independently stated by its own module's
    ``reference_netlist()`` (which this function reuses, unmodified, as the
    per-instance source text) -- not re-derived here.
    """
    body = ""

    for i in range(6):
        net_map = _DIV23_NET_MAP[i]
        port_map = {
            "CKIN": net_map["CKIN"],
            "MODIN": net_map["MODIN"],
            "P": net_map["P"],
            "CKOUT": net_map["CKOUT"],
            "MODOUT": net_map["MODOUT"],
            "VDD": "VDD_DIV",
            "VSS": "VSS",
        }
        body += _instance_body(div23_cell.reference_netlist(), f"XD{i}", port_map)

    for (nname, a, b, y), (_iname, ia, iy) in zip(_NOR_SPECS, _INV_SPECS):
        body += _instance_body(
            nor2_3v3.reference_netlist(), nname, {"A": a, "B": b, "Y": y, "VDD": "VDD_DIV", "VSS": "VSS"}
        )
        body += _instance_body(
            inv_3v3.reference_netlist(), _iname, {"A": ia, "Y": iy, "VDD": "VDD_DIV", "VSS": "VSS"}
        )

    for name, a, b, y in _NAND2_SPECS:
        body += _instance_body(
            nand2_3v3.reference_netlist(), name, {"A": a, "B": b, "Y": y, "VDD": "VDD_DIV", "VSS": "VSS"}
        )

    body += _instance_body(
        nand3_3v3.reference_netlist(),
        "XMA",
        {"A": "T0", "B": "T1", "C": "T2", "Y": "MA", "VDD": "VDD_DIV", "VSS": "VSS"},
    )
    body += _instance_body(
        nand3_3v3.reference_netlist(),
        "XMB",
        {"A": "T3", "B": "T4", "C": "T5", "Y": "MB", "VDD": "VDD_DIV", "VSS": "VSS"},
    )
    body += _instance_body(
        nor2_3v3.reference_netlist(),
        "XMNO",
        {"A": "MA", "B": "MB", "Y": "DIVOUTB", "VDD": "VDD_DIV", "VSS": "VSS"},
    )
    body += _instance_body(
        inv2x_3v3.reference_netlist(),
        "XIDO",
        {"A": "DIVOUTB", "Y": "DIVOUT", "VDD": "VDD_DIV", "VSS": "VSS"},
    )
    body += _instance_body(
        dff_tg_3v3.reference_netlist(),
        "XFRT",
        {"D": "DIVOUT", "CK": "VCO", "Q": "FB", "QB": "FBB", "VDD": "VDD_DIV", "VSS": "VSS"},
    )

    ports = " ".join(BOUNDARY_NETS)
    return (
        "* Reference schematic for divider_chain (issue #310).\n"
        "*\n"
        "* Flattened re-expression of design/netlist/divider_chain.spice (the\n"
        "* Acceptance-Criteria reference netlist, generated by design/netlist.sh\n"
        "* from design/divider_chain.sch) -- see divider_chain.py's own\n"
        "* _instance_body() docstring for why a flat re-expression rather than\n"
        "* that file's own hierarchical text: gf180mcu's LVS deck does not\n"
        "* flatten a hierarchical schematic to match this block's flat GDS on\n"
        "* its own. Every device/connection below traces to that generated\n"
        "* file's own subckt bodies (div23_cell, nor2_3v3, inv_3v3, nand2_3v3,\n"
        "* nand3_3v3, inv2x_3v3, dff_tg_3v3), via each of those modules' own\n"
        "* independently-stated reference_netlist().\n"
        "*\n"
        "* Run LVS with --lvs_sub=VSS (layout/run_pv.py's own default): the NMOS\n"
        "* body ties to the deck's synthesized global substrate net, which this\n"
        "* flag names VSS -- see layout/README.md's \"substrate-net gotcha\".\n"
        "\n"
        f".subckt {TOP_CELL} {ports}\n"
        f"{body}"
        ".ends\n"
    )


@dataclass
class DividerChainLayout:
    canvas: Canvas
    footprint: tuple[float, float, float, float]
    pins: dict[str, tuple[float, float]] = field(default_factory=dict)
    #: The as-placed lower-left corner of every ``div23_cell`` instance's own
    #: drawn bounding box, in ``XD0``..``XD5`` order -- what
    #: ``layout/tests/test_divider_chain.py`` clips its six comparison windows
    #: out of. Recorded rather than re-derived from a placement pitch, because
    #: after issue #344's fold the six instances no longer sit on one uniform
    #: step (see :data:`ROW_PLAN`).
    div23_boxes: tuple[tuple[float, float, float, float], ...] = ()
    #: Per-row (bottom row first) drawn extent of the assembled block, purely
    #: as a record for the evidence/tests -- ``(y_bottom, y_band_top, x_right)``.
    rows: tuple[tuple[float, float, float], ...] = ()

    def write_gds(self, path) -> None:
        self.canvas.write_gds(path)


def _draw_glue_column(
    canvas: Canvas,
    col: devgen.Column,
    port_map: dict[str, str],
    x_cursor: float,
    row_y: float,
    add: Callable[[str, tuple[float, float]], None],
    pfet_boxes: list[tuple[float, float, float, float]],
) -> float:
    """Draw one glue-logic column at ``x_cursor``, with its own row-cell frame
    lifted by ``row_y``, and return the next column's own ``x_cursor``.

    Byte-for-byte the per-column body :func:`build` ran inline before issue
    #344's fold -- the *only* change is that every fixed row-cell frame
    y-coordinate (:data:`devgen.ROW_PD_Y0`/:data:`devgen.ROW_PU_Y0` and the
    two tap rows) is offset by this column's own row baseline, so the same
    proven-DRC-clean column geometry can be drawn in any of the block's rows
    rather than only in the single row at y = 0.
    """
    devices = col.pulldown + col.pullup
    pd_ports = _draw_branch(canvas, col.pulldown, x_cursor, devgen.ROW_PD_Y0 + row_y)
    pu_ports = _draw_branch(canvas, col.pullup, x_cursor, devgen.ROW_PU_Y0 + row_y)
    ports = pd_ports + pu_ports

    for p in ports:
        if p.kind == "pfet":
            pfet_boxes.append((p.x0, p.y0, p.x1, p.y3))

    roles: dict[str, list[tuple[str, tuple[float, float, float, float]]]] = {"gate": [], "channel": []}
    for d, p in zip(devices, ports):
        roles["gate"].append((port_map[d.gate_net], p.gate_pad))
        roles["channel"].append((port_map[d.top_net], p.top_pad))
        roles["channel"].append((port_map[d.bottom_net], p.bottom_pad))
    role_reference = {"gate": x_cursor + GATE_REF_DX_UM, "channel": x_cursor + CHANNEL_REF_DX_UM}
    channel_max_reach = x_cursor
    for role, items in roles.items():
        if not items:
            continue
        reference_x = role_reference[role]
        nets_here = sorted({n for n, _ in items})
        n = len(nets_here)
        role_offsets = {net: (idx - (n - 1) / 2.0) * NET_OFFSET_STEP_UM for idx, net in enumerate(nets_here)}
        if role == "channel":
            channel_max_reach = reference_x + max(role_offsets.values())
        for net, pad in items:
            target_dx = reference_x + role_offsets[net] - pad_center(pad)[0]
            point = pad_center(pad) if target_dx == 0.0 else offset_pad_x(canvas, pad, target_dx)
            add(net, point)

    col_right = max([p.x1 for p in ports] + [channel_max_reach], default=x_cursor)
    half_tap = devgen.TAP_SIZE_UM / 2.0
    gx = col_right + TAP_LEFT_MARGIN_UM
    ntap_pad = well_tap(canvas, "n", gx - half_tap, NTAP_Y0_UM + row_y, "VDD_DIV")
    add("VDD_DIV", pad_center(ntap_pad))
    pfet_boxes.append((gx - half_tap, NTAP_Y0_UM + row_y, gx + half_tap, NTAP_Y0_UM + row_y + devgen.TAP_SIZE_UM))
    ptap_pad = well_tap(canvas, "p", gx - half_tap, PTAP_Y0_UM + row_y, "VSS")
    add("VSS", offset_pad_x(canvas, ptap_pad, TAP_OFFSET_UM))

    return col_right + COLUMN_CLEAR_GAP_UM


def build(outdir: Path | None = None) -> DividerChainLayout:
    import klayout.db as db  # noqa: PLC0415 -- lazy, same convention as every module in this package

    # --- six identical div23_cell instances, GDS-level placement -- see
    # module docstring's "SIX IDENTICAL div23_cell INSTANCES" section. ---
    div23 = div23_cell.build()
    div23_w = div23.footprint[2] - div23.footprint[0]
    div23_h = div23.footprint[3] - div23.footprint[1]
    base_dx = -div23.footprint[0]
    base_dy = -div23.footprint[1]

    canvas = Canvas(TOP_CELL)

    with tempfile.TemporaryDirectory() as tmp:
        div23_gds = Path(tmp) / "div23_cell.gds"
        div23.write_gds(div23_gds)
        canvas.layout.read(str(div23_gds))
    div23_index = canvas.layout.cell_by_name("div23_cell")
    dbu_per_um = int(round(1.0 / canvas.dbu))

    # Every net that crosses a ROW_PLAN row boundary gets its own reserved
    # vertical Metal3 column at negative x -- known up front, from the net
    # tables alone (see spine_columns()).
    spine_x = spine_columns()

    nets: dict[str, list[tuple[float, float]]] = {}
    div23_boxes: list[tuple[float, float, float, float] | None] = [None] * 6
    rows: list[tuple[float, float, float]] = []
    row_tracks: list[dict[str, float]] = []

    row_y = 0.0
    for plan in ROW_PLAN:
        row_nets: dict[str, list[tuple[float, float]]] = {}

        def _add(net: str, point: tuple[float, float], _row_nets=row_nets) -> None:
            _row_nets.setdefault(net, []).append(point)

        x_cursor = 0.0
        content_top = row_y
        pfet_boxes: list[tuple[float, float, float, float]] = []
        previous: str | None = None

        for kind, key in plan:
            # Two adjacent glue columns keep their own COLUMN_CLEAR_GAP_UM
            # (already applied by _draw_glue_column); any boundary involving a
            # div23_cell instance gets that instance's own clearance instead.
            if previous is not None and "div23" in (kind, previous):
                x_cursor += DIV23_GAP_X_UM if previous == kind else GLUE_GAP_X_UM

            if kind == "div23":
                # One nwell per *contiguous run* of glue columns, not one per
                # row: a run is broken by any div23_cell instance next to it,
                # and a single nwell spanning across an instance would swallow
                # that instance's own nfet row.
                if pfet_boxes:
                    content_top = max(content_top, devgen.nwell_over(canvas, pfet_boxes)[3])
                    pfet_boxes = []
                i = int(key)
                dx = x_cursor + base_dx
                dy = row_y + base_dy
                div23_boxes[i] = (x_cursor, row_y, x_cursor + div23_w, row_y + div23_h)
                trans = db.Trans(db.Vector(int(round(dx * dbu_per_um)), int(round(dy * dbu_per_um))))
                canvas.top.insert(db.CellInstArray(div23_index, trans))
                net_map = _DIV23_NET_MAP[i]
                for local, (px, py) in div23.pins.items():
                    if local == "VDD":
                        global_net = "VDD_DIV"
                    elif local == "VSS":
                        global_net = "VSS"
                    else:
                        global_net = net_map[local]
                    _add(global_net, (px + dx, py + dy))
                x_cursor += div23_w
                content_top = max(content_top, row_y + div23_h)
            else:
                # --- glue logic: same flat-composite fabric as div23_cell.py's
                # own build() -- see module docstring's "GLUE LOGIC" section. ---
                for col, port_map in _glue_group(str(key)):
                    x_cursor = _draw_glue_column(canvas, col, port_map, x_cursor, row_y, _add, pfet_boxes)
            previous = kind

        if pfet_boxes:
            content_top = max(content_top, devgen.nwell_over(canvas, pfet_boxes)[3])

        # --- this row's own packed, obstacle-aware track assignment -- see
        # devgen.py's "track reuse" section (issue #341) for why one track_y is
        # reused across every net whose drawn extent does not collide, its
        # "routing *into* the plane over the device rows" section (issue #458)
        # for why a track is placed at the lowest Metal2-free y rather than in
        # a band stacked above the row, and the module docstring's "FOLDING THE
        # ROW" section (issue #344) for why each row gets its own independent
        # pass rather than one band for the block. ---
        extent_pads = {
            net: (pads + [(spine_x[net], row_y)] if net in spine_x else pads)
            for net, pads in row_nets.items()
        }
        obstacles = devgen.metal2_boxes(canvas)
        for pads in row_nets.values():
            obstacles += devgen.riser_landing_boxes(pads)
        track_y = pack_tracks_over_devices(extent_pads, y_floor=row_y, obstacles=obstacles)
        for net, pads in row_nets.items():
            route_net(canvas, net, pads, track_y[net], bus_to_x=spine_x.get(net))

        band_top = max(content_top, max(track_y.values()) + devgen.TRACK_HALF_HEIGHT_UM)
        rows.append((row_y, band_top, x_cursor))
        row_tracks.append(track_y)
        for net, pads in row_nets.items():
            nets.setdefault(net, []).extend(pads)
        row_y = band_top + ROW_GAP_Y_UM

    # --- tie each cross-row net's per-row buses together, one vertical Metal3
    # run per net in the left-hand spine -- see spine_columns(). ---
    for net, sx in spine_x.items():
        ys = [tracks[net] for tracks in row_tracks if net in tracks]
        route_spine(canvas, sx, ys)

    # Flatten -- see module docstring for why (harness/cell.py's own
    # precedent: a flat top cell needs no subcircuit correspondence with the
    # (hierarchical) reference netlist during LVS).
    canvas.top.flatten(-1, True)

    # Each of the six div23_cell instances was written for its own
    # standalone LVS claim and labels its own 7 *local* boundary-net names
    # (``CKIN``/``MODIN``/``P``/``CKOUT``/``MODOUT``/``VDD``/``VSS`` --
    # ``div23_cell.BOUNDARY_NETS``) on "metal1_label". Flattening carries all
    # 42 of those label shapes (6 instances x 7 nets, each name repeated
    # identically across instances) into this cell -- the same composition
    # pattern _canvas.Canvas.clear_inherited_labels()'s own docstring
    # describes (issue #440), extended here to this module (issue #453).
    # This block does not go on to mismatch the way pfd_cp's first
    # block-level LVS run did, because the labeling loop immediately below
    # already re-labels *every* net this module routes -- including all six
    # instances' own boundary nets, under this block's own reference-netlist
    # names -- rather than relying on any inherited name (see this module's
    # own "NAME-BASED LVS MATCHING" docstring section). But the six
    # instances' stray local-named texts are still real duplicate labels
    # sitting on this block's nets (the same net gaining a spurious second,
    # colliding name across the six div23_cell copies) until cleared, which
    # is at best inert clutter and at worst the same
    # --lvs_sub-global-net-merge failure #440 fixed, so clear them before
    # this module's own labeling loop draws the names that are actually
    # meant to stick.
    canvas.clear_inherited_labels()

    # Label every net this module itself routes -- not just this block's own
    # 17 official BOUNDARY_NETS -- with its own reference-netlist name. See
    # module docstring's "NAME-BASED LVS MATCHING" section: gf180mcu's LVS
    # comparer cannot disambiguate this design's six structurally-identical
    # div23_cell copies from topology alone (confirmed empirically -- see
    # that section), so every one of this module's own glue-level/chain nets
    # (``CK1``..``CK6``, ``MI0``..``MI4``, ``MO0``..``MO5``, etc., not only
    # this block's external ports) needs its own distinguishing label for the
    # comparer's name-based hint matching to seed a correct match. Only
    # ``div23_cell``'s own *internal-only* nets (its own ``SB``/``DQN``/``Q``/
    # etc., never surfaced to this module's own ``nets`` dict at all) are not
    # covered this way -- see that same docstring section for why that is
    # still sufficient.
    pins: dict[str, tuple[float, float]] = {}
    for net, points in nets.items():
        x, y = points[0]
        canvas.label("metal1_label", net, x, y)
        if net in BOUNDARY_NETS:
            pins[net] = (x, y)

    drawn = canvas.top.bbox()
    dbu = canvas.dbu
    footprint = (
        round(drawn.left * dbu, 6),
        round(drawn.bottom * dbu, 6),
        round(drawn.right * dbu, 6),
        round(drawn.top * dbu, 6),
    )

    layout = DividerChainLayout(
        canvas=canvas,
        footprint=footprint,
        pins=pins,
        div23_boxes=tuple(box for box in div23_boxes if box is not None),
        rows=tuple(rows),
    )
    if outdir is not None:
        outdir = Path(outdir)
        outdir.mkdir(parents=True, exist_ok=True)
        layout.write_gds(outdir / f"{TOP_CELL}.gds")
    return layout


def main() -> int:
    import argparse

    parser = argparse.ArgumentParser(description=__doc__)
    default_outdir = Path(__file__).resolve().parents[2] / "evidence" / "divider-chain-layout" / "work"
    parser.add_argument("--outdir", default=str(default_outdir))
    args = parser.parse_args()
    outdir = Path(args.outdir)
    layout = build(outdir)
    netlist_path = outdir / f"{TOP_CELL}.spice"
    netlist_path.write_text(reference_netlist())
    x0, y0, x1, y1 = layout.footprint
    print(f"wrote {outdir}/{TOP_CELL}.gds")
    print(f"wrote {netlist_path}")
    print("instances : 6 div23_cell + 20 glue-logic gates + 1 dff_tg_3v3 (XFRT)")
    print("devices   : 452 (360 across the six div23_cell instances + 92 glue logic)")
    print(f"rows      : {len(ROW_PLAN)}")
    for r, (y0_row, band_top, x_right) in enumerate(layout.rows):
        print(f"  row {r}: y {y0_row:8.3f} .. {band_top:8.3f}  width {x_right:9.3f} um")
    print(f"footprint : {x1 - x0:.3f} x {y1 - y0:.3f} um  ({(x1 - x0) * (y1 - y0):.1f} um^2)")
    print(f"pins      : {sorted(layout.pins)}")
    for net in BOUNDARY_NETS:
        print(f"  {net:8s} @ {layout.pins[net]}")
    return 0


if __name__ == "__main__":
    raise SystemExit(main())
