2AMLogic/gf180-pll/(commit log)

2026-07-31 docs: add decision-record template with collision-resistant numbering (#20)
    Adapted from 2AMLogic/gf180-bandgap spec/decision-records/TEMPLATE.md at
    commit d40bd5de98e355c93137df0bfd8b46ce43766db4, extended with an explicit
    DR-NNN collision rule (next-unused at merge time, reviewers reject
    duplicates), the DR-NNN stable-ID rule for referencing decisions from
    issues and sim/ evidence, and a cross-reference to the sim/ evidence-record
    supersession house style (#5).
2026-07-31 docs(spec): record PLL loop, VCO cell, and divider architecture as DR-001 (#21)
    Adds spec/decision-records/DR-001-pll-architecture.md, a survey and decision
    record covering the three architecture choices that gate schematic work:
    - Loop type: type-II charge-pump PLL (PFD + CP + passive R/C1/C2 filter),
    fixed filter with a 2-bit Icp trim. Sub-sampling, injection-locked,
    all-digital, active-filter and programmable-filter-bank options are
    dispositioned against the draft targets and the xschem/ngspice evidence path.
    - VCO delay cell: single-ended current-starved CMOS inverter ring, odd stage
    count, 3-bit coarse band select plus a source-degenerated V-to-I fine
    control, on a dedicated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
2026-07-31 docs: ratify draft-spec scope decisions (ref mode, output ceiling, supply flavor, lock detector, jitter claim) (#22)
2026-07-31 sim: characterize gf180mcu devices for VCO delay cell, charge pump, and loop filter (#23)
    * sim: add 3.3 V delay-stage PVT characterization campaign
    Adds sim/lib/simenv.sh, a small raw-ngspice corner-sweep shim (PDK pin,
    provenance header, 45-point PVT grid, parallel deck runner) plus the first
    campaign built on it.
    tb_delay_stage.sp measures a 5-stage self-loaded CMOS ring at 1x and 4x
    sizing, a fan-out-1 inverter chain (tpHL/tpLH separately), and single-device
    drive current, all at one corner setting per run. run.sh sweeps process
    {typical,ff,ss,fs,sf} x temp {-40,27,125} C x supply {2.97,3.30,3.63} V and
    writes results/delay_corners.csv with a provenance header naming the PDK
    hash, ngsp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
    [cap_cv.csv, cap_summary.csv, cp_curves.csv, cp_summary.csv, delay_corners.csv, res_summary.csv, res_tempco.csv]
2026-07-31 feat: design the 5-stage current-starved ring VCO and characterize it over PVT (#25)
    * feat(design): capture 5-stage current-starved ring VCO with 3-bit band select
    xschem schematics for the DR-001 Decision 2 VCO: five current-starved
    inverter stages with matched PMOS-head/NMOS-tail starving devices, a
    constant-gm biased 3-bit band-select mirror chain, and a
    source-degenerated V->I converter for the fine Vctrl input, all on a
    dedicated VDD_VCO/GND_VCO domain with on-chip decoupling.
    Adds design/netlist.sh so the committed SPICE export stays a faithful,
    checkable rendering of the schematics, and the open-loop f(Vctrl)
    corner testbench that consumes it.
    * test(vco): add supply, stage-count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
    [kvco_by_band.csv, kvco_by_point.csv, periods_jit_allmslow_T27_V3p30_B0_C1p8_R16.csv, periods_jit_typical_T27_V3p30_B5_C1p8_R16.csv, stage_count.csv, supply_jitter.csv, supply_pushing.csv, vco.sch]
2026-07-31 feat: add integer-N feedback divider and lock detector with PVT evidence (#27)
    * feat(design): add xschem divide-by-2/3 divider chain and lock detector
    Lands the schematic side of the integer-N feedback divider (DR-001
    Decision 3) and the window-comparator lock detector (DR-002 Decision 4),
    plus the ngspice testbenches and corner runners that verify them.
    design/
    - Eight 3.3 V static-CMOS leaf cells (inverter, 2x inverter, NAND2/3,
    NOR2, XOR2, transmission gate, Schmitt inverter, inverter-chain delay
    window) and a transmission-gate master-slave DFF. nfet_03v3/pfet_03v3
    exclusively, per DR-002 Decision 3.
    - div23_cell: Vaucher-style divide-by-2/3 cell, two flops plus four gates.
    - div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
    [cell_corners.csv, chain_ratio.csv, delaywin_3v3.sch, dff_setup_hold.csv, dff_tg_3v3.sch, div23_cell.sch, divider_chain.sch, inv2x_3v3.sch]
2026-07-31 docs+tooling: add per-block leaf-cell naming convention and a cross-block collision check (#31)
    design/README.md now states a checkable-by-eye ownership convention
    (<block-prefix>_<cellname>) for shared static-CMOS leaf cells, with a
    rationale for choosing it over a shared library or per-block subdirectory.
    design/netlist.sh --check gains check_leaf_cell_collisions: it hashes every
    .subckt ... .ends block across all committed design/netlist/*.spice exports
    and fails loudly, naming the colliding tops and cell, if the same leaf-cell
    name ever hashes differently across two of them -- turning the add/add
    collision two block PRs have now hit (inv_3v3, nand2_3v3 landing with
    different geometries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
2026-07-31 Design the PFD and charge pump, with 45-corner dead-zone and compliance evidence (#26)
    * design: capture the tri-state PFD and charge pump in xschem, with corner testbenches
    Adds the DR-001 Decision 1 phase-detect front end as an xschem hierarchy under
    design/, plus a headless netlist export the sim/ testbenches consume, so the
    simulated netlist IS the schematic rather than a hand-transcribed copy of it.
    - inv_3v3, nand2_3v3, edgedet, srlatch, pfd: tri-state PFD whose shared,
    delay-chain-gated reset is the dead-zone-elimination element. The
    edge-detector chain length is bounded on both sides by gate-delay RATIOS
    (longer than the SR latch loop delay, shorter than the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
    [cp.sch, cp_curves.csv, cp_dc.csv, cp_leg_n.sch, cp_leg_p.sch, cp_switch.csv, dut_export.sch, edgedet.sch]
2026-07-31 fix: make netlist.sh export path-independent, not just --check (#33)
    * fix: strip absolute sch_path/sym_path comments at netlist export time
    design/netlist.sh's export step now applies the existing normalize()
    helper (added by #27 for --check's comparison) to its own written
    output, not just at compare time. Committed netlist bytes no longer
    embed the exporting checkout's absolute path -- only the electrical
    content (device cards, .subckt/.ends blocks, port lists) determines
    whether --check reports staleness.
    Re-exported all 5 committed netlists (vco, dff_tg_3v3, div23_cell,
    divider_chain, lock_detector); every changed line is a sch_path/
    sym_path comment, confirmed via git diff.
    * docs: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
2026-07-31 sim: re-run and re-record 7 evidence records under fixed netlist provenance (#45)
    * sim: make the record Supersedes field settable at mint time
    sim/README.md's supersession rule is one-directional: a superseded record's
    bytes are never edited, so the ONLY pointer between an old record and the one
    replacing it lives in the new record's **Supersedes** field. That field has to
    be written when the record is minted -- patching it into a generated record
    afterwards is the same in-place rewrite the append-only rule forbids.
    Five runners hardcoded "(none -- first record for this claim)" and so had no
    way to supersede anything. #26 solved this for the pfd-deadzone and
    cp-compliance runners with a l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
    [cell_corners.csv, chain_ratio.csv, dff_setup_hold.csv, kvco_by_band.csv, kvco_by_point.csv, lock_corners.csv, periods_jit_allmslow_T27_V3p30_B0_C1p8_R16.csv, periods_jit_typical_T27_V3p30_B5_C1p8_R16.csv]
2026-07-31 Null the charge pump's tail-node charge error with a Vctrl-tracking dump-node buffer (#46)
    * feat: replace the charge pump's fixed dump-node clamp with a Vctrl-tracking buffer
    The charge pump's dominant static-phase error is the tail-node charge
    exchange, not current mismatch: when a steering switch closes, the tail it
    was parked on is dragged from the dump-node voltage to the control-node
    voltage, and that charge comes out of the control node once per reference
    cycle. The residue is proportional to (V_dump - Vctrl), so a FIXED dump
    node nulls it at exactly one control voltage.
    Measured on the pre-change design, the null sits at 1.487 V -- already near
    the centre of the 0.9-2.4 V window -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
    [cp.sch, cp_curves.csv, cp_dc.csv, cp_dumpbuf.sch, cp_switch.csv, pfd_deadzone.csv, pfd_deadzone_verdict.csv]
2026-07-31 feat: design the passive loop filter and corner-sweep its bandwidth/phase margin (#48)
    * Design the passive loop filter and corner-sweep its bandwidth/phase margin
    Adds design/loop_filter.sch/.sym: DR-001 Decision 1's fixed passive
    series-R/shunt-C1/shunt-C2 filter, sized from #4's real devchar-passives
    device data (ppolyf_u for R, body-tied cap_nmos_03v3_b for C1,
    cap_mim_2f0_m2m3_noshield for C2). Completes the sim/loop-dynamics
    corner-matrix campaign (impedance-measurement testbench + an
    independent whole-loop AC cross-check, both already scaffolded by a
    prior partial run): sweeps phase margin and f_c across 27 passive
    corners x 3 temperatures x 5 Vctrl points x all legal (f_ref, N) pair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
    [filter_rc.csv, filter_z.csv, kappa_by_target.csv, loop_ac_crosscheck.csv, loop_filter.sch, loop_margins.csv, loop_margins_by_filter_corner.csv, ripple_tradeoff.csv]
2026-07-31 sim: add mc-cp-mismatch Monte Carlo campaign for charge-pump/PFD device mismatch (#50)
    Confirms gf180mcu's per-instance mismatch model (sw_stat_mismatch, agauss()
    inside nfet_03v3_dss/pfet_03v3_dss, reproducible via .option rndseed at parse
    time) is usable, then runs it: DC and switching-time UP/DN mismatch on `cp`,
    residual charge/static phase offset on the real `pfd_cp` hierarchy, and the
    divider-retiming flop's clk->Q spread, all checked against design/README.md's
    up/down mismatch budget (all terms PASS). Extends sim/lib/simenv.sh with a
    `rndseed` kv special-case and an optional switches-note override, both
    backward-compatible with existing campaigns (verified against
    cp-compliance/pfd-de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
    [mc_cp_dc.csv, mc_cp_switch.csv, mc_dff_ctq.csv, mc_pfd_cp.csv]
2026-07-31 ci: add a two-tier GitHub Actions workflow for the repo's self-checks (#54)
    Wires sim/selftest.sh into a headless `checks` job that runs on every
    push/PR (its sim stage self-skips without ngspice/the gf180mcu PDK, so
    no toolchain install is needed there). Adds a `pdk-checks` job, gated
    to nightly/workflow_dispatch/an opt-in `ci:full` PR label, that
    installs xschem + the PDK via volare and runs design/netlist.sh
    --check[-paths] plus sim/selftest.sh --require-pdk. Rewires
    package.json's placeholder check:ci/check:all/test scripts to the
    same commands the workflow runs (and drops the no-op lint script,
    since no linter is configured in this repo) so local runs match CI.
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2026-07-31 spec: add the v1 target-spec table with corner bindings and the two normative loop rules (#57)
    Creates spec/pll.md, the committed target-spec table. spec/ previously held
    only decision-records/, so the anchors sim/ evidence records already cite
    (spec/pll.md#output-band, #kvco, #supply-sensitivity, #period-jitter,
    #lock-time) were dangling; they now resolve to real sections.
    - 19 rows, each with a mandatory corner-binding entry (or an explicit n/a
    with a reason) and a measured/derived/budget status word.
    - Attaches the DR-003 Decision 4 band-selection rule and the DR-006
    Decision 5 Icp trim-code-per-f_ref rule as normative conditions.
    - Resolves the two evidence-contradicted items: the p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
2026-08-01 layout: bring up klt-aware DRC/LVS flow for gf180mcu, proven on an inverter (#59)
    Establishes a repeatable layout/run_pv.py CLI + harness that resolves the
    gf180mcu PDK, KLayout application binary, and a PV-capable Python, then
    drives the foundry's own DRC/LVS decks (klt itself has no LVS verb yet and
    its gf180mcu DRC deck is a documented curated subset -- see layout/README.md
    "Why this isn't klt drc / a klt lvs"). Proves the flow end-to-end on a
    tapped standard-cell inverter (inv_tb): clean DRC, matching LVS, plus two
    negative controls (an injected DRC violation and an LVS mismatch) so the
    flow is shown to actually detect a dirty result, not just report clean ones.
    Fixes a real import coll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
2026-08-01 sim: add the closed-loop supply-sensitivity and power campaign, with a 9-corner record (#62)
    * feat: assemble design/pll_top.sch as the single closed-loop top level
    Wires the five characterised blocks -- pfd_cp (#9), loop_filter (#10), vco
    (#8), divider_chain and lock_detector (#11) -- into DR-001's type-II
    charge-pump loop, so there is exactly one top-level assembly in the repo
    instead of one per closed-loop campaign.
    - design/pll_top.sch/.sym: 32-port top level. pfd_cp.VOUT, loop_filter.VCTRL
    and vco.VCTRL are one net (the filter is a two-terminal shunt, DR-001
    Decision 1); pfd_cp.FB is driven by divider_chain.FB (the VCO-retimed edge),
    not by DIVOUT, per DR-001 Decision 3's const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
    [pll_top.sch, power_split.csv, supply_dynamic.csv, supply_steady.csv]
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2026-08-01 sim: instrument closed-loop testbenches with vctrl/up/dn waveform capture, root-cause output-range's lo-edge anomaly (#66)
    tb_lock_time.sp and tb_output_range.sp now unconditionally wrdata a
    vctrl/up/dn/lock/vwin CSV after the transient completes (post-run vector
    dump, no added analysis cost), and run.sh archives it alongside the
    per-corner log when present. This is the concrete instrument #49's
    Vctrl-anomaly prerequisite asked for.
    Using it, mint a new output-range record (20260801-061907-67d7127) that
    captures and reads the full transient for the lo edge (10 MHz, band 1,
    N=8), reproducing the original #12 record's vctrl_final (2.1116 V)
    exactly. The waveform shows a near-dead-zone PFD sta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
    [typical_27c_3.30v_lo_waveform.csv]
2026-08-01 sim: complete lock-time relock waveform investigation, extend run.sh to full PVT grid (#68)
    Part of #65. Highest-priority item: roots-cause `relock`'s vctrl_final=3.138V
    anomaly via the vctrl/up/dn instrumentation #66 landed. Unlike output-range's
    `lo` finding (ordinary correctly-signed acquisition current), `relock` is a
    genuine large-frequency-error PFD/CP acquisition-dynamics anomaly: `up`
    asserts persistently (86.5% duty) despite the measured feedback edge running
    ~1.6-1.7x FASTER than the reference -- the opposite of the naive tri-state-PFD
    expectation. Confirmed via two independent runs (official + a supplementary
    uncommitted probe adding clk/fb visibility), both reproducing vctrl_fina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
    [typical_27c_3.30v_n4_relock_waveform.csv]
2026-08-01 Assemble design/pll_top.sch as the single closed-loop top level, with its own smoke campaign (#64)
    * sim(pll-top-smoke): bound the timestep by the PFD set pulse, add the DN-branch guard
    Rebuilds #52's remaining scope directly on current `main`, which already
    carries `design/pll_top.sch`, its committed export, and this campaign's
    scaffold (landed by #62 under `sim/lib/pll_top_dut.sh`). Nothing here re-adds
    those, and `sim/lib/assemble_closed_loop.sh` -- #12/#56's helper, cited by
    already-committed evidence records -- is deliberately untouched.
    Four fixes, all to the scaffold files already on `main`:
    1. **Timestep ceiling 500 ps -> 100 ps.** The ceiling is set by the PFD's
    INTERNAL set p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
    [lock_transient_typical_27c_3.30v.csv]
2026-08-01 sim: extend lock-time's relock investigation to a second (ss/125C/2.97V) corner (#72)
    * sim: extend lock-time's relock investigation to a second (ss/125C/2.97V) corner
    Answers the open question sim/lock-time/records/20260801-073931-eec269e.md
    flagged: is the typical-corner relock rail excursion (vctrl_final past the
    2.7V clamp, up-dominant) corner-specific or universal? At ss/125C/2.97V the
    answer is the opposite, textbook-expected behavior (dn-dominant, vctrl
    correctly descending toward the target, 955.85 CPU-s vs. 62.1 CPU-s at
    typical -- a corner-attributable 15.4x cost increase, not a contention
    artifact). A companion ff/-40C/3.63V run was also launched this session but
    had not complete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
    [ss_125c_2.97v_n4_relock_waveform.csv]
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2026-08-01 sim/harness: close DerivedSpec.module()'s lazy-init race under parallel PVT points (#76)
    run_grid() dispatches PVT points across a ThreadPoolExecutor whenever
    jobs > 1, and every point shares one DerivedSpec instance. The prior
    check-then-set lazy import had no synchronization, so two worker
    threads could both observe `_module is None` and both import --
    wasted work at best, silently wrong for a derive module with
    import-time side effects. Add a per-instance threading.Lock with
    double-checked locking so the already-imported fast path pays no
    lock-acquisition cost, and only one thread ever runs load_module().
    Closes #73
2026-08-01 sim: make a timestep-bound violation self-detecting, and re-examine supply-sensitivity's 400 ps record (#79)
    * sim: make an internal-timestep-bound violation self-detecting, and cross-link the bound from design/
    #75 hoisted the 100 ps closed-loop internal-timestep bound into
    SIMENV_CLOSED_LOOP_TMAX and brought every closed-loop deck onto it. That
    fixes the current violation; it does not make the next one visible. A
    deck that drifts off the bound does not produce noise -- it produces a
    confident, clean-looking "the loop does not lock" that nothing in a
    verdict table flags.
    sim/lock-time and sim/output-range now measure `dn_lvl` (mean PFD DN
    level over the late window) against the same 3e-4-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
    [reexamination.csv]
2026-08-01 docs: propagate the 100 ps PFD set-pulse timestep bound to shared docs (#80)
    level over the late window) against the same 3e-4-of-rail floor
    sim/pll-top-smoke'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
2026-08-01 sim: rule out the documented timestep artefact for relock, sweep output-range over the full PVT grid (#83)
    output-range lo edge (10 MHz)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
    [typical_27c_3.30v_n4_relock_tmax250p_w2p5e-7_waveform.csv, typical_27c_3.30v_n4_relock_tmax250p_waveform.csv]
2026-08-01 feat: add a raw_files extension point for a deck's own written waveform (#87)
    `.measure` reports scalars, so a campaign whose claim is a *sequence* -- a
    per-cycle period sequence (jitter/TIE), a decimated I-V curve -- had no way
    onto sim/harness: `derive_point`/`derive_tables` were only ever handed parsed
    `.measure` results, and nothing could read back a file the point's own deck
    wrote with `wrdata`.
    Add a top-level `raw_files` manifest key naming those files:
    - testbench.py: `RawFileSpec` (filename + optional `columns`/`description` +
    `retain`), with plain-filename validation and a refusal to `retain` a name
    this repo's .gitignore drops tree-wide (which would put a still-scratch file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
2026-08-01 sim/harness: quit after raw_measures to stop ngspice's redundant second pass (#91)
    Every campaign that declares raw_measures pays for its transient twice:
    compose_deck() emits those as netlist-level .measure cards, and ngspice
    batch mode re-runs the whole analyses list a second time after the
    .control block finishes, purely to service them -- identical numbers,
    doubled wall clock (#86). compose_deck() now ends the control block with
    quit whenever raw_measures is declared, after any measure entries'
    let/print lines, so that redundant pass never starts. Existing evidence
    is unaffected -- the duplicated pass produced identical values, so this
    is a cost fix, not a correctness fix.
    Closes #86
    C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
2026-08-01 sim/vco-tuning-range: run the tuning sweep and stage-count comparison from sim/harness manifests (#88)
    * sim/vco-tuning-range: run the tuning sweep and stage-count comparison from sim/harness manifests
    Replaces the two `sim/lib/simenv.sh`-based runners for this campaign's first
    two sub-testbenches with `sim/harness` manifests, so future runs of both go
    through the shared corner runner:
    testbench/tb.json + tb_vco_tuning.spice + derive.py
    the 504-point (3528-measurement) open-loop f(Vctrl)/Kvco sweep --
    `python3 sim/run_corners.py vco-tuning-range`
    testbench-stages/tb.json + tb_vco_stages.spice + derive_stages.py
    the 3/5/7-stage comparison --
    `python3 s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
    [band_edges.csv, energy_at_100mhz.csv, stage_count_verdict.csv, startup.csv, worst_swing.csv]
2026-08-01 sim: port divider-ratio/lock-detector to sim/harness, mint dff and cell evidence (#94)
    * sim: port divider-ratio and lock-detector testbenches to sim/harness manifests
    Rewrite sim/divider-ratio's three sub-testbenches (dff setup/hold,
    div23_cell, divider_chain) and sim/lock-detector's testbench as
    sim/harness tb.json manifests, runnable via sim/run_corners.py.
    divider-ratio splits into three sibling slugs (divider-ratio-dff,
    divider-ratio-cell, divider-ratio-chain) since sim/harness ties one
    manifest to one experiment directory and each sub-testbench is a
    distinct DUT with its own sweep needs. divider-ratio-chain's
    retiming-margin table is a harness 'derived' cross-record join against
    divi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
    [dff_setup_hold.csv]
2026-08-01 sim: fix a 100 ps ceiling / clamp-release convergence crash blocking #65's lock-time cold-start grid (#95)
    sim/lock-time's `cold` condition (vctrl_ic=0.9V) crashes with ngspice's
    "Timestep too small" at t=t_force on every corner checked, at the compliant
    100 ps internal-timestep ceiling #75/#80/#83 put every closed-loop campaign
    on. Root cause: the release switch's Ron(10)/Roff(1G) transition was a
    hardcoded 100 ps -- exactly one ceiling-sized step, too fast for ngspice's
    LTE controller to resolve. Widen the transition to 10*tmax (ties to the same
    SIMENV_CLOSED_LOOP_TMAX parameter rather than a second hardcoded constant)
    in both tb_lock_time.sp and tb_output_range.sp (identical mechanism).
    V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
2026-08-01 test: pin all seven tuning-sweep derived tables via a real RunView (#98)
    The tuning-sweep parity test stopped at `reduce_grid()`'s internal dict, so
    nothing exercised `rows_from_run()` or `derive_tables()` -- the seven
    `DerivedTable` constructions and their notes could reorder a column, cite the
    wrong corner or drop a note with every underlying number still correct, and CI
    would stay green.
    Adds `_run_view_from_csv()` (the counterpart of the stage-count test's helper)
    which rebuilds a `PointView` per (corner, band) -- 504 points, `f1..f7`/`i1..i7`
    indexed by position in `VCTRLS` -- from the same committed
    `20260731-175947-0a12e6c/vco_tuning.csv`, runs `derive_point()` first as a real
    run do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
2026-08-01 fix: guard supply_pushing reduction against a supply-thinned grid (#97)
    derive_tables() unpacked push[-1]/push[0] unconditionally, which crashed
    with IndexError whenever a run's grid did not span all three supplies
    (2.97/3.30/3.63 V) -- e.g. --supply-tol 0 single-supply calibration runs,
    or any legitimately recorded PVT subset that thins the supply axis. Emit
    the supply_pushing table with no rows and an explanatory note instead.
    Adds a regression test replaying a supply-thinned, band-thinned slice of
    the existing sweep fixture through derive_tables() to catch this crash
    class offline.
    Closes #96
2026-08-01 sim: port cp-compliance and pfd-deadzone onto sim/harness, mint the DC bench's record (#99)
    * sim: port cp-compliance and pfd-deadzone onto sim/harness manifests
    Both campaigns ran from `sim/lib/simenv.sh`-based `run.sh` scripts that owned
    their own corner loop, their own record template and their own awk extraction.
    This replaces the runner half of each with a `sim/harness` manifest, so future
    runs go through the shared corner runner and mint records the harness
    guarantees are conformant:
    pfd-deadzone/testbench/tb.json + tb_pfd_deadzone.spice + derive.py
    python3 sim/run_corners.py pfd-deadzone
    cp-compliance/testbench/tb.json + tb_cp_dc.spice + derive.py
    python3 sim/run_cor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
    [cp_curves.csv, cp_dc.csv, cp_trim_range.csv]
2026-08-02 sim: mint pfd-deadzone's sim/harness evidence record (#101)
    #99 (Part of #42) landed all three sim/harness manifests for cp-compliance
    and pfd-deadzone but only managed to re-run the DC bench's 180-point grid
    before the host became too contended to finish the two transient grids.
    This mints pfd-deadzone's 225-point record from #99's already-merged
    manifest (sim/pfd-deadzone/testbench/), no manifest changes. It numerically
    matches the pre-migration record it supersedes: 45/45 corners checked, 0
    failed the dead-zone criterion, worst linearity ratio 1.1311 at
    fs/27C/2.97V -- exactly the value in 20260731-192355-afa338c.
    cp-compliance's switching-timing bench (sim/cp-compliance/testbench-switc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
    [pfd_deadzone.csv, pfd_deadzone_verdict.csv]
2026-08-02 sim: mint the cp-compliance switching-timing record on sim/harness (135/135 PASS) (#102)
    Runs the already-committed sim/cp-compliance/testbench-switching manifest over
    its full 135-point grid (5 process bundles x 3 temperatures x 3 supplies x 3
    Vctrl points) and records the result. Evidence only -- no harness, manifest or
    design change.
    Record 20260802-033728-c24ee3a, overall PASS, 135/135 points completed.
    Headline effective UP/DN pulse-width skew wskew = wup - wdn:
    -6.012238e-10 s (ss/125C/3.63V/Vctrl=0.9V) .. -4.635258e-11 s
    (ff/125C/2.97V/Vctrl=1.65V), mean -2.964383e-10 s, negative at all 135 points.
    Supersedes 20260731-194124-afa338c, the latest pre-migration cp-compliance
    record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
    [cp_switch.csv]
2026-08-02 sim: mint cp-compliance's switching-timing evidence record (#103)
    Runs the 135-point (45 PVT corners x 3 Vctrl) switching-timing grid against
    the sim/harness manifest committed in #99 and records the result. Evidence
    only -- no manifest, deck or harness code changed.
    PATH=/usr/bin:$PATH python3 sim/run_corners.py \
    sim/cp-compliance/testbench-switching -j 8 --timeout 10800 \
    --supersedes 20260731-194124-afa338c
    New record 20260802-061841-c24ee3a: 135/135 points ok, overall PASS, no
    timeouts and no convergence failures (5040 s wall at -j 8). It supersedes
    20260731-194124-afa338c, the latest prior cp-compliance record, whose
    switching-timing half it replaces.
    Numeric agreement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
    [cp_switch.csv]
2026-08-02 sim/pll-top-smoke: place the measurement window past the filter's ratified (#105)
    settling floor, and re-derive the in-lock ripple
    The 20 us transient was sized by treating the loop's crossover frequency as
    its settling time constant. This loop is deliberately overdamped, so settling
    is set by the dominant closed-loop pole near 1/(2*pi*R*C1) = 17.09 kHz --
    which is exactly why spec/pll.md states a ~43 us structural settling floor
    and DR-006 Decision 7 removed the <20 us stretch target from the ratified
    spec. A 20 us window was therefore asking the loop for something the spec
    already says it cannot do, and record 20260801-085349-0e5c22d's four FAILs
    were four views of that one fact.
    - tstop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
2026-08-02 docs: scope sim/ supersession per-bench, add --supersedes-note flag (#106)
    sim/cp-compliance/ showed that one predecessor record can legitimately
    have two disjoint successors (DC half, switching-timing half), which
    sim/README.md's supersession language didn't account for. Document that
    supersession is scoped per-bench, not per-experiment-directory, and that
    Supersedes may carry an optional free-text qualifier (precedent already
    set by 20260731-122451-63e4b47.md).
    Add --supersedes-note to sim/harness/cli.py so the qualifier is minted by
    the tool, threaded through report.py's build_record/render_record to
    render "**Supersedes**: <id> -- <note>". No existing record is touched.
2026-08-02 sim: mint the lock-detector and divider-ratio-chain evidence records on sim/harness (#109)
    * sim: mint lock-detector's sim/harness evidence record (issue #93)
    Runs the 95-point lock-detector corner matrix through sim/harness's
    shared corner runner, superseding 20260731-162119-0a12e6c (the
    sim/lib/simenv.sh-era record) as a tooling migration. All measured
    values (window edges, twin_r/twin_f, assert/deassert times, lock_pass)
    reproduce the superseded record.
    * sim: mint divider-ratio-chain's sim/harness evidence record (issue #93)
    Runs the full 235-point divider-ratio-chain corner matrix through
    sim/harness's shared corner runner, superseding 20260731-171817-0a12e6c
    (the sim/lib/simenv.sh-e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
    [retiming_margin.csv, window_edges.csv]
2026-08-02 feat: add a phases manifest key for a record minted from several decks (#92)
    * feat: add a phases manifest key for a record minted from several decks
    `sim/harness`'s manifest named exactly one `netlist`, so a campaign whose
    claim is a *pair* of stimuli on a pair of topologies could not be expressed:
    `sim/vco-tuning-range`'s supply campaign runs a static supply-pushing deck
    and a transient supply-jitter deck, separately, and reduces them together --
    the jitter numbers are not interpretable without the pushing numbers.
    Splitting that into two records would land evidence weaker than the record it
    supersedes, which sim/README.md's append-only rule does not permit.
    `phases` gives each deck its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
2026-08-04 docs: refresh README status counts (16/9 -> 52/18) and Not-done list (#118)
    The status section undercounted evidence by roughly 3x and claimed
    lock-time, output-range, supply-sensitivity, and pll-top-smoke were
    empty campaign slugs. Recounted sim/*/records/*.md on main: 52 records
    across 18 campaigns. lock-time (6), output-range (2), and
    supply-sensitivity (2) all have evidence now; the remaining gap is
    that the assembled loop does not yet close cleanly -- the one
    pll-top-smoke record on file is an overall FAIL (4 of 7 checks).
    Adds sim/lib/check-readme-status.sh, wired into CI's headless checks
    job, so a future drift between README's hand-written counts and the
    sim/ tree fails the build in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
2026-08-04 sim/vco-tuning-range: mint 504-point harness record (issue #84) (#119)
    * sim/vco-tuning-range: mint 504-point harness record, supersedes 20260731-175947-0a12e6c
    Re-runs the tuning-range campaign through sim/harness's shared corner
    runner (issue #43's migration) instead of the old simenv.sh/analyze.py
    shim. All 504 points pass execution; the acceptance-check table
    reproduces the superseded record within last-digit rounding (band
    floor 6.449 MHz, overlap ratio 1.267, and check 4a's 115.8 MHz/V match
    exactly; the ceiling and check 4b's known FAIL differ by 0.1 in the
    last digit -- 247.7 vs 247.8 MHz and 154.4 vs 154.3 MHz/V -- consistent
    with the migrated deck's different transient-window sizi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
    [acceptance_checks.csv, band_edge_margin.csv, band_overlap.csv, band_plan.csv, block_current.csv, kvco_summary.csv, raw_measures.csv, supply_pushing.csv]
2026-08-04 docs: correct stale README claim that layout/ is an untouched placeholder (#121)
    layout/ has held a proven klt-aware DRC/LVS bring-up flow since issue
    #16 (PR #59, merged 2026-08-01) -- clean and fault-detecting on a
    trivial standard-cell inverter, with evidence at
    layout/evidence/inv-tb-proof/PROOF.md. The root README still called
    layout/ a placeholder identical to measurements/, which has no content
    at all. Correct both the status bullet and the repository-layout table
    to distinguish 'DRC/LVS flow bring-up done' from 'no PLL-block layout
    drawn yet' -- the latter remains true and unchanged.
2026-08-04 docs: /repo:all hygiene pass — correct sim/ and design/ status claims the tree contradicts (#123)
    * docs: correct README status claims the tree contradicts (/repo:all pass)
    Repository hygiene pass over the /repo:all sequence (audit, docs, tidy,
    update-tools, reset). The substantive findings are all doc-vs-tree
    accuracy; each correction below names the artifact that proves it.
    README.md
    - "Not started -- layout. layout/ and measurements/ are placeholders.
    Nothing here has been through DRC/LVS" was false for layout/. The
    foundry DRC/LVS flow was brought up under #16 and is proven end to end
    on a trivial tapped-inverter cell, negative controls included:
    layout/run_pv.py, layout/harn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
2026-08-04 sim/vco-tuning-range: migrate the supply pushing/jitter campaign onto sim/harness (#124)
    * sim: migrate vco-tuning-range supply pushing/jitter onto sim/harness
    Third and last sub-testbench of the vco-tuning-range campaign to move onto
    sim/harness (issue #43). The main tuning sweep and the stage-count comparison
    migrated in PR #88/#119; this ports `testbench/run_supply.sh` -- the static
    supply-pushing deck and the supply-step/ripple jitter deck -- to a manifest
    under `testbench-supply/`.
    The decks, the seven-supply pushing axis, the 0.1 V step, the 0.05 V ripple,
    the window rule and the in-deck frequency estimator are preserved term for
    term, so the migrated run re-runs the *same* experimen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
    [migration_delta.csv, periods_nominal.csv, periods_worst_ripple.csv, raw_measures.csv, ripple_band_dependence.csv, ripple_frequency_check.csv, supply_pushing_summary.csv, supply_ripple_jitter.csv]
2026-08-05 sim/pll-top-smoke: mint superseding PASS record (issue #70) (#125)
    * sim/pll-top-smoke: mint superseding PASS record (issue #70)
    The 56us re-run configured by #105 (measurement window moved to
    50/53us, past the ~43us structural settling floor ratified in
    spec/pll.md and DR-006 Decision 7) has completed. All 7 checks pass:
    residual frequency error, static phase error, divide ratio, absolute
    output frequency, LOCK flag, Vctrl range, and the PFD DN-branch
    integration guard.
    Record 20260802-160926-8456ff3 supersedes the prior FAIL record
    20260801-085349-0e5c22d, which measured the loop mid-convergence at
    tstop=20us.
    Closes #70
    * docs: bump README evidence-record count to 56, refresh pll-top-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
    [lock_transient_typical_27c_3.30v.csv]
2026-08-09 docs(spec): stage spec-review verdict for spec/pll.md v1 (DR-007) (#128)
    * docs(spec): stage spec-review verdict for spec/pll.md v1 (DR-007)
    Runs klayout-tools' spec-review skill against spec/pll.md as directed by
    the operator's 2026-08-09 comment on #1: per-line achievability/evidence
    check, completeness walk, corner-binding check, verdict
    ratify-with-amendments. Per the interim contract (klayout-tools#654 not
    yet landed), this stages the verdict as a decision record rather than
    flipping spec/pll.md's Status line -- ratification itself stays an
    operator action on #1. spec/pll.md is not edited.
    Part of #1
    * docs(DR-007): make the spec-review skill provenance unambiguous
    The Judge read DR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
2026-08-10 chore(repo-skills): update installed Repo Skills to 0.10.0
    Rolled straight to main rather than via a per-repo branch. The 0.8.1 rollout
    used branch-per-repo and seven of those branches were abandoned mid-flight,
    leaving their repos parked off trunk for days — and invisible, because
    compute-drift.sh's axis 3 compares a checkout against its OWN branch, so a
    repo current with a stale branch reports clean (2AMLogic/2am#209). An
    installed-tool refresh is mechanical, already-reviewed content, so a direct
    commit removes that abandonment failure mode entirely.
    This host's fleet spanned 0.6.1 to 0.8.1 before this pass, against a 0.10.0
    source — see 2AMLogic/2am#216.
2026-08-16 docs(sim): add aggregated characterization report across all 18 campaigns (#150)
    Adds sim/CHARACTERIZATION.md, a single hand-maintained document pulling
    each sim/*/records/ campaign's current headline result, evidence-record
    citation (path + content hash), and pass/fail status against spec/pll.md
    into one place -- no such aggregation existed before this (#142/#143's
    T1/bronze verdict, item 8). Cross-references every gap in spec/pll.md's
    own "Verification owed" table so the two documents cannot silently
    disagree, and calls out several honest caveats found while assembling it
    (a stale spec/ citation surviving a campaign migration, an unreconciled
    duplicate record pair, campaigns whose latest r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
2026-08-16 feat(sim): measure the closed-loop reference spur from the output spectrum (#151)
    * feat(sim): add reference-spur campaign — closed-loop spur measured from the output spectrum
    Adds sim/reference-spur, the first closed-loop campaign on sim/harness: it
    runs the assembled pll_top to lock and reads the reference spur directly out
    of the locked output spectrum, in place of spec/pll.md's narrowband-FM
    derivation from the charge-pump asymmetry.
    - testbench/tb_ref_spur.sp + tb.json: the harness manifest composes the
    committed design/netlist/pll_top.spice via `dut`, encodes the <=100 ps
    closed-loop internal-timestep bound explicitly as the .tran 4th argument
    (a tb.json manifest does not inh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
    [raw_measures.csv, spectrum_worst.csv, spur_by_corner.csv]
2026-08-17 sim/harness: warn when ngspice-47 will mis-expand a nested nonlinear moscap (#153) (#156)
    ngspice-47 mis-expands sm141064.ngspice's nonlinear-capacitance moscap
    family (cap_nmos_03v3, cap_pmos_03v3, cap_nmos_06v0, cap_pmos_06v0, and
    their _b body-tie variants -- all a `c=<expr>` behavioral coefficient) into
    a malformed internal element ("unknown parameter (e9)") when the cap is
    instantiated from inside a nested .subckt. That's design/netlist/vco.spice
    (sim/vco-tuning-range) and design/netlist/pll_top.spice (sim/reference-spur,
    via the same nested vco + loop_filter subckts) -- verified reproduced on
    this host and resolved cleanly under ngspice-46, with frequency/Kvco values
    matching the histo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
2026-08-17 feat(sim): measure loaded PLL output duty cycle and levels/drive-strength (#155)
    Adds sim/output-driver, a 90-point PVT campaign (5 MOS bundles x 3
    temperatures x 3 supplies x the two ratified band/Vctrl edge extremes)
    that puts a 50 fF load on CLK and measures duty cycle, V_OH/V_OL, and
    10-90% edge rate -- closing the two unmeasured output-driver rows in
    spec/pll.md's Verification owed table.
    Duty cycle measures 44.375-50.696%: 7 of 90 points (the `fs` bundle at
    nominal-or-above supply, plus one `ff` point) fall below the 45% floor
    at the `lo` edge, the bottom-of-band condition the spec's own design
    basis predicted as binding. V_OH/V_OL pass at every point (1.006-1.044
    / -0.040...-0.006 x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
    [raw_measures.csv]
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2026-08-19 docs(sim): document assemble_closed_loop.sh/pll_top_dut.sh coexistence as a scoped decision (#160)
    #131 evaluated migrating sim/lock-time and sim/output-range onto
    pll_top_dut.sh's DUT (and retiring assemble_closed_loop.sh) versus
    documenting the two-path coexistence as intentional. Migration is the
    correct long-term target, but it requires re-running both campaigns'
    full PVT grids (270 + 90 runs) against a different DUT and minting
    superseding append-only records -- real multi-session simulation work,
    not a mechanical deletion, and #65 (extending the *existing* DUT's
    grid to full coverage) was still open at the time of this decision, so
    a second full-grid run against a new DUT in the same p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
2026-08-19 sim/output-range: diagnose the ff/27C/3.30V hi stall and record it as a reproducible CAPPED row (#173)
    * sim/output-range: bound the non-converging ff/27C/3.30V hi point and add the instrument that diagnoses it
    The ff/27C/3.30V `hi` row is the one point of the #164 grid with no simulator
    verdict: 151 CPU-minutes without reaching its 2 us stop time, then a manual
    SIGTERM that run.sh could not reproduce. Two additions, both off by default so
    no existing row's behaviour or work-dir tag changes.
    SIM_RUNCAP -- a per-point wall-clock budget for the ngspice invocation.
    Deliberately not SIM_WINCAP: it does not touch tstop, so a row that finishes
    under it is the same measurement an uncapped run pro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
    [raw_measures.csv, trace_ff_27c_3.30v_hi_ic1.454_n2000_nodes.csv, trace_ff_27c_3.30v_hi_ic1.454_n2000_timestep.csv]
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2026-08-21 fix: simenv_run_deck_retried always returned 0 on permanent failure (#188)
    `rc=$?` was read immediately after an `if simenv_run_deck; then ...; fi`
    block whose then-branch never ran. Per POSIX, when an if's condition is
    false and neither branch executes, $? reflects the if compound's own
    status (0), not the condition command's — so rc was always 0, the WARN
    log lines always printed "rc=0", and the wrapper returned success even
    after 3 genuine failures, silently defeating callers' set -euo pipefail
    abort-on-failure behavior.
    Capture the real exit status via `simenv_run_deck "$@" && return 0`
    followed by `rc=$?` on the fall-through path, so rc reflects the actual
    per-attempt failure code.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
2026-08-21 refactor(layout): dedup find_tools try/except idiom in run_pv.py (#200)
    Six command handlers (check-env, build, drc, lvs, bare-cell, prove) each
    repeated an identical 4-line try/except around env.find_tools() that
    prints an error and returns EXIT_ENVIRONMENT. Extracted into a single
    _find_tools() helper, following the same-shape dedup already done in
    sim/lib/ (#196, #198). _reexec_if_klayout_unimportable's try/except is
    left untouched since its catch behavior (silent return) differs.
    No behavior change: layout/tests/ (8 tests, via both pytest and the CI's
    unittest discover invocation) pass, and manual `run_pv.py check-env`
    still surfaces the same error/exit code when tools aren't found.
    Cl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
2026-08-22 refactor(sim): dedup crossings/stats/linefit_residual/linfit/mhz/corner_name across vco-tuning-range (#208)
    sim/vco-tuning-range's harness-integrated path (derive.py, derive_supply.py)
    and manual-invocation path (jitter_extract.py, analyze.py, analyze_supply.py)
    each carried their own copies of the same numeric primitives. Extract the
    byte-identical (or docstring-only-differing) copies of crossings(),
    stats() [mean/RMS/peak-to-peak], linefit_residual(), linfit() and mhz() into
    a new shared testbench/_numeric.py, plus corner_name() (single-tuple-arg
    form, identical in derive.py/analyze.py -- flagged in a follow-up comment on
    #207).
    Loaded via importlib.util.spec_from_file_location, the same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
2026-08-22 chore: resync .github/CONFIGURATION.md from upstream Loom defaults
    Applied to the working tree by `resync-installed.sh` and then left
    uncommitted. `.github/` is on the Loom-shipped allowlist and is walked by the
    resync, so it updates with the rest — but the resync's own commit step stages
    `.loom/` only, so this file stays dirty in every repo the resync touches.
    That is not cosmetic. `fleet-resync.sh` refuses to run against a repo with
    uncommitted work under `.loom/`, `.claude/`, or `.gitignore`, and a repo left
    dirty this way can trip that guard on a later run and stop receiving upstream
    fixes entirely while still reporting as a healthy fleet member. The identical
    diff was found pending i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
2026-08-23 refactor(sim): dedup channel_metrics() into vco-tuning-range's _numeric.py (#216)
    channel_metrics() was defined identically in jitter_extract.py and
    derive_supply.py (modulo an inlined literal 8 vs. the MIN_CROSSINGS
    constant), left behind when the rest of the shared numeric primitives
    were hoisted into _numeric.py. Move it there, parameterized on the
    crossing-count floor, and have both callers import it.
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2026-08-23 refactor(sim): dedup read_columns() into vco-tuning-range's _numeric.py (#229)
    * refactor(sim): dedup read_columns() into vco-tuning-range's _numeric.py
    Both jitter_extract.py and derive_supply.py carried line-for-line-identical
    jit.dat parsing (row filtering, float conversion, transpose, the 4/6-column
    branch). Moves the shared parse into _numeric.py -- the module a series of
    prior PRs (#208, #214, #216, #221, #222, #226) already migrated crossings,
    stats, linfit, mhz, ts, corner_name, channel_metrics, local_kvco, and
    read_csv_rows into for the same reason -- returning ((), ()) on empty input
    and raising ValueError on an unexpected column count, so each caller keeps
    its own SystemExit/Deri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
2026-08-25 spec: remove the stale Tier-2 / 'ruling not made' confidentiality prose — the operator has ruled the numbers public-safe (#177)
    spec/pll.md carried a Confidentiality section and an 'open question routed
    to the operator' that said this is a Tier 2 repository and whether the
    numeric spec values are public-safe 'is an operator ruling that has not been
    made' — text written while the repo was private, left in place at the flip,
    and since then sitting on a public surface next to the very values it
    discussed. The operator ruled on 2026-08-21 (disclosure audit, 2AMLogic/2am
    #355): the values are public-safe, consistent with the 2026-07-31 decision
    that open-PDK canaries go public as bronze-tier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
2026-08-27 ratification: fix inaccurate market-key MANIFEST.md comp-data list (#239)
    The section listed all 4 original COMP_CLASSES entries
    (ldo, pll, sar-adc, bandgap) instead of the single comp file this repo
    actually carries in ratification/market-key/comps/ — the installer
    committed generate-canary-variant.py's raw output instead of hand-scoping
    it per canary-variant.md's install procedure.
    Not a disclosure leak (every listed filename names another public
    canary's own block class); a documentation-accuracy fix only.
    Part of 2AMLogic/2am#589
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2026-08-29 fix: pin ngspice thread count via OMP_THREAD_LIMIT for closed-loop decks (#246)
    * sim: fix ngspice OMP thread pin for supply-sensitivity's closed-loop deck (#244)
    #242 found that OMP_NUM_THREADS=1 -- simenv_apply_omp_pin's only lever --
    does not reduce ngspice-46's live thread count for
    sim/supply-sensitivity's closed-loop lock deck (stays at 8 threads),
    even though the identical mechanism works for #146's mc-cp-mismatch
    deck on the same binary.
    Live /proc/<pid>/status probing found the root cause: OMP_NUM_THREADS
    only seeds the OpenMP nthreads-var ICV, which this ngspice build's own
    internal omp_set_num_threads() call can reassign for this deck's larger
    parallel region. OMP_THREAD_LIMIT,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
2026-08-31 sim/supply-sensitivity: mint the full 45-corner record (#58) (#254)
    Extends the 9-point typical-bundle subset (`20260801-024935-c4fe724`, #62)
    to the full 45-point PVT grid, and measures two criteria #14 never
    completed: the quiescent/dynamic power split (9 corners) and the supply
    step/ramp-while-locked test (3 corners) -- both were previously reported as
    NOT MEASURED.
    The OMP thread-pin fix from #244/#246 held: SIM_JOBS=6 kept each ngspice
    job to 1 live thread (OMP_NUM_THREADS=OMP_THREAD_LIMIT=1) and loadavg
    stayed ~3-7 on this 8-core host throughout, instead of the ~44-48
    self-saturation the 2026-08-06 attempt hit.
    Along the way, found and fixed a real bug in run.sh's own final validatio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
    [power_split.csv, settling_rerun.csv, supply_dynamic.csv, supply_steady.csv, supply_transient_ff_125c_3.30v.csv, supply_transient_ss_-40c_3.30v.csv, supply_transient_typical_27c_3.30v.csv]
2026-08-31 sim/supply-sensitivity: add criterion-3 high-plateau settling escalation (#256)
    Mirrors criterion 1's existing settling-escalation mechanism (KTSTOP_X/
    KTA_X/KTB_X in run.sh) for the step/ramp deck's high plateau: a corner
    whose measured ferr_hi misses ACC_FERR at the default ~8.7us-after-the-
    step-edge window is now automatically re-run with the high-plateau hold
    pushed out to the same settling budget criterion 1's escalation already
    uses (KTB_X = 34.4us after the step edge, i.e. KD_TB_HI_X = 40.1us),
    before the ramp resumes -- rather than being reported as a bare FAIL.
    - run.sh: KD_TRAMP/_TREND/_TSTOP/_TA_HI/_TB_HI are now overridable
    (SIM_DYN_*), with the nominal defaults unchanged and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
2026-09-01 sim/lib/simenv.sh: fail loudly when the pinned ngspice-46 binary is absent (#259) (#260)
    simenv_require_tools previously fell through silently to whatever "ngspice"
    resolved to on PATH when the pinned ~/.local/bin/ngspice binary (the version
    every citable sim/ record cites, and the one #241/#242 tuned OpenMP-pin
    detection against) was missing. On a host where that pin is absent, PATH can
    resolve to Homebrew's ngspice-47, which has a reproducible parse failure on
    this PDK's nested nonlinear loop-filter/VCO moscaps (#153) and -- worse --
    hangs instead of exiting on that error, stalling an entire run.sh job pool.
    simenv_require_ngspice_pin() now: prepends the pinned binary's directory
    onto PAT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
2026-09-01 sim/supply-sensitivity: mint the criterion-3 escalation record (#257) (#261)
    Runs sim/supply-sensitivity/testbench/run.sh to completion at full,
    unshortened transient lengths -- the full 45-point PVT grid plus all 3
    sampled step/ramp corners (typical/27C, ss/-40C, ff/125C) -- superseding
    the mechanism-verification-only record PR #256/PR #258 minted from a
    deliberately truncated deck.
    Both criterion-3 settling escalations now run against real, full-length
    transients for the first time:
    - HIGH-plateau escalation (#253, PR #256): all 3 corners missed ferr_hi
    at the default 14.4us hold and all 3 resolve inside the 1e-3 criterion
    at the escalated 40.1us hold -- 0 of 3 genuine design-margin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
    [dyn_end_settling_rerun.csv, dyn_settling_rerun.csv, power_split.csv, settling_rerun.csv, supply_dynamic.csv, supply_steady.csv, supply_transient_ff_125c_3.30v.csv, supply_transient_ff_125c_3.30v_end.csv]
2026-09-05 feat(champion): standing authorization for design-evidence auto-merge (#6850)
    Operator ruling 2026-09-05: Judge-approved, green-CI PRs whose entire
    changed-file set lives in design/, sim/, layout/, measurements/,
    verification/, or docs/ auto-merge without the four-axis human hold.
    Rationale: canary design evidence is fully revertible with no fleet-infra
    blast radius, and the held-PR pattern (sky130-sar-adc#123 sat mergeable for
    days as the sole blocker of a layout chain) costs more than it protects
    here. spec/ and every tool surface fall outside the patterns, so the
    exact-subset rule keeps them on the four-axis judgment automatically.
    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
2026-09-05 sim: mint period-jitter's first evidence record (#13, part of #237) (#263)
    Complete the previously in-progress period-jitter testbench (derive.py,
    tb.json, tb_period_jitter.sp, and sim/tests/test_period_jitter_derive.py)
    and run it through sim/run_corners.py for the campaign's first-ever
    evidence record: deterministic (control-ripple-driven) period/TIE jitter
    of the locked pll_top output at one nominal corner (typical/27C/3.30V,
    same operating point as sim/reference-spur), measuring 0.2334% RMS
    against the 1.0% draft target -- PASS, with the lock and PFD DN-branch
    integration guards both resolved.
    The full 45-point PVT grid and DR-002 Decision 5's random/noise-driven
    jitter component remain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
    [period_jitter_by_corner.csv, raw_measures.csv]
2026-09-06 sim: extend period-jitter to the process-corner extremes (part of #237) (#265)
    * sim: declare period-jitter's full 45-point PVT grid with per-corner release voltages
    `sim/period-jitter`'s first record (20260905-192724-a2ba48f) measured one
    nominal corner and stated plainly that the mandated 45-point PVT matrix
    remained owed. The obstacle was not compute alone: this campaign's deck
    releases the loop at `vstart`, the control voltage at which that corner's
    ring runs at N*f_ref, and the manifest carried exactly one such value.
    Released at a common voltage instead, a corner up to 0.7 V from its lock
    point would spend tens of microseconds slewing at Icp/C1 = 14 mV/us before
    any measurement window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
    [period_jitter_by_corner.csv, raw_measures.csv]
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2026-09-06 sim/period-jitter: open the temperature and supply axes (part of #237, #13) (#267)
    * sim/period-jitter: open the temperature and supply axes (part of #237, #13)
    Record `20260906-024225-12bccda` adds the eight `typical`-process grid blocks
    this campaign's manifest declared but had never run, completing the full
    3 x 3 temperature x supply plane at nominal process (-40/27/125 C x
    2.97/3.30/3.63 V). Combined with the two prior records -- the nominal point
    (`20260905-192724-a2ba48f`) and the four process-corner extremes at
    27 C/3.30 V (`20260906-015602-f9bef9d`) -- the campaign now stands at 13 of
    the mandated 45 corners, and both the temperature and the supply axis have
    real closed-loop data fo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
    [period_jitter_by_corner.csv, raw_measures.csv]
2026-09-06 sim: declare period-jitter at the 200 MHz top of the band, and report what its derivation already found (part of #237, #13) (#269)
    * sim: declare a period-jitter campaign at the 200 MHz top of the band
    `sim/period-jitter` (#13) measures the deterministic, control-ripple-driven
    period jitter of the locked output, and after four records it covers 13 of
    the mandated 45 PVT points -- but every one of them is at the same output
    frequency: 150 MHz, VCO band 6, N = 6. `spec/pll.md#output-band` ratifies
    10-200 MHz, and 200 MHz is the end that binds. It is where `sim/reference-spur`'s
    two coldest corners already land over the -55 dBc line once scaled; it is
    where a fixed absolute jitter is the large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
2026-09-06 sim/harness: warn (not silence) an ngspice-47 --check-env on a host where no closed-loop campaign can run (#272)
    `run_corners.py --check-env` printed an unqualified `ngspice : OK` even on
    a resolved ngspice-47, which #153 already showed mis-expands this PDK's
    nested nonlinear-capacitance moscap family and fails every point of a
    closed-loop campaign (sim/vco-tuning-range, sim/reference-spur). The
    DUT-aware warning `runner.nonlinear_moscap_ngspice47_warning()` existed
    but was only reachable from the run path, since `--check-env` had no
    experiment to pass it.
    - runner.ngspice47_advisory(): a version-only advisory (no DUT needed),
    fired whenever the resolved ngspice's major version is 47.
    - r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
2026-09-06 sim/period-jitter: close the ff and ss temperature x supply planes (#275)
    where a fixed absolute jitter is the largest percentage of a period, which is
    the form `spec/pll.md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
    [period_jitter_by_corner.csv, raw_measures.csv]
2026-09-06 sim/lib: dedup check_config.sh's field/instance-line verification helpers (#277)
    reference-spur and period-jitter-band-top each defined byte-identical
    check_field()/check_codes() functions and a nearly-identical DUT
    instance-line verification block in their own check_config.sh (the
    only difference being the hardcoded .sp fragment name). Both already
    source sim/lib/pll_top_dut.sh as the encoding's single owner, so the
    verification logic that checks against that encoding belongs there
    too: cloop_check_field, cloop_check_codes, and a parameterized
    cloop_check_instance_line replace the two local copies.
    Verified both scripts print byte-identical PASS/FAIL output before and
    after the extraction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
2026-09-06 sim/period-jitter: close the fs and sf temperature x supply planes, completing the 45-point matrix (part of #237, #13) (#278)
    Runs the 16 remaining declared grid blocks -- the fs and sf MOS bundles'
    temperature x supply points not already covered by the process-corner-
    extremes record -- minting record 20260906-080511-69b36ef, overall PASS,
    16/16.
    Coverage goes 29 -> 45 of the mandated 45 PVT points: this claim's
    deterministic (control-ripple-driven) period-jitter half now has real
    closed-loop data at every mandated PVT corner, across all five MOS
    bundles.
    Deterministic period jitter's overall span is unchanged at 0.0508-0.2691 %
    RMS (worst typical/-40 C/3.63 V, best ss/125 C/3.30 V); the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
    [period_jitter_by_corner.csv, raw_measures.csv]
2026-09-06 sim: make the closed-loop ferr lock gate wrap-safe, and re-measure the two corners it falsely failed (#279)
    * sim: make the closed-loop ferr lock gate wrap-safe, and back it with a wrap-free ferr_fb
    `phi_a`/`phi_b` are ngspice `trig`/`targ` edge-pair delays, so each is
    wrapped into ONE reference period by construction. When a locked loop's
    static phase error straddles zero -- FB's edge marginally ahead of REF's
    -- a sample can latch the *next* FB edge and report ~T_ref where the
    physical answer is ~0. Differencing two samples that land on opposite
    sides of that wrap reads one whole reference period of apparent drift per
    baseline, so `ferr = -(phi_b-phi_a)/(tb-ta)` scored a locked loop at
    T_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
    [period_jitter_by_corner.csv, raw_measures.csv]
2026-09-06 refactor(sim): dedup supplies_of() across the vstart_from_vco_record family (#281)
    period-jitter and period-jitter-band-top each carried a byte-identical
    supplies_of() and reference-spur inlined the same three-line computation.
    Both already pull interp_vctrl/load_curves/VCO_RECORD from reference-spur's
    vstart_from_vco_record.py via load_module(); this extends that reuse to
    supplies_of() so the low/nom/high supply formula is single-sourced.
    Pure refactor: --check output on all three scripts and --emit output on
    period-jitter and period-jitter-band-top are byte-identical before/after.
2026-09-08 docs: cite the landed #13 closed-loop period-jitter grid (#288)
    * docs: cite the landed #13 closed-loop period-jitter grid instead of the stale unmeasured claim
    spec/pll.md's Period jitter section and Verification-owed table still
    described closed-loop period jitter as wholly unmeasured and owed to #13.
    sim/period-jitter/ now holds six merged records measuring the
    deterministic closed-loop period jitter at all 45 mandated PVT corners
    (the full temperature x supply plane at every MOS bundle):
    0.0508-0.2691 % RMS, PASS against the draft target at every corner
    (re-derived here from the records' own min/max stats, not just trusted
    from the issue body or sim/CHARACTERIZATION.md).
    - Summary tabl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
2026-09-08 layout: PLL floorplan record + block-placement GDS skeleton (#289)
    * layout: PLL floorplan record + block-placement GDS skeleton (#17)
    Adds the floorplan/critical-layout plan issue #17's Hold note was waiting
    on #16 (DRC/LVS flow) and #1 (spec ratification) for, both now closed:
    - VCO isolation (guard ring / substrate-tap strategy) sized against DR-003's
    real supply-pushing data (-24 to -51 %/V) and the same DF.13_MV/DF.14_MV
    15 um tap-pitch rule #16's inv_tb proof already exercises live.
    - Supply routing across the four real domains (VDD, VDD_VCO+GND_VCO,
    VDD_DIV, VSS), sized against the full, corrected 45-corner closed-loop
    supply-sensitivity re-run (#58, sim/supply-sensitivity's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
2026-09-08 test: dedup assert_contains() into test_helpers.sh (fixes swapped arg order) (#291)
    sim/lib/test_simenv_ngspice_pin.sh and sim/lib/test_simenv_run_deck_retried.sh
    each defined a local assert_contains() with swapped argument order
    (<haystack> <needle> vs <needle> <haystack>). Because both bodies do a plain
    substring `case` match, a swapped-order call from the wrong file's convention
    would silently produce a false PASS/FAIL instead of an obvious error.
    Consolidate into a single canonical assert_contains <needle> <haystack>
    <case_name> (plus its sibling assert_not_contains) in test_helpers.sh,
    following the run_case/assert_rc/test_summary precedent from #249. Uses
    test_simenv_run_deck_retried.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
2026-09-08 layout: full-custom device-layout methodology proof (PFD/CP pfdcp_inv_3v3, issue #299) (#312)
    Proves out a first, working DRC-clean and LVS-clean full-custom
    device-layout path for the PFD/CP block family (#294 Part 1), on one
    representative leaf cell (design/pfdcp_inv_3v3.sch: one pfet_03v3
    W=1.5u/L=0.3u + one nfet_03v3 W=0.5u/L=0.3u), and hands Parts 2-4
    (#300-#302) a reusable helper module instead of each re-deriving the same
    drawing/wiring pattern.
    The issue's own acceptance criteria named `klt gen mos_array` composed via
    `klt gen-compose` as the primary path. Both were tried: the compose/route
    step worked cleanly (including the documented `orientation: "mirror_x"`
    fix for the same-faci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
    [devgen.py]
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2026-09-08 sim/lock-time: investigate 131 non-rail-excursion relock FAILs (issue #284) (#315)
    Extended-window and waveform-level investigation of one representative
    relock FAIL (typical/-40C/2.97V, N=4) from the #163 full-grid record: after
    an initial fast Vctrl drop, the loop plateaus for the remainder of even a
    2x-extended window (the harness's own SIM_WINCAP ceiling), with fb running
    ~1.5x faster than ref and not converging, well short of this corner's own
    independently-measured lock point. Reads as a genuine loop-convergence
    stall rather than a window-too-short artifact -- flagged to loop-dynamics
    (#10), with the finding explicitly not generalized to the other 130
    unattributed rows.
    Updates sim/CH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
    [typical_m40c_2.97v_n4_relock_2us_baseline_waveform_decimated10x.csv, typical_m40c_2.97v_n4_relock_4us_extended_waveform_decimated20x.csv]
2026-09-08 layout: VCO bias-generator V-to-I core (13 transistors, issue #293) (#316)
    * layout: VCO bias-generator V-to-I core (13 transistors, issue #293)
    Draws all thirteen V-to-I core transistors (MP1/MP2/MN1/MN2/MSU1-3/MPR/
    MD1/MD2/MOFF/MVI/MSUM) from vco_bias.sch as a standalone, DRC-clean
    Metal2-mesh-routed block, reusing mirror.py's routing construction. Adds
    a dog-bone S/D-widening capability to primitives.mosfet() for MSU1's
    narrow (W=0.22 um) channel, and folds the new block into
    layout/floorplan/skeleton.py as VCO_VTOI_CORE.
    * tests: gate DogBoneMosfetTests behind the _HAVE_KLAYOUT skip guard
    `test_vco_layout.py`'s module docstring promises the file runs with "No PDK
    and no KLayout requir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
2026-09-08 layout: full-custom device-layout methodology proof (divider_chain inv_3v3/tgate_3v3, issue #306) (#318)
    Draws divider_chain's two most class-distinct leaf primitives -- a static
    CMOS inverter (inv_3v3) and a transmission gate (tgate_3v3, the pass-device
    topology PFD/CP's own proof did not cover) -- as real transistor-level GDS,
    via a sibling devgen.py reused/generalized from pfd_cp/devgen.py (issue
    #299). Both cells are DRC-clean and LVS-clean against gf180mcu's real
    signoff deck (evidence under layout/evidence/divider-{inv,tgate}-proof/).
    tgate_3v3 needed two real generator generalizations beyond what the
    Curator's read-only prediction anticipated, both found by actually running
    LVS (not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
    [devgen.py, inv_3v3.py, tgate_3v3.py]
2026-09-09 layout: mirror-symmetric transistor-level PFD block layout (issue #300) (#323)
    Draws all 47 leaf-cell instances of design/pfd.sch (40 pfdcp_inv_3v3 +
    7 pfdcp_nand2_3v3, 108 transistors) as real geometry, with the UP/DN
    edgedet+srlatch chains placed as literal mirror images about a shared
    axis (rowgen.py's MirrorView) and the shared 24-inverter reset/delay
    chain routed to both latches over equal-length arms, per
    PLL-FLOORPLAN.md section 4. Standalone-DRC-clean against the gf180mcu
    foundry deck; new geometry/mirror-symmetry/no-overlap tests extend the
    pure-Python layout.tests suite (no PDK required).
2026-09-09 layout: dump-buffer isolated-n-well common-centroid layout (issue #302) (#326)
    Real, DRC-clean transistor-level layout for design/cp_dumpbuf.sch, the
    charge pump's dump-node tracking buffer (DR-005). MP1/MP2 (the PMOS input
    pair, common source PSRC) are drawn as an interdigitated ABBA common-
    centroid array in their own isolated n-well, checked disjoint from every
    other n-well in this cell by at least gf180mcuD's NW.2b different-
    potential spacing rule (1.4 um). The remaining eight devices are drawn
    per the schematic's netlist; every multi-terminal internal net (up to 8
    device terminals) is routed on a dedicated Metal2 bus reached by a private
    Metal3 riser per pad, reusing the pattern layout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
2026-09-09 layout: assemble the whole VCO block (5 sub-blocks, one guard ring, issue #293) (#325)
    * layout: assemble the whole VCO block (5 sub-blocks, one guard ring, issue #293)
    Four earlier increments each drew one piece of vco.sch/vco_bias.sch as its
    own standalone, DRC-clean block: the 5-stage ring (#305), the common-centroid
    band-select mirror and 3-stage output buffer (#313), the RCG/ROFF/RDEG
    ppolyf_u_3k poly resistors (#314), and the 13-transistor V-to-I core (#316).
    All four named the same remaining scope -- the wiring that merges them under
    one guard ring, and the combined block's own DRC run. This is that work.
    layout/pll_top/vco/block.py assembles all five into one flat top cell and
    rout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
2026-09-09 layout: consolidate duplicated Canvas/_r layout helper (issue #317) (#328)
    lock_detector/primitives.py, vco/primitives.py, and pfd_cp/devgen.py each
    independently defined a byte-for-byte-identical Canvas dataclass (plus its
    _r() rounding helper) -- acknowledged duplication, not accidental drift:
    two of the three docstrings already cross-referenced the others as "the
    same convention". Factor the shared body into layout/pll_top/_canvas.py
    and have each submodule subclass it, overriding only its own real deltas
    as class attributes (LAYER table; vco's manufacturing-grid snap step;
    pfd_cp's "metal1_label" default pin layer) so every existing single-arg
    Canvas("some_top_cell") call site and test i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
    [devgen.py]
2026-09-09 layout: dff_tg_3v3 composite flop layout, 6x inv_3v3 + 4x tgate_3v3 (issue #308) (#330)
    Assembles the transmission-gate master-slave D flip-flop every div23_cell
    instance uses twice (Part 3 of #295's device-layout methodology proof) as
    a flat macro composition of ten leaf-cell instances in one shared canvas,
    wired exactly per design/netlist/dff_tg_3v3.spice.
    Since most nets in this composite fan out across instances (unlike a
    standalone build_stack_cell() leaf cell, where every net is column-local),
    devgen.py gains a Metal2/3 composite-routing fabric (route_net()/NetTracks,
    generalized from lock_detector/primitives.py's own) plus draw_column() (the
    bare per-instance drawing step, extracted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
    [devgen.py, dff_tg_3v3.py]
2026-09-09 layout: divider_chain row cells nand2/nand3/nor2/inv2x (issue #307) (#331)
    Part 2 of #295: the four remaining combinational leaf cells the
    divider_chain block needs, drawn as real transistor-level GDS, each
    standalone DRC-clean and LVS-clean against a hand-written reference
    netlist.
    Issue #306's build_stack_cell() draws one vertical column and resolves
    only 1- and 2-terminal nets. Three of these four cells are outside that
    contract: a static gate with real fan-in puts 3+ terminals on one net
    (nand3_3v3's Y has four, its VDD three). devgen.build_row_cell() is the
    addition -- same mosfet() geometry byte-for-byte, plus a column/row
    placement model and a two-layer routing model.
    Two layers, no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
    [devgen.py, inv2x_3v3.py, nand2_3v3.py, nand3_3v3.py, nor2_3v3.py]
2026-09-09 layout: cp_leg_n/cp_leg_p charge-pump unit-leg composite device layout (issue #319) (#335)
    Draws design/cp_leg_n.sch and design/cp_leg_p.sch as real, DRC-clean and
    LVS-clean transistor-level GDS: two devgen.mosfet()-drawn columns (the
    enable-steering pair and the wide-swing cascode mirror) side by side, with
    BG's 3-way net -- which devgen.build_stack_cell()'s own 1-/2-terminal-only
    auto-wiring can't resolve -- hand-routed with a single Metal1 jog, plus a
    hand-routed VSS/VDD rail strap+tap. Evidence and automated tests follow the
    pfdcp-inv-proof/divider_chain precedent.
    Closes #319
2026-09-09 layout: div23_cell composite macro layout, 8 sub-cells / 60 transistors (issue #309) (#338)
    Assembles div23_cell (divide-by-2/3 cell) from nand3_3v3, nand2_3v3 (x2),
    inv_3v3 (x2), dff_tg_3v3 (x2), and inv2x_3v3 as a flat macro composition of
    30 columns in one shared canvas, following dff_tg_3v3.py's precedent
    generalized to handle nand-style multi-net columns (fixed per-role net
    offset anchors, not per-column bucketing, to avoid the inter-bucket riser
    collisions the first two build attempts hit -- see div23_cell.py's own
    docstring and layout/evidence/divider-div23-proof/PROOF.md for the concrete
    failures and fixes).
    Standalone DRC-clean and LVS-clean against a hand-written, fully-flattened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
    [div23_cell.py]
2026-09-09 layout: fold the VCO band mirror into two banks + add the block n-well guard ring (issue #324) (#337)
    PR #325 assembled the whole VCO block and disclosed, rather than closed, two
    coupled gaps: the block-level guard ring was GND_VCO substrate-only against
    PLL-FLOORPLAN.md section 1's "real two-sided ring", and every sub-block was a
    single device row, so the band-select mirror alone (266 um wide) set the
    block's width and its 2.6-4.0x overrun against section 5's ROM area row. They
    are the same increment because folding pays for the ring. This is that work.
    mirror.py's device rows are folded into two stacked banks (BANKS). A bank is
    one complete NMOS-row / Metal2-channel / PMOS-row stack -- th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
2026-09-09 refactor: consolidate duplicated pll_top geometry helpers into _canvas.py (#340)
    Moves bbox_union, _contact_positions, _via_square, and _riser out of
    vco/primitives.py, pfd_cp/devgen.py, pfd_cp/rowgen.py,
    divider_chain/devgen.py, lock_detector/primitives.py, and
    pfd_cp/cp_dumpbuf.py's bbox_union, where each had been independently
    re-authored, and into layout/pll_top/_canvas.py (the shared home #317/#328
    already created for this class of duplication).
    _contact_positions and _riser take their caller's own CO.1/via/wire-size
    constants and (for the one snapping caller, vco/primitives.py) a snap
    callback as explicit keyword arguments, so every submodule keeps deriving
    them from its own constants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
    [devgen.py]
2026-09-09 layout: assemble the divider_chain block, reconcile DIVIDER_LOCK (issue #310) (#342)
    Part 5, and the final part, of #295's divider_chain full-custom layout
    decomposition (#306 leaf devices -> #307 row cells -> #308 dff_tg_3v3 ->
    #309 div23_cell -> this). Assembles the complete block per
    design/netlist/divider_chain.spice: six div23_cell macro instances chained
    VCO -> CK1 -> ... -> CK6, the termination/one-hot-mux glue logic (5x nor2 +
    5x inv modulus-in feedback, 6x nand2 + 2x nand3 + nor2 + inv2x output mux),
    and the XFRT retiming flop -- 452 transistors.
    DRC-clean and LVS-clean on the PDK's own signoff decks (226 pfet_03v3 + 226
    nfet_03v3 matched across 71 named nets). Evidence in
    layout/e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
    [divider_chain.py]
2026-09-09 layout: consolidate divider_chain/devgen.py's duplicated Canvas/_r into _canvas.py (issue #327) (#343)
    Fourth copy of the Canvas/_r pattern issue #317 already factored out of
    lock_detector/primitives.py, vco/primitives.py, and pfd_cp/devgen.py, left
    untouched there deliberately to keep that PR's scope to the three named
    files. Same mechanical change: subclass the shared layout/pll_top/_canvas.Canvas
    with this module's own LAYER table and PIN_LAYER="metal1_label", drop the
    local Canvas/_r duplicate. Verified byte-identical drawn geometry (shapes
    per layer + pin boxes) for all 8 of this module's cell builders
    (inv_3v3, tgate_3v3, nand2_3v3, nand3_3v3, nor2_3v3, inv2x_3v3, dff_tg_3v3,
    div23_cel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
    [devgen.py]
2026-09-09 layout: add a geometric verification gate for the VCO block n-well ring (issue #339) (#345)
    main has no verification gate that catches an n-well drawn over a block's
    own devices as a filled slab instead of a proper annulus -- this exact
    defect shipped once in PR #333 and was caught only by manual KLayout
    inspection, because neither gate the block relies on can see it: the
    foundry DRC deck is edge/spacing-based (an NMOS active island deep inside an
    oversized n-well looks exactly like a legitimate n-well tap, 0 violations),
    and connectivity_report() extracts metal1/via1/metal2 only, no device
    recognition. PR #337 (issue #324) drew the block-level n-well ring correctly
    today, but main's own tes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
2026-09-09 layout: pack divider_chain's top-level routing tracks, cut footprint 39% (issue #341) (#346)
    devgen.py gains pack_tracks(): a left-edge interval-packing track
    assignment (the same track-assignment step a real channel router uses)
    that reuses one Metal2 track_y across every net whose drawn extent
    does not collide, instead of devgen.NetTracks's one-track-per-net
    scheme. divider_chain.py's own top-level build() is the only caller
    switched over -- div23_cell.py and dff_tg_3v3.py still use NetTracks
    unchanged, so neither of those two modules' generated GDS is touched.
    71 top-level nets packed onto 22 tracks (16.5 um) instead of 71
    (53.25 um), cutting the assembled divider_chain block from
    2634.2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
    [devgen.py, divider_chain.py]
2026-09-09 layout: fix lock_detector's Metal1/Metal3 riser routing to eliminate cross-net shorts (issue #322) (#348)
    route_net()'s Metal3 risers used to reach a net's own Metal2 bus by
    running the full pad-to-track_y span at the pad's own natural x -- so two
    different nets whose pads land at the same x (guaranteed for every
    inv/nand2/schmitt column in this package: mosfet()'s S/D pad x depends
    only on the device's own x0, not which net it carries) had their whole
    Metal3 columns overlap, merging into one polygon that is perfectly legal
    by every DRC width/space/enclosure rule. 114 such cross-net overlaps (75
    of them VDD/VSS) sat undetected in the committed lock_detector layout.
    The fix moves each riser'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
    [devgen.py]
2026-09-09 layout: CP N/P common-centroid array placement + bias branch (issue #320) (#351)
    * layout: CP N/P common-centroid array placement + bias branch (issue #320)
    Part 3b of #294's device-layout methodology (a decomposition of #301).
    Builds the charge pump output stage's N-polarity sink array (4x
    cp_leg_n) and P-polarity source array (4x cp_leg_p, issue #319's
    already-clean leaf cells, consumed unmodified via GDS-level
    CellInstArray placement) each laid out common-centroid via a
    "tripod" placement (the always-on leg at the arithmetic mean of the
    other 3, proven by check_common_centroid()), plus the 4x-scaled
    bias-branch devices (MBN/MCN, MBP/MCP, sized/wired per design/cp.sch)
    placed adjacent to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
2026-09-09 layout: VCO band mirror — 2-D common-centroid array for cascades A/C (issue #336) (#354)
    * WIP: issue #336 2-D common-centroid fold (checkpoint before rebase)
    * layout: 2-D common-centroid fold for VCO mirror cascades A/C, doc + evidence pass (issue #336)
    Completes the WIP: fills in mirror.py's module docstring (dangling
    "TWO-DIMENSIONAL ARRAYS" reference, stale flat-pattern table), updates
    block.py's DEVIATION-FROM-ROM section with the post-#336 footprint and the
    V-to-I core width-floor conclusion, regenerates vco_bandsel_mirror.gds and
    vco_block.gds plus their DRC evidence (both still 0 violations, 556 rules,
    against the 2-D-folded geometry), and adds PROOF-2d-fold.md recording:
    - bef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
2026-09-09 ci: install klayout pip wheel in checks job so gated tests actually run (#349) (#356)
    CI's headless `checks` job never installed the `klayout` pip wheel (the
    package providing `klayout.db`, distinct from the standalone KLayout
    application binary used for DRC/LVS — see layout/README.md "The two
    KLayouts"). Every test in layout/tests/ decorated with
    `@unittest.skipUnless(_HAVE_KLAYOUT, ...)` was silently skipped, not run,
    on every CI event — including the VCO n-well geometric verification gate
    added in #339/#345, the exact defect class that shipped once in #333 and
    was caught only by manual review.
    Add a `pip install klayout` step ahead of the existing
    `python3 -m unittest discover -s lay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
2026-09-09 layout: consolidate duplicated v_wire() geometry helper into _canvas.py (#357)
    Four byte-for-byte-identical v_wire() definitions across pfd_cp/devgen.py,
    divider_chain/devgen.py, vco/primitives.py, and lock_detector/primitives.py
    duplicated a Metal1 vertical-wire-segment helper. Adds v_wire() as a shared
    free function in _canvas.py (matching the bbox_union()/_contact_positions()/
    _via_square()/_riser() consolidation from #317/#327/#332), and replaces each
    local def with a functools.partial binding of the submodule's own
    METAL1_WIRE_WIDTH_UM default (0.28 um in three modules, 0.32 um in
    lock_detector) -- pure mechanical dedup, no coordinate-math changes.
    rowgen.py's differently-signed v_wire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
    [devgen.py]
2026-09-09 layout: fold divider_chain's six-instance row into two rows (issue #344) (#358)
    The block was one row of six div23_cell instances plus 46 glue-logic
    columns, so its width (2634.28 um) was the sum of every sub-cell's width
    and at 0.1503 mm^2 it was just over the entire 0.15 mm^2 whole-chip area
    target on its own. ROW_PLAN now folds it into two rows of three
    instances, each carrying its own devgen.pack_tracks() band:
    2634.28 x 57.07 um (150,338 um^2) -> 1317.66 x 100.29 um (132,148 um^2)
    -12.1 % area, and the block fits the 0.15 mm^2 whole-chip target on its
    own for the first time. That is necessary, not sufficient: the re-summed
    whole-chip total is still ~1.9x the budget (was ~2.0x), an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
    [devgen.py, divider_chain.py]
2026-09-09 layout: assemble the CP output stage — glue inverters, steering/dump switches (issue #321) (#361)
    Part 3c of #294's device-layout methodology, completing #301 end to end
    across Parts 3a/3b/3c.
    Adds `layout/pll_top/pfd_cp/cp_output_stage.py`: Part 3b's `cp_array`
    placed unmodified, plus the four `pfdcp_inv_3v3` glue inverters
    (`xi_b0`/`xi_b1`/`xi_up`/`xi_dn`) and the six steering/dump switches
    (`MSWDN`/`MDMPDN`/`MDUMN`/`MSWUP`/`MDMPUP`/`MDUMP`), every W/L and every
    terminal net read directly off `design/cp.sch`'s own instance parameters
    and `lab_pin` labels. The trim bits and rails are tied across the N and P
    polarities here for the first time (Part 3b routes each side
    independently), and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
2026-09-09 layout: fail-loud on KLayout version drift from the LVS-evidence pin (#360) (#363)
    A KLayout application binary newer than 0.28.16 (reproduced: 0.30.9)
    produces a false LVS mismatch on an otherwise LVS-clean, unchanged
    divider_chain layout, while DRC on the same binary is unaffected. Add a
    KNOWN_GOOD_KLAYOUT_VERSION pin and a pure klayout_version_mismatch_warning()
    comparison helper to layout/harness/env.py, surface it as a non-fatal
    WARNING from run_pv.py's check-env (always) and drc/lvs (only inline on an
    unexpected violations/mismatch result), and document the finding + pin in
    layout/README.md. A matching or undetermined version stays silent.
    Closes #360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
2026-09-09 layout: fix EN/ENB riser column short in cp_array (issue #359) (#366)
    cp_array.declutter_riser_x() collapsed any two riser candidates sharing
    an exact natural X onto one Metal3 column, on the false assumption that
    this could only happen for two pads of the same net. Every leg's EN/ENB
    gate-tab pads share one local X (shorting B0/B0B on xn_t0), and the
    tripod places t1b directly above base (shorting VDD/VSS to B1/B1B) --
    both invisible to DRC, since two Metal3 runs at one X merge into one
    legal polygon.
    Fixes it with an explicitly-allocated riser column per net, reached by
    a checked Metal1 escape (the scheme cp_output_stage.py already used for
    its own glue block), plus a net-aware exact-tie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
2026-09-10 layout(vco): block-level LVS reference netlist + net-labelling fix (issue #367) (#369)
    * fix(vco): label nets on gf180mcu's own LVS pin-purpose layer, not the drawing layer
    layout/pll_top/vco/primitives.py's Canvas subclass never overrode PIN_LAYER,
    so every canvas.pin() call landed its text label on Metal1/Metal2's drawing
    datatype (34/0, 36/0) instead of the label/pin purpose datatype (34/10,
    36/10) gf180mcu's own LVS deck reads net names from
    (general_connections.lvs: connect(metal1_con, metal1_label) /
    connect(metal2_con, metal2_label)) -- the same convention
    divider_chain/devgen.py and pfd_cp/devgen.py already use for their own
    PIN_LAYER. Every net this package has ever labelled (five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
2026-09-11 docs(vco-layout): root-cause the vco_block LVS short from issue #368 (#370)
    Documents a complete, reproducible root cause for the connectivity short
    issue #368 reported: ring.py and buffer.py each draw four disconnected
    Metal1 islands per supply net (internal device rail, n-well tap ring,
    outer guard ring) with no deliberate strap between them, masked by a
    structural gate-pad/terminal-pad Y-overlap in primitives.mosfet() that
    each generator's own "one wide rail per net" pattern turns into a real
    cross-row Metal1 short (plus, in ring.py, a wraparound-route riser that
    crosses straight through the GND_VCO rail). No code fix is included --
    the actual fix needs new strap geometry in both generato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
2026-09-11 layout(vco): fix buffer.py Metal1 shorts + add device-to-ring straps (issue #372) (#373)
    Root-caused in PROOF-368-rootcause.md: buffer.py's VDD_VCO/GND_VCO rails
    overlapped stage 2/3's own gate pads (a structural mosfet() pad-overlap
    turned into a real short by a full-row-width rail), and none of the
    internal rail/n-well tap ring/outer guard ring was ever deliberately
    strapped together. Fixes both: rails now live in the clear channel outside
    each row's pads (build() asserts >= M1.2a clearance at draw time) and run
    into the ring biasing the same net; drain/gate bridges hop the NMOS/PMOS
    channel on Metal2 since the inner tap ring's bottom band crosses it on
    Metal1. buffer.py also gets its own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
2026-09-11 layout(vco): fix ring.py Metal1 shorts + VBP/VBN Metal2 trunk (issue #371) (#377)
    * layout(vco): fix ring.py Metal1 shorts + VBP/VBN Metal2 trunk (issue #371)
    Root-caused in PROOF-368-rootcause.md: ring.py's VDD_VCO/GND_VCO rails
    overlapped their own device's bias-gate pad (the same class of short
    buffer.py's fix (#372) already found), the wraparound risers crossed other
    nets' Metal1 on their way to wrap_y, and neither supply rail was strapped to
    its own guard ring. Fixes all three, plus two more found by running the
    reproduction script against this fix rather than assuming only the issue's
    own three: VBP/VBN's bias-gate pads are squeezed between two *different*
    terminal pads of their own d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
2026-09-11 layout(vco): fix vtoi_core.py PMOS-row escape Metal1 short over VDD_VCO tap band (issue #376) (#379)
    vtoi_core.py's PMOS row is top-aligned so MSU1's l=20um channel can reach
    plan.pmos_bottom; every other device's bottom/gate pad then has to escape
    past plan.tap_band_bottom on the way down, and the plain escape() column
    those pads used ran straight through that band's own drawn Metal1,
    merging the escaping net into VDD_VCO. Root-caused by direct klayout.db
    connectivity probing: all five of the row's own bottom nets (NA, VBPC,
    VFIX, VBP0, NSU) showed this same merge -- VBP0 is the only one with a
    boundary pin, which is why vco_block's assembled LVS could only ever see
    it as its own separate V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
2026-09-11 layout(vco): fix vco_block resistor LVS device class, reach clean vco_block LVS match (issue #378) (#380)
    RESISTOR_LVS_MODEL named "ppolyf_u_1k" (the switch-selected, (62,0)-marker-
    gated poly-resistor class), but primitives.poly_resistor() -- like the PDK's
    own ppolyf_u_3k pcell body it models -- never draws that marker layer, so
    the deck always extracts RCG/ROFF/RDEG as the plain, switch-independent
    "ppolyf_u" class instead. That class-name mismatch left the three resistor
    devices MatchWithWarning rather than Match, which in turn escalated every
    net touching them (NC, NOFF, NVI, GND_VCO) to a net-level Mismatch in the
    assembled vco_block LVS run, despite every device pairing correctly.
    Co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
2026-09-11 layout(vco): draw the bias resistors as the ppolyf_u_3k high-Rs device the schematic specifies (issue #381) (#382)
    * layout(vco): draw the bias resistors as the ppolyf_u_3k high-Rs device the schematic specifies (issue #381)
    design/netlist/vco.spice declares RCG/ROFF/RDEG as ppolyf_u_3k (3000 ohm/sq)
    and every recorded sim/ result for the VCO was produced against that device,
    but primitives.poly_resistor() modelled the PDK's polyf_res_inst() pcell body
    -- the recipe for the UNMARKED ppolyf_u class (350 ohm/sq). It drew no shape
    on GDS (62, 0), the marker both the DRC and the LVS deck use to tell the
    high-sheet family apart from the unmarked one, so the drawn resistors were
    8.3x too small: R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
    [raw_measures.csv]
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2026-09-15 fix(sim/supply-sensitivity): correct the furthest-from-settled ranking (#390)
    Record `20260915-105055-2d6ab99` ends its Result section by ranking the
    three sampled step/ramp corners on how far each is from being settled
    enough for `lock_detector` to assert, concluding `ss`/-40 C is the
    furthest. The conclusion is right; the sentence supporting it is not. It
    ranks on the settled phase's distance below the detector window's lower
    edge, which (a) is stated inverted -- `typical`/27 C is ~3.4x further
    below its own edge than `ss`/-40 C is, not less far -- and (b) is the
    wrong quantity anyway, since a settled value says nothing about how far
    a loop still is from settling.
    `sim/` is append-only ev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
    [lock_disambiguation.csv]
2026-09-15 fix(layout/pfd_cp): declutter cp_dumpbuf riser columns across nets (issue #391) (#392)
    cp_dumpbuf.py's _route_net()/NetTracks riser scheme gave every net its own
    Metal2 track_y but never checked that two different nets' Metal3 riser
    columns (X position) stayed clear of each other -- invisible to DRC, but a
    real short netcheck.py catches: the module's own standalone GDS collapsed
    onto one electrical net (every external pin plus every internal net).
    devgen.mosfet() draws a device's own top and bottom Metal1 pads spanning
    the identical X range, so any device whose top_net/bottom_net differ --
    nearly every device here -- produced a same-X, different-net collision by
    construction, not coincidenc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
2026-09-15 lock_detector T1/T2 window gap + post-supply-step settling: DR-010/DR-011 (#387) (#396)
    * feat(sim/lock-window-sizing): add the delaywin_3v3 window-sizing ladder testbench
    A new campaign asking one question of the lock detector's phase-error
    window and nothing else: over the full 45-point PVT grid, where does the
    comparator window t_win land as delaywin_3v3's four MOS-capacitor loads
    are scaled, and is there a sizing that holds t_win inside a two-sided
    band at every corner simultaneously?
    The band is not invented by the deck: its lower edge IS spec/pll.md's
    ratified Lock criterion (static phase error at the PFD inputs <= 1 ns),
    so a part meeting the criterion always asserts; its upper edge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
    [raw_measures.csv, settling_extrapolation.csv, window_sizing.csv]
2026-09-15 feat(layout/pfd_cp): assemble cp_output_stage + cp_dumpbuf into complete cp block (#397)
    Adds layout/pll_top/pfd_cp/cp.py (TOP_CELL="cp"), composing the
    already-merged cp_output_stage (#321) and cp_dumpbuf (#302) into one flat,
    standalone-DRC-clean block matching design/cp.sch's full netlist, per the
    net map in issue #385: VREF<->VOUT, VBN<->IBN, VBP<->IBP, VDUMP<->VDUMP
    (becomes fully internal), VDD<->VDD, VSS<->VSS. The assembled block exposes
    exactly the eleven design/cp.sch ipin/iopin boundary pins; VDUMP is not a
    boundary pin.
    Resumed and fixed a partial implementation left uncommitted in this
    worktree from an earlier session (withheld pending #391, now merged): its
    routing design pass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
2026-09-15 feat(layout/pfd_cp): assemble pfd + complete cp block into pfd_cp, replace floorplan placeholder (#398)
    Part 5b of #294/#303 (depends on Part 5a #385, already merged): pfd (#300)
    and the complete cp block (cp_output_stage + cp_dumpbuf, #385) are now one
    flat, standalone-DRC-clean pfd_cp block matching design/pfd_cp.sch's
    top-level netlist. UP/DN/VDD/VSS are bridged/tied via a dedicated Metal3
    riser + Metal2 trunk per net, reached through each side's own native
    bus/rail edge so no fresh via lands on a pad that already carries one (the
    composition's own docstring records a real Metal3 short this ran into and
    fixed: UP's near-axis bus edge collided with pfd's own NRST link column).
    layout/floo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
2026-09-16 feat(design,layout,sim): implement DR-010 lock-detector resize, re-characterize T1'/T2' (#402)
    * feat(design,layout): DR-010 resize delaywin_3v3 loads to W=9.5um
    design/delaywin_3v3.sch's four nfet_03v3 MOS-cap loads go from W = 8 um
    to W = 9.5 um (L = 2 um, count/topology unchanged), per DR-010's decided
    fix for spec/pll.md row 16's T1' gap (the assert window was 12% below
    the ratified Lock criterion at ff/-40C/3.63V as drawn).
    - design/netlist/lock_detector.spice, design/netlist/pll_top.spice
    regenerated from the resized schematic (design/netlist.sh)
    - layout/pll_top/lock_detector/cells.py's draw_delaywin() MOS-cap
    instantiation updated to match (W=8.0 -> W=9.5); layout/tests/
    test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
    [delaywin_3v3.sch, raw_measures.csv, window_edges.csv]
2026-09-16 Reconcile the static phase offset against the ratified Lock criterion: the axis is Vctrl, not the corner (#394) (#403)
    * sim/supply-sensitivity: re-read the 45-point steady grid against the ratified Lock criterion (#394)
    The 45-point steady-state grid had never been read as a population. Reading
    it moves #394's finding rather than confirming it.
    `tb_supply_lock.sp` measures the REF->FB skew at two instants and reports
    `ferr = -(phi_b - phi_a)/(tb - ta)`. That identity inverts exactly, so every
    committed row already carried how far its "static" phase moved between the
    run's own two measurement instants. Inverting it:
    - `ff`/125C/3.63V -- the corner #394 was filed about -- fell from 2.518 n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
    [pfd_operating_point.csv, pfd_static_offset.csv, raw_measures.csv, static_phase_widened.csv]
2026-09-16 spec: DR-013 — T2′'s reach stays at 2×, the window's PVT spread comes down (#401) (#408)
    DR-010 sized `delaywin_3v3` to W = 9.5 µm against an isolated delay chain
    and booked +1.7 %/+2.2 % of margin inside the T1′..T2′ band. #393's in-situ
    re-characterization (185 points, clean tree) met T1′ and did not meet T2′,
    and DR-010 §Consequences had already said this design has no second re-size
    to spend. This record decides which of the two moves it pre-named is taken.
    The two campaigns disagree because they measure different quantities. The
    delay `t_win` reproduces in situ to within 0.9 %; what the targets are
    actually about is the largest phase error for which `lock` asserts, which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
2026-09-16 sim(supply-sensitivity): testable re-lock phase-trace instrumentation, repointed at the post-DR-010 lock-detector record (#395) (#404)
    * sim/supply-sensitivity: instrument the step/ramp deck with a per-REF-cycle phase trace
    DR-011 Decision 2 declined to turn a post-supply-step settling bracket into a
    `spec/pll.md` bound because the bracket rests on exactly TWO phase samples
    (`phi07`/`phi08`), and two samples cannot distinguish a single-pole decay from
    an under-damped one. The fix is more samples, not a different deck.
    `tb_supply_dyn.sp` now appends `v(ref)` to the transient it already retains, so
    the retained trace carries BOTH edges of the REF->FB phase rather than only the
    feedback edge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
2026-09-16 fix(loom/verify-proposal-refs): avoid SIGPIPE false-negative in full_tree membership check (#410)
    full_tree() prints the entire cached `git ls-tree -r origin/main` listing
    (~10,460 lines in this repo) into a live pipe to `grep -qFx`. grep exits as
    soon as it finds a match, closing its end of the pipe; if the match isn't
    near the end of the listing, the still-writing printf is SIGPIPE-killed
    (exit 141). Under `set -uo pipefail` that 141 becomes the pipeline's
    reported exit status even though grep itself matched and exited 0, so the
    `if !` treats a real, tracked file as missing.
    Replace the live pipe with a command substitution so grep only starts once
    full_tree's entire output already exists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
2026-09-16 Lock-detector window spread: size the T2' miss, pick the trim mechanism (DR-014) (#412)
    * sim(lock-detector): extend T2' ladder with a 0.02 ns refinement at ss/125C/2.97V
    Issue #407 scope item 1 / DR-013 Decision 3: the coarse ladder only bracketed
    the T2' edge to [2.0, 2.1) ns -- there is no measured point between the last
    in-window step (2.0 ns) and the first refined out-of-window step (2.1 ns).
    Add a 0.02 ns step across exactly that interval (e2.02n/e2.04n/e2.06n/e2.08n),
    the same refinement mechanism the campaign already runs at the T1' corner, so
    the size of the miss can be measured rather than bounded to a 5% window.
    min_measured_points bumped from 185 to 189 for the four new points.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
    [raw_measures.csv, window_edges.csv]
2026-09-16 refactor(pfd_cp): alias cp_dumpbuf's RISER_MIN_PITCH_UM to cp_array's, pin cp_dumpbuf: error prefix (#416)
    Two residual guards from PR #414's riser-helper consolidation:
    - cp_dumpbuf.RISER_MIN_PITCH_UM now aliases cp_array.RISER_MIN_PITCH_UM
    (same idiom already used by cp_output_stage.py, block.py, cp.py) instead
    of independently redefining the identical value, so the two constants
    can no longer silently diverge.
    - CheckRiserColumnsTests in both test_cp_dumpbuf_layout.py and
    test_cp_array.py now assert the ValueError message text via
    assertRaisesRegex, pinning that a cp_dumpbuf failure is prefixed
    "cp_dumpbuf: " (not "cp_array: ") -- the one behavior the local wrapper
    in cp_du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
2026-09-19 ci: run pdk-checks on any PR that touches design/, and declare ci:full (#420)
    The pdk-checks job (volare + xschem + gf180mcu PDK, running
    `design/netlist.sh --check` to catch drift between design/*.sch and the
    committed design/netlist/*.spice exports) was gated to a nightly
    schedule, manual dispatch, or a `ci:full` label on a PR. The label did
    not exist in the repo, so the documented per-PR opt-in was unreachable:
    a PR editing design/ could never run pdk-checks against its own head,
    and drift was only caught by the next nightly run on main -- after
    merge.
    Two changes, so the check fires by default for the case that matters and
    the label escape hatch actually works:
    - Add a `design-changed`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
2026-09-19 ci: pin pdk-checks' xschem to 3.4.7 instead of apt's drifting package (#423)
    apt-get install -y xschem on ubuntu-latest/noble resolves to 3.4.4, while
    every committed design/netlist/*.spice export was generated with 3.4.7 --
    the version mismatch made the nightly pdk-checks job's --check step (and
    its leaf-cell collision check) fail on pure toolchain drift, not real
    design changes. pdk-checks now builds xschem from source at the exact
    commit the 3.4.7 tag points at (cached), the same way the PDK is already
    pinned to an open_pdks hash a few steps later, and asserts the pinned
    version actually landed on PATH before running the netlist checks.
    Verified locally: this repo's dev sandbox already c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
2026-09-19 fix(simenv): stop the OMP pin from collapsing simenv_jobs() to 1 (#424)
    GNU coreutils' `nproc` is OpenMP-aware: it reports
    min(available processors, OMP_NUM_THREADS, OMP_THREAD_LIMIT). Since
    `simenv_apply_omp_pin` exports both variables as 1 on this fleet's
    OpenMP-linked ngspice-46 build, and `simenv_jobs()`'s Linux branch asked
    for the host core count with a bare `nproc`, every campaign that opted
    into the pin before fanning out -- the documented order, "typically right
    after simenv_require_tools" -- silently got `xargs -P 1` from every later
    `$(simenv_jobs)`. Observed live on sim/supply-sensitivity: exactly one
    ngspice alive at a time on an 8-core host (~16 h serialized vs ~3 h
    fanned out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
2026-09-20 layout(vco): land the first klt erc supply spec + report (T1 item 11, issue #427) (#434)
    * layout(vco): land the first klt erc supply spec + report (T1 item 11, issue #427)
    Commits erc-supply-spec.json (the gf180mcu poly2/Metal1-5 stackup,
    verified against this repo's own PDK checkout and klayout-tools' curated
    deck layer table, with label_layer restricted to what vco_block.gds's own
    text actually carries), erc-report.json (a klt erc --format json run
    against the committed vco_block.gds, provenance.input.content_hash
    matching that file's own sha256), and PROOF-erc.md documenting both.
    GND_VCO resolves cleanly (one electrical island, zero findings). VDD_VCO
    does not: erc.unconnected_net rep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
2026-09-20 layout(pll_top): assert _canvas.NetTracks' pitch matches every module's METAL2_TRACK_PITCH_UM (#435)
    PR #430 (issue #429) consolidated four byte-identical NetTracks classes into
    layout/pll_top/_canvas.py. Each pre-consolidation copy defaulted `pitch` to a
    *reference* to its own module's METAL2_TRACK_PITCH_UM; the shared class
    defaults to the bare literal 0.75, so a later edit to any one of those four
    constants no longer propagates. Nothing misbehaves today (all four are 0.75),
    but the next DRC-motivated pitch change would leave NetTracks handing out
    0.75 um tracks into geometry assuming a larger pitch -- a Metal2 spacing
    violation, which is the failure the class exists to prevent by construc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
    [devgen.py]
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2026-09-20 layout(vco): feed every n-well from the VDD_VCO trunk, not every sub-block (issue #433) (#438)
    `klt erc` reported `VDD_VCO` as 3 disconnected electrical islands while the
    PDK's own LVS deck reported 65/65 devices and 43/43 nets `Match` on the same
    GDS. Investigated to a root cause: the two tools were not contradicting each
    other, and the finding was two different things at once.
    * One island was a **real floating supply island**. `block.py` drew one
    Metal2 hop from the Metal1 supply trunk per *sub-block*, onto that
    sub-block's topmost n-well tap band. That assumed one n-well per
    sub-block. `mirror.py` gives every bank its own n-well -- and says in its
    own docstring that only block.p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
2026-09-21 docs(spec): expose the lock-detector window trim in the Challenge #5 pad table (DR-015) (#447)
    DR-014's lock-detector window trim-code rule requires LDT3:LDT0 to be set
    per part at test, but the Challenge #5 proposal's pad table and slot
    arithmetic never accounted for it -- even though LDT0-LDT3 already landed
    as real pll_top ports via PR #418. Add DR-015 to document the pad-budget-
    exposure choice (dedicated pins, already implemented, matching CPB0/CPB1's
    idiom) and update docs/chipalooza/challenge-5-proposal.md's port-list
    transcription, pad table, totals paragraph (18 -> 22 of 24), and dropped/
    multiplexed/substituted list to match. Also corrects a pre-existing
    off-by-one in the SPI-contr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
2026-09-21 layout(pfd_cp): root-cause the block LVS mismatch to stray net labels — now matched (issue #448) (#452)
    `pfd_cp`'s first block-level LVS run (#440, PR #450) came back as a real
    84-of-93-net, 69-of-168-device mismatch and was correctly recorded rather
    than papered over. The cause turns out to be neither of the two things that
    record suspected: not missing name hints on `pfd`'s internal nets, and not a
    real UP/DN short. The drawn geometry was correct all along — the net
    *naming* was wrong, in two independent ways.
    1. Stray inherited labels. `cp_leg_n`/`cp_leg_p` label their own boundary
    nets with their own local port names for their own standalone LVS claim;
    `cp_array` composes four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
    [devgen.py]
2026-09-21 layout: measure where every drawn block's area goes, and size each remaining area lever (#457)
    * layout: measure where every drawn block's area goes, and size each remaining area lever
    `PLL-FLOORPLAN.md` §5.1-§5.4 track a real overrun against
    `spec/pll.md#area`'s <= 0.15 mm2 budget, and each revision named its
    successor lever from a *derived* quantity -- most consequentially
    "292 um2/transistor ... every device is its own diffusion island". A ratio
    like that cannot distinguish "the diffusion islands are too big" from "the
    diffusion islands are 1 % of the block and the rest is empty".
    Adds `layout/harness/area.py` + `python3 layout/run_pv.py area`: per-layer
    merged area, fill/whitespace,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
2026-09-21 layout: extend clear_inherited_labels() to divider_chain, widen its default (issue #453) (#460)
    PR #452 fixed a real LVS-mismatch defect ("the level doing the assembling
    owns the net names") but only reached pfd_cp's own four composition sites,
    and its default only cleared the canvas's own PIN_LAYER purpose. Two gaps,
    both surfaced during #452's Judge review:
    - divider_chain.py is a fifth read-GDS-and-flatten composition site (six
    div23_cell instances) with no clear_inherited_labels() call. It was not
    LVS-mismatched because build() already re-labels every net it routes, a
    different mitigation that leaves the six instances' own stray inherited
    local-named texts (494 of them) sitting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
    [divider_chain.py]
2026-09-21 layout(lock_detector): make the riser router a DRC model, and guard every committed GDS against its generator (issue #451) (#462)
    `layout/evidence/lock-detector-layout/lock_detector.gds` was committed once
    at #311 (2026-09-08) and its generator changed seven times afterwards with
    no regeneration. Two independent findings, both reproduced from an
    unmodified `git archive HEAD layout` tree:
    1. The committed file was not the generator's output — a layer-by-layer
    `klayout.db.Region` XOR against a fresh build differed on 9 of the 11
    drawing layers (24 µm² of comp, 27.6 µm² of nplus, 487 µm² of metal3).
    2. The generator's own output was not DRC-clean — 141 violations
    (M1.1x16 M1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
2026-09-21 layout(divider_chain): pack the div23_cell macro's own track band — 2.03x to 1.70x (issue #454) (#459)
    * layout(divider_chain): pack the div23_cell macro's own track band (issue #454)
    the block's 73 distinct Metal2 tracks packed solid at the 0.75 um pitch
    into 54.75 um of height, against the 100.29 um drawn. This spends the
    first of that audit's levers and recovers 39,530 um^2, 65.9 % of it.
    div23_cell.build() now calls devgen.pack_tracks() instead of
    devgen.NetTracks -- the identical one-line substitution #341 made in
    divider_chain.py one level up, applied one level down. The macro's 31
    nets go from 31 never-reused tracks to 11, which is the interval graph's
    own clique number and theref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
    [div23_cell.py]
2026-09-22 layout(lock_detector): draw DR-014's trim network, block now LVS-matched (#466)
    * layout(lock_detector): draw DR-014's trim network, block now LVS-matched (issue #449)
    build_lock_detector()'s delaywin_3v3 cell predated DR-014's 4-bit static
    process trim (issue #411) -- the block's first block-level LVS run (#440)
    correctly reported a mismatch rather than a match. cells.draw_delaywin() now
    draws every device design/gen_delaywin.py's sizing table specifies (the
    always-on base load plus four binary-weighted switched trim segments per
    stage, each gated by its own LDT0-3 boundary pin through a T-input inverter
    -- 45 devices to 117), and build_lock_detector() routes the four new
    boundary pins the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
2026-09-22 layout(lock_detector): pin the block LVS verdict with a test, re-derived on a second KLayout (issue #440) (#471)
    * layout(lock_detector): pin the block LVS verdict with a test, re-derived on a second KLayout (issue #440)
    Issue #440's remaining half was `lock_detector`'s block-level LVS claim.
    The layout work that produced the match landed with #449 (PR #466), and
    `layout/lib/check-layout-status-claims.sh` has reported 4/4 LVS-matched
    since. What was still missing is what makes a recorded verdict durable
    rather than a snapshot: nothing in the test suite read `lvs-clean/` at
    all, so a later change to the generator, to
    `design/netlist/lock_detector.spice`, or to `harness.spice_flatten` could
    h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
2026-09-22 layout(pfd_cp): fold pfd into cp's own empty band and pack the trunk band — 35,281 → 26,665 µm² (−24.4 %) (#470)
    * layout(pfd_cp): fold pfd into cp's own empty band and pack the trunk band — 35,281 to 26,665 um^2 (issue #455)
    `pfd_cp` was the emptiest block in the tree (17.1 % filled). #442 sized two
    levers on it and paired them in one issue because they interact. Both spent
    here, jointly planned, in one PR.
    **Lever 1 — the fold.** `pfd` (80.90 x 22.48 um) no longer sits beside `cp`;
    it sits inside `cp`'s own 99.0 %-empty band above `cp_dumpbuf` (217.10 x
    38.72 um). `cp` now lands at a zero offset and `pfd` is the block that is
    translated, `BLOCK_GAP_UM` above `cp_dumpbuf`'s to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
2026-09-22 layout(pfd_cp): pack cp_output_stage's glue-bus track band — 26,665 to 26,406 um^2 (issue #469) (#474)
    re-derived 16,921 um^2 geometric ceiling, living entirely below that block's
    own level, and sized the larger half: `cp_output_stage`'s glue bus gives each
    of 14 nets a dedicated Metal2 track where "the interval graph's own clique
    number is 9", worth 3.75 um of height (~1,290 um^2). That lever is now spent.
    **The change.** `cp_array._route_side()` — the router `cp_array`'s two array
    channels and `cp_output_stage`'s glue bus all share — takes a new `bus_reach`
    argument, and a caller that supplies it gets `cp_array.pack_tracks()` (the
    left-edge interval-graph track assignment `divider_c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
2026-09-23 layout(pfd_cp): interleave cp_output_stage's glue inverters with the switches they drive — 26,406 to 25,630 um^2 (issue #473) (#478)
    #469 packed `cp_output_stage`'s glue bus onto 13 Metal2 tracks and proved 13
    was that band's clique number — the minimum for a *track assignment*. It also
    decomposed the 13 as **6 structurally full-width nets + a local clique of 7**,
    and named the 7 as a placement artifact: the row grouped all four glue
    inverters past its right-hand end, so DN/DNB/UP/UPB each ran most of the
    block's width from a switch gate to an inverter (237.6 um of span between
    them). Filed as #473, with its own caveat that it might measure out at zero.
    It does not. The band goes **13 -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
2026-09-23 spec: refresh the area row's measured table to the committed GDS and HOLD the row at 0.30 mm2 (DR-017, issue #476) (#481)
    `spec/pll.md#area`'s measured table still carried DR-016's block-by-block
    figures, which were true when that record was ratified and have been false
    since. Three Metal2 routing-track levers landed after it -- #469 and #473
    inside `pfd_cp`, #458 on `divider_chain` -- and none of those PRs refreshed
    the spec, each for the same stated reason: refreshing DR-016's table is the
    same act as amending the row it sits under, and CLAUDE.md routes that through
    `spec/` with a decision record. This is that record.
    Re-derived from the committed GDS at `main` @ 8c6cb7f3 by
    `python3 layo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
2026-09-23 sim(mc): raise Monte Carlo n per corner — term 1's 2.3% budget margin was sampling noise and does not survive (13.22% vs ±12%) (#484)
    * sim(mc): raise Monte Carlo n per corner — term 1's 2.3% budget margin was sampling noise and does not survive (13.22% vs ±12%)
    Both corner-combined Monte Carlo campaigns had an evidence gap that T1/bronze
    checklist item 6 (#127) cannot score: mc-cp-mismatch was corner-combined but
    at n=2/corner for two of its five sub-campaigns, and vco-tuning-range's band-0
    finding compared a nominal-corner dispersion against a worst-corner ratio from
    an unrelated record.
    mc-cp-mismatch — raise per-corner sample counts (N_DC 20→100, N_SW 2→16,
    N_PFD 2→16, N_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
    [mc_cp_dc.csv, mc_cp_switch.csv, mc_dff_ctq.csv, mc_pfd_cp.csv, mismatch.csv]
2026-09-23 layout: give the nine leaf cells' duplicated CLI main() one shared home (issue #485) (#486)
    `divider_chain`'s `inv_3v3`/`inv2x_3v3`/`nand2_3v3`/`nand3_3v3`/`nor2_3v3`/
    `tgate_3v3` and `pfd_cp`'s `cp_leg_n`/`cp_leg_p`/`pfdcp_inv` each carried
    their own `main()` -- parse `--outdir`, call `build()`, write
    `reference_netlist()` beside the GDS, print the footprint and pin list --
    byte-for-byte identical apart from one evidence sub-directory string and a
    cosmetic `leaf`/`layout` variable name. Copy-paste duplication, each module
    written from a sibling as a template.
    `layout/pll_top/_cli.py` now holds that body once, as
    `leaf_cli_main(build, top_cell, reference_netlist, evidence_subdir,
    descriptio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
    [inv2x_3v3.py, inv_3v3.py, nand2_3v3.py, nand3_3v3.py, nor2_3v3.py]
2026-09-23 spec(DR-018): derive charge-pump term 1's mismatch budget from the −55 dBc spur line, ±12 % → ±20 % (issue #483) (#488)
    * spec(DR-018): derive charge-pump term 1's mismatch budget from the −55 dBc spur line, ±12 % → ±20 % (issue #483)
    #15's Monte Carlo campaign at n = 100/corner measures term 1 (DC UP/DN
    current mismatch) at 13.2172 % against design/README.md's ±12 % — 4.4
    standard errors out, an exceedance rather than sampling noise. That table's
    own rule routes the resolution to a decision record, and this is it.
    Of the three candidate resolutions #483 lays out, two are measurably dead and
    the third is the only honest one:
    - The 2-bit Icp trim cannot fix it. One B0/B1 pai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
2026-09-23 sim(mc-cp-mismatch): report term 1 as a real 3σ, not a fold-then-tail (13.22 % → 17.48 %) (issue #487) (#489)
    * sim(mc-cp-mismatch): report term 1 as a real 3σ, not a fold-then-tail (issue #487)
    Term 1 (DC UP/DN current mismatch) was reduced by folding each sample to
    its absolute value and then reporting `mean(|x|) + 3·sd(|x|)` -- while the
    campaign record, the per-corner table and design/README.md's budget column
    all called that figure `|mean| + 3σ` / "3σ". Those are different
    statistics, and the folded one is the *less* conservative: folding merges
    the distribution's two tails before the tail is formed, shrinking both the
    mean and the sd. On the committed 300 samples of record
    2026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
2026-09-23 spec(DR-018 A1): refresh the reference-spur "measured" term-1 row to the signed statistic (13.2172 % → 17.4798 %, −57.6 → ≈ −57.0 dBc) (issue #490) (#491)
    #487 switched sim/mc-cp-mismatch's term-1 statistic from the folded
    mean(|x|) + 3·sd(|x|) (13.2172 %) to the signed |mean| + 3σ (17.4798 %).
    spec/pll.md's charge-accounting table still quoted the old figure.
    Vehicle: this is Amendment A1 to DR-018, not a new decision record. DR-018
    §Decision 3 already authorised this exact switch "without a further record",
    and its §Context table already priced the signed reading. No target, budget
    or verdict moves, and the refreshed row moves in the conservative direction.
    - spec/pll.md: t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
2026-09-24 ci(signoff): bump klt pin to 0.6.0 and re-render the tier report (#494)
    * ci(signoff): bump klt pin to 0.6.0 and re-render the tier report
    klt 0.6.0 adds new provenance fields to `klt signoff --format json` output
    (`build_t1_item_count`, `source_doc_content_hash`, a `build` object, and a
    per-item `graded_by_build`) that 0.5.0 did not emit. This made a local
    `bash signoff/run-signoff.sh --check` report the committed
    signoff/tier-report.json as stale on an otherwise clean main, even though
    CI (still pinned to 0.5.0) saw no drift at all -- the pin was doing its
    job, this bump just hadn't happened yet.
    - Bump the pin in .github/workflows/ci.yml's "Install klt" step and in
    signoff/run-signoff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
2026-09-24 sim: grade cited evidence against the supersession graph, and re-point four stale citations (#498)
    sim/README.md makes a record's standing a FORWARD scan -- a superseded record
    is never edited to carry a back-reference, so "Standing is found by reading
    forward from the superseded record: scan for the record that names it."
    Nothing ran that scan.
    docs/chipalooza/challenge-5-proposal.md, the document written to be sent
    verbatim to an outside reader, therefore still described the period-jitter
    campaign's one FAIL verdict as a live, open measurement defect -- "filed as
    issue #273", "tracked separately at issue #273" -- 18 days after #273 closed
    and sim/period-jitter/records/20260906-095050-3a8a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
2026-09-25 docs: grade the proposal's I/O list against the exported port list, and give the bench plan the two pins it never named (issue #237) (#502)
    #237's AC4 names four deliverables the Chipalooza proposal must carry —
    "block type, I/O list, functional description, spec table". Four checks
    already grade the others: the spec table against spec/pll.md's summary table
    (#500), the cited evidence against the sim/ supersession graph (#498), the
    counts (#497/#495), the layout claims. None graded the I/O list — the one
    deliverable whose source of truth is not a document at all, but
    design/netlist/pll_top.spice, the committed export of design/pll_top.sch.
    The simulation side of this repository already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
2026-09-25 sim/harness: make *where* a point's ngspice runs a choice, not an assumption (#504)
    `sim/period-jitter-band-top` has a complete, self-checking 45-point manifest
    and zero measured points. The reason is not the design and not the deck: the
    harness could only ever run ngspice as a child process of itself, and a
    45-point closed-loop transient grid is not something the shared hosts this
    repository's work is dispatched onto may launch. #496 asked for a deliberate
    choice between giving the harness an off-host execution backend and recording
    the campaign from a workstation instead. This takes the first: the workstation
    route closes one campaign, the backend closes every future 45-point campaign,
    and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
2026-09-25 sim: grade the grid a row's evidence sits on, not just the grid its quoted corner sits on (issue #237) (#517)
    PR #514 made a table row name the wider PVT grid it came from when it
    *quotes* a corner outside the 45-point mandated one. That is a disclosure
    rule keyed on what a row happens to say, and a campaign's worst case does
    not have to land on the bundles the campaign added: a row can rest entirely
    on a 13-bundle grid and look clean by quoting two of its MOS corners.
    The proposal's Lock detector row did exactly that. Its three cited campaigns
    (`lock-detector`, `lock-window-trim`, `lock-window-sizing`) each run 117 PVT
    points across 13 bundles, and the row quoted `fs` and `ss`, said "205
    p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
2026-09-25 sim: measure the REF input contract instead of budgeting it — campaign declared, batch submission path repaired, spec row re-pointed off a closed issue (issue #499) (#518)
    * sim: measure the REF input contract instead of budgeting it — campaign declared, batch submission path repaired, spec row re-pointed off a closed issue (issue #499)
    `spec/pll.md`'s Reference input row states three electrical limits on the
    driving system — levels (V_IL ≤ 0.2·VDD, V_IH ≥ 0.8·VDD), edge rate (≤ 5 ns
    10–90 %) and duty (30–70 %) — and no simulation in this repository has ever
    varied any of them. Every testbench here drives `REF` with the identical ideal
    full-rail 200 ps/50 % pulse, so the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
2026-09-25 spec: give the random half of the period-jitter row an owner and a written-down reason it has no number (DR-020) (#521)
    `spec/pll.md`'s Period jitter row targets <= 1.0 % of the output period, RMS.
    That total has two halves. The deterministic half is measured at 45 of the 45
    mandated PVT corners (0.0508-0.2691 % RMS, PASS at every one). The random,
    device-noise-driven half has zero records at any corner or maturity, and since
    2026-09-08 the ratified Verification-owed table has handed it to issue #13 --
    closed, completed -- which reads to an outside reader as discharged. The same
    defect DR-019 repaired one row below for #12.
    Re-pointing a ratified table's own row is a decision-record act, so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
2026-09-25 sim: grade the reproduction commands a document offers as its own proof (issue #237) (#524)
    * sim: grade the reproduction commands a document offers as its own proof (issue #237)
    The Chipalooza proposal's Reference input row and DR-019's Context both rest
    on one sentence: every testbench in this repository drives `REF` identically,
    so the ratified Reference input contract's levels, edge rate and duty are
    conditions nothing has ever varied -- and with them, every jitter, spur and
    phase number in the proposal is the block's own contribution against an ideal
    reference. Both documents hand the reader the same command to check it:
    grep -n '^vref ' sim/*/testbench/*.sp
    It returned ten decks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
2026-09-25 sim: grade supply-sensitivity's three FAILing criteria against the ratified spec lines, and give each an open owner (issue #506) (#526)
    The 45-point supply-sensitivity record routes each class of FAIL, by name, to
    #9, #10 and #11 -- all three closed, so the findings were recorded and
    unowned. Naming an owner needed each finding said precisely first, and two of
    the three are not what the record's headings say.
    New evidence record 20260925-044237-4ff4f65 (0 new simulations, arithmetic on
    committed artefacts, reproducible from fail_criteria_reexamination.py and
    unit-tested in sim/tests):
    - Criterion 1 has no frequency content: 0 of 45 corners missed either
    frequency check (3.4x and 4.4x hea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
    [criterion1_verdict_classes.csv, criterion1b_vctrl_budget.csv, criterion3_end_recovery.csv]
2026-09-25 layout: grade spec/pll.md's own Area section against the footprint audit (#530)
    layout/lib/check-layout-status-claims.sh's footprint rule already grades
    README.md and the proposal's block-footprint claims against
    layout/evidence/area-audit/area-audit.md; spec/pll.md's ratified Area
    section states the identical four "W x H um" numbers (DR-016/DR-017's
    0.30 mm2 budget row is amended against them) and was never graded by
    anything. Four area-reduction levers landed in one week already proved
    this class of number drifts on a recurring cadence in the two documents
    that were checked -- nothing stopped the same drift in the one document
    where the number is also load-bearing.
    Extends footprint_rule(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
2026-09-25 spec: measure whether the pads can execute the lock-detector trim rule, and record that they cannot (DR-022) (#529)
    * sim(lock-window-proxy): a campaign that asks whether the pads can execute the lock-detector trim rule (issue #501)
    spec/pll.md's Lock-detector window trim-code rule is normative -- a part left
    untrimmed is outside the specification -- but its measurand is internal:
    t_win is the ERR -> ERRD delay of delaywin_3v3, and neither node is a port of
    design/netlist/pll_top.spice. Nothing in this repository has ever asked
    whether a quantity the pads DO expose can stand in for it.
    This commit lands the testbench that asks, ahead of the run so the record it
    produces cites a clean tree.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
    [proxy_candidates.csv, proxy_code_table.csv, proxy_tracking.csv, raw_measures.csv, twin_crosscheck.csv]
2026-09-25 docs: grade the Challenge slot budget's totals against the pad table's own rows (issue #237) (#531)
    `design/lib/check-io-list-coverage.sh` graded the proposal's I/O list against
    `design/netlist/pll_top.spice` — every exported port mapped, every mapped
    signal real, the quoted `.subckt` line in netlist order, per-row counts equal
    to the signals beside them, every pin named in the bench plan. Its own "what
    it does not do" named the gap this change closes: nothing graded §2.2's
    Challenge-budget totals against the per-row counts, on the argument that a
    totals rule would have to encode the category taxonomy and would then be
    grading the check's model of the document rather than the document.
    I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
2026-09-25 spec: give the random period-jitter component a live owner, and locate the gap that kept it unmeasured (issue #505) (#522)
    `spec/pll.md`'s Verification-owed table named **#13** for the random
    (noise-driven) half of the Period jitter row. #13 closed on 2026-09-08, so for
    seventeen days a ratified table handed a live obligation to a closed issue —
    which reads, to the outside reader this repository is written for, as
    discharged. It is the same defect #500 found for #12 on the Reference input
    row and DR-019 repaired there.
    DR-023 re-points the row at **#520**, filed by this change to own the
    measurement. It is deliberately not pointed at #505: the PR landing this
    record closes #505, so naming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
2026-09-25 sim: grade what the proposal says about how the bias pins are driven, and the Limitations it quotes (issue #237) (#532)
    The PLL has no bias generator, so every closed-loop deck drives IBN/ICN/IBP/ICP
    from ideal current sources. The Challenge #5 proposal turns that into a bench
    instruction (section 4 step 1: which current, into which pin, set where) and a
    pad-table justification (section 2.2: a phrase quoted verbatim from the
    records' Limitations). Both cited evidence; neither was graded, and both
    citations were wrong:
    - Step 1 pointed the reader at `.param iunit=8u` in
    sim/lock-time/testbench/tb_lock_time.sp and in sim/output-range. Neither
    deck has that line. Both get the value from th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
2026-09-25 sim: measure the reference spur at the frequency its line binds at — 200 MHz campaign declared, spec row re-pointed off a closed issue (issue #510) (#537)
    `spec/pll.md`'s Reference spur row is `measured` at 5 of the 45 PVT corners, at
    f_out = 150 MHz, and `budget` everywhere else. Its ≤ −55 dBc line is stated at
    the 200 MHz ceiling of the ratified output band, because the spur grows with
    output frequency, so the one record reports its binding-point figure as
    arithmetic — `spur_dbc + 20·log₁₀(200/150)` = +2.50 dB — and at the two coldest
    corners that arithmetic lands 0.1–0.5 dB on the wrong side of the line. The
    owed work was handed to #145, which is **closed**; no open issue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
2026-09-25 docs: grade the sim/ reports' issue owners too, and re-point three stale ones off closed #505 (issue #237) (#538)
    * docs: grade the sim/ reports' issue owners too, and re-point three stale ones off closed #505 (issue #237)
    docs/lib/check-issue-reference-state.sh graded the forge claims of two
    documents, the Chipalooza proposal and README.md. sim/README.md and
    sim/CHARACTERIZATION.md make the same kind of claim and are just as
    outward-facing: the proposal's section 8 sends its reader to sim/README.md.
    Neither was graded, and both had gone stale in the way the check exists to
    catch:
    - sim/README.md's campaign table said the random half of period jitter
    "is owed at **#505**", and its wo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
2026-09-25 sim: grade the non-MOS-axis and non-rectangular-sample grid claims (issue #516) (#543)
    check-pvt-coverage-claims.sh's rules 1-4 all read sim/harness/corners.py's
    bundle registry, so a record whose corner axis is not the MOS grid at all
    (sim/loop-dynamics' passive loop filter) or whose corner-file names carry an
    extra sample axis (sim/divider-ratio-chain's non-rectangular N sweep) passed
    in total silence: nothing checked the "81 filter-impedance points (27
    passive-corner bundles x 3 temperatures)" and "235 points run of the 2835 ...
    61 distinct N" claims docs/chipalooza/challenge-5-proposal.md quotes from
    them against the records themselves.
    Rule 5 reads a non-MOS-axis record's own declarati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
2026-09-25 design: connect the lock-detector trim MSB at pll_top, and correct what the ff cell measured (DR-026) (#547)
    `design/pll_top.sch` placed the `LDT3` trim label at (230, 980) -- three grid
    rows off the `XLD` lock-detector instance's real `LDT3` pin at (230, 840),
    because `design/lock_detector.sym` puts that pin above `UP` while `LDT0`-`LDT2`
    sit below `DN`. xschem exported the open terminal under an auto-generated name,
    so `.subckt pll_top` declared an `LDT3` port nothing inside it read and `XLD`'s
    eighth argument read `net1`. The detector saw `code & 0b0111`: 8 of the 16
    window trim codes were unreachable on the assembled part, including code 11,
    the code `spec/pll.md`'s normative trim-code r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
    [pll_top.sch, trim_msb_audit.csv]
2026-09-25 spec: ratify the batch job image's ngspice-42 divergence from the ngspice-46 pin (DR-028) (#550)
    The batch execution backend's job image runs a simulator this repository does
    not pin: its corner logs sign off `ngspice-42 done`, against the ngspice-46
    that `sim/README.md`'s "ngspice binary pin (#259)" section mandates and that
    every committed record in `sim/` was measured on. The image is built by
    operator-owned provisioning outside this repository, so no change here can
    align it; what a change here can do is stop the divergence being undisclosed.
    DR-028 records it, names both versions, and states the consequence:
    comparability, not correctness. Batch-executed numbers stay evidence on their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
2026-09-25 sim+spec: the REF phase-step bisection measures the wrong quantity — DR-022 route 1 closed with a negative result (DR-029) (#552)
    * sim: add the lock-window-bisection testbench (issue #527)
    The closed-loop `pll_top` campaign that characterizes DR-022 Decision 5
    route 1: a symmetric `REF` phase-step bisection read at the `LOCK` pad --
    the one candidate route to executing the normative lock-detector window
    trim-code rule that needs no design change and no new pad.
    One transient per (bundle, trim code, signed phase step). The phase step is
    two identical periodic sources whose start times differ by exactly `delta`,
    selected between at an instant when both are at 0 V, so the step is exact by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
    [bisection_thresholds.csv, raw_measures.csv, step_ladder.csv, tier_verdict.csv]
2026-09-26 docs: the REF phase-step bisection is closed with a negative result, not owed by #527 (#556)
    `docs/lib/check-issue-reference-state.sh` has been red on `main` since #527
    closed: challenge-5-proposal.md's §4 step 4 still handed the lock-detector
    window trim gap to it with a present-tense "owed by **#527**", and rule 3 is
    that closed work owns nothing.
    The fix is not to name a different owner. #527 closed with a *measured
    negative result* — DR-029 characterizes the symmetric `REF` phase-step
    bisection read at `LOCK` and finds the threshold in Δ is not the flag window
    but the window plus an additive time set by the detector's integrator, its
    trigger threshold, the discharge device and the l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
2026-09-26 sim: measure the 20·log₁₀(N) reference-to-output phase transfer the source-quality exclusion asserts, and fix three batch-backend defects it exposed (DR-027) (#535)
    * sim: pass the resolved region/profile to the fleet launch, and let the REF-drive check see a synthesised reference
    Two blockers stood between sim/reference-phase-transfer's declared grid and a
    measured record. Neither was a design or a spec matter.
    1. The batch backend never told the launch script which identity to submit as.
    `batch.py`'s `_aws` passes `--region`/`--profile` on every transport call;
    `_launch` passed neither, so the launch script fell back to its OWN default
    -- the layer's *admin* provisioning pr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
    [raw_measures.csv]
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2026-09-26 sim: bring up the ISF route's Γ ingredient and show it converges — #520's load-bearing risk is retired, the gap moves to the other two ingredients (DR-030) (#559)
    * sim: bring up the ISF route's Γ ingredient and show it converges — the risk #520 called load-bearing is retired, the gap moves to the other two ingredients (DR-030)
    `spec/pll.md`'s Period jitter row targets ≤ 1.0 % of the output period, RMS.
    Its deterministic half is measured at all 45 mandated PVT corners; its random
    (noise-driven) half has no record, and DR-020/DR-023 record why — ngspice-46
    reports each device's thermal and flicker generators at a bias point, and has
    no periodic-steady-state analysis to weight them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
2026-09-26 spec+sim: reference-phase-transfer ran the lock detector at effective code 0, DR-026's audit was never repository-wide, and a CI check now grades records against their own netlist snapshots (#562)
    All three `sim/reference-phase-transfer` records (DR-027, #509) were taken on
    the pre-DR-026 `pll_top` export whose `XLD` instance line wires the trim MSB to
    `net1` instead of to the declared `LDT3` port (#515), while the decks
    programmed window trim code 8 -- the one code whose only set bit is the one
    that came loose. The detector therefore ran at `8 & 0b0111` = code 0, the
    narrowest window the trim offers, and nothing in the records, DR-027 or
    spec/pll.md said so.
    The measured 20*log10(N) transf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
2026-09-26 spec+docs: grade the derived spur figures too — the hand derivation reproduces itself, and the proposal may not quote a dBc figure it does not contain (issue #237) (#568)
    `sim/lib/check-quoted-value-provenance.sh` grades a *measured* value by
    reducing a committed per-corner CSV. Reference spur is the one row of the
    Chipalooza proposal whose verdict turns on a *derived* number instead: the
    closed-loop campaign measures 5 of the 45 PVT points, every one at 150 MHz
    and with device mismatch off, so what the document tells an outside reader
    about the binding 200 MHz point — 1.6 dB inside the line, rather than the
    ~6 dB the older −61 dBc figure implied — is a hand derivation carried
    throug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
2026-09-26 sim: build the ISF route's other two ingredients and measure the stationary-approximation bound #520's option (B) was refused for want of (DR-031) (#569)
    `sim/period-jitter/sid-trajectory/` is the increment DR-030's Consequences
    named as owed: each ring device's channel-thermal and flicker generator PSD
    evaluated at the bias it actually occupies at 24 phases of the oscillation,
    plus the `(V_gs, V_ds, V_bs, I_d, g_m, g_ds)(x)` trajectory it is evaluated
    along, at three PVT points of the mandated grid.
    The trajectory is sampled out of the ISF bring-up's OWN reference deck --
    `sid_deck.trajectory_deck()` delegates to `isf_deck.build_deck()` and adds
    only a `save`/`wrdata` column list -- so the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
2026-09-26 docs+spec: make section 5's unmet roll call the table's UNMET set, and machine-check it (issue #237) (#572)
    The paragraph closing the proposal's section-5 table ("No row above is
    relaxed, narrowed, or omitted...") was a hand-kept sentence summarizing
    the unmet rows, and had drifted three ways:
    - it omitted four rows the table reports UNMET outright: the 200 MHz
    band-top period jitter, the reference spur at its scaled binding point,
    the closed-loop cold-start lock time, and the output duty cycle;
    - it still listed the lock detector's T1/T2 window as unmet after #411's
    trim met it (on a trimmed part);
    - it counted the Lock-criterion miss at 2 of 45 corners after DR-025
    narrowed it to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
2026-09-26 spec: grade the reference-spur charge totals against sim/mc-cp-mismatch's own raw samples (issue #237) (#574)
    check-spur-derivation-arithmetic.sh (#568) grades the reference-spur
    derivation's arithmetic from its charge totals (7.93 / 11.19 / 11.66 fC)
    onward to a dBc figure, but named what it could not do: grade where those
    totals come from, because that needs "a reduction language for a signed
    |mean| + 3sigma statistic, which it does not have."
    That statistic is not actually missing. DR-018 computes it by hand from 300
    samples already committed at sim/mc-cp-mismatch/corners/<record-id>/, and
    sim/mc-cp-mismatch/testbench/run.sh --restat already re-derives it from those
    same files with no ng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
2026-09-26 sim+docs: grade the one §5 figure that is a statistic, not an extremum — term 1's signed |mean|+3σ (issue #237) (#575)
    `sim/lib/check-quoted-value-provenance.sh` re-derives every measured figure
    the Chipalooza proposal's §5 quotes from the cited record's committed CSV.
    Its reduction language covered extrema and counts: `min`/`max`/`mean`/`sum`/
    `count`, plus two group-sequence verbs for the Output band row's curve
    properties. One headline figure in §5 is neither — the Reference spur row's
    term-1 UP/DN current-mismatch reading, **17.48 %** — and it was **quoted in
    §5 while appearing in neither §5.1's graded table nor its ungraded list**: a
    number nobody had re-derived and nobody h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
2026-09-26 sim: random period-jitter bound pipeline for sim/period-jitter/random-bound (issue #520)
    Adds the method and its tests; the 45-point evidence follows in a later
    commit so every point records this commit as its code.
    A stationary trnoise() injection calibrated at each generator's maximum over
    its own trajectory, which turns the stationary approximation's error into a
    one-sided over-estimate; flicker folded into an equivalent white density
    through the closed loop's error transfer; the loop's effect on the white part
    bounded by white_loop_factor.
2026-09-26 sim+docs: three §5 rows were ungraded because "no CSV" was read as "no evidence" — grade them against the per-point tables the records committed all along (issue #237) (#578)
    §5.1 of the Chipalooza proposal grades a quoted figure by reducing the cited
    record's committed per-corner CSV. Three rows of §5 were excused from that on
    the same stated ground, and the ground was false in all three cases:
    Output band, closed-loop "no reduced CSV was committed, so the
    '0 of 45 corners' verdict cannot be re-derived
    without re-running the campaign"
    Lock time, closed-loop "not a reduced per-corner CSV, so the 21/135 and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
2026-09-26 sim: sample each switching device's density down to the trajectory's own 2 ps resolution (issue #520)
    The injection density must be the maximum of each generator over its
    trajectory. A 48-phase grid refined at +/-1,2,4 steps of 17 ps missed the
    output buffer's peak by up to 2.3x in round A; this samples every switching
    device at 384 phases, then every 2.17 ps step around its three largest local
    maxima, and reports the maximum's convergence against resolution. Bias
    generator devices keep the 48-phase grid with a margin of their own span.
    Sub-networks at different phases share one deck and one summed .noise per
    frequency, so the three rounds cost a few decks per point.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
2026-09-26 sim: random-bound validation compares independent decks statistically (issue #520)
    On this ngspice build a trnoise realisation is not reproduced by fixing the
    seed (set rndseed, .option seed and setseed were all tried on a two-source RC
    deck: same deck, two runs, correlation -0.38), so the period-by-period
    comparisons the validate stage planned are replaced by independent decks
    compared as ratios with standard errors, run side by side. A repeat of the
    transient stage's own deck records the non-reproduction.
2026-09-26 sim: random-bound retries a transient that stalls at start-up with a moved initial condition (issue #520)
    The trajectory deck at ff_125c_3.63v stalls with 'Timestep too small' at
    t = 45 fs, deterministically, and runs cleanly when its third copy's control
    source is moved by 0.1 uV. A stall in the first nanosecond is now re-run with
    the symmetry-breaking .ic moved by 1 mV, then 2 mV; the oscillator forgets it
    within the settling time. The offset used is recorded; a later stall is never
    retried.
2026-09-26 sim: random-bound start-up retry recognises an initial-timepoint stall and tries up to 100 mV (issue #520)
    At ff_125c_3.63v a 1 mV offset stalls again, at the initial timepoint; 2, 10,
    50 and 100 mV all start.
2026-09-26 sim+docs: grade the two §5 figures that are a measurement over a ratified line, and refuse a range as a figure (issue #237) (#582)
    Section 5.1 grades a quoted figure by reducing committed per-corner evidence.
    Two headline figures have a second ingredient that is not a column at all:
    1.41x the worst measured VCTRL travel over the 0.6 V Budget 2 allows
    47 % the same travel over the 1.8 V width of DR-003 Decision 5's
    measured 0.9-2.7 V control window
    Both sat in §5.1's ungraded-figure list for the reason "a ratio to a spec line
    is arithmetic on the line, not a column of the committed evidence" -- a true
    statement about the evidence with the wrong conclusion drawn from it. §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
2026-09-26 sim: bound the bias generator small-signal, and widen the ring/buffer window to two periods (issue #520)
    The injected transient's period sequence has lag-1 autocorrelation +0.17 to
    +0.49 across the first 20 grid points; alone, the bias generator's
    generators give +0.29, the ring's -0.18 and the output buffer's -0.44 (the
    reference point, quick run). The bias generator's outputs are slow nets
    shared by all five stages, so its noise moves the frequency for many
    periods, which breaks the one-period window the flicker and loop factors
    assume.
    The bias generator is quasi-DC, so it is now bounded where it is exact: .noise
    about its DC operating point (the resistor bodies' noise, which .noise does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
2026-09-26 sim+docs: a partially gapped band run was examined less than it looked like, and adjacent-overlap's unit-spacing requirement was unwritten (issue #566) (#583)
    `adjacent-overlap(COL by AXIS)` pairs `k` with `k+1`, and walked past a
    missing intermediate step with a bare `continue`. A group whose axis
    values were `0, 1, 3` therefore compared `0` with `1`, skipped `1`-`3`,
    and reported a worst overlap as if nothing were missing -- while a group
    with NO consecutive pair at all hard-failed. Only the half-gapped case
    passed quietly, which is the wrong way round, and it is the same
    "quietly examined less than it looks like" shape the anti-vacuity
    treatment of `count(non-monotonic(...))` in the same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
2026-09-26 spec+docs: re-derive the reference-spur charge totals' last three ingredients from their own campaigns (issue #573) (#586)
    `check-mismatch-charge-derivation.sh` graded the term-1 and term-3 charge
    figures against `sim/mc-cp-mismatch`'s committed samples, but took the other
    three ingredients of the same totals -- Icp, the reset overlap T_ov, and the
    systematic per-event charge asymmetry -- from DR-018's Input table. Each is a
    worst-of-45-corners figure over evidence already committed, so the chain was
    graded from a table a human typed rather than from the grids the numbers were
    measured on: the same class of gap the check exists to close, one level in.
    Three new rules reduce them from their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
2026-09-26 sim+docs: grade the reference spur's two cold corners as distances from the ratified line, which meant §5 writing a range as two figures (issue #237) (#584)
    §5.1's third table graded a measurement DIVIDED BY a ratified line, and only
    that. The Reference spur row's two cold corners are not a ratio: scaled to the
    binding 200 MHz they land at −54.5 and −54.9 dBc, which is 0.5 dB and 0.1 dB
    past the ratified ≤ −55 dBc. With no way to write a distance, §5 stated the
    pair as the single range "0.1–0.5 dB", the range guard (correctly) refused to
    grade it, and the ungraded list carried it as a declaration whose own text
    named the fix: "closing it means §5 writing the two ends as two fig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
2026-09-26 layout: extend `klt erc` supply evidence from 1 of 4 blocks to 4 of 4, on the pinned klt, and gate it (issue #565)
    T1 checklist item 11 (power delivery, structural) had one `klt erc` supply
    report in this repository, and it had gone stale in three ways at once: its
    `file` field named a `/tmp/i433w/` scratch path no reader could open, its
    `provenance.klt_version` was `0.5.0` while CI has pinned 0.6.0 since #494, and
    its spec declined to declare `ties[]` in a free-text `_ties_omitted` key whose
    stated reason -- klayout-tools#2169's tie extraction reporting a false
    `erc.supply_short` -- had been fixed upstream five days earlier. The other
    three blocks, all LVS-clean, had no supply spec at all.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
2026-09-26 layout: file the two klt erc tool gaps this pass found, and cite them by number
    Both `vco-layout/PROOF-erc.md` and `pfd-cp-layout/PROOF-erc.md` said,
    verbatim, that two newly-found tool gaps were "Filed generically at
    `2AMLogic/klayout-tools` per CLAUDE.md's friction protocol". They were not.
    Nothing matching either gap existed in that tracker — the newest issue at
    the time those commits landed predated them by ~six hours — and the PR body
    said the opposite ("Upstream friction: None new"). An evidence record must
    not assert an action that did not happen; that is the exact failure mode
    `PROOF-erc.md` exists to retire.
    Both gaps are real and were unfiled, so the fix is to do the filing th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
2026-09-26 sim+docs: grade the figure whose divisor is another measurement, not a line
    `33 %` — how much less residual a straight line leaves than a single
    exponential over the same post-ramp samples at `ss`/−40 °C — was the last
    arithmetic-shaped entry in section 5.1's ungraded list. Its stated reason was
    accurate about the third table's reach and wrong to stop there: that table
    combines one reduction with a constant a resolver reads out of `spec/pll.md`,
    and this figure's second ingredient is `rms_exponential_mv`, another column of
    the same committed CSV. Both ingredients were committed all along.
    A fifth table in section 5.1 carries the shape, with `A shortfall-from B` =
    (B − A)/B. It is d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
2026-09-26 sim: the random period-jitter bound over the 45-point grid -- at most 0.338 % RMS, 1.48x inside the 0.50 % allocation (issue #520)
    sim/period-jitter/random-bound/results/ now holds every mandated point:
    trajectory, per-device densities along it, the bias generator's
    small-signal term, and the ring/buffer transient with its 95 % one-sided
    confidence limit; plus the tool calibration, the loop envelope and the
    reference point's validation (timestep, trnoise sample interval, 3x
    linearity, block decomposition, and the bias model against the transient).
    results/SUMMARY.md is regenerated from them by summarize.py.
    Worst point sf/-40 C/2.97 V at 0.338 % RMS; range 0.255 .. 0.338 %. The bias
    generat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
2026-09-26 sim: the PVT-coverage check reads a method directory's per-point result family as evidence (issue #520)
    A row claiming the full mandated grid must cite evidence covering it point by
    point. A method directory (no records/) has committed per-point results but no
    record id, so its rows could only have avoided the claim's wording. It is
    now cited by the glob of the result family the row's number comes from
    (sim/period-jitter/random-bound/results/transient_*.json), and that family's
    file names are read as per-corner evidence for every rule -- the family, not
    the directory, so an earlier stage having run at a point does not cover it.
2026-09-26 spec+docs: the random period jitter is bounded at all 45 corners -- DR-032, and the row, the report, README and the proposal carry it (issue #520)
    DR-032 records the bound (<= 0.338 % RMS, an upper bound and not an estimate)
    and its scope: every generator in vco and the loop-filter resistor; the
    in-band charge pump, PFD, divider and lock detector are argued small, not
    bounded, and owed at #580. It supersedes DR-020 Decision 1 and DR-023
    Decision 2 for a bound, moves the 0.50 % allocation from an unverified
    budget to a verified one, and retires DR-031 Decision 5's observation-
    interval row as a prerequisite (the bound is on the stationary variance, so
    it holds for every interval). DR-002 Deci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
2026-09-26 sim: the noise-referral gap's owner closed on a bound, so the row narrates it as history instead of naming it open (issue #237)
    `sim/CHARACTERIZATION.md`'s `period-jitter` row said, of the
    periodic-steady-state/`pnoise` path DR-023 locates the gap on, "The item is
    owed at **#520** (open)". #520 closed with DR-032, which bounds the random
    half over all 45 mandated corners rather than building that path — so the
    sentence names a closed issue as the present owner of an open gap, and
    annotates it `(open)` besides.
    `docs/lib/check-issue-reference-state.sh` — the check issue #237 added for
    exactly this failure mode — catches both halves (rule 2, state annotation;
    rule 3, present-tense owner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
2026-09-26 sim: repoint the period-jitter row's DR-032 reference to where the bound is actually stated
    The Summary table row said DR-032's bound was "later in this row," but the
    bound (≤ 0.338 % RMS at all 45 points) is stated in a different row of a
    different table — the Verification-owed cross-check section's
    "Period jitter — closed-loop / random (noise-driven) jitter" row.
    Addresses Judge feedback on PR #592 (issue #237).
2026-09-27 sim+docs: the last §5 row excused as "not a record" had 45 points of committed evidence (issue #237)
    §5.1's exclusion table said the random/noise-driven period-jitter row could
    not be graded because `sim/period-jitter/random-bound/` "has no `records/`
    ..., and this check resolves record ids" -- and then said, in its own next
    clause, that the evidence *is* committed and that `summarize.py` regenerates
    every figure the row quotes from it. Both halves were true, and together they
    are not a reason: "this check only reads records" is a fact about the check,
    written as a property of the evidence. That is the same shape as the three
    "no reduced CSV was committed" excuses #237 has already retired,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
2026-09-27 sim+docs: grade the period-jitter margin whose obstacle was the operand order, not the evidence (issue #237)
    Section 5.1's ungraded-figure list declined `1.48×` -- DR-032's margin
    between the random/noise-driven period-jitter bound (0.338 %) and the
    0.50 % spec/pll.md allocates to it -- for a reason that named the shape's
    *operand order* rather than a missing ingredient: "the operator is
    constant / reduction, and this table's / is reduction / constant". That
    is the same kind of non-reason the range guard and the missing magnitude
    aggregate were retired for on 2026-09-26: the fix is a second operator,
    not a permanent exemption.
    check-quoted-value-provenance.sh grows a third rule-7 operator,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
2026-09-27 docs: name the reason when check-issue-reference-state.sh's forge lookup fails
    Forge.state() built its "forge could not be read" diagnostic by
    concatenating stdout+stderr and taking the first line. Real gh writes a
    pretty-printed JSON error body to stdout and the human-readable message
    to stderr on an HTTP-level failure (rate limit, 401, 403), so the first
    line of the combined string was always just "{" -- useless to a reader
    trying to learn why the check skipped.
    Forge.state() now prefers the first non-punctuation line of stderr,
    falling back to a JSON body's `message` field (stdout, then stderr),
    then a non-punctuation stdout line, before giving up.
    The suite's GH_STUB_UNREACHABLE fixtur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
2026-09-27 sim+docs: the last §5 figure excused by a guard had the guard's own "work owed" note attached (issue #237)
    §5.1's ungraded-figure table declined `0.910 ± 0.042` — DR-032's
    `validate` stage checking the bias generator's small-signal model against
    the transient at the reference point — on two grounds, and both were
    about the check rather than about the evidence.
    The first, "a figure with a `±` is two numbers", is the two-ended-range
    refusal wearing different punctuation, and that refusal's stated
    disposition has always been a rewrite owed by §5.
    The second cited the method-directory form's one-point refusal: "a
    per-point glob over one point proves nothing about a grid." That is
    corr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
2026-09-27 sim: bound the in-band generators' random period jitter DR-032 left as an argument (issue #580)
    random-bound (#520, DR-032) bounds the VCO's own generators and the
    loop-filter resistor's random period jitter at all 45 mandated PVT points,
    but explicitly excludes the charge pump, PFD, feedback divider and lock
    detector -- in-band sources reached only through the closed loop's low-pass
    transfer. This closes that scope: in-band-bound refers each block's timing
    or current noise to the PFD's input, through the closed loop's complementary
    transfer and the exact period-difference weighting, over every loop the
    as-built filter admits at the ratified phase-margin floor. The charge pump's
    pulsed reset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
2026-09-27 sim: a Monte Carlo CSV's own header said "no Monte Carlo" (issue #601)
    Every extracted-metrics CSV under sim/*/corners/ opens with
    simenv_provenance's header so the table stays self-describing away from
    its record. One of its lines names the statistical switches the run
    used -- and until now that line was hardcoded, with no parameter and no
    condition:
    # switches: design.ngspice defaults (sw_stat_global=0,
    # sw_stat_mismatch=0 -> nominal skew, no Monte Carlo)
    The sibling simenv_env_block, which writes the prose Environment
    provenance field of the record beside that CSV, has taken an optional
    switches-note since #15 for exactly the campaigns that turn mismatch on.
    So the overri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
2026-09-27 sim: close T1 item 6's corner-combination gap by widening both Monte Carlo axes (issue #597)
    T1/bronze item 6 (#127) asks for Monte Carlo evidence "combined with (not
    instead of) process corners". Sub-criteria (a)-(c) were already met; (d) was
    not, and had been unowned since #482 closed on the samples-per-corner half
    without taking either route it offered. #482 offered two: widen the corner
    axis, or ratify the 3-of-45 subset in a decision record. This takes the first
    route, because the second one's argument does not hold on this repo's own
    evidence.
    Why not the decision record. The 3-point subset was `typical`/`ss`/`ff` on a
    single temperature/supply diagonal. Term 1 is an UP/DN match betwe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
    [mc_cp_dc.csv, mc_cp_switch.csv, mc_dff_ctq.csv, mc_pfd_cp.csv, mismatch.csv]
2026-09-27 sim+docs: the joint-draw CSV's own header said "no Monte Carlo" (issue #597)
    This branch was cut before #601 landed on main (as #607, `4b8dcad9`), which
    gave `simenv_provenance` an optional fifth switches-note argument and added
    `sim/tests/test_provenance_switches_note.py` to grade the pairing. Rebasing
    onto main brought that guard in, and it fails:
    `run_band_pair_worst_corner.sh` drives `tb_vco_band_pair.sp`, which declares
    `sw_stat_global=0` / `sw_stat_mismatch=1` after the `design.ngspice` include so
    the later declaration wins -- yet its `simenv_provenance` call passed only four
    arguments, so the minted `mismatch.csv` opened with the harness default:
    # switches: design.ngspice defaults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
2026-09-27 docs: drop stale #580 references now that DR-033 superseded it
    `docs/lib/check-issue-reference-state.sh` was failing on main because
    #580 closed (via PR #604 / DR-033) while two documents still cited it:
    - challenge-5-proposal.md §5's random/noise-driven jitter row cited
    "issue #580 (open) — the in-band generators' bound" alongside the
    DR-033 decision-record and in-band-bound/ citations the same row
    already carries for that exact bound. Rather than re-annotating a
    now-redundant citation to (closed), drop it — the row already names
    DR-033 and its evidence directly.
    - sim/period-jitter/random-bound/README.md's Limitations section said,
    present tense, "Bounding them is #580's.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
2026-09-27 sim+docs: grade DR-033's in-band jitter bound, and make a second bound in one row provable (issue #606)
    DR-033 (`sim/period-jitter/in-band-bound/`, PR #604) closed DR-032's
    declared scope gap and quoted four new figures into a *graded* section 5
    row of the Chipalooza proposal -- and added no entry to that section's
    value-provenance manifest. Both of the manifest's mechanisms stayed
    silent: the figures were not graded, and they were not disclosed as
    ungraded either, so neither of `check-quoted-value-provenance.sh`'s own
    counts moved across the commit that landed them (95 quoted values and 2
    disclosed-ungraded figures, byte-identical before and after). The only
    reason the numbers were known to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
2026-09-27 spec: re-price DR-018's reference-spur charge stack at the widened 21-point corner axis (issue #610)
    PR #609 (issue #597) widened `sim/mc-cp-mismatch`'s corner axis from the
    3-point diagonal subset to all 20 vertices of the process x temperature x
    supply box plus nominal, and term 3's statistical residual net charge -- an
    input to `spec/pll.md`'s ratified reference-spur derivation -- moved to a newly
    visited mixed bundle: 5.56626 fC at `sf`/125 C/3.63 V, where DR-018 priced
    4.25246 fC. The campaign record flagged that and deliberately did not re-derive
    the stack, because per CLAUDE.md a spec change goes through a decision record.
    DR-034 is that record (status `proposed`; only an operator ra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
2026-09-27 docs: reprice term-4 mismatch bullet to the 21-point corner axis
    design/README.md's mismatch-budget section widened its corner axis from
    3 points to 21 in #597, and DR-034 (#610) re-priced the section's other
    figures, but the "It does not disturb term 4 either" bullet (lines
    818-824) was missed by both passes and still quoted the superseded
    3-point-axis numbers: term 4's measured static phase offset (0.864 ns
    vs. the 1.02467 ns already printed in the comparison table 37 lines
    above), the combined figure with the divider-retiming flop's mismatch
    3sigma (0.871 ns vs. the 1.030 ns already printed two bullets below),
    and their double-counted sum (1.39 ns vs. the correct 1.547 ns).
    Refresh all t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
2026-09-27 sim: flag an unquoted sw_stat_mismatch=1 override, and pin the default switches note (issue #614)
    sim/tests/test_provenance_switches_note.py classifies a testbench script as
    mismatch-on by two routes: an ngspice key=value override on a shell command
    line, or a `.param` declaration in a deck it drives. The shell route only
    recognised the override when it was surrounded by `"` or `'`:
    _CLI_OVERRIDE = re.compile(r"""["']sw_stat_mismatch\s*=\s*1["']""")
    ngspice receives the same argument either way, so a campaign that wrote
    `--define sw_stat_mismatch=1` without quotes ran Monte Carlo while the guard
    read it as nominal -- and then never asked it for the fifth
    `simenv_provenance` switches-no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
2026-09-27 sim: give both Monte Carlo campaigns a committed negative control (issue #602)
    T1/bronze checklist item 6 (#127) asks statistical claims for a
    "deterministic negative control". Two of this repo's three statistical rows
    had one only as prose:
    - `sim/mc-cp-mismatch`'s records described a manual same-seed /
    `sw_stat_mismatch=0` re-check at one corner and one sub-campaign, run
    outside `run.sh` "to avoid adding wall clock to every future run". No
    artifact was committed, so nothing could re-run it, re-check it, or notice
    if it stopped being true.
    - `sim/vco-tuning-range` had no control of its own at all: both Monte Carlo
    records discharged the sub-criterion by citing mc-cp-mismatch ("No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
    [negative_control.csv]
2026-09-27 sim: fix #601/#602 interaction surfaced by rebase onto main
    Rebasing PR #602 (negative control) onto main after #601 (Monte Carlo
    CSV switches-note pairing) merged first exposed two real bugs, not just
    a textual conflict:
    - tb_vco_mismatch.sp's `sw_stat_mismatch` is now a parameter handle
    (`mc_mismatch`), not a literal `1`, so #601's static classifier
    (sim/tests/test_provenance_switches_note.py) no longer recognized
    vco-tuning-range's two mismatch-on scripts as mismatch-on. Extended
    `runs_with_mismatch_on` to also detect a deck-level handle declaration
    that the script sets to 1 on the ngspice command line.
    - Once classification was fixed, both campaigns' new negative-control
    `si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
2026-09-27 sim: fix #597 rebase fallout and resync record counts
    Rebasing onto origin/main again picked up #597/#609 (widened
    mc-cp-mismatch corner axis, new vco-tuning-range joint-band-draw
    record), which needed the same two kinds of fix as the first rebase:
    - test_negative_control.py's StaysWired.test_every_script_that_uses_
    that_deck_passes_the_handle selected scripts by a bare substring
    search for "tb_vco_mismatch.sp", which also matched #597's new
    run_band_pair_worst_corner.sh -- it mentions that deck in a
    comparison sentence but assigns its own DECK to tb_vco_band_pair.sp.
    Narrowed the selector to the actual DECK="${HERE}/tb_vco_mismatch.sp"
    assignment.
    - The two negative-control rec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
2026-09-27 layout: dedup reference_netlist() comment boilerplate across 8 leaf cells
    Eight reference_netlist() functions under divider_chain/ and pfd_cp/
    repeated the same 9-line comment header/footer verbatim, varying only in
    cell name and issue number. Add reference_netlist_header(cell, issue) to
    layout/harness/cell.py to hold the shared text, and route each of the 8
    call sites through a thin, import-deferred re-export in
    layout/pll_top/_cli.py -- already imported by every caller -- rather than
    each of the 8 files repeating the harness sys.path fixup this codebase's
    other cross-package imports (pfd_cp/block.py, lock_detector/build.py) need.
    cp_leg_p.py and dff_tg_3v3.py are untouched (their boilerpl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
    [inv2x_3v3.py, inv_3v3.py, nand2_3v3.py, nand3_3v3.py, nor2_3v3.py]
2026-09-27 docs: grade "tracked as #N" as an ownership claim, and fix the stale owner it hid
    docs/lib/check-issue-reference-state.sh rule 3 fails an outward-facing
    document that hands an open gap to a closed issue. Its phrase list had
    "tracked at" and "tracked by" but not "tracked as", and signoff/README.md's
    "Item 6(c)" section used the third form:
    Item 6 fails on sub-criterion (d), corner combination -- sim/mc-cp-mismatch
    samples 3 of the 45 mandated PVT points and sim/vco-tuning-range 2 -- which
    is tracked as #597 [...]
    Both halves were false on main. #597 closed 2026-09-27 having widened that
    campaign from the 3-point diagonal subset to 21 points -- nominal plus all 20
    vertices of the proce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
2026-09-28 docs: grade the Output band row's adjacent-band overlap under device mismatch
    The proposal's Output band row quoted a worst adjacent-band overlap of 27 %
    with no statement that the figure is mismatch-off, while the repository has
    carried per-instance mismatch evidence for that exact claim since #622 landed
    `sim/vco-tuning-range/records/20260927-220631-546a397` -- 11 sampled
    (corner, band-pair) points, 2200 joint two-band draws, none of it cited
    anywhere in docs/.
    That matters to an outside reader more than most mismatch-off caveats in this
    section do, because the systematic figure's own binding point and the mismatch
    campaign's binding point are the same point: `ss`/125 C/3.63 V on the B3->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
2026-09-28 layout: re-run all four klt erc reports on the pinned release, and make the version rule exact
    Every committed `erc-report.json` in `layout/evidence/` recorded
    `provenance.klt_version: "0.6.0+gf2d249ab23d4"` and was described, in all
    four `PROOF-erc.md` files and in issue #127's own body, as having been
    produced on "the released `klayout-tools==0.6.0` wheel, exactly what
    `.github/workflows/ci.yml` installs". It was not. That string is a PEP 440
    *local version*: a build of the klayout-tools tree after the `v0.6.0` tag,
    which nobody can `pip install` and which this repository does not grade on.
    `layout/lib/check-layout-status-claims.sh` exists to catch exactly that --
    it reads the `klayout-to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
2026-09-28 layout: re-derive every block-level DRC/LVS verdict on the pinned KLayout
    Issue #127's part-27 pass re-derived T1 item 11's `klt erc` evidence from
    its inputs rather than its own prose and found all four committed reports
    had been produced on a klt nobody could install. The debt it recorded for
    the next pass was to give items 3 (DRC clean) and 4 (LVS clean) the same
    treatment, naming a specific suspicion: the ERC runs were on KLayout
    0.30.12 while the DRC/LVS evidence was believed to be on the repo's
    0.28.16 pin -- "an asymmetry this body records but has never re-measured."
    Re-measured. It was not what either document said.
    `layout/README.md` stated that the committed DRC/LVS evidence "was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
2026-09-28 docs+ci: the pin the proposal named was the wrong engine's, and the prose about it was ungraded
    Issue #127's part-28 pass re-derived all four block-level DRC/LVS verdicts on
    the pinned KLayout and added the KLAYOUT PIN RULE to grade the *logs* against
    `KNOWN_GOOD_KLAYOUT_VERSION`. It left the other half untouched: nothing graded
    what the documents say the pin is, and that is where the failure it found
    actually lived.
    Three copies of the same wrong sentence were still live after that pass:
    * `layout/harness/env.py`'s comment on the constant -- "the KLayout
    application version this repo's committed DRC/LVS evidence was captured
    against" -- which the #127 census disproved (16 of the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
2026-09-28 fix(signoff): require klt to be the pinned release, not merely present
    `run-signoff.sh` checked only that `klt` resolved on PATH. `klt signoff`
    embeds its own build identity in the report it renders -- `build.version`,
    `git_commit`, `git_tag`, `is_release`, `grading_ruleset_id` -- and a
    post-tag source build (`0.6.0+g<sha>`, a PEP 440 local version) differs
    from the released wheel in every one of them. So `--check` re-rendered,
    diffed, and reported a current `signoff/tier-report.json` as **stale** on
    any host whose `klt` was a source build, blaming the evidence for a change
    that was entirely the tool's. The same build could equally have *written*
    a report no pinned-wheel host reproduces.
    Th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
2026-09-28 sim: drop the unused count_cells() from the in-band-bound deck builder
    `count_cells()` in sim/period-jitter/in-band-bound/ib_deck.py was defined
    once and never called -- no caller in run.py, no reference in
    sim/tests/test_in_band_bound.py, none in the campaign README. It arrived
    with 3bf3c1df, the single commit that closed #580, and that issue is
    closed, so it is not groundwork for pending work either.
    Its docstring claimed to derive "the stage count the bound charges each
    block for" from the netlist, but that is not where the bound's stage
    counts come from. `single_stage_cells()` decides which cells are
    single-stage (used by run.py, pinned by test_in_band_bound.py), and
    `ib_extract.timing_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
2026-09-29 docs(signoff): correct case 1's claim that no klt envelope is committed
    Four klt erc --format json reports have been committed since PR #587;
    strike the false sentence, name them, and state why they stay uncited.
    Loom-Story: 2AMLogic/gf180-pll#654
    Loom-Trace-Id: e59b0e9ac4e443bd3d915b2342c180a4
    Loom-Build: 0.19.512 1c827a2c1b18005cfbfe2a045d99119596e82f12 clean
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2026-09-29 docs(evidence): correct PROOF-erc.md's supply-text digest to match current GDS
    The 43-supply-text count at line 335 incorrectly cited the superseded
    vco_block.gds digest (b1798bf8…) as pinned under "Provenance". The current
    digest (8c839b91…) is the one actually pinned there and in erc-report.json.
    Re-measured the count against the current GDS; unchanged. Applied per this
    repo's append-only-correction convention: struck the old digest, inserted
    the correct one, and documented the re-measurement.
    Closes #662
    Loom-Story: 2AMLogic/gf180-pll#662
    Loom-Trace-Id: d41b8d3f5e8882d2b39857113eeb3bba
    Loom-Build: 0.19.516 af6fab7706275c1984b9e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
2026-09-29 feat(layout-check): grade every PROOF-*.md layer_indexes() census against the GDS it names
    Adds a ninth guard to layout/lib/check-layout-status-claims.sh, the LAYER
    CENSUS RULE, closing the gap issue #660 walked through: a `{layer/datatype,
    ...}` enumeration a PROOF document prints as raw `layer_indexes()` output was
    the one class of claim in layout/evidence/ that nothing graded, and
    vco-layout/PROOF-erc.md carried a 14-member census of a 15-layer file for five
    weeks while quoting the correct list three sections later. The same wrong list
    was then found copied into that block's erc-supply-spec.json `_comment` (#661).
    Those censuses are load-bearing: each block's spec cites its own to justify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
2026-09-30 feat(layout-check): grade the KLayout pin per top cell, and re-derive the five VCO sub-cell verdicts on it
    `check-layout-status-claims.sh`'s KLAYOUT PIN RULE graded the four block top
    cells only. Sub-cells were ungraded, and that is where it left a residual it
    disclosed rather than closed (issue #127, PROOF-klayout-pin.md): `vco_ring`,
    `vco_vtoi_core` and `vco_out_buffer` carried DRC-clean and LVS-match verdicts
    on KLayout 0.30.9/0.30.10 only, two of them additionally at the PDK runner's
    own `POLY_RES 1k` rather than this repository's ratified 3k (DR-009).
    `OFF_PIN_DISCLOSED` named the five logs and graded nothing about whether the
    gap ever closed.
    All five are re-run here on the pinned KLa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
2026-09-30 layout/evidence: commit on-pin --offgrid DRC bundles for nine cells (issue #675)
    #671 corrected nine off-grid DRC claims (vco_ring, vco_vtoi_core,
    vco_bias_resistors, vco_out_buffer, vco_block, cp_array, cp_output_stage,
    div23_cell, divider_chain) to disclose the off-grid re-run as uncommitted,
    because the only KLayout on hand at the time was 0.30.10, not the
    KLayout 0.28.16 layout/harness/env.py pins. This host has the pinned
    build, so this commit produces and commits the missing
    drc-clean-offgrid/ bundles (drc.stdout.log + *_main.lyrdb, each recording
    Offgrid enabled: true and KLayout 0.28.16), in the shape
    layout/evidence/pfd-cp-layout/drc-clean-offgrid/ already established, and
    restates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
2026-10-01 chore(tooling): update repo-skills to v0.19.5
    Fleet-wide Repo Skills rollout (2026-10-01). compute-drift's axis 6
    reported repo-skills at 11 different versions across the fleet's
    checkouts; this brings gf180-pll from v0.10.0 to v0.19.5 (rjwalters/repo
    @ ff282cd), staging only the installer's own surface.
    Loom-Trace-Id: 038dce5d677bceeeca3c111787ac5b68
    Loom-Build: unknown unknown unknown
    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
2026-10-02 spec: re-stamp decision records ratified through #1; state the Status convention (#446)
    Per the operator ruling on #446 (2026-10-02), ratifying spec/pll.md (#1,
    2026-09-08) also ratified the decision records on its Consumes line as of
    that date, other than records revising the carved-out rows (Lock time,
    Lock detector). Re-stamp DR-001, DR-002, DR-003, DR-005, DR-006 and remove
    the stale 'pending #1' prose. DR-002 Decision 5 (jitter) stays proposed.
    Records created or amended after 2026-09-08 (DR-010 onward) and records
    not on the Consumes line are left unchanged; spec/README.md documents the
    convention and the reasons. No target, criterion, or sim/ evidence changes.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
2026-10-02 spec: state the 166 MHz static-code figure as a ceiling, not a range (#534)
    Addresses review on #685. The summary row in spec/pll.md, the proposal's
    Output band row and DR-036 Decision 1 stated "10 – 166 MHz under one static
    band code" without qualification, but the same derivation (DR-036 Decision 4)
    shows gaps below 166 MHz. They now say "static-code ceiling 166 MHz", note
    that the range below it is not continuous, and point to the gap list. The
    proposal's verdict now reads "MET as a per-operating-point envelope".
    Also: "resolved" becomes "addressed ... pending ratification" while DR-036
    is proposed. The CLK pin row drops "continuous". DR-036's Status line keeps
    only the 2am#1056 refere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
2026-10-02 spec: renumber the Output band derating record DR-036 -> DR-038 (#534)
    main now carries its own DR-036 (the band-selection-rule record from
    #542), so this PR's record collided with it and test_spec_row_coverage
    failed. The record moves to DR-038, not DR-037: open PR #686 also claims
    DR-036 and its next free number is DR-037.
    Only the references this PR added are renamed. main's DR-036 citations
    in spec/pll.md (the band-selection rule paragraph) are untouched. The
    record's content is otherwise unchanged and it stays proposed; no
    measured figure moves.
    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
2026-10-03 docs: state #525 as closed in challenge-5 supply-sensitivity row
    #525 closed with PR #686 (DR-037 proposed, pending two-key ratification);
    the row still called it open, failing check-issue-reference-state.sh.
    Facts only; no spec value, criterion, or record changed.
    Loom-Story: 2AMLogic/gf180-pll#687
    Loom-Trace-Id: f338418bcc589bd57f35bff3b4ba508d
    Loom-Build: 0.19.633 346aff41fad5597fb95fba4884169fca70f8d121 clean
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2026-10-03 layout: share Metal2 track packing and nwell_over via _canvas (#690)
    Move the left-edge Metal2 track packer, net x-extent and same-track
    separation proof (previously duplicated in divider_chain/devgen.py and
    pfd_cp/cp_array.py) and the three nwell_over() copies (divider_chain/devgen,
    lock_detector/primitives, pfd_cp/rowgen) into _canvas.py. Each module binds
    its own METAL2_*/VIA*/NWELL_MARGIN_UM constants with functools.partial, so
    call sites and public names are unchanged. rowgen.pack_tracks, tap_strip and
    h_wire are left alone.
    Loom-Story: 2AMLogic/gf180-pll#690
    Loom-Trace-Id: 1a68ddfed6729d105d9e08ff34eb5a91
    Loom-Build: 0.19.649 8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
    [devgen.py]
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2026-10-07 refactor(sim): resolve PDK models via find_pdk() in period-jitter runners
    Replace the four copies of pdk_models(), which spawned
    run_corners.py --print-env and scraped the export line, with
    find_pdk().ngspice_dir from sim/harness/pdk.py. The resolved path is
    unchanged; a missing PDK now raises PdkNotFound with its own message.
    Closes #692
    Loom-Story: 2AMLogic/gf180-pll#692
    Loom-Trace-Id: e9134cd8d36cd1faa3765de5bb3cbee5
    Loom-Build: 0.19.827 6b5119f48f153d6e74b5815da984b8998af166eb clean
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2026-10-07 harness: fail a point when the execution layer reports a terminal failure
    A batch job that ended failed or interrupted could still leave a log with
    every required measurement, and the point then passed. DeckRun now carries
    an explicit execution_failed flag, set only for those explicit backend
    states (never inferred from the exit code or detail text). The runner
    fails the phase, keeps the parsed measurements and raw artefacts as
    evidence, leads the message with the backend detail, and the existing
    phase fail-stop skips later phases. Plain non-zero exits with all required
    measurements, timeouts and absent optional measures keep their behavior.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
2026-10-07 Add CONTRIBUTING and SECURITY, fix issue templates and package metadata (#704)
    Loom-Story: 2AMLogic/gf180-pll#704
    Loom-Trace-Id: bdd1dc09bf5e278499947394d8e6aa77
    Loom-Build: 0.19.868 ee904e1c151bc9cf15b0eb55dfe9d57ad6136cff clean
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2026-10-07 Consolidate duplicated devgen helpers into _canvas.py (#707)
    Move Device (with the optional body_net), pad_overlap_x, connect_pads,
    well_tap, draw_column and the build_stack_cell core into the shared
    layout/pll_top/_canvas.py. pfd_cp/devgen.py and divider_chain/devgen.py keep
    their per-family constants, Canvas subclass (pin layer) and the divider's
    bypass-lane router, and re-export the previous names (_pad_overlap_x,
    _connect_pads, _well_tap/well_tap, Device, build_stack_cell, draw_column) as
    bindings, so callers and tests are unchanged. Generated GDS is unchanged.
    Loom-Story: 2AMLogic/gf180-pll#707
    Loom-Trace-Id: 0936438acd614e0bc6f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
    [devgen.py]
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2026-10-08 sim: fail batch points when output collection fails, retaining partial outputs
    The batch backend discarded the result of the recursive output download, so
    a done job whose download exited nonzero could be recorded as a success when
    the files that arrived held every measurement, and the download's exit code
    and stderr were lost either way. The result is now retained and a nonzero
    exit sets DeckRun.execution_failed with the job id, exit code and stderr in
    detail. Files that arrived are still read and published. Timeout/failed/
    interrupted classification is unchanged and now also carries the collection
    diagnostics. Nothing is raised, so the rest of a grid still runs.
    Closes #714
    Co-Authored-B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
2026-10-08 sim: retain simulator diagnostics in timeout evidence logs
    The local backend now keeps the partial stdout/stderr carried by
    TimeoutExpired (str, bytes, or absent; incomplete UTF-8 is decoded with
    replacement rather than raising). The runner writes the TIMEOUT marker
    followed by whatever output the backend returned, for local and batch
    backends alike. Timeout verdict, fail-stop of later phases, raw-file
    capture and per-point isolation are unchanged; partial output is never
    parsed into measurements.
    Loom-Story: 2AMLogic/gf180-pll#715
    Loom-Trace-Id: 8bd6c97e76e585d0a861c9615c594f8d
    Loom-Build: 0.19.868 ee904e1c151bc9cf15b0eb55dfe9d57ad6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
2026-10-08 ci: run sim/lib simenv bash regression tests in the checks job
    The three test_simenv_*.sh scripts guarding simenv.sh's ngspice thread-count,
    pin and deck-retry logic were never run by CI. Add a checks-job step that
    loops over test_simenv_*.sh (test_helpers.sh is excluded by the pattern, a
    fourth test is picked up automatically) and fails if any script fails.
    Headless: no ngspice or PDK required. Test assertions are unchanged.
    Loom-Story: 2AMLogic/gf180-pll#718
    Loom-Trace-Id: 2dfbe9d4d4d22d3f240892d8b9b7a2ca
    Loom-Build: 0.19.857 7a0b529e6f57a79713f6924bf58d8392ff404259 clean
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2026-10-08 sim/period-jitter: route runner deck execution and provenance through the harness (#712 step 1)
    The four period-jitter run.py runners (in-band-bound, random-bound,
    sid-trajectory, isf-bringup) no longer launch ngspice themselves. Deck
    execution goes through harness.execution.LocalBackend via the new
    harness.legacy_provenance seam, which also produces the runner-shaped
    environment records so committed result JSON keeps its shape.
    Adds hermetic tests for backend dispatch and record compatibility.
    Loom-Story: 2AMLogic/gf180-pll#712
    Loom-Trace-Id: 87c3e713f091ec7856c8ba2c3759ba17
    Loom-Build: 0.19.868 ee904e1c151bc9cf15b0eb55dfe9d57ad613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
2026-10-08 fix(sim/harness): contain retained-waveform copy errors within the affected point
    capture_raw_files() let OSError from mkdir/copyfile escape, aborting a
    serial grid and dropping the affected point. Capture failures are now
    reported per file, the partial destination is removed so a reduction cannot
    read it as retained evidence, and the point degrades to ERROR (also on the
    timeout path, with both causes disclosed) while keeping its log and scalar
    measurements. Later phases stop and sibling points continue.
    Closes #724
    Loom-Story: 2AMLogic/gf180-pll#724
    Loom-Trace-Id: 4f948c5698f8f1fc6be75dc7e893f3b5
    Loom-Build: 0.19.868 ee904e1c151bc9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
2026-10-08 sim/harness: reject overflowing and malformed scalar measurement tokens (#728)
    Both the m_<name> and raw <name> = forms now accept only complete, finite
    numeric tokens. Rejected values are excluded from the parsed dict so required
    ones fail via missing-measurement handling, and the point message names the
    invalid token. Trailing trig/targ metadata on raw lines is still accepted.
    Loom-Story: 2AMLogic/gf180-pll#728
    Loom-Trace-Id: 2326de042b4c56118ae0701c170adc14
    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
2026-10-08 sim/harness: bound batch transport commands and contain stage timeouts
    The batch backend's polling deadline is checked between commands, so it
    could not interrupt one that never returned. A stalled upload, launch
    script, status read or output download held its grid worker forever, and
    because run_grid waits for every worker before results are returned, it
    also withheld every sibling point's result from the record.
    Every transport command now runs under an explicit budget:
    - upload and each status read: transport_timeout_s (default 300 s)
    - each launch-script invocation: launch_timeout_s (default 600 s)
    - the output download: collect_timeout_s (default 1800 s)
    configurable as BatchBackend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
2026-10-08 sim/harness: reject misspelled and invalid manifest acceptance checks (#735)
    Validate the checks object at load time against the full simulated, raw,
    derived and phased measurement set: unknown measurements and limit keys,
    malformed entries, empty entries, non-finite or non-numeric thresholds,
    invalid coverage limits and contradictory bounds now fail before any
    backend submission or evidence reservation. All committed manifests load.
    Loom-Story: 2AMLogic/gf180-pll#735
    Loom-Trace-Id: 8778ec6497076db5d9251d556331bca3
    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
2026-10-09 layout: loop-filter footprint includes tap-ring implant margins (#748)
    footprint_um() reported (0,0)-(219.6,184.0) but the pplus implant around
    the tap rings extends 0.3 um past the ring, so the exported GDS spans
    (-0.3,-0.3)-(219.6,184.3). Include the margin, add a regression that
    compares the declared footprint to the exported and committed GDS bounds,
    and correct the measured footprint/overhead in PROOF.md (219.900 x 184.600
    um = 40,593.54 um^2, 9.9 % over the floorplan estimate).
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2026-10-09 layout: assemble pll_top from the five real block layouts, with DRC and connectivity evidence
    Add layout/pll_top/top_level/, which regenerates the five block layouts
    (lock_detector, pfd_cp, loop_filter, vco_block, divider_chain) from their
    own generators, places them per PLL-FLOORPLAN.md, and routes the top-level
    nets of design/netlist/pll_top.spice on Metal4/Metal5. Each port is reached
    by a via stack placed on the port's own net after a clearance search; VDD
    and VSS are star-routed from one pad each, with no shared branch segment.
    netcheck.py grades the written GDS against the netlist: block presence and
    device-layer geometry, label-level and netlist-level connectivity (shorts,
    opens, ris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
2026-10-09 docs: describe top-level assembly as delivered by #297, not tracked at it
    #297 closed on 2026-10-09; the proposal's closing sentence still handed
    top-level assembly to it in the present tense, which the issue-reference
    ownership check rejects. Name it historically and point at the record.
    Loom-Story: 2AMLogic/gf180-pll#762
    Loom-Trace-Id: a41891036a27b861b1f8b2cfbb6b68d0
    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
2026-10-09 layout(vco): draw the 22 pF supply decap as real cap_nmos_03v3 devices (issue #759)
    vco_block carried vco.sch's XCDEC1/XCDEC2 as two layer-(0, 0) rectangles that
    overlapped other sub-blocks, and its LVS reference omitted them, so the
    assembled pll_top had no physical VCO decap.
    * primitives.mos_cap_nmos(): the non-_b cap_nmos_03v3 per the PDK's own
    draw_cap_mos.py (comp, poly2, mos_cap_mk, lvpwell, nplus; no n-well).
    * block.py: a decap column right of the CLK column, level with the VDD_VCO pin
    and inside the GND_VCO ring; gate on VDD_VCO, n+ on GND_VCO; both devices in
    reference_netlist() (one M=2 card); connectivity probes cover both gates and
    all four n+ columns. The block grows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
2026-10-10 layout(pll_top): first klt erc supply-island run on the assembled top level, with negative control
    VDD, VSS, GND_VCO and VDD_DIV each resolve to one island and no supply pair
    shorts; VDD_VCO carries the same two-island finding as vco_block. Item 11 is
    not met; the run, its limits (no well-tie grading, antenna skipped) and a
    cut-routing detection control are recorded in PROOF-erc.md. Part of #127.
    Loom-Story: 2AMLogic/gf180-pll#127
    Loom-Trace-Id: 62176416525986581668f156c4286d85
    Loom-Build: 0.19.1026 09a449709f5a1c6ae81b471ef56d466247e50808 clean
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2026-10-11 docs: regenerate WORK_PLAN against current issue state
    Replaces the stale snapshot this PR carried (#127 listed under Ready)
    with a regeneration from the live label state:
    - #127 is no longer `loom:issue` (now `loom:blocked` + `loom:curated`),
    so it belongs only in the Proposed list, not Ready.
    - #774 now carries `loom:building`, so In Progress lists it and the
    Backlog Balance count moves 0 -> 1.
    - Ready is _None._: the two open `loom:issue` issues (#499, #680) are
    excluded because they also carry `loom:blocked` / `loom:operator-only`.
    Rebased onto current main, which already dropped #127 from Ready.
2026-10-11 docs: re-regenerate WORK_PLAN against current issue state
    #774 is closed (Champion's return): remove it from In Progress, count 0.
    #127 and #237 carry loom:issue: list them under Ready, count 2.
    Restores the generated region to what render_plan_body() produces live,
    matching the PR description.
2026-10-11 docs: regenerate WORK_PLAN Ready/In Progress from current label state
    The Ready section listed #127 and #237, but neither carries loom:issue
    live (both are loom:blocked), so Ready is correctly _None._ again.
    #680 and #499 do carry loom:issue but are gated (loom:operator-only and
    loom:blocked respectively), so they are excluded from Ready by the
    documented render filters as well.
    #776 (loom:building) enters In Progress and the curated list; counts
    updated to match (Ready 0, In Progress 1, Curated 18).
    Regenerated with the loom-guide render_plan_body rules against live
    forge state; the diff is confined to the guide:plan-body region.
2026-10-11 refactor: give h_wire, snap_um, via1_stack and tap_strip one shared home in _canvas.py
    The last four small drawing/rounding helpers still re-authored per
    layout/pll_top/* submodule move into the shared canvas module, completing
    the consolidation wave #332/#353/#475/#690/#707 started (issue #776):
    - h_wire: vco and lock_detector carried byte-identical copies, pfd_cp/rowgen
    a no-return one; like v_wire, the Metal1 width is an explicit argument each
    module binds with functools.partial.
    - snap_um: vco/devices.py and loop_filter/devices.py carried byte-identical
    copies; the grid step is now an explicit grid_um argument and each
    devices.py binds its own LAYOUT_GRID_UM.
    - via1_stack: vco a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
2026-10-12 docs: regenerate WORK_PLAN Ready section from current label state
    PR #779's snapshot rendered Ready as empty and its count as 0, but the
    live loom:issue query (-building -operator-only -blocked) returns #127
    and #237. Regenerated the plan body between the guide markers with the
    Guide role's render_plan_body(); In Progress stays empty (no loom:building
    issues), so only the Ready section and its Backlog Balance count change.
    Addresses the changes-requested verdict on PR #779.
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2026-10-15 docs: state closed measurement issues as unowned, not open owners
    #399, #437 and #540 were closed as not planned, but the challenge-5
    proposal and sim/STATUS.md still named them as open owners. Reword the
    ownership claims to say the measurements are currently unowned and to be
    refiled; no measured value or verdict changes.
    Closes #786
    Loom-Story: 2AMLogic/gf180-pll#786
    Loom-Trace-Id: 7d80a256594f0a38a0acc167b14147e9
    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
2026-10-15 docs: correct #525 state and #511 wording in the unowned-findings sentence
    #525 is closed (completed; DR-037 awaits two-key ratification), not open.
    Only #405 is open. #511 closed with DR-025, which states it does not close
    the design resolution, so say that instead of "discharged".
    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
2026-10-15 feat(sim): pin open_pdks in sim/pdk.json and refuse PDK trees at another revision
    find_pdk, simenv.sh and design/netlist.sh now compare the resolved tree's
    SOURCES revision with the single pin in sim/pdk.json and fail visibly on a
    mismatch instead of using a stale tree. ~/.ciel is searched before ~/.volare,
    install hints and CI use ciel, and the provenance line no longer says volare.
    Part of #788
    Loom-Issue: 2AMLogic/gf180-pll#789
    Loom-Story: 2AMLogic/gf180-pll#789
    Loom-Trace-Id: 85d0b8fccb20a6cab04925a7f93b84f4
    Loom-Build: 0.19.1166 8a9aad12e32504cea9a7c7d2ed774749c487f875 clean
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2026-10-15 docs(layout): bound the pll_top area recovery levers; no combination reaches 0.30 mm2
    Add a sweep that re-runs the real top-level assembly with the divider
    chain refold and the block/keep-out spacings changed in isolation and
    together, with netcheck and foundry DRC per case. Best result is
    0.3513 mm2; the divider is too thin for a fold to pay. Records the
    outcome in the floorplan record. Adds an empty-by-default per-gap
    override hook to the assembler; the committed build is unchanged.
    Loom-Story: 2AMLogic/gf180-pll#792
    Loom-Trace-Id: d2db9e9e644a55c3be3cff467940a1f9
    Loom-Build: 0.19.1166 8a9aad12e32504cea9a7c7d2ed774749c487f875 clean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
2026-10-17 feat(loop-filter): prepare C2 as the option-B MIM (cap_mim_2f0_m4m5_noshield)
    Adds DR-042 (proposed) moving only the C2 device of DR-006 to the MIM
    option gf180mcuD's decks select, keeping the 31.4 x 31.4 um drawn size and
    stating the comparison tolerances before any measurement. The schematic
    and both committed netlists (loop_filter, pll_top) now name the option-B
    device; the layout generator draws it on Metal4/Metal5 (Via4 sea, Via3
    landing for VCTRL) and its connectivity checker extracts that stack
    plate-aware. Option A stays selectable (--mim-option A) solely so the
    committed #748 / pll_top evidence remains reproducible.
    Preparation only: no model/PVT, loop-dynamics or variant-D DRC/LVS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
2026-10-17 refactor(sim): derive period-jitter MOS bundles from harness, share full_grid
    Drop the dead SUPPLY_ALIAS, take MOS_BUNDLES from corners.CORNER_SETS["mos"]
    instead of a hand-copied tuple, and have the band-top generator reuse
    full_grid from the period-jitter generator via load_module. --emit and
    --check output of both generators is byte-identical before and after.
2026-10-21 ci: pin setup-python to 3.13 so klayout installs from a wheel
    Floating "3.x" reached CPython 3.15, which has no klayout wheel, so pip
    fell back to a failing sdist build.
    Part of #810
2026-10-22 refactor(sim): share the period-jitter run-deck wrapper in legacy_provenance
    in-band-bound and random-bound carried byte-identical run-deck wrappers and
    FATAL tuples; both now call legacy_provenance.run_deck_checked. isf-bringup and
    sid-trajectory keep their own wrappers (different log naming, message text,
    check order and append mode) but share one FATAL_LOG_PATTERNS constant.
    Refusal sets are unchanged and pinned by tests. Also drops a duplicated import
    in random-bound.
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2026-10-23 feat(sim): store new run output in the artifact store, commit manifests only
    Add sim/lib/artifact-put.sh (stage + klt artifact put, fails closed with no
    manifest on a missing broker, klt without artifact put, or unreachable broker)
    and a headless manifest check wired into CI: schema, artifact: URIs only, and
    no committed bytes equal to a stored object. Amend the sim/ retention policy
    as manifest-forward only; existing evidence is untouched.
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2026-10-29 feat: add opt-in --artifact-store step to the sim harness
    Stage a run's raw output (per-corner logs, raw_measures.csv, retained raw
    files) in sim/.artifact-stage/ and hand it to sim/lib/artifact-put.sh once,
    before the summary record is published. A nonzero writer exit fails the run
    and leaves the id reserved with no record; on success the stored files are
    removed from corners/<record-id>/ so only the manifest is committable.
    Part of #832
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2026-10-31 docs(layout): attribute the 57 curated-deck LVS errors on vco_block to request options and a pre-decap reference, none to layout
    Single-run probes show unmerged parallel fingers and the default poly_res
    account for 54 errors, the missing decap in the reference for 3; with
    poly_res=3k, combine_devices and a decap reference the compare matches.
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2026-11-06 feat(sim): staged period-jitter grid driver with backend-selectable run.py
    Replace the xargs -P fan-out in both period-jitter grid.sh scripts with a
    shared stdlib driver (sim/period-jitter/grid.py) that reads each campaign's
    stage plan from grid.json, runs units in dependency order (once-only, per
    point chain, reference validate, summary) and keeps the failed-point and
    resume behaviour. run.py gains --backend {local,batch} / --batch-apply;
    batch without apply is a plan only. grid.sh becomes a thin wrapper.
2026-11-06 refactor(layout): generate the layout status table; drop prose count and pin-restatement rules
    Part of #812 (stage 2).
    layout/STATUS.md now carries per-sub-block drawn/DRC-clean/LVS-matched,
    footprints, the assembled-pll_top sentinel and the KLayout pin as a table
    generated from layout/evidence/ by layout/lib/gen_layout_status_table.py;
    CI regenerates it and fails on a diff.
    Removed from check-layout-status-claims.sh with their tests: the count rule
    and the pin-restatement rule. The documents stop restating those facts in
    prose and point at the table / env.py instead.
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2026-11-06 refactor(sim): share band-top check_config body via cloop_check_band_top_config
    The reference-spur-band-top and period-jitter-band-top check_config.sh
    scripts differed only in prose and deck filename. Move the logic into
    sim/lib/pll_top_dut.sh; each campaign script is now a header plus one call.
    PASS/FAIL output and exit codes are byte-identical.
2026-11-06 layout: run the pinned PDK's tech/ DRC deck directly and find decks by file layout
    The pinned PDK keeps its decks under libs.tech/klayout/tech/{drc,lvs} and has
    no run_drc.py. Resolve deck dirs from the files present (tech/ preferred,
    legacy fallback), run gf180mcu.drc via klayout -b -r with the deck's own -rd
    switches (density rules excluded to match the legacy main table), and accept
    the deck's DRC RESULT markers. Add fixture tests for both layouts.
2026-11-06 feat(sim): harness manifest, derive step and passive-box corners for loop-dynamics
    Adds tb.json, a combined harness-form fragment and derive.py for the
    loop-dynamics campaign (27 passive bundles x 3 temperatures filter runs plus
    18 whole-loop cross-check points), the 27-bundle passive corner set the
    harness needs for a passive-only DUT, and a manifest test. run.sh keeps its
    role as the baseline's generator and gains the superseded-for-new-runs banner.
    Part of #741
    Loom-Issue: 2AMLogic/gf180-pll#741
2026-11-06 fix(sim): place local-grid guards after their counts; cover every fan-out
    - cp-compliance, pfd-deadzone: the guard read NDC/NSW/NPOINTS before they
    were assigned, aborting the runner under `set -u` on every host. Move
    each call to just after its count is computed.
    - supply-sensitivity: guard the summed first-pass count and each later
    fan-out (escalation re-runs, end-plateau re-runs) with its own count.
    - divider-ratio: guard the cell and chain job lists as well as dff.
    - test: add an ordering check (count variables assigned before the guard;
    guard precedes the first xargs fan-out).
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2026-11-06 refactor: share period-jitter PDK-models and backend construction in legacy_provenance
    pdk_models() and the backend-building body of select_backend() were
    copied across the four period-jitter run.py drivers. They now live in
    harness.legacy_provenance (pdk_models, make_backend); each driver keeps
    its own module-level BACKEND test seam and a thin select_backend.
2026-11-11 refactor(sim): share the 45-point period-jitter grid loader between runners
    Hoist the duplicated load_points() body into
    legacy_provenance.load_period_jitter_points(); both runners keep a thin
    load_points() delegate so grid.py, summarize.py and tests are unchanged.
    Per-runner point keys (mimcap_section / band) are preserved exactly.
2026-11-11 docs(chipalooza): cite the output-range deck, not run.sh, as the bias-current setting site
    output-range's harness deck now sets .param iunit=8u itself; run.sh is
    superseded for new runs. tb.json drops its redundant iunit param so the
    deck is the single setting site the drive-claim check resolves.
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2026-11-13 layout: the census rule reported "klayout.db was not needed" in the one run where it was needed
    `check-layout-status-claims.sh`'s layer-census rule imports `klayout.db`
    lazily -- only once a live `layer_indexes()` census claim is found -- and
    FAILS rather than skips when a claim exists and the module will not import.
    The FAIL is correct and goes to stderr. The rule's one-line summary, which
    goes to stdout, then printed the *no-claim* branch in exactly that run:
    no document states a layer_indexes() census (3 struck occurrence(s)
    skipped as history); klayout.db was not needed
    On the committed tree both clauses are false: there are 5 live census claims
    across 4 PROOF documents, and the de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
2026-11-13 test: share the band-top grid invariants between the two 200 MHz campaigns
    `sim/tests/test_period_jitter_band_top_grid.py` and
    `sim/tests/test_reference_spur_band_top_grid.py` each carried their own copy
    of the checks that follow from the *configuration* the two campaigns share --
    the mandated 45-point PVT matrix at 200 MHz, the per-point band the ratified
    band-selection rule selects, the point-id format, the Kvco bound, the N = 8
    divider encoding. 272 of the period-jitter file's 321 lines appeared unchanged
    in the reference-spur file, so a change to one of those invariants had to be
    made twice by hand, and a missed copy left one campaign checked against the
    old rule with nothing failing.
    M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
2026-11-14 sim(devchar-delay): re-run the delay-cell and starved-ring grid on open_pdks f6eeac7
    The cited record 20260801-084448-01b0db8 was taken against open_pdks c6d73a3,
    the revision #789 re-pinned away from. Re-runs the same 45-point PVT grid
    (5 MOS bundles x -40/27/125 C x 2.97/3.30/3.63 V) through the same manifest on
    the batch fleet and mints 20261114-010350-72be45d superseding it.
    Also adds sim/lib/record_delta.py, which grades a superseding record against
    its predecessor: per-measurement old/new range, worst absolute and relative
    movement with the corner it happened at, per-corner verdict flips, and limit
    drift. It reads the Markdown records rather than raw per-corner output
    because, under m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
2026-11-14 docs+sim: record the f6eeac7 re-pin deltas, and attribute them to the simulator
    Adds sim/REPIN-DELTAS-f6eeac7-devchar.md: the old-vs-new delta table for each
    of the four benches #825 re-ran, generated from the committed records by
    sim/lib/record_delta.py with the regeneration command above each table. The
    supersession convention records that a re-run happened; it does not say how
    much the numbers moved, which on a re-qualification is the finding.
    Verdict: no result moved past a stated tolerance and no PASS/FAIL verdict
    flipped, on any of the 792 graded per-corner rows across the four benches, so
    nothing is owed a new issue or decision record under #825's third criterion.
    #825 and the 2026-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
2026-11-14 test(sim): pin the record comparator's behaviour, and the delta document's own claim
    11 unit tests for sim/lib/record_delta.py. Three of them are the cases where
    a wrong answer would still look plausible in a rendered table:
    - a measurement whose OLD value is zero has no meaningful relative change, so
    it must report the absolute step and not a misleading 0 %. That is the
    moscap leak_* family exactly (0 -> about -1 nA, #932), where a naive
    relative figure reads as no change at all.
    - a non-numeric cell (`—` for an absent limit, a verdict string) must be
    dropped rather than coerced to 0.0, which would invent a reading.
    - a changed `limits` entry is a finding even when every value si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
2026-11-14 layout(lock-detector): record a curated-deck klt lvs envelope, status match
    Second cell after vco_block to get a `klt lvs` envelope on the curated
    extraction deck (`deck: gf180mcu`, `poly_res: 3k`), comparing the committed
    `lock_detector.gds` against the same reference netlist the foundry-deck run
    in `lvs-clean/` matched: `status: match`, `error_count: 0`, 48/48 nets and
    117/117 devices. Both `klt lvs --check` modes (cheap re-hash and `--rerun`)
    exit 0 and are quoted in the record.
    Also records the first attempt, which the issue and its curation both
    expected to work: the default `reference.form: "plain-element"`. It returns
    `status: mismatch` with 334 errors and *nothing* matched, on netli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
