2AMLogic/gf180-pll/(notices)

Notices in the files:
docs/chipalooza/challenge-5-proposal.md:
8. Licensing and EDA flow:
- **License**: this entire repository — spec, decision records, schematics,
testbenches, and every evidence record cited above — is licensed
[Apache-2.0](../../LICENSE), satisfying the Challenge's requirement for a
standard open license with all modifiable sources public.
- **Flow**: fully open-source. Schematic capture and netlisting via
[xschem](https://xschem.sourceforge.io/); simulation via
[ngspice](https://ngspice.sourceforge.io/); layout, DRC, and LVS via
[KLayout](https://www.klayout.de/) driven by
[klayout-tools](https://github.com/2AMLogic/klayout-tools) (`klt`) — a f
so a row could cite the current record, name the right grid, carry the right
